sunny1043/offgrid-pv-course-design/差异化城市设计/README.md

# 差异化城市设计（拉萨 / 兰州 / 哈尔滨）

> 本文件夹为户用离网光伏发电系统课程设计**新增的差异化城市方案**，与仓库 docs/ 下已有的深圳（基线）方案对应。
> 全部数据同一口径：NASA POWER 2019-2023 五年平均 + Liu-Jordan 倾角模型 + 指导书/任务书公式。
> 负荷设计点：冬季采暖 E_AC = 7.82 kWh/d（对应任务书区间 7.5~8.0，学号末位 4/5；可按分配区间微调）。

## 四城市关键对比

| 环节 | 深圳（基线） | 拉萨 | 兰州 | 哈尔滨 |
|---|---|---|---|---|
| 纬度 / 最不利月 | 22.54° / 10月 | 29.66° / 12月 | 36.05° / 12月 | 45.80° / 12月 |
| 最不利月水平辐照 | 4.29 | 4.23 | 2.82 | 1.68 |
| 年水平面 kWh/m2 | 约1585 | 约1988 | 约1659 | 约1400 |
| 极端最低温 ℃ | 0.2 | -16.5 | -23.1 | -38.1 |
| 倾角 / 排距(倍L) | 20° / 1.62 | 30° / 2.13 | 30° / 2.51 | 40° / 4.57 |
| 蓄电池 | 19.34kWh/4台 | 21.64kWh/5台 | 21.64kWh/5台 | 21.64kWh/5台 |
| 阵列 | 2.40 kWp | 3.00 kWp | 3.60 kWp | 6.00 kWp（双机并联） |
| 逆变器 | SPF 5000 ES | SPF 5000 ES | SPF 5000 ES | 2x SPF 5000 ES |
| 差异化主线 | 夏季空调 | 高海拔/资源顶级 | 8 度抗震 | 严寒/冬季辐照塌陷 |

## 文件清单

- 负荷调查 / 太阳能资源 / 倾角核算 / 系统组成与能量损失 / 蓄电池设计 / 光伏阵列设计 / 控制器逆变器设计
- 计算-蓄电池-{城市}.xlsx、计算-光伏阵列-{城市}.xlsx（公式可检查，用 Excel/LibreOffice 打开自动重算）
- 拉萨设计总览.md、多城市对比总览.md

### D1–D5 阶段成果（检查点①–④交付）

- 拉萨：`拉萨-D1至D5成果汇总.md`
- 兰州：`兰州-D1-D5-阶段成果-源稿.md`（可编辑源稿）+ `兰州-D1-D5-阶段成果.docx` + `.pdf`（正式报告版式）；配套数据表 Excel：`兰州-负荷表.xlsx`、`兰州-24h运行表.xlsx`、`兰州-资源数据.xlsx`

## 说明

- 各城市文档均标注数据来源与查询日期（2026-09-01），口径与仓库 docs/ 深圳方案一致。
- 本文件夹原为独立新增内容；2026-09-04 起兰州/拉萨 D1–D5 成果与 Excel 已纳入 docs/PROJECT_LOG.md 与 docs/PROGRESS.md 协作管理。
