sunny1043/offgrid-pv-course-design/docs/drawings/README.md

# 工程图纸（W9）

> 依据：设计指导书 §10、课程设计任务书 §五；参数来源 W4–W8（蓄电池/光伏阵列/控制器逆变器/线缆保护/支架布置）。
> 说明：本目录为 **A3 图幅（420×297，横向）** 三张图 × 4 城市（深圳 + 差异化 拉萨/兰州/哈尔滨），源文件为 **SVG（可编辑矢量，可用 Inkscape/浏览器打开编辑）**，同时提供 **PDF（A3，可直接打印/提交）** 与 PNG 预览。
> 日期 2026-09-03。**姓名/学号栏留空，提交前请补填。**

## 一、深圳（模板，完整版）

| 图号 | 图名 | 内容要点 | 源文件 | PDF | PNG |
|---|---|---|---|-----|-----|
| **T1-01** | 系统电气主接线图 | 光伏组件 4 串×1 并（隆基 LR7-72HGD-600M）、组串熔断器 F1 25A gPV、直流隔离 QS1、直流 SPD、**Growatt SPF 5000 ES** 一体机、蓄电池 4×BNP-5120BM（B1-B4+BMS+支路熔断器 F2-F5 100A）、总保护 QF1 160A DC MCB、交流 QF2 32A C 型 + RCD 30mA + SPD2、交流配电箱 DB 与 4 个负荷回路（照明 10A/厨房 20A/空调 20A/插座 16A）；各回路标注电压、电流、线缆型号截面；PE 接地/等电位；图例 | [T1-01 SVG](T1-01-系统电气主接线图.svg) | [PDF](T1-01-系统电气主接线图.pdf) | [PNG](T1-01-系统电气主接线图.png) |
| **T1-02** | 光伏阵列及支架布置图 | 屋面平面（12×5m 南向区）：单排 4 块横排（东西 9.53m、南北投影 1.07m）、指北针、边缘距离（檐口≥1.0/侧边≥0.5/北侧≥0.6m）、南侧维护通道≥1.0m、直流线缆路径（穿屋面→设备间）；剖面 A-A：倾角 20°、前沿 0.5m/后沿 0.89m、立柱锚固；排间节距 D=1.84m（扩排）；支架校核结论（σ=24.3MPa、f=0.88mm） | [T1-02 SVG](T1-02-光伏阵列及支架布置图.svg) | [PDF](T1-02-光伏阵列及支架布置图.pdf) | [PNG](T1-02-光伏阵列及支架布置图.png) |
| **T1-03** | 设备间平面及安装接线图 | 房间 3.0×2.5m：蓄电池柜（B1-B4）、逆变器 INV1（壁挂 1.4-1.6m）、配电箱 DB、直流/交流桥架分区、电池→逆变器 ≤2m 短回路、检修通道≥0.8m、接地干线、灭火器与警示；安装接线说明（设备编号与 T1-01 一致） | [T1-03 SVG](T1-03-设备间平面及安装接线图.svg) | [PDF](T1-03-设备间平面及安装接线图.pdf) | [PNG](T1-03-设备间平面及安装接线图.png) |

## 二、差异化城市（拉萨 / 兰州 / 哈尔滨）

三城均按深圳模板同构：T1-01 主接线（差异化：组件串并联、Voc 低温校核、直流保护回路成对、采暖负荷回路）、T1-02 阵列布置（差异化：倾角/排距/东西向单排布置）、T1-03 设备间（差异化：房间尺寸/单双逆变器/保温-抗震-防冻措施）。每城三张图均已生成 **SVG + PDF + PNG**。

| 城市 | T1-01 主接线 | T1-02 阵列布置 | T1-03 设备间 |
|---|---|---|---|
| **拉萨**（30°，5 串×1 并） | [SVG](T1-01-系统电气主接线图-拉萨.svg) / [PDF](T1-01-系统电气主接线图-拉萨.pdf) / [PNG](T1-01-系统电气主接线图-拉萨.png) | [SVG](T1-02-光伏阵列及支架布置图-拉萨.svg) / [PDF](T1-02-光伏阵列及支架布置图-拉萨.pdf) / [PNG](T1-02-光伏阵列及支架布置图-拉萨.png) | [SVG](T1-03-设备间平面及安装接线图-拉萨.svg) / [PDF](T1-03-设备间平面及安装接线图-拉萨.pdf) / [PNG](T1-03-设备间平面及安装接线图-拉萨.png) |
| **兰州**（30°，6 串×1 并，8 度抗震） | [SVG](T1-01-系统电气主接线图-兰州.svg) / [PDF](T1-01-系统电气主接线图-兰州.pdf) / [PNG](T1-01-系统电气主接线图-兰州.png) | [SVG](T1-02-光伏阵列及支架布置图-兰州.svg) / [PDF](T1-02-光伏阵列及支架布置图-兰州.pdf) / [PNG](T1-02-光伏阵列及支架布置图-兰州.png) | [SVG](T1-03-设备间平面及安装接线图-兰州.svg) / [PDF](T1-03-设备间平面及安装接线图-兰州.pdf) / [PNG](T1-03-设备间平面及安装接线图-兰州.png) |
| **哈尔滨**（40°，5 串×2 并/双机，防冻） | [SVG](T1-01-系统电气主接线图-哈尔滨.svg) / [PDF](T1-01-系统电气主接线图-哈尔滨.pdf) / [PNG](T1-01-系统电气主接线图-哈尔滨.png) | [SVG](T1-02-光伏阵列及支架布置图-哈尔滨.svg) / [PDF](T1-02-光伏阵列及支架布置图-哈尔滨.pdf) / [PNG](T1-02-光伏阵列及支架布置图-哈尔滨.png) | [SVG](T1-03-设备间平面及安装接线图-哈尔滨.svg) / [PDF](T1-03-设备间平面及安装接线图-哈尔滨.pdf) / [PNG](T1-03-设备间平面及安装接线图-哈尔滨.png) |

### 三城关键差异参数（与深圳对照）

| 参数 | 深圳 | 拉萨 | 兰州 | 哈尔滨 |
|---|---|---|---|---|
| 倾角 | 20° | 30° | 30° | 40° |
| 组件布置 | 4 块横排 | 5 块竖排（5 串×1 并） | 6 块竖排（6 串×1 并） | 10 块竖排（5 串×2 并，拆两组） |
| Voc,cold | — | 286.1V | 348.0V | 299.0V（每路） |
| 逆变器 | SPF 5000 ES ×1 | SPF 5000 ES ×1 | SPF 5000 ES ×1 | SPF 5000 ES ×2 并联 |
| 蓄电池 | 4×BNP-5120BM | 5×BNP-5120BM | 5×BNP-5120BM | 5×BNP-5120BM |
| 电池→逆变器 | 70mm² / QF1 160A | 70mm² / QF1 160A | 70mm² / QF1 160A | 70mm² / QF1a、QF1b 2×160A |
| 直流保护 | F2-F5 4×100A | F2-F6 5×100A | F2-F6 5×100A | F2-F6 5×100A + 成对回路 |
| 采暖/空调回路 | 空调 20A BV4mm² | 采暖插座 10A BV2.5mm² | 采暖插座 10A BV2.5mm² | 采暖插座 10A BV2.5mm² |
| 设备间 | 3.0×2.5m | 3.0×2.5m（保温≥10℃） | 3.0×2.5m（8 度抗震） | 3.5×2.5m（保温+加热） |
| 排距 D | 1.84m | 5.09m | 5.98m | 10.88m（东西向单排规避） |
| 支架 σ / f | 24.3MPa / 0.88mm | 5.6MPa / 0.21mm | 9.9MPa / 0.36mm | 19.2MPa / 0.61mm |

## 三、图纸与 W4–W8 数据一致性（任务书红线：报告/图纸/设备清单一致）

**深圳：**
- 光伏组件：隆基 LR7-72HGD-600M ×4（4 串×1 并，2.40 kWp）——W5；
- 蓄电池：Benhoo BNP-5120BM ×4（51.2V/100Ah/5.12kWh）——W4；
- 控制器/逆变器：Growatt SPF 5000 ES（5kW/10kVA/η93%，MPPT 120~430V）——W6；
- 线缆/保护：PV1-F 4mm²（光伏）、RV 10/70mm²（电池侧）、RVV 3×6mm²（交流）、F1 25A gPV、F2-F5 100A、QF1 160A DC MCB、QF2 32A、RCD 30mA、SPD 两级——W7；
- 支架/布置：倾角 20°、单排 4 块、排距 1.84m、设备间 3.0×2.5m——W8。

**拉萨（W7/W8 参数）**：PV1-F 4mm²、组串 F1 25A gPV、电池→逆变器 RV 70mm² + QF1 160A DC MCB、支路熔断器 F2-F6 5×100A gPV、直流 SPD U_cpv≥345V；交流 6mm²+32A、采暖插座 10A/2.5mm²；倾角 30°、竖排 5 块、排距 D=5.09m、设备间 3.0×2.5m（保温≥10℃）。

**兰州（W7/W8 参数）**：PV1-F 4mm²、组串 F1 25A gPV、电池→逆变器 RV 70mm² + QF1 160A DC MCB、支路熔断器 F2-F6 5×100A gPV、直流 SPD U_cpv≥420V；交流 6mm²+32A、采暖插座 10A/2.5mm²；倾角 30°、竖排 6 块、排距 D=5.98m、设备间 3.0×2.5m（8 度抗震锚固）。

**哈尔滨（W7/W8 参数）**：PV1-F 4mm²、组串 F1a/F1b 25A gPV ×2、电池→逆变器 RV 70mm² + QF1a/QF1b 2×160A、支路熔断器 F2-F6 5×100A gPV、直流 SPD U_cpv≥360V ×2；交流 6mm²+32A ×2、采暖插座 10A/2.5mm²；倾角 40°、竖排 5 串×2 并（东西向单排两段）、排距 D=10.88m、设备间 3.5×2.5m（保温+加热≥10℃、双逆变器）。

## 修订说明

| 版本 | 日期 | 内容 |
|---|---|---|
| A | 2026-09-03 | 深圳初版（含修复：标题栏图名/图号/比例、交流线缆标注位置） |
| B | 2026-09-03 | 新增拉萨/兰州/哈尔滨三城图纸（SVG+PDF+PNG）；参数按 W7/W8 差异化（倾角/串并联/直流保护/采暖回路/设备间/排距/支架校核）；修复拉萨-兰州 PV 线缆与保护标签重叠 |
| C | 2026-09-03 | 三城图纸按 IEC 60617/GB 规范重画（符号造型/交直流-地线线型/竖向尺寸标注/图框标题栏），修复渲染管线：PDF 改为 A3 横版（1191×842）、PNG 全幅无空白（3176×2246）、页眉城市差异化与支架说明按城市修正；9 张经 pymupdf 检测 0 文字重叠/0 越界 |
