sunny1043/offgrid-pv-course-design/差异化城市设计/完整设计案例-拉萨.md

# 户用离网光伏发电系统设计 — 拉萨完整设计案例

**哈尔滨工业大学（深圳）· 本科课程设计参考案例**
**任务 1：户用离网光伏发电系统设计（拉萨版）**
**拉萨地区 · 3.00 kWp 光伏 · 25.60 kWh 储能 · 冬季电采暖差异化**
含设计选择、失败初选、回算、实验及独立完成要求

2026 年 9 月课程设计版｜数据与参数来源见第 12 章后参考文献

---

## 第 1 章 设计任务与使用方法

本案例示范如何从拉萨家庭用电需求形成一套参数一致、能够说明选型理由的离网光伏供电方案。阅读时应首先看清设计条件，再跟随计算，最后对照三张图纸。

**参考对象**：拉萨市一户家庭的关键负荷供电系统。地点坐标 29.66°N、91.14°E，海拔约 3650 m；光伏板朝正南，倾角 30°。采用 MPPT+离网逆变一体机（Growatt SPF 5000 ES）、48 V 级磷酸铁锂蓄电池母线，不接公共电网。本案例的家庭、屋顶和使用时间是明确给定的教学场景；气象数据（NASA POWER 2019–2023 五年平均）与核心设备型号来自可追溯资料。

**拉萨差异化主线**：深圳/参考案例为"夏季空调驱动"，拉萨为**冬季电采暖驱动**——负荷季节性完全相反；并新增**高海拔（3650 m）功率降额**与**低温（-16.5 ℃）充电策略**两项深圳没有的校核。

**边界先于计算**：日常保障对象包括冰箱、通信、照明、冬季电采暖（电热毯+电暖器）、炊事和必要插座负荷。电热水器以外的集中热水、汽车充电和大功率烘干不在服务范围。厨房炊事与采暖高峰通过操作管理错峰。设置**两天无有效光伏发电的自治工况**（约定供电能力，非气象保证）。屋顶给定南向安装区 6 m×5 m，设备间给定 3.0 m×2.5 m（须保温 ≥10 ℃）。电池设计温度区间为设备间保温后的 10 ℃ 以上；低温容量系数敏感性（K_T=0.70）与保温方案一并论证。以上条件均写入报告，不藏在公式系数里。

## 第 2 章 负荷确定与功率边界

**从用电行为计算日耗电量**：本例以冬季采暖季代表日为基准。电器输入功率、占空比和使用时间为教学给定值，不伪称现场测量；学生应通过铭牌、能效标签或有出处的产品资料替换依据。连续运行设备按功率×时间；周期运行设备还需给出运行比例。

**表 2-1 冬季代表日交流负荷（拉萨）**

| 负荷 | 输入功率/W | 时间/h | 运行系数 | 能量/kWh | 使用说明 |
|---|---|---|---|---|---|
| 冰箱 | 120 | 24 | 0.25(平均占空) | 0.54 | 海尔 BCD-235WFCI 能效标识 0.54 kWh/24h，直接计入 |
| 路由器 | 6 | 24 | 1.0 | 0.14 | 全天 |
| 照明 | 96 | 4 | 1.0 | 0.38 | 飞利浦 LED 12 W×8 |
| 笔记本 | 65 | 5 | 1.0 | 0.33 | 19—24 时 |
| 手机充电 | 20 | 3 | 1.0 | 0.06 | 2 台合计 20 W |
| **电热毯（采暖新增）** | **150** | **8** | **1.0** | **1.20** | 22 时—次日 6 时 |
| **电暖器（采暖新增）** | **1200** | **5** | **0.5** | **3.00** | 18—23 时，间歇运行 |
| 电饭煲 | 860 | 0.6 | 1.0 | 0.52 | 7 时/18 时 |
| 电热水壶 | 1800 | 0.15 | 1.0 | 0.27 | 19:00—19:15 |
| 油烟机 | 258 | 0.5 | 1.0 | 0.13 | 12—13 时 |
| 微波炉 | 1150 | 0.1 | 1.0 | 0.12 | 12 时短时 |
| 电磁炉 | 2100 | 0.06 | 1.0 | 0.12 | 周末午餐（日均） |
| 洗衣机 | 500 | 0.75 | 1.0 | 0.38 | 15 时 |
| 电视机 | 110 | 4 | 1.0 | 0.44 | 19—23 时 |
| 待机负荷 | 8 | 24 | 1.0 | 0.19 | 电视/微波炉/电磁炉/洗衣机/电暖器待机 |
| **合计（冬季）** | | | | **7.82** | 基础 3.62 + 采暖 4.20 |

E_AC = Σ nᵢ·Pᵢ·tᵢ·fᵢ/1000 = **7.82 kWh/d**（冬季采暖设计点，任务书区间 7.5~8.0 ✅）。非采暖月：过渡月（4、10 月）4.82；夏季（6–8 月，轻空调 845 W×4 h×0.4=1.35）4.97；温和月（5、9 月）3.62 kWh/d。

**用分时表检查能量，不用平均功率选逆变器**：24 h 小时平均功率表（冬季工作日）中，深夜电热毯+基础 0.32 kW、清晨早餐 1.16 kW、白天基础 0.15 kW、18 时起电采暖段 2.81 kW、19:00–19:15 峰值 4.61 kW、晚高峰 2.02 kW、22:30 后回落 0.38 kW。各小时乘以 1 h 累加 = 7.82 kWh，与表 2-1 一致（24 h 表见《负荷调查-拉萨》§3）。

**最大同时功率与启动冲击分开计算**：功率校核采用"允许使用范围内的保守同时开启组合"。冬季 19:00–19:15 组合（电暖器 1200 + 电热毯 150 + 水壶 1800 + 电饭煲 860 + 油烟机 258 + 照明 100 + 电视 110 + 冰箱 120 + 路由 10）≈ **P_max = 4.6 kW**。冰箱启动输入暂按 600 W、持续 2 s 教学条件校核，冲击组合用启动值替换运行值（不重复叠加）：

P_short = P_max − 120 + 600 ≈ **5.2 kW**

**视在功率检查**：冬季组合功率因数取：阻性（电暖器/电热毯/水壶/电饭煲）1.0，油烟机 0.8，LED 照明 0.9，电视/路由 0.95，冰箱 0.9。逐项 S=P/PF 保守相加 ≈ **4.7 kVA**，低于所选 SPF 5000 ES 的 5 kVA 连续/10 kVA 浪涌等级 ✅。

**结论**：平均每天用电 7.82 kWh/d 不能直接说明要多大逆变器；4.6 kW 决定持续输出需求、5.2 kW 及其持续时间决定启动工况；三者不能相互替代。

## 第 3 章 太阳能资源与设计工况

**数据来源**：逐月水平面辐照量与月均温取自 NASA POWER（MERRA2/SYN1DEG）2019–2023 五年平均（29.66°N、91.14°E）；极端温度取拉萨市气象台公开资料（历史极端最高约 29.4 ℃、最低约 -16.5 ℃）。倾斜面辐照采用 Liu-Jordan 各向同性模型换算（直射+散射+地面反射，rho=0.2），与深圳示例同一实现、已校验。数据是再分析网格资源，不是屋顶实测。

**表 3-1 月度资源与供电需求（拉萨，未舍入计算）**

| 月份 | 水平面 kWh/m²·d | 倾斜面30° H_T/h/d | 交流需求 kWh/d | 最低光伏/kWp |
|---|---|---|---|---|
| 1 | 4.42 | 4.90 | 7.82 | 2.24 |
| 2 | 4.87 | 5.31 | 7.82 | 2.07 |
| 3 | 5.74 | 6.20 | 7.82 | 1.77 |
| 4 | 6.04 | 6.39 | 4.82 | 1.06 |
| 5 | 6.44 | 6.84 | 3.62 | 0.74 |
| 6 | 6.74 | 7.21 | 4.97 | 0.97 |
| 7 | 5.64 | 5.93 | 4.97 | 1.18 |
| 8 | 5.64 | 5.92 | 4.97 | 1.18 |
| 9 | 5.50 | 5.81 | 3.62 | 0.88 |
| 10 | 5.31 | 5.80 | 4.82 | 1.17 |
| 11 | 4.78 | 5.34 | 7.82 | 2.06 |
| 12 | 4.23 | 4.74 | 7.82 | **2.32** |

（最低光伏 = E_AC×K_PV/(H_T×η_path)，K_PV=1.10、η_path≈0.782；12 月 7.82×1.10/(4.74×0.782)=**2.32 kWp** 为全年最大，控制月与第 6 章 P_PV,min 一致。）

**最不利设计月判定**：12 月采暖负荷最高（7.82）且辐照全年最低（4.23），需求辐照比 R=7.82/4.23=**1.85**（水平面口径，全年最大）；倾斜面口径 R=7.82/4.74=1.65 复核稳健。**最不利设计月 = 12 月**——是"负荷驱动的冬季最不利"，不是辐照塌陷；若忽略采暖只看辐照会误选 5–6 月（与参考案例的误区正好相反）。拉萨年水平面总辐射约 **1988 kWh/m²·yr**（全国顶级）。

**温度条件**：光伏低温开路电压按组件温度 -16.5 ℃（极端最低）计算，炎热工况按组件温度 60.7 ℃（NOCT 估算，G=1000 W/m²、NOCT=45 ℃）计算。蓄电池置于保温设备间（≥10 ℃），低温容量敏感性 K_T=0.70（不保温约 0 ℃）作对照论证；控制器及逆变器需按高海拔（3650 m）降额校核。

## 第 4 章 系统结构与能量计算口径

**系统组成**：光伏方阵 → 直流保护 → MPPT 控制器（逆变一体机内置）→ 蓄电池及 BMS → 离网逆变器 → 交流配电 → 负荷，蓄电池与控制器之间双向充放电。三个电气位置必须分清：光伏输入侧（组串电压、A 级电流）、48 V 级电池侧（45~58 V、数百 A）、220 V 交流侧；**同一功率在不同电压下电流不同，不能用一侧电流直接选型另一侧设备**。

**损失逐项说明，不重复扣除**（拉萨 W3 效率表，W6 回填）：

| 环节 | 符号 | 取值 | 依据 |
|---|---|---|---|
| 光伏直流线缆 | η_cable_dc | 0.98 | 短距铜缆（W7 校核） |
| MPPT 控制器 | η_ctrl | 0.96 | 典型值 0.95~0.97 |
| 蓄电池充/放电 | η_batt_ch/dis | 0.95 | 磷酸铁锂典型（GB/T 36276） |
| 离网逆变器 | η_inv | **0.93** | Growatt SPF 5000 ES 官方峰值效率 |
| 交流线缆 | η_cable_ac | 0.99 | 短距铜缆 |
| **综合路径效率** | **η_path** | **≈0.782** | 0.98×0.96×0.95×0.95×0.93×0.99 |

**口径声明**：E_AC=7.82 kWh/d 为交流侧日用电量，蓄电池公式内部已含 η_inv、**不重复除以**；光伏容量公式使用 η_path；各环节损失只计一次。本设计按指导书 §2.2 口径直接使用 E_AC（辅助自耗已体现在负荷表"待机负荷"项），全文统一。

## 第 5 章 蓄电池设计与经济取舍

**为什么采用 48 V 级、为什么不随意串联**：户用离网连续功率达数千瓦（拉萨冬季 P_max=4.6 kW），48 V 级把 I_dis 控制在约 119.5 A，降低线缆与保护成本，并匹配主流离网逆变器与机架式磷酸铁锂模块。Benhoo BNP-5120BM 为 51.2 V/100 Ah/5.12 kWh 成品模块（内部 16 个 3.2 V 单体串联并配 BMS）；**系统层面 N_S=1**——完整模块未经厂家明确允许不得继续串联（任务书红线），只能并联。

**从保障要求求最少模块数**（指导书 §5.2）：

E_bat,min = E_AC·N_A·K_R/(DOD·η_dis·η_inv·K_T) = 7.82×2×1.10/(0.90×0.95×0.93×1.00) = **21.64 kWh**（≈422.6 Ah @51.2 V）

取值：N_A=2 d、K_R=1.10（需求裕量，含容量衰减余量）、DOD=0.90（智能 BMS 允许深度循环，模块放电下限 44.8 V）、η_dis=0.95、η_inv=0.93、K_T=1.00（保温设备间 ≥10 ℃，低温容量损失可忽略）。

N_P,E = ceil(21.64/5.12) = **5 台**，实际 5×5.12=**25.60 kWh**（下限的 1.18 倍，≤1.25 上限 ✅）。

**表 5-1 同一保障条件下的模块数量比较（拉萨）**

| 台数 | 额定能量/kWh | 与下限 21.64 之比 | 电池预算/元 | 结论 |
|---|---|---|---|---|
| 4 | 20.48 | 0.95 | 16,000 | **不满足**（<21.64） |
| **5** | **25.60** | **1.18** | **20,000** | **选用** |
| 6 | 30.72 | 1.42 | 24,000 | 可行，成本更高 |

**失败初选记录（方案 B，200 Ah）**：曾考虑 51.2 V/200 Ah/10.24 kWh 模块方案：2 台并联 20.48 kWh < 21.64 不足；3 台并联 30.72 kWh = 1.42×21.64 **超 1.25 倍上限**——出现"2 台不够、3 台超上限"的夹逼困境，**方案 B 在拉萨失效**（深圳下限 19.34 kWh 时方案 B 可行，城市负荷差异直接改变组合选择）。故最终仅方案 A（100 Ah×5）可行。

**连续、推荐与峰值电流**：厂家 BNP-5120BM 标准/最大充电 20/50 A、标准/最大放电 50/100 A。项目内保守校核上限取每台 100 A（放电）/50 A（充电）。

**设备连续满载校核**（逆变器 5000 W 基准、最低母线电压 45 V、η_inv=0.93）：

I_DC,cont = 5000/(45×0.93) = **119.5 A**；短时（P_short=5.2 kW）I_DC,start = 5200/(45×0.93) = **124.3 A**。5 台合计放电能力 500 A，裕量 4.2×；支路等长、等截面、星形接母排。

**充电校核必须回到电池侧**：I_chg = min(P_PV·η_MPPT/V_bat, I_ctrl,out,max) = min(3000×0.96/54.4, 100) = **52.9 A** ≤ 5×50 A=250 A ✅。光伏串电流 13.6 A ≠ 电池充电电流（MPPT 改变电压电流，不凭空增加功率；红线）。控制器输出限流 100 A 且须服从 BMS 允许充电电流（CCL）。

**温度与保温敏感性**：若设备间不保温（约 0 ℃，LFP 可用容量约 70%，K_T=0.70）：E_bat,min=30.91 kWh（+43%），需 7 台——**设备间保温（≥10 ℃）是拉萨方案经济性关键**；保守口径 DOD=0.80 → 24.34 kWh，仍 5 台。

## 第 6 章 光伏阵列、MPPT 与逆变器选型

**先求每日能量**（最不利月 12 月，K_PV=1.10、H_T=4.74 h/d、η_path≈0.782）：

P_PV,min = E_AC·K_PV/(H_T·η_path) = 7.82×1.10/(4.74×0.782) = **2.32 kWp**

**组件参数（同一版本）**：隆基 Hi-MO 7 LR7-72HGD-600M（N 型 TOPCon，600 W）：Voc=52.22 V、Vmp=44.12 V、Isc=14.49 A、Impp=13.60 A、开路电压温度系数 -0.23 %/℃、最大功率点电压温度系数 -0.28 %/℃。

**串并联为什么选 5 串 1 并**：
- 低温开路电压（-16.5 ℃）：单块 Voc,cold = 52.22×[1+(-0.0023)(-16.5-25)] = **57.21 V**；6 串为 343.3 V **超过控制器 450 V 绝对上限**——这是一项明确不通过的初选（N_S,max=⌊450/57.21⌋=**7**）；
- 高温工作电压（60.7 ℃）：Vmp,hot = 44.12×[1+(-0.0028)(60.7-25)] = **39.71 V**；N_S,min=⌈120/39.71⌉=**4**；
- **失败初选记录**：4 串（2.40 kWp）低温 Voc=228.8 V 满足电压，但 12 月供能比仅 1.14，低于基准 1.20，且拉萨高原粉尘、偶发积雪/结霜与 BMS 低温充电损耗需要额外余量——故最终选 **5 串×1 并 = 3.00 kWp**（12 月供能比 1.42）。

**校核**：组串低温 Voc=5×57.21=**286.1 V** ≤ 450 V（裕量 164 V）✅；组串高温 Vmp=5×39.71=**198.5 V** ≥ 120 V ✅；组串低温 Vmp=246.2 V ≤ 430 V ✅；Isc=14.49 A、Imp=13.6 A ≤ 22 A ✅；3.00 kW ≤ 6 kW ✅。

**MPPT 与逆变器（一体机，不是按同一个功率选型）**：选用 Growatt SPF 5000 ES（离网一体机，含 MPPT 充电控制器+逆变器）。逆变器侧：连续 5 kW ≥ P_max=4.6 kW（利用率 92%）、浪涌 10 kVA ≥ P_short=5.2 kW、交流单相 220 V/50 Hz；MPPT 侧：输入 120~430 V（≤450 V）、≤22 A/路、≤6 kW。**I_ac=5000/220≈22.7 A**（P_max=4.6 kW 时约 20.9 A）。

**拉萨特有校核（深圳没有）**：
- **高海拔（3650 m）功率降额**：电子设备额定通常按海拔 ≤2000 m 标定，按每 1000 m 降额 8~10% 初估，5 kW 降额后约 4.1~4.4 kW，**接近 P_max=4.6 kW**——需向厂家确认高原额定，若不足则上调 SPF 6000 ES（答辩重点，报告如实标注"待确认"，不伪称通过）；
- **低温充电**：磷酸铁锂 0 ℃ 以下充电受 BMS 低温保护限制，设备间保温 ≥10 ℃ 保证冬季"白天充电—夜间放电"循环（设计决策）；
- **夏季弃光**：5–9 月供能比 2.8~4.4，电池充满后由控制器限流/限功率弃光（运行说明写入）。

**BMS 通信与基本设置**：BNP-5120BM 内置 BMS（RS485/CAN），与逆变器锂电通信协议匹配待厂家确认；低压切断设置 ≥44.8 V；严禁铅酸均衡/57.6 V 默认吸收电压（锂电按 52~55 V 充电区间）。

## 第 7 章 电缆、保护与接地

**先明确回路，再算电流与长度**（拉萨 W7，C1~C6）：

| 回路 | 设计电压/电流 | 长度 | 线缆截面 | 保护 | ΔU/δU |
|---|---|---|---|---|---|
| C1 组件串线 | ≤286.1 V DC / 14.49 A | 1 m | PV1-F 4 mm² | F1 25 A gPV | 0.13 V / 0.07% |
| C2 组串→MPPT | ≤286.1 V DC / 13.6 A | 15 m | PV1-F 4 mm² | 25 A + 隔离 + SPD | 1.79 V / 0.90% |
| C3 MPPT→电池 | 48 V 级 / **52.9 A** | 3 m | **RV 16 mm²** | 63 A MCB | 0.35 V / 0.72% |
| C4 电池→逆变器 | **45 V 级 / 119.5 A** | 2 m | **RV 70 mm²** | QF1 160 A DC MCB | 0.12 V / **0.27%@45 V** |
| C5 逆变器→配电箱 | 220 V / 20.9 A | 5 m | RVV 6 mm² | QF2 32 A C 型 | 0.61 V / 0.28% |
| C6a 照明 | 220 V / 1.7 A | 20 m | BV 2.5 mm² | 10 A MCB | 0.48 V / 0.22% |
| C6b 厨房 | 220 V / 13.6 A | 15 m | BV 4 mm² | 20 A MCB | 1.79 V / 0.81% |
| **C6c 采暖（拉萨新增）** | 220 V / **6.1 A** | 20 m | BV 2.5 mm² | 10 A MCB | 1.71 V / 0.78% |
| C6d 其他插座 | 220 V / 3.8 A | 20 m | BV 2.5 mm² | 16 A MCB | 1.07 V / 0.48% |

ΔU=2ρLI/S，ρ=0.0175 Ω·mm²/m（20 ℃），L 为单程长度；全部回路满足 I_b≤I_n≤I_z（载流量按 GB 50217 附录、40 ℃ 修正 0.87）且压降 ≤2%（直流主回路）/≤3%（交流末端）。**C4 相对压降以最低电池电压 45 V 计算（红线），不得除以 220 V**（若误除得 0.06% 会掩盖真实压降）。C3 因 I_chg=52.9 A 高于深圳（42.4 A）升为 16 mm²/63 A；C6c 采暖插座为拉萨新增回路（电暖器+电热毯 6.1 A），与厨房分开错峰。

**保护器件要保护哪一段线**：光伏每串 25 A gPV 直流熔断器（≥1.4×Isc=20.3 A、<组件最大串联熔断器 30 A）；直流隔离 2P 600 Vdc；直流 SPD Type II 1000 Vdc（U_cpv≥345 V，GB/T 32512）；每台电池正极端附近 100 A gPV 支路熔断器 + 总保护 160 A DC MCB（2P，≥125 Vdc，含检修隔离）；控制器输出回路 63 A；交流 32 A C 型 + 30 mA RCD（插座回路）+ 交流 SPD Type II；末端 10/20/10/16 A。直流电池回路保护额定电压不低于实际最高电压，分断能力按厂商样本核对。

**防雷与接地**：拉萨为**少雷区**（年雷暴日约 10 余天），仍按规范配置直流/交流两级 SPD 与等电位联结。组件边框、支架、设备外壳接保护接地（PE）；设备间内等电位联结端子连通电池柜、逆变器、配电箱、SPD 接地端与 PE 干线（≥6 mm²）；系统接地电阻 ≤4 Ω（高原冻土浅、土壤电阻率高，实际需人工接地极并复核）。接地电阻数值是初选指标，不替代现场检测（合格人员测试故障回路阻抗、RCD 动作时间等）。

## 第 8 章 方阵、支架与室内布置

**组件数量必须在屋顶上放得下**（拉萨 W8）：屋面南向安装区 6 m（东西）×5 m（南北），采用**单排 5 块竖排**（5 串×1 并）。组件 1134×2382 mm，东西 5×1.134=**5.67 m**、南北投影 2.382cos30°=**2.06 m**，总占地约 6.7×3.2 m（含通道）落在安装区内 ✅。前沿高 0.5 m、后沿高 1.69 m；距南檐口 ≥1.0 m、东西侧边 ≥0.5 m、北侧 ≥0.6 m。图纸给出方向、尺寸和组串编号。

**排间节距**（扩排依据，单排本方案无前后遮挡）：D = Lcosβ + Lsinβ/tanα_s = 2.382×cos30°+2.382×sin30°/tan21.5° = **5.09 m（≈2.13×L）**，冬至 9:00 太阳高度角 α_s=21.5° 校核；大于深圳（1.62×L）因倾角更大、纬度更高。

**支架简化校核**（GB 50009，拉萨基本风压 w0=0.15 kN/m² 为四城最低）：风压标准值 w_k=1.6×1.3×1.0×0.15=**0.31 kN/m²**；组件自重 32 kg/块、5 块共 1.57 kN。铝导轨 6063-T5（W=10.4 cm³、I=44.9 cm⁴、E=70 GPa）简支跨度 L_b=1.2 m：组合线荷载 q=1.2g+1.4q_w=0.33 kN/m，M_max=qL²/8=0.059 kN·m，**σ=5.6 MPa ≤ 85 MPa**、**f=0.21 mm ≤ L/200=6 mm** ✅（拉萨风压小，应力远小于深圳 24.3 MPa）。简化简支梁为初核，实际工程需复核屋面承载、锚固、防水与抗倾覆。

**设备布局决定散热、维护和线长**（拉萨差异化：保温）：设备间 3.0×2.5 m，**墙体/门加保温层维持 ≥10 ℃**（低温充电与经济性关键，W4 §8）。电池柜（19" 机柜 600×600×1200，装 5 台 BNP-5120BM 机架式模块）靠北墙，柜后/侧 ≥0.6 m 检修；逆变器 INV1 壁挂于西墙 1.4~1.6 m；配电箱 DB 东墙；电池柜→逆变器 **≤2 m 短回路**（C4：RV 70 mm²、160 A）。交/直流桥架分区（直流居左、交流居右）；检修通道 ≥0.8 m；机械排风扇（≥2 次/h）+ 保温风阀；接地干线（-40×4 扁钢/≥25 mm² 铜）沿墙敷设；4 kg ABC 灭火器、"高压/锂电"警示；电池柜垫高 ≥100 mm、设备间地漏防水。

## 第 9 章 系统验证与条件变化

**验证层次**：第一层代数检查（单位、能量合计、串并联数量、端口电压电流相容）全部完成；第二层工况检查（高低温、自治、敏感性）完成；第三层设备/实验检查（BMS 联调、保护动作）如实标注"待 W10 实验/厂家确认"，不伪称通过。

**逐月供能复核（能量平衡）**：按 P_PV·H_T·η_path/E_AC 逐月计算供能比，12 个月全部 ≥1，最不利月 12 月供能比 = 3.00×4.74×0.782/7.82 = **1.42**；夏季 5–9 月 2.8~4.4（大富余、弃光）。月平均能量满足只说明平均供需，不虚构"全年供电可靠率 100%"。

**条件变化回算（答辩重点）**：
1. **3 d 自治**：E_bat,min=32.45 kWh → 需 7 台（+2 台、约 +30% 电池成本），且方案 B 依旧不可行——只改一个容量数不行，还需重画柜体/母排/保护/成本；
2. **保守 DOD=0.80**：24.34 kWh，仍 5 台（25.60，1.05 倍）——边界内；
3. **低温敏感性 K_T=0.70（设备间不保温）**：30.91 kWh（+43%），需 7 台、多约 0.7~1.0 万元——**设备间保温是经济性关键**；
4. **高海拔降额**：若 SPF 5000 ES 高原额定不足 4.6 kW，上调 SPF 6000 ES，需同步更新逆变器校核、图纸与清单；
5. **夏季资源提升 20%**：供能比进一步上升，弃光增加，不影响电池容量下限（由冬季控制）。

**至少解释一次条件改变后的设计**：上述 3 d/K_T/高海拔三类变化均给出受影响结果与设备是否需改的判断；结论有数值支持，不写"加强储能、提高可靠性"空话。

## 第 10 章 物料清单与成本说明

**先保证数量闭合**：组件 5 块、电池 5 台、逆变器 1 台（含 MPPT）；图上（T1-01/02/03）与计算、清单一致（W12 数据一致性复核 15 项全过）。

**表 10-1 设备清单（拉萨，市场参考价 2026-09-03）**

| 类别 | 设备/材料 | 规格 | 数量 | 单价/元 | 金额/元 |
|---|---|---|---|---|---|
| 光伏阵列 | 光伏组件 | 隆基 LR7-72HGD-600M 600 W | 5 | 650 | 3,250 |
| 光伏阵列 | MC4 连接器 | 光伏专用 | 10 | 16 | 160 |
| 支架 | 铝合金支架系统 | APAS P8-2080 6063-T5（5 块竖排 30°） | 1 套 | 1,500 | 1,500 |
| 控制和变换 | 离网逆变器（含 MPPT） | Growatt SPF 5000 ES | 1 | 2,200 | 2,200 |
| 蓄电池 | 磷酸铁锂模块 | Benhoo BNP-5120BM 5.12 kWh | 5 | 4,000 | 20,000 |
| 蓄电池 | 电池柜/母排 | 19" 机柜 + 铜排 | 1+1 | 1,000+350 | 1,350 |
| 直流保护 | F1/QS1/SPD1/支路/总保护/63A | 25A gPV、2P 600Vdc、TypeII、5×100A、160A、63A | — | — | 1,225 |
| 交流配电 | DB/QF2/RCD/SPD2/末端 | 32A、30mA、TypeII、10/20/10/16A | — | — | 800 |
| 线缆和接地 | PV1-F/RV16/RV70/RVV6/BV/接地/桥架 | 按回路长度 | — | — | 1,055 |
| 设备间保温 | 保温层+电伴热 | ≥10 ℃（拉萨新增） | 1 套 | 800 | 800 |
| 安装辅材 | 端子/标识/防水防火 | 汇总 | 1 套 | 400 | 400 |
| **合计** | | | | | **32,740** |

材料预算合计约 **¥32,740**（市场参考价、单一时间基准 2026-09-03；未含屋面加固、建筑防雷改造与不可预见费，实际以采购价为准并注明渠道与日期）。电池模块约 **61%**（20,000/32,740；连同柜体/母排/保温约 68%），是优先审查的成本项——先检查负荷、自治天数、损失口径，再比较电池方案；**不得通过取消保护、扩大 DOD、超电流限值降本**。方案 B（200 Ah）失效故无 B 备选，降本顺序：组件低价期采购 → 保温自装 → 支架自装。

## 第 11 章 实验与设计能力验证

课程实验使用教师确认的低压光伏教学台，不建设 3.00 kWp 屋顶系统，也不让学生组装 25.6 kWh 电池组。实验记录包含日期、人员、设备型号、仪表量程与精度、接线图、测量位置和原始读数；小组可共享原始数据，但每人独立完成数据处理与设计解释。以下算例为教学演算数据，不是本课程已经测到的结果。

**实验一：辨认功率在什么位置测量**：分别记录组件端电压与组件端电流；P_PV=V_PV×I_PV，η_ctrl=P_out/P_PV。**不得用组件电流乘电池电压冒充组件功率**（拉萨 MPPT 侧 198.5~246.2 V/13.6 A vs 电池侧 45~58 V/52.9 A，两侧电流不同正是本实验要验证的）。每个稳定工况至少记录三次，给出平均值、波动及主要误差来源。

**实验二：倾角、朝向和辐照的影响**：选至少三个倾角（如 20°/30°/40°），相近时段测量组件平面辐照、温度、端电压和电流；提交功率—倾角关系并解释辐照几何与温度混杂因素。结论应联系拉萨方案：为什么 30° 是本方案倾角，改变倾角会同时改变辐照、投影尺寸、高差与排间距。**某时刻最优 ≠ 全年最优安装倾角**。

**实验三：温度与开路电压**：在实验台允许范围内观察不同组件温度下的开路电压，同时记录辐照；从至少三个有效温度点估计 β_oc,est，解释为何低温使开路电压升高、为何要在确定串数时检查低温 Voc（拉萨 -16.5 ℃ 是硬约束）。小功率实验台组件的实测温度系数不能直接替换 600 W 型号数据；其作用是验证理解和方法。

**实验通过判据**：同一端口的电压电流配对正确；原始读数不被处理值覆盖；异常数据有解释；结论明确联系一次设计选择。若实验台具备可编程电源或电池模拟器，可加做充电限流与 BMS 通信失效观察；否则明确注明"未实施"。

## 第 12 章 学生完成路径与报告自查

**三周推进**：第一周完成需求、资源、初选（负荷/资源/系统结构/电池初选，第 5 天接受第一关检查）；第二周完成设备匹配（电池充放电、光伏/控制器/逆变器、电压电流通信恢复、电缆保护支架、三张 CAD 初图与 BOM，第 10 天第二关检查）；第三周验证与交付（实验数据分析、条件变化、图文一致性、初稿原始计算文件、修改答辩归档）。

**报告组织**：正文沿用第 1~10 章技术顺序，实验按本人真实记录单列；公式采用 Word 公式对象，变量首次出现解释符号单位，中间计算保留足够精度（报告三位有效数字）；图表编号、标题及正文引用；说明先于结果表。

**提交前逐项回答（自查）**：
- 能否从原始负荷表复算每日能量 7.82 kWh/d，并说明同时功率 4.6 kW 和启动功率 5.2 kW 不是同一张平均能量表算出来的？
- 能否指出电池额定能量 25.60、可用能量、温度系数 K_T 与保温方案各自作用？为什么 N_S=1、N_P=5，厂家是否允许？
- 能否指明 MPPT 的 PV 侧（286.1 V、13.6 A）与电池侧（52.9 A）限值，区分工作电流、短路电流和充电电流？
- 能否证明逆变器持续（4.6 kW≤5 kW）与启动（5.2 kW≤10 kVA）工况满足？高海拔降额是否已说明待确认？
- 能否沿 T1-01 找到每条计算过的回路、沿 T1-02 数出组件（5 块）、沿 T1-03 数出电池（5 台）并量到实际空间？BOM 与三张图纸型号数量线长是否一致（W12 复核 15 项）？
- 是否记录了被否决的初选（方案 B 失效、4 串供能比不足）及修改原因？

**独立设计与答辩要求**：每人至少保留一个与参考案例不同的实际约束（本案例为拉萨冬季电采暖+高海拔+低温保温）、同等服务条件下的可行方案比较、一次条件变化回算与本人实验分析；保留从初选到最终版本的修改记录。答辩可抽问：少一台电池会失去哪项保障（4 台 20.48<21.64 不足）？增加光伏板是否要增加逆变器（否，MPPT 功率与电池充电约束先查）？电池最低电压为什么影响电流（I_dis=P/(V·η)）？高海拔为什么需要降额校核？

## 结论

在已声明的拉萨负荷、资源、温度、保温与恢复条件下，本设计完成 **3.00 kWp 光伏、25.60 kWh 电池（5×BNP-5120BM）、SPF 5000 ES（含 MPPT）** 的离网系统。冬季采暖季交流负荷 **7.82 kWh/d**，最不利设计月 12 月控制平均发电需求（供能比 1.42）；五台电池满足两天自治（1.18×下限），五串一并满足所选控制器的低温电压（286.1 V≤450 V）与设计电流限制；高海拔降额与低温充电为拉萨独有校核，保温设备间（≥10 ℃）是经济性关键。设计价值在于每一步可追溯复算：负荷决定需求、资源决定供给、设备接口限制串并联、电池影响自治与成本、图纸落实连接与空间、实验检验理解。未完成的现场联调、保护动作与建筑结构事项如实保留，不称"系统全部安全可靠"。

## 参考文献与参数来源

[1] 课程设计任务书：户用离网光伏发电系统（任务1）[Z]. 2026.
[2] 设计指导书：户用离网光伏发电系统（§1–§13）[Z]. 2026.
[3] NASA POWER（MERRA2/SYN1DEG）逐月辐照与气象数据[DB/OL]. https://power.larc.nasa.gov（29.66°N、91.14°E，2019–2023，查询日期 2026-09-01）.
[4] 拉萨市气象台. 拉萨市气候概况（极端最高 29.4 ℃、极端最低 -16.5 ℃）[EB/OL]. 查询日期 2026-09-01.
[5] 隆基. Hi-MO 7 LR7-72HGD-600M 产品参数页[EB/OL]. 查询日期 2026-09-01.
[6] Growatt. SPF 5000 ES 离网逆变器官方 Datasheet（2024-09）[EB/OL]. 查询日期 2026-09-01.
[7] 本宁 Benhoo. BNP-5120BM 磷酸铁锂储能模块产品页[EB/OL]. 查询日期 2026-09-01.
[8] GB 50797-2012 光伏发电站设计规范；GB 50217-2018 电力工程电缆设计标准；GB 50009-2012 建筑结构荷载规范；GB 50057-2010 建筑物防雷设计规范；GB/T 32512-2016 光伏发电站防雷技术要求；GB/T 16895.32-2021 低压电气装置；GB/T 36276-2023 电力储能用锂离子电池[S]. 2026.
[9] LIU B Y H, JORDAN R C. The long-term average performance of flat-plate solar-energy collectors[J]. Solar Energy, 1963, 7(2): 53-74.

## 附录 A 主要符号与检查口径

E_AC：交流端日能量（7.82 kWh/d，冬季采暖设计点）；P_max：最大同时持续有功功率（4.6 kW）；P_short：短时有功功率（5.2 kW）；H_T：指定倾斜面峰值日照小时数（4.74 h/d，12 月，30°）；P_PV：组件 STC 额定功率之和（3.00 kWp）；K_PV：组件侧综合能量折减系数（1.10）；η：对应环节效率（η_path≈0.782）；N_A：约定无光伏自治天数（2 d）；DOD：允许放电深度（0.90）；K_T：温度容量系数（1.00/0.70 敏感性）；K_R：需求裕量（1.10）；N_S、N_P：串联/并联数量（光伏 5/1；电池 1/5，模块级）；V_oc、V_mp：开路/最大功率点电压（52.22/44.12 V STC，组串低温 286.1 V）；I_sc、I_mp：短路/最大功率点电流（14.49/13.60 A）；CCL、DCL：BMS 允许充、放电电流；SOC：剩余荷电状态。

## 附录 B 独立完成的最低提交内容

提交个人设计说明书（本案例拉萨版）、三张原生 CAD 图（T1-01/02/03）及对应 PDF、可复算计算文件（计算-蓄电池/光伏阵列/线缆保护/支架/设备清单-拉萨.xlsx）、气象原始数据（NASA POWER）、所选设备参数页、实验原始记录和一页设计修改说明。设计修改说明应写清：最初为什么选这个方案；哪项校核或约束使你修改；修改后哪些数值、图纸和费用发生变化（本案例：方案 B 200 Ah 失效→方案 A 5 台；4 串供能比不足→5 串 3.00 kWp）。课程成果应区分"计算完成""资料匹配""实测验证"与"施工前需专业复核"，不一律写成通过。
