sunny1043/offgrid-pv-course-design/差异化城市设计/太阳能资源-哈尔滨.md

# 太阳能资源与环境参数 — 哈尔滨（W2）

> 依据：设计指导书 §3（太阳能资源和环境参数）、§3.1（单一数据源原则）。
> 状态：已完成（2026-09-03 完善至与深圳/拉萨同级详细度，覆盖 D3 检查点②交付要求）。
> 数据源：NASA POWER（MERRA2/SYN1DEG，API v2.9.8，LST），坐标 45.80°N、126.53°E（哈尔滨市区），2019–2023 共 5 年平均——与深圳/拉萨示例同一数据源、同一口径。查询日期 2026-09-01。

## 1. 数据来源声明（单一数据源原则，指导书 §3.1）

| 数据项 | 来源 | 说明 |
|---|---|---|
| 逐月水平面辐照量、月均温 | NASA POWER（5 年平均） | 45.80°N、126.53°E，2019–2023 |
| 极端气温 | 哈尔滨市气象台公开资料 | 历史极端最高约 39.2 ℃、极端最低约 -38.1 ℃ |
| 年水平面总辐射 | NASA POWER 5 年平均 | 本方案约 1400 kWh/m2·yr（全国中等偏低，见 §6） |

> 哈尔滨特点：纬度 45.8°N，冬季昼短、太阳高度角低，年水平面辐照约 1400 kWh/m2·yr（四城最低）；**冬夏辐照落差极大**——12 月（最差月）1.68 kWh/m2·d 对 5 月 5.63（约 3.4 倍），是深圳（1.7 倍）/拉萨（1.6 倍）没有的「冬季辐照塌陷」现象，直接决定阵列规模（W5：6.00 kWp，其他城市 2 倍以上）。

## 2. 逐月水平面辐照量与月均温（NASA POWER，5 年平均）

| 月份 | 1 | 2 | 3 | 4 | 5 | 6 | 7 | 8 | 9 | 10 | 11 | 12 |
|---|---|---|---|---|---|---|---|---|---|----|----|----|
| H（kWh/m2·d） | 2.05 | 3.15 | 4.10 | 5.16 | 5.63 | 5.49 | 5.29 | 4.41 | 4.10 | 3.11 | 1.86 | **1.68** |
| T（℃） | -18.4 | -13.4 | -1.3 | 6.7 | 14.6 | 20.1 | 24.0 | 21.0 | 15.7 | 5.8 | -6.5 | -17.9 |

- 水平面辐照最低月：12 月（1.68）；辐照最高的 5 月（5.63）为 12 月的约 3.4 倍——冬夏落差为四城最大；
- 月均温最低 1 月（-18.4 ℃）、最高 7 月（24.0 ℃）——严寒大陆性气候，年较差约 42 ℃；
- 年水平面总辐射约 1400 kWh/m2·yr（均值约 3.84 kWh/m2·d）。

## 3. 最不利设计月（负荷随季节变化，指导书 §3.2 按月比较法）

哈尔滨最不利月由**冬季采暖负荷（7.82 kWh/d）与冬季辐照塌陷（12 月 1.68）叠加**驱动，是全团队 R 值最大的城市——这是哈尔滨设计的最大差异化：冬季资源塌陷直接决定阵列规模。

逐月负荷口径：采暖月（11–3 月）E_AC=7.82；过渡月（4、10 月）4.82；夏季月（6–8 月，含空调）5.31；温和月（5、9 月）3.62。

| 月份 | 1 | 2 | 3 | 4 | 5 | 6 | 7 | 8 | 9 | 10 | 11 | 12 |
|---|---|---|---|---|---|---|---|---|---|---|----|----|
| E_AC | 7.82 | 7.82 | 7.82 | 4.82 | 3.62 | 5.31 | 5.31 | 5.31 | 3.62 | 4.82 | 7.82 | 7.82 |
| H | 2.05 | 3.15 | 4.10 | 5.16 | 5.63 | 5.49 | 5.29 | 4.41 | 4.10 | 3.11 | 1.86 | 1.68 |
| R | 3.81 | 2.48 | 1.91 | 0.93 | 0.64 | 0.97 | 1.00 | 1.20 | 0.88 | 1.55 | 4.20 | **4.65** |

> 结论：最不利设计月 = 12 月（水平面 R = 4.65 最大，全团队最高）——采暖负荷最高（7.82 kWh/d）叠加辐照全年最低（1.68）。若忽略采暖季节变化只看辐照，会误选 5~6 月（辐照最高但负荷最低）——正是指导书 §3.2 强调的「按月比较」的价值。
> 夏季（6–8 月）R 约 0.97~1.20：供能略富余但幅度小（哈尔滨冬季辐照低、夏季负荷含空调 5.31，与拉萨夏季 0.56~0.88 的极端富余完全不同）。
> 四城最不利月 R 对比：深圳 1.63 < 拉萨 1.85 < 兰州 2.77 < **哈尔滨 4.65**——哈尔滨冬季供能压力最大。

## 4. 峰值日照时数（指导书 §3.1）

- 水平面：数值上 H（kWh/m2·d）= 峰值日照时数（h/d）→ 12 月 = 1.68 h/d；
- 倾斜面（倾角 40°、正南，Liu-Jordan 换算，详见 倾角核算-哈尔滨.md）：12 月 = **2.05 h/d**（较水平面 +22%——倾角对冬季改善幅度为四城最大，但因冬季辐照本身太低，即使最优倾角也远低于低纬城市）。

## 5. 温度参数（用于校核）

| 参数 | 取值 | 用途 | 来源 |
|---|---|---|---|
| 最低环境温度 | -38.1 ℃（历史极端最低） | 光伏组串低温开路电压校核（W5） | 哈尔滨市气象台公开资料 |
| 最高环境温度 | 39.2 ℃（历史极端最高） | 组件最高温度估算 | 哈尔滨市气象台公开资料 |
| 组件估算最高温度 | NOCT 公式：T_cell = T_amb + (NOCT−20)/800 × G | 高温 MPPT 电压校核（W5） | 指导书 §3.3 |

- NOCT 取 45 ℃（典型单晶组件），G = 1000 W/m2：
  - 按极端高温 39.2 ℃ → T_cell ≈ 39.2 + 31.3 = **70.5 ℃**（极端工况，与深圳/兰州相当）；
  - 按最热月 7 月月均温 24.0 ℃ → T_cell ≈ 24.0 + 31.3 = **55.3 ℃**（常态最热月）；
  - **严寒侧特别校核（差异化）**：哈尔滨极端最低 -38.1 ℃ 使低温开路电压显著升高（W5：组串 Voc,cold 单块 59.80 V、组串 299.0 V），同时**蓄电池低温禁充/容量损失**要求设备间保温 ≥10 ℃ + 低温加热（W4 详述）——温度对系统设计的影响是四城中最全面（光伏电压 + 蓄电池热管理 + 线缆/设备防冻）。

## 6. 数据一致性说明

- NASA POWER 5 年平均水平面总辐射约 3.84 kWh/m2·d → 年约 1400 kWh/m2·yr，全国中等偏低（纬度高的必然结果），为四城最低；
- 处理：逐月相对变化以 NASA POWER 为准（单一来源、口径一致）；气象局年总量作参考，报告中如实说明即可，不需要混用；
- 备选复核：PVGIS（https://re.jrc.ec.europa.eu/pvg_tools/en/）可选 40° 倾角直接给出倾斜面逐月数据，W5 前可用其复核最不利月与倾斜面辐照。

## 7. 输出汇总（供 W4/W5 使用）

| 结果 | 数值 | 用途 |
|---|---|---|
| 最不利设计月 | 12 月（采暖负荷 + 辐照塌陷叠加） | 光伏阵列容量计算基准（W5） |
| 设计面峰值日照时数 | 水平 1.68 h/d；倾斜 40° = **2.05 h/d**（倾角核算已确认） | 阵列容量（W5） |
| 最低环境温度 | -38.1 ℃ | 低温开路电压校核（W5）、设备间热管理（W4） |
| 最高环境温度 | 39.2 ℃（组件最高约 70.5 ℃） | 组件温度估算（W5） |
| 设计倾角 | 40°、朝向正南（核算确认，见 倾角核算-哈尔滨.md） | 阵列布置（W5/W8） |
| 年水平面总辐射 | 约 1400 kWh/m2·yr | 资源报告（四城最低） |

## 8. 参考资料

1. NASA POWER 月度 API（45.80°N, 126.53°E, 2019–2023）：https://power.larc.nasa.gov/api/temporal/monthly/point?parameters=ALLSKY_SFC_SW_DWN,T2M&community=RE&longitude=126.53&latitude=45.80&start=2019&end=2023&format=JSON
2. 哈尔滨市气象台气候资料（极端温度）。
3. PVGIS 复核工具：https://re.jrc.ec.europa.eu/pvg_tools/en/
