sunny1043/offgrid-pv-course-design/差异化城市设计/设计指导书表格式填写-拉萨.md

# 设计指导书表格式填写 — 拉萨（任务1·户用离网光伏发电系统）

> 本文件把《任务1-设计指导书-户用离网光伏发电系统》中的**表格模板（表1–表11）逐张用拉萨方案结果填写**，并补充必要的计算内容（公式代入）。数据与《设计报告-拉萨》《计算文件-拉萨》一致；图纸与实验见对应章节（图纸已提交，实验待 W10）。
> 设计城市：**拉萨**（29.66°N、91.14°E，海拔约 3650 m）；日期 2026-09-04；产品/数据查询日期 2026-09-01/03。

---

## 表 1 关键负荷类别与建议范围对照（指导书 §2.1）

| 负荷类别 | 必须考虑的设备 | 建议日用电量(kWh/d) | 本方案(拉萨,冬季) | 说明 |
|---|---|---|---|---|
| 制冷和空调 | 冰箱、1 台高效空调 | 3.3~5.0 | 0.54（冬季仅冰箱） | 拉萨最热月均温约 12.9 ℃，冬季无空调；该位置由采暖承接（夏季 6–8 月轻空调 1.35） |
| **采暖（拉萨冬季新增）** | 电热毯、电暖器 | —（替代空调位置） | **4.20** | 电热毯 150 W×8 h=1.20 + 电暖器 1.2 kW×5 h×0.5=3.00 |
| 照明 | LED 照明 | 0.3~0.6 | 0.38 | 飞利浦 LED 12 W×8×4 h |
| 通信和信息设备 | 路由器、电视、计算机、手机 | 0.8~1.4 | 0.97 | 路由 24 h、电视 4 h、笔记本 5 h、手机×2 |
| 基本炊事 | 电饭煲、电热水壶、油烟机 | 0.7~1.2 | 1.15 | 含微波炉、电磁炉（周末午餐） |
| 生活辅助 | 洗衣机、小型水泵、待机负荷 | 0.5~1.0 | 0.57 | 洗衣机 0.38 + 待机 0.19 |
| **合计（冬季设计点）** | | 6.5~8.5 | **7.82** | 区间 7.5~8.0 ✅ |

**计算内容**（指导书 §2.2 E=P·t·k）：E_AC = ΣP·t·k = 3.62（基础）+ 4.20（采暖）= **7.82 kWh/d**；最大同时功率 P_max（冬季 19:00–19:15 烧水时段）≈ **4.6 kW**；短时冲击功率 P_short ≈ **5.2 kW**（指导书 §2.3/§2.4）。

## 表 2 太阳能资源和环境参数（指导书 §3，表2 模板）

| 数据项目 | 采用值 | 单位 | 来源和说明 |
|---|---|---|---|
| 设计城市及坐标 | 拉萨，29.66°N、91.14°E，海拔约 3650 m | — | NASA POWER 2019–2023 五年平均（查询 2026-09-01） |
| 最不利设计月 | **12 月** | 月 | 按月比较 R=E_AC/H：12 月 R=1.85 最大（水平面）/1.65（倾斜面） |
| 设计面峰值日照时数 | **4.74** | h/d | 倾斜 30°、正南（水平 4.23；+12%） |
| 最低环境温度 | **-16.5** | ℃ | 拉萨市气象台公开资料（低温 Voc 校核） |
| 最高环境温度 | **29.4** | ℃ | 拉萨市气象台公开资料（高温 MPPT 校核） |
| 组件估算最高温度 | **60.7**（极端）/ **44.2**（常态） | ℃ | NOCT 公式：T_c=T_a+(NOCT-20)/800×G，NOCT=45 ℃、G=1000 W/m² |
| 安装朝向和倾角 | **正南，30°** | ° | Liu-Jordan 核算：最不利月供能最大、全年总量几乎不损 |

## 表 3 蓄电池设计结果（指导书 §5，表3 模板）

| 项目 | 计算或选定结果 | 产品允许值 | 结论 |
|---|---|---|---|
| 最低标称能量 | **21.64 kWh** | — | E_bat,min=7.82×2×1.10/(0.90×0.95×0.93×1.00) |
| 模块型号及单模块能量 | Benhoo BNP-5120BM，5.12 kWh | — | 51.2 V×100 Ah/1000 |
| 串联数量和并联数量 | N_S=1；N_P=**5** | 1；并联远低于厂家上限 | 完整模块不串联（红线） |
| 实际标称能量 | **25.60 kWh** | ≤1.25×21.64=27.05 kWh | ✅（1.18 倍） |
| 连续放电电流 | **119.5 A** | 5×100=500 A | ✅（裕量 4.2×） |
| 短时放电电流 | **124.3 A**（P_short=5.2 kW） | 峰值 500 A | ✅ |
| 最大充电电流 | **52.9 A** | 5×50=250 A；控制器 100 A | ✅（4.7×） |
| BMS 和并联限制 | 智能 BMS（RS485/CAN）并联 5 台 | 远低于上限 | ✅；保温设备间≥10 ℃（低温充电） |

**计算内容**（指导书 §5.2~5.4）：
- E_bat,min = 7.82×2×1.10 / (0.90×0.95×0.93×1.00) = **21.64 kWh**；C_bat,min = 1000×21.64/51.2 ≈ **422.6 Ah**
- I_dis = 5000/(45×0.93) = **119.5 A**；I_dis,sur = 5200/(45×0.93) = **124.3 A**
- I_chg = min(3000×0.96/54.4, 100) = **52.9 A**（P_PV=3.00 kWp、η_MPPT=0.96、V_chg=54.4 V）
- N_P = max(N_P,E=5, N_P,dis=2, N_P,chg=1) = **5**（能量控制）
- 3 d 敏感性：21.64×1.5=32.45 kWh → 7 台；保守 DOD=0.80 → 24.34 kWh；低温 K_T=0.70 → 30.91 kWh（+43%，保温关键）

## 表 4 光伏阵列设计结果（指导书 §6，表4 模板）

| 项目 | 计算结果 | 设备允许值 | 结论 |
|---|---|---|---|
| 最不利月所需容量 | **2.32 kWp** | — | P_PV,min=7.82×1.10/(4.74×0.782) |
| 组件型号和额定功率 | 隆基 LR7-72HGD-600M，600 W | — | N 型 TOPCon |
| 低温开路电压 | 组串 5×57.21=**286.1 V** | ≤450 V（最大输入）≤430 V（MPPT 上限） | ✅ |
| 高温最大功率点电压 | 组串 5×39.71=**198.5 V**（60.7 ℃） | ≥120 V（MPPT 下限） | ✅ |
| 每串组件数量 | **5** | 可行域 [4,7] | ✅ |
| 并联组串数量 | **1** | — | ✅ |
| 阵列实际装机容量 | **5×600 W=3.00 kWp** | ≤6 kW | ✅ |
| 每路输入电流和功率 | Imp 13.6 A / Isc 14.49 A；3.00 kW | ≤22 A；≤6 kW | ✅ |

**计算内容**（指导书 §6.2~6.4）：V_oc,cold=52.22×[1+(-0.0023)(-16.5-25)]=**57.21 V**；V_mp,hot=44.12×[1+(-0.0028)(60.7-25)]=**39.71 V**；N_S,min=⌈120/39.71⌉=4、N_S,max=⌊450/57.21⌋=7；逐月供能复核 12 个月全满足（最不利月 12 月供能比 1.42，夏季 2.8~4.4 弃光）。

## 表 5 MPPT 控制器和离网逆变器（指导书 §7，表5 模板）

| 设备 | 主要计算需求 | 选定产品参数 | 复核结论 |
|---|---|---|---|
| MPPT 控制器 | 输入电压 ≤450 V、MPPT 120~430 V、每路 ≤22 A、每路功率 ≤6 kW | Growatt SPF 5000 ES（一体机内置） | ✅ 全部通过 |
| MPPT 控制器（电池侧） | 最大充电电流 ≤100 A、锂电充电 | 最大太阳能充电电流 100 A；I_chg=52.9 A | ✅ |
| 离网逆变器 | 输入 48 V、连续 ≥4.6 kW、短时 ≥5.2 kW、220 V 单相 | 5 kW / 10 kVA / 230 V±5 % 纯正弦波 | ✅（利用率 92%） |
| 蓄电池通信 | BMS 协议与充放电控制 | BNP-5120BM RS485/CAN ↔ SPF 锂电通信 | ⏳ 待厂家确认 |
| 交流输出 | 单相 220 V、50 Hz、纯正弦波 | 230 V±5 % @50/60 Hz | ✅ |

**计算内容**（指导书 §7）：I_ac=5000/220≈22.7 A（P_max=4.6 kW 时 20.9 A）；**高海拔（3650 m）功率降额校核**（每 1000 m 降额 8~10% 初估 4.1~4.4 kW，接近 P_max=4.6 kW，需厂家高原额定确认，不足则上调 SPF 6000 ES）；**低温充电策略**（设备间保温≥10 ℃）。

## 表 6 线缆回路计算（指导书 §8，表6 模板）

| 回路 | 设计电压和电流 | 长度 | 线缆型号与截面 | 电压降 | 保护器件 |
|---|---|---|---|---|---|
| 光伏组串 | ≤286.1 V DC；14.49 A | ≈1 m | PV1-F 4 mm² | 0.13 V（0.07%） | F1 25 A gPV |
| 阵列至 MPPT | ≤286.1 V DC；13.6 A | 15 m | PV1-F 4 mm² | 1.79 V（0.90%） | 25 A + 隔离 + SPD |
| MPPT 至电池 | 48 V 级；**52.9 A** | 3 m | **RV 16 mm²** | 0.35 V（0.72%） | 63 A MCB |
| 电池至逆变器 | **45 V 级；119.5 A** | 2 m | **RV 70 mm²** | 0.12 V（**0.27%@45 V**） | QF1 160 A DC MCB |
| 逆变器至交流配电箱 | 220 V；20.9 A | 5 m | RVV 6 mm² | 0.61 V（0.28%） | 32 A C 型 |
| 交流末端回路 | 220 V；1.7~13.6 A | 15~20 m | BV 2.5/4 mm² | ≤1.79 V（≤0.81%） | 10/20/10/16 A MCB |

**计算内容**（指导书 §8.2）：ΔU=2ρLI/S，ρ=0.0175 Ω·mm²/m；载流量按 GB 50217 附录（PVC 空气中 30 ℃ 基准 ×40 ℃ 修正 0.87），全部满足 I_b≤I_n≤I_z；**电池→逆变器相对压降以最低电池电压 45 V 计算（红线），不得除以 220 V**；拉萨 C3 因 I_chg=52.9 A 升为 16 mm²（63 A）。

## 表 7 实验原始记录（指导书 §11.6，表7 模板）— 待 W10 实测

| 时间 | 接法或倾角 | 辐照度/W·m⁻² | 组件温度/℃ | 光伏侧电压/V | 光伏侧电流/A |
|---|---|---|---|---|---|
|  |  |  |  |  |  |
|  |  |  |  |  |  |
|  |  |  |  |  |  |
|  |  |  |  |  |  |

## 表 8 实验结果汇总（指导书 §11.6，表8 模板）— 待 W10

| 实验 | 主要比较量 | 观察结果 | 误差或限制 |
|---|---|---|---|
| 输出功率和效率 | P_PV、η_PV |  |  |
| 串联和并联 | 电压、电流、功率 |  |  |
| 倾角影响 | P_PV 或 P/G |  |  |
| 温度影响（拓展） | V_oc 与 T_c |  |  |

## 表 9 设备清单（指导书 §12.1，表9 模板）

| 类别 | 主要内容 | 数量 | 小计(¥)和价格来源 |
|---|---|---|---|
| 光伏阵列 | 隆基 LR7-72HGD-600M ×5、MC4 ×10 | 5 | 3,250+160（低价期零售，2026-09-03） |
| 支架 | APAS P8-2080 6063-T5 一套（5 块竖排 30°） | 1 套 | 1,500（铝价估算） |
| 控制和变换 | Growatt SPF 5000 ES | 1 | 2,200（淘宝实价锚点） |
| 蓄电池 | BNP-5120BM ×5 + 电池柜 + 母排 | 5+1+1 | 20,000+1,000+350（B2B/电商） |
| 直流保护 | F1 25A、隔离、SPD、支路 5×100A、总保护 160A、63A | — | 40+180+220+175+450+160 |
| 交流配电 | DB、32A、RCD、SPD、末端 10/20/10/16A | — | 320+60+120+200+100 |
| 线缆和接地 | PV1-F/RV16/RV70/RVV6/BV2.5/BV4/接地/桥架 | — | 100+60+130+50+140+165+60+350 |
| 安装辅材 | 端子/标识/防水防火；**设备间保温** | — | 400+800 |
| **合计** | | | **¥32,740** |

**计算内容**（指导书 §12.1）：C_sys=Σn_i·c_i=**¥32,740**；单位装机 ¥10.9/Wp、单位储能 ¥781/kWh；**方案 B（200 Ah）在拉萨失效**（2 台 20.48<21.64 不足、3 台 30.72 超 1.25 倍），故无 B 备选（已在报告中说明，满足"两种配置比较"要求）。

## 表 10 数据一致性检查（指导书 §13.2，表10 模板）

| 检查对象 | 报告 | 图纸 | 设备清单 | 应一致的内容 | 结论 |
|---|:---:|:---:|:---:|---|:---:|
| 光伏组件 | ✅ | ✅ | ✅ | 隆基 LR7-72HGD-600M ×5、5 串×1 并、3.00 kWp | ✅ |
| MPPT 控制器 | ✅ | ✅ | ✅ | SPF 5000 ES（450 V/120~430 V/22 A） | ✅ |
| 蓄电池 | ✅ | ✅ | ✅ | BNP-5120BM ×5、25.60 kWh | ✅ |
| 离网逆变器 | ✅ | ✅ | ✅ | SPF 5000 ES、5 kW/10 kVA | ✅ |
| 线缆 | ✅ | ✅ | ✅ | PV1-F 4、RV 16/70、RVV 6、BV 2.5/4 mm² | ✅ |
| 保护器件 | ✅ | ✅ | ✅ | F1 25A、支路 5×100A、QF1 160A、63A、32A、RCD、SPD | ✅ |

（详见《数据一致性复核-拉萨》：15 项全过，2 处表述粒度可推导。）

## 表 11 主要符号和单位（指导书 附录A，表11 模板）

| 符号 | 含义 | 推荐单位 | 本方案取值 |
|---|---|---|---|
| E_AC | 交流负荷日用电量 | kWh/d | 7.82（冬季采暖设计点） |
| E_bat,min | 蓄电池最低标称能量 | kWh | 21.64 |
| P_PV | 光伏阵列额定功率 | kW | 3.00 |
| P_max | 最大同时功率 | kW | 4.6 |
| P_sur | 短时冲击功率 | kW | 5.2 |
| H_T | 峰值日照时数 | h/d | 4.74（12 月，倾斜 30°） |
| N_A | 自主供电天数 | d | 2（3 d 敏感性） |
| DOD | 允许放电深度 | 1 或 % | 0.90 |
| N_S | 串联数量 | 个 | 5（光伏）；1（电池，系统层） |
| N_P | 并联数量 | 个 | 1（光伏）；5（电池） |
| V_oc | 光伏组件开路电压 | V | 52.22（STC）；低温组串 286.1 |
| V_mp | 最大功率点电压 | V | 44.12（STC）；组串 198.5~246.2 |
| I_sc | 光伏组件短路电流 | A | 14.49 |
| I_mp | 最大功率点电流 | A | 13.60 |
| ΔU | 回路电压降 | V | 电池→逆变 0.12（0.27%@45 V） |
| S | 导体截面积 | mm² | PV1-F 4、RV 16/70、RVV 6、BV 2.5/4 |
| G | 辐照度 | W/m² | 实验测量 |
| T_c | 光伏组件温度 | ℃ | 极端 60.7 / 常态 44.2 |

---

## 附：本文件与提交包其他文件的对应

| 本文件章节 | 对应文件 |
|---|---|
| 表1–表4 | 设计报告-拉萨.md；计算-负荷/蓄电池/光伏阵列-拉萨 |
| 表5 | 控制器逆变器设计-拉萨.md |
| 表6 | 计算-线缆保护-拉萨.xlsx |
| 表7–表8 | 04-实验资料/实验数据处理模板（W10 待补） |
| 表9 | 设备清单与成本分析-拉萨.md + 计算-设备清单-拉萨.xlsx |
| 表10 | 数据一致性复核-拉萨.md |
