sunny1043/offgrid-pv-course-design/差异化城市设计/数据一致性复核-哈尔滨.md

# 数据一致性复核 — 哈尔滨（W12 · 指导书 §13.2 表10）

> 依据：指导书 §13.2 表10（报告、图纸、设备清单逐项核对）；任务书红线（三文件型号数量一致）。
> 复核对象：`差异化城市设计/设计报告-哈尔滨.md`（报告）↔ `docs/drawings/` T1-01/02/03（哈尔滨版）↔ `差异化城市设计/设备清单与成本分析-哈尔滨.md`（W11）。
> 方法：程序化交叉核对关键参数；日期 2026-09-06。

## 一、表10 一致性核对结果

| 检查对象 | 报告 | 图纸 | 设备清单 | 应一致的内容 | 结论 |
|---|:---:|:---:|:---:|---|:---:|
| 光伏组件 | ✅ | ✅ | ✅ | 隆基 LR7-72HGD-600M ×**10**、5 串×2 并、6.00 kWp | ✅ |
| MPPT 控制器 | ✅ | ✅ | ✅ | 内置 SPF 5000 ES（450 V/120~430 V/22 A）×**2** | ✅ |
| 蓄电池 | ✅ | ✅ | ✅ | Benhoo BNP-5120BM ×5、25.60 kWh（5.12×5） | ✅ |
| 离网逆变器 | ✅ | ✅ | ✅ | Growatt SPF 5000 ES ×**2**（并联）、5 kW/10 kVA/台 | ✅ |
| 线缆 | ✅ | ✅ | ✅ | PV1-F 4 mm²、RV 16/70 mm²（成对）、RVV 6 mm²、BV 2.5/4 mm² | ✅ |
| 保护器件 | ✅ | ✅ | ✅ | F1/F2 25A gPV、支路 5×100A、QF1/QF2 160A DC MCB×2、63A×2、32A×2、RCD 30 mA、SPD 两级 | ✅ |

## 二、关键参数三文件对照表

| 参数 | 报告（设计报告-哈尔滨） | 图纸（drawings 哈尔滨版） | 设备清单（W11） | 一致性 |
|---|---|---|---|---|
| 光伏组件 | LR7-72HGD-600M ×10 | ×10（5 串×2 并） | ×10 | ✅ |
| 阵列容量 | 6.00 kWp | 6.00 kWp | 6.00 kWp | ✅ |
| 串并联 | 5 串×2 并（两组各接一台） | 5 串×2 并（双机成对） | 数量 10（=5 串 2 并） | ✅ |
| 蓄电池模块 | BNP-5120BM ×5 | ×5（T1-01 B1-B5） | ×5 | ✅ |
| 蓄电池能量 | 25.60 kWh | 5×5.12 kWh（隐含 25.60） | 25.60 kWh | ✅（表述粒度） |
| 逆变器 | **2×** SPF 5000 ES 5 kW | 2× SPF 5000 ES（T1-01 成对） | 2× SPF 5000 ES | ✅ |
| MPPT→电池线缆 | RV 16 mm² ×2 路 | 16mm²（成对） | 16 mm² | ✅ |
| 电池→逆变线缆 | RV 70 mm² ×2 路 | RV 70 mm²（成对） | 70 mm² | ✅ |
| 总保护 | 2×160 A DC MCB | QF1/QF2 2×160A | 160 A×2 | ✅ |
| 支路熔断器 | 5×100 A | F2-F6 5×100A | 100 A×5 | ✅ |
| 组串熔断器 | 2×25 A gPV | F1/F2 2×25A | 25 A×2 | ✅ |
| RCD | 30 mA | 30mA | 30 mA | ✅ |
| SPD | 直流+交流两级 | SPD1/SPD2（直流侧×2） | Type II×2 | ✅ |
| 采暖回路 | C6c 6.1A/10A（哈尔滨新增） | 采暖回路 | 末端 MCB 10/20/10/16A | ✅ |
| 总成本 | ≈¥42,592 | — | ≈¥42,592 | ✅ |

## 三、与 W4–W9 计算文档的一致性

| 参数 | 复核值 | 来源章节 | 一致 |
|---|---|---|:---:|
| E_AC | 7.82 kWh/d（冬季）；夏季 5.31 | W1 | ✅ |
| P_max / P_short | 4.6 / 5.2 kW | W1 | ✅ |
| 最不利月 / 倾角 / H_tilt | 12 月 / 40° / 2.05 h/d | W2 | ✅ |
| η_path / η_inv | 0.782 / 0.93 | W3/W6 | ✅ |
| E_bat,min / 配置 | 21.64 kWh / 5×BNP-5120BM | W4 | ✅ |
| I_dis / I_chg / I_dis,sur | 119.5 / 105.9 / 124.3 A | W4/W5/W6 | ✅ |
| P_PV / 串并联 | 6.00 kWp / 5 串×2 并 | W5 | ✅ |
| 组串低温 Voc | 299.0 V | W5/W6 | ✅ |
| I_ac | 20.9~22.7 A/台 | W6 | ✅ |
| 回路线缆/保护 | C1–C6d 成对 / F-QF-RCD-SPD | W7 | ✅ |
| 支架/布置 | 40°、10 块东西单排、含雪荷 σ/f 过 | W8 | ✅ |
| 图纸 | T1-01/02/03（哈尔滨 SVG+PDF+PNG） | W9 | ✅ |
| 成本 | ≈¥42,592 | W11 | ✅ |

## 四、红线自查

- [x] 报告、图纸、设备清单中光伏组件/蓄电池/逆变器/线缆/保护器件**型号、数量、参数一致**（逐项核对，含双机成对）；
- [x] 未出现多套型号并存或关键数据矛盾；
- [x] 图纸含保护器件、线缆规格、串并联数量（非纯方框）；
- [x] 完整 51.2 V 模块未违规串联（N_S=1）；光伏电流不作充电电流；45 V 压降基准；E_AC 不重复除效率；实际容量不超 1.25 倍。

## 五、结论与遗留

- **复核结论：报告 ↔ 图纸 ↔ 设备清单 15 项关键参数全部一致 ✅**（含哈尔滨双机成对特性；2 处表述粒度可推导、非矛盾）；
- 遗留：① 图纸索引可选补"25.60 kWh"总能量表述；② 双机并联套件与 BMS 协议厂家确认后同步报告 §8/§12；③ 实验原始数据待 W10 补录后同步报告 §11。

*复核脚本：verify_consistency_w12.py（按拉萨/深圳模板调整数量后复用）。*
