sunny1043/offgrid-pv-course-design/差异化城市设计/答辩准备与最终自查-拉萨.md

# 答辩准备与最终提交自查 — 拉萨（W13 收尾）

> 依据：考核标准 §七（答辩 12 问）、§八（9 项最终自查表）、任务书 §七（提交成果）。
> 说明：WBS 官方 W1–W12（指导书 §13=W12），本文件为收尾阶段（W13）。答辩答案均基于**拉萨个人数据**；实验原始数据待 W10 补录。
> 状态：完成（SPF 5000 ES 高原额定确认后回填 §一 第 8 问相关表述）。

## 一、答辩 12 问（考核标准 §七）——拉萨个人数据版

**1. 为什么日用电量不能直接确定逆变器功率？**
日用电量是能量（kWh/d）、逆变器功率是功率（kW）。本设计 E_AC=7.82 kWh/d，但 P_max=4.6 kW——电暖器 1.2 kW 每天约 5 h（日耗电 3.00 kWh）与电热水壶 1.8 kW（日耗电 0.27 kWh）都对能量贡献不同，却共同抬升瞬时功率；二者由 24 h 运行表分别确定，不能互换。

**2. 你的最大同时功率出现在什么时段？**
冬季 **19:00–19:15 烧水时段**：电暖器 1.2 + 电热毯 0.15 + 水壶 1.8 + 电饭煲 0.86 + 油烟机 0.26 + 照明 0.10 + 电视 0.11 + 冰箱 0.12 + 路由 0.01 ≈ **4.6 kW**；周末校核（电磁炉周末午餐、电暖器未开）≈3.6 kW。

**3. 为什么本系统采用 48 V 级蓄电池？**
户用离网连续功率达数千瓦（拉萨冬季 P_max=4.6 kW 更高），48 V 级（磷酸铁锂 16 串，标称 51.2 V）把 I_dis 控制在约 119.5 A，降低线缆截面、压降与保护成本，并匹配主流离网逆变器与机架式电池模块。

**4. 你的电池模块内部和系统层面分别如何串并联？**
模块内部 16 个 3.2 V 单体串联并配 BMS（16S）；**系统层面 N_S=1**（完整 51.2 V 模块不得继续串联，红线）、**N_P=5 台并联**。

**5. 蓄电池并联数量由能量还是电流决定？**
由**能量**决定：N_P,E=⌈21.64/5.12⌉=5 > 放电电流所需 2、充电电流所需 1，故 N_P=5。

**6. 为什么 3 d 方案没有直接作为最终配置？**
3 d 能量为 2 d 基准的 1.5 倍（32.45 kWh），需 7 台（多 2 台、约 +30% 成本），仅作可靠性敏感性；2 d 基准已满足连续阴雨 2 天电池独立支撑。

**7. 最低温度如何影响光伏组串开路电压？**
Voc 温度系数 -0.23 %/℃，低温使 Voc 升高。拉萨极端最低 **-16.5 ℃** → 单块 Voc,cold=57.21 V、组串 5×57.21=**286.1 V**，须 ≤ 控制器最大输入 450 V（裕量 164 V，比深圳 229 V 收紧）与 MPPT 上限 430 V。

**8. 光伏侧电流和蓄电池充电电流为什么不同？**
MPPT 两侧功率守恒：光伏侧高压小电流（Vmp 198.5~246.2 V、13.6 A），降压到 48 V 侧后电流增大（I_chg=52.9 A）。不能把 13.6 A 当充电电流（红线）。

**9. 电池至逆变器线缆为什么不能按 220 V 计算电压降？**
该回路是 48 V 直流回路，相对压降应除以**最低电池电压 45 V**：ΔU=0.12 V → δU=**0.27%**；误除以 220 V 得 0.06% 会掩盖真实压降（指导书 §8.2 红线）。

**10. 三张图纸中的哪一项参数最容易出现不一致？**
线缆型号/截面与保护器件额定值（T1-01 每回路、T1-03 桥架、BOM 三处易漂移）；已用表10 复核锁定（含拉萨特有 16 mm² 充电回路与采暖回路）。

**11. 实验中为什么不能用蓄电池电压乘光伏侧电流？**
两个电气位置电压不同（光伏侧 198.5~246.2 V vs 电池 45~58 V），混乘无物理意义；光伏功率必须用同一工作点 V_PV×I_PV（实验红线）。

**12. 如果总成本过高，你会按什么顺序调整方案？**
按 W11 §4：① 组件在低价期采购（N 型 0.5~1.0 元/W）；② 设备间保温自装/简化电伴热（但**不能取消保温**——不保温 K_T=0.70 需多 2 台电池，约 +¥8,000，得不偿失）；③ 支架自装。**不得**以取消保护、扩大 DOD、超电流限值降本；方案 B（200 Ah）在拉萨失效，无此降本空间。

## 二、9 项最终自查（考核标准 §八 表6）

| # | 检查内容 | 自查 | 佐证 |
|---|---|:---:|---|
| 1 | 负荷在分配范围 + 24 h 运行表 | ✅ | E_AC=7.82∈[7.5,8.0]，W1 §3 24h 表 |
| 2 | 资源/温度/产品/价格有来源 | ✅ | NASA POWER、气象台、产品页、电商价（2026-09-01/03） |
| 3 | 蓄电池能量/电流/BMS/组合已复核 | ✅ | W4 §9 表3 + W12 复核表 |
| 4 | 光伏组串高低温电压/输入电流校核 | ✅ | W5/W6（286.1 V、198.5 V、14.49 A） |
| 5 | MPPT 输入/输出侧参数未混淆 | ✅ | W6 §3 两侧分列（13.6 A vs 52.9 A） |
| 6 | 逆变器/线缆/保护参数完整 | ✅ | W6/W7（119.5/52.9/20.9 A；含高原降额待确认项） |
| 7 | 三张 A3 图纸及源文件齐全 | ✅ | docs/drawings/ 拉萨版（SVG+PDF+PNG） |
| 8 | 报告/图纸/BOM 型号数量一致，命名合规 | ✅ | W12 数据一致性复核（15 项全过） |
| 9 | 实验数据齐全、公式可编辑、能独立说明 | ⏳ | 报告 §11 已给方法公式；**原始数据待 W10 补录** |

## 三、最终提交文件夹（任务书 §七 6 项成果）

```
提交-XXXXXXX-姓名-任务1-拉萨/
├── 01-设计报告/ 设计报告-拉萨.docx + .pdf
├── 02-工程图纸/  T1-01/02/03（拉萨） .svg + .pdf
├── 03-计算文件/  计算-蓄电池/光伏阵列/线缆保护/支架/设备清单-拉萨.xlsx
├── 04-实验资料/  原始记录/照片/数据文件（W10 补录）
├── 05-产品与价格资料/ 各章来源与查询日期汇总
└── 06-说明/      本自查表 + 各章设计文档（差异化城市设计/拉萨）
```

## 四、提交前红线复查（任务书 §九）

- [x] 报告与三张图纸齐全；负荷在区间内；蓄电池/光伏/控制器/逆变器均有计算校核过程；
- [x] 图纸型号数量与计算一致（W12 复核）；未用蓄电池电压×光伏电流算功率；
- [x] 完整 51.2 V 模块未违规串联（N_S=1）；
- [x] 产品参数、资源、价格均有来源与查询日期；
- [x] 实验数据来源可说明（W10 补录后核对）；能解释个人设计参数与取舍（本文件 §一）。

## 五、遗留

1. **SPF 5000 ES 高原额定（3650 m）确认**：若连续能力不足 4.6 kW，上调 SPF 6000 ES 并同步报告 §8/§12、图纸与清单（W12 前完成）；
2. **W10 实验原始数据**补录后回填报告 §11 与本自查第 9 项；
3. 学号/姓名填入提交文件夹命名与图纸标题栏。
