sunny1043/offgrid-pv-course-design/docs/答辩准备与最终自查-深圳.md

# 答辩准备与最终提交自查 — 深圳（W13 收尾）

> 依据：考核标准 §七（答辩 12 问）、§八（9 项最终自查表）、任务书 §七（提交成果 6 项）。
> 说明：WBS 官方为 W1–W12（指导书 §13=W12），本文件为**收尾阶段（W13）**：用个人数据备好答辩、按表6自查、并整理最终提交文件夹。
> 状态：完成（答辩答案均基于深圳方案个人数据；实验原始数据待 W10 补录后回填）。

## 一、答辩 12 问（考核标准 §七）——深圳个人数据版

**1. 为什么日用电量不能直接确定逆变器功率？**
日用电量是"能量"（kWh/d），逆变器功率是"功率"（kW）。本设计 E_AC=6.99 kWh/d，但最大同时功率 P_max=3.0 kW——电热水壶 1.8 kW 每天只运行约 9 分钟（日耗电 0.27 kWh），对日用电量几乎无影响，却显著抬升瞬时功率；反之 6.99 kWh/d 也不能当逆变器功率。二者由 24 h 运行表分别确定。

**2. 你的最大同时功率出现在什么时段？**
空调期（5–10 月）**19:00–19:15 烧水时段**：基础+空调+照明+电饭煲+油烟机+电视+水壶 ≈ **2.5 kW**；周末校核（电磁炉+空调+照明+电视）≈ **3.0 kW**，故 P_max≈3.0 kW。

**3. 为什么本系统采用 48 V 级蓄电池？**
户用离网连续功率达数千瓦，若用 12/24 V，同一功率下直流电流大，线缆截面、压降、端子与保护成本随之提高。48 V 级（磷酸铁锂 16 串，标称 51.2 V）把 I_dis 压到约 119.5 A，并匹配主流户用离网逆变器与机架式电池模块。

**4. 你的电池模块内部和系统层面分别如何串并联？**
模块内部为 16 个 3.2 V 单体串联并配 BMS（16S）；**系统层面 N_S=1**（完整 51.2 V 模块未经厂家允许不得继续串联，红线），**N_P=4 台并联**。

**5. 蓄电池并联数量由能量还是电流决定？**
本设计由**能量**决定：N_P,E=⌈19.34/5.12⌉=4 > 放电电流所需 2、充电电流所需 1，故 N_P=max(4,2,1)=4。

**6. 为什么 3 d 方案没有直接作为最终配置？**
3 d 自主供电能量为 2 d 基准的 1.5 倍（29.01 kWh），需 6 台模块、多约 1/3 成本，仅用于观察可靠性提升的成本敏感性；2 d 基准已满足连续阴雨 2 天由电池独立支撑。

**7. 最低温度如何影响光伏组串开路电压？**
组件 Voc 温度系数 -0.23 %/℃，低温使 Voc 升高。深圳极端最低 0.2 ℃ → 单块 Voc,cold=55.20 V、组串 4×55.20=**220.8 V**，必须 ≤ 控制器最大输入电压 450 V 与 MPPT 上限 430 V。

**8. 光伏侧电流和蓄电池充电电流为什么不同？**
MPPT 两侧功率守恒（V_PV·I_PV·η≈V_bat·I_chg），光伏侧高压小电流（组串约 154~189 V、13.6 A），降压到 48 V 侧后电流增大（I_chg=42.4 A）。不能把光伏侧 13.6 A 当充电电流（红线）。

**9. 电池至逆变器线缆为什么不能按 220 V 计算电压降？**
该回路是 48 V 直流回路，相对压降应除以**最低电池电压 45 V**：ΔU=0.12 V → δU=**0.27%**；若误除以 220 V 得 0.06%，会掩盖真实压降、低估线缆需求（指导书 §8.2 红线）。

**10. 三张图纸中的哪一项参数最容易出现不一致？**
**线缆型号/截面与保护器件额定值**最易不一致（T1-01 每回路标注、T1-03 桥架、设备清单 BOM 三处都可能漂移）；已用数据一致性复核表（表10）逐项锁定组件/蓄电池/逆变器/线缆/保护参数。

**11. 实验中为什么不能用蓄电池电压乘光伏侧电流？**
光伏侧与蓄电池侧是两个电气位置，电压不同（约 154~189 V vs 45~58 V），混乘得到的是无物理意义的功率。光伏功率必须用同一工作点的 V_PV×I_PV（实验红线）。

**12. 如果总成本过高，你会按什么顺序调整方案？**
按 W11 §4 顺序：① 蓄电池改方案 B（2×200 Ah，约省 ¥3,000~4,000，需同步复核电流与图纸）；② 组件在低价期采购（N 型 0.5~1.0 元/W）；③ 支架自装/辅材比价。**不得**以取消保护、扩大 DOD、超电流限值降本。

## 二、9 项最终自查（考核标准 §八 表6）

| # | 检查内容 | 自查 | 佐证 |
|---|---|:---:|---|
| 1 | 负荷在分配范围 + 24 h 运行表 | ✅ | E_AC=6.99∈[6.5,8.5]，W1 §3 24h 表 |
| 2 | 资源/温度/产品/价格有来源 | ✅ | 各章"来源/查询日期"；NASA POWER、产品页、电商价 2026-09-01/03 |
| 3 | 蓄电池能量/电流/BMS/组合已复核 | ✅ | W4 §9 表3 + W12 复核表 |
| 4 | 光伏组串高低温电压/输入电流校核 | ✅ | W5 §7（220.8 V、154.2 V、14.49 A） |
| 5 | MPPT 输入/输出侧参数未混淆 | ✅ | W6 §3 两侧分列（13.6 A vs 42.4 A） |
| 6 | 逆变器/线缆/保护参数完整 | ✅ | W6/W7（I_dis=119.5、I_ac=22.7、6 类回路） |
| 7 | 三张 A3 图纸及源文件齐全 | ✅ | docs/drawings/ T1-01/02/03（SVG+PDF+PNG） |
| 8 | 报告/图纸/BOM 型号数量一致，命名合规 | ✅ | W12 数据一致性复核（14 项全过） |
| 9 | 实验数据齐全、公式可编辑、能独立说明 | ⏳ | 报告 §11 已给方法与公式；**原始数据待 W10 补录** |

## 三、最终提交文件夹（任务书 §七 6 项成果）

建议结构（按"学号-姓名-任务-城市"命名，此处以示例占位）：
```
提交-XXXXXXX-姓名-任务1-深圳/
├── 01-设计报告/ 设计报告-深圳.docx + .pdf
├── 02-工程图纸/  T1-01/02/03 .svg(源) + .pdf
├── 03-计算文件/  计算-蓄电池/光伏阵列/线缆保护/支架/设备清单-深圳.xlsx
├── 04-实验资料/  原始记录/照片/数据文件（W10 补录）
├── 05-产品与价格资料/ 各章产品来源与查询日期汇总
└── 06-说明/      本自查表 + 各章设计文档（docs/ 深圳 W1–W12）
```

## 四、提交前红线复查（任务书 §九）

- [x] 报告与三张图纸齐全；负荷在区间内；蓄电池/光伏/控制器/逆变器均有计算校核过程；
- [x] 图纸型号数量与计算一致（W12 复核）；未用蓄电池电压×光伏电流算功率；
- [x] 完整 51.2 V 模块未违规串联（N_S=1）；
- [x] 产品参数、资源、价格均有来源与查询日期；
- [x] 实验数据来源可说明（W10 补录后再次核对）；能解释个人设计主要参数与取舍（本文件 §一 12 问）。

## 五、遗留

1. **W10 实验原始数据**补录后回填报告 §11 与本自查表第 9 项；
2. 学号/姓名填入提交文件夹命名与图纸标题栏；
3. 答辩前按 §一 逐问演练（可用个人数据快速复述）。
