sunny1043/offgrid-pv-course-design/差异化城市设计/控制器逆变器设计-哈尔滨.md

# 控制器与逆变器设计 — 哈尔滨（W6）

> 依据：指导书 §7、任务书 §4.5。状态：本地草稿。
> 哈尔滨差异化：**6.0 kWp 阵列两串并联电流超过单台 MPPT 限值，采用 2× SPF 5000 ES 并联、每台各带一串**；另有严寒低温充电策略（比拉萨更刚性）。

## 1. 选型：2× Growatt SPF 5000 ES（并联）

| 参数 | 数值 | 来源 |
|---|---|---|
| 额定交流功率 | 5000 W × 2（并联） | 官方 Datasheet 2024-09 |
| 短时浪涌 | 10000 VA × 2 | 同上 |
| 峰值效率 | 93% | 同上 |
| MPPT 电压范围 | 120~430 V | 同上 |
| 最大 PV 输入电压 | 450 V | 同上 |
| 每 MPPT 最大输入电流 | 22 A | 同上 |
| 最大 PV 输入功率 | 6000 W/台 | 同上 |
| 最大太阳能充电电流 | 100 A/台 | 同上 |

## 2. 为什么需要两台（差异化核心，答辩重点）

- 阵列 6.0 kWp、两串并联时 MPPT 输入电流 Isc = 2×14.49 = 28.98 A > 22 A（单台每 MPPT 限值）；
- 方案：拆分为 2 组各 3.0 kWp（一串），分别接入两台 SPF 5000 ES 的 MPPT（单台 Isc 14.49 ≤ 22 ✅）；
- 两台在交流侧并联（Growatt 并联套件），共用 48 V 电池母线；总交流能力 10 kW ≫ 负荷 4.6 kW（富余大，运行说明注明负荷分配）。

## 3. 逆变器侧校核

| 校核项 | 需求 | 能力（2 台） | 结论 |
|---|---|---|---|
| 连续功率 | P_max = 4.6 kW | 2×5.0 kW = 10 kW | ✅ |
| 短时功率 | P_short = 5.2 kW | 2×10 kVA = 20 kVA | ✅ |
| 交流输出电流 | 约 20.9 A（4.6 kW/220V） | 足够 | ✅ |
| 电池侧连续放电 | 119.5 A（系统负荷 4.6 kW≈110 A，保守按单台满载；双机理论极限 238.9 A 需 10 kW 负荷、不作为选型依据） | 5×100=500 A（电池侧） | ✅ |

## 4. MPPT 控制器侧校核（每台一串）

| 校核项 | 计算 | 允许值 | 结论 |
|---|---|---|---|
| 组串低温 Voc | 299.0 V | ≤450 V；≤430 V（MPPT 上限） | ✅ |
| 组串高温 Vmp | 192.5 V | ≥120 V | ✅ |
| 组串低温 Vmp | 259.6 V | ≤430 V | ✅ |
| 输入电流 | 14.49 / 13.6 A | ≤22 A | ✅ |
| 输入功率 | 3.0 kW | ≤6.0 kW | ✅ |
| 充电电流 | min(3000×0.96/54.4,100)=52.9 A/台；合计 105.9 A | 2×100 A | ✅ |

## 5. 哈尔滨特有校核（深圳/兰州没有或更严）

1. **严寒低温充电**：-38.1 ℃ 下 LFP 禁止低温充电，设备间保温不低于 10 ℃ 是必须（W4 §5）；BMS 低温保护与逆变器充电策略匹配；
2. **冬季组件结霜/积雪**：倾角 40° 利于自滑，但仍需在运行说明中加入冬季清雪维护（W8 支架设计考虑积雪）；
3. **冬季高负荷 + 低辐照**：双机并联保证冗余，任意一台故障时另一台可承载 P_max 4.6 kW（裕量设计）。

## 6. 回填闭环

| 参数 | 取值 | 回填 |
|---|---|---|
| eta_inv / eta_ctrl | 0.93 / 0.96 | W3/W4/W5 |
| I_ctrl,out,max | 100 A/台 | W4/W5 I_chg |
| 双机并联 | 2× SPF 5000 ES | W4 放电电流 239 A、W11 成本 |

## 7. 待确认/下一步

1. 双机并联套件与 BMS（RS485/CAN）协议匹配厂家确认；
2. 组件冬季积雪对发电的影响量化（W10 实验可测）；
3. W7 线缆/保护：直流侧按 239 A/105.9 A、交流侧按 20.9 A 选截面；
4. W8 支架：40° 倾角 + 雪荷载（哈尔滨基本雪压约 0.45 kN/m2）。
