sunny1043/offgrid-pv-course-design/差异化城市设计/蓄电池设计-哈尔滨.md

# 蓄电池设计 — 哈尔滨（W4）

> 依据：设计指导书 §5（蓄电池容量和组合方式）、课程设计任务书 §4.3；输入来自 W1 负荷调查、W2 太阳能资源、W3 系统组成与能量损失口径。
> 状态：已完成（2026-09-03 完善至与深圳/拉萨同级详细度，覆盖 D5 检查点③交付要求；配套 Excel 计算文件 docs/计算-蓄电池-哈尔滨.xlsx）。
> 哈尔滨差异化：容量由「冬季电采暖负荷」驱动（E_AC=7.82 kWh/d，与拉萨/兰州同设计点，高于深圳 6.99）；极端最低 **-38.1 ℃**（全团队最严酷）——**设备间保温（不低于 10 ℃）+ 低温加热为硬性前提**，否则 LFP 无法正常充放电，低温敏感性最突出；光伏 6.00 kWp（冬季辐照塌陷导致）需 **2× Growatt SPF 5000 ES 并联**（仅因光伏输入侧 MPPT 电流限值所需，非负荷所需）；电池侧连续放电电流按系统负荷上限校核（保守口径单台满载 119.5 A，双机理论极限 238.9 A 不作为设计依据）；方案 B（200 Ah）**失效**（同拉萨/兰州）。

## 1. 设计输入（均来自已完成工作包，来源见各文档）

| 输入 | 取值 | 来源 |
|---|---|---|
| 交流侧日用电量 E_AC | **7.82 kWh/d**（冬季采暖季设计点） | W1 负荷调查-哈尔滨.md |
| 逆变器效率 η_inv | 0.93 | W3（Growatt SPF 5000 ES 官方峰值效率，W6 确认） |
| 蓄电池放电效率 η_dis | 0.95 | W3 效率表 |
| 最大同时功率 P_max | 4.6 kW | W1（逆变器选型输入） |
| 短时冲击功率 P_short | 5.2 kW | W1（短时电流校核输入） |
| 设计城市 | 哈尔滨 | 极端最低 -38.1 ℃；蓄电池置于**保温设备间（不低于 10 ℃）+ 低温加热**，低温修正 K_T=1.00（见 §3/§8 敏感性） |

## 2. 为什么采用 48 V 级系统（指导书 §5.1）

同深圳/拉萨/兰州：户用离网连续功率达数千瓦，48 V 级（磷酸铁锂 16 串，标称 51.2 V）可降低直流电流，与常见户用离网逆变器和磷酸铁锂模块匹配。哈尔滨冬季 P_max=4.6 kW，电池母线最大持续电流约 110 A（冗余口径 119.5 A）；若改用 24 V 级系统同功率电流将翻倍（约 220 A 级），48 V 级对控制线缆截面与保护器件规模仍尤为关键。

## 3. 最低标称能量（指导书 §5.2）

    E_bat,min = E_AC * N_A * K_R / (DOD * η_dis * η_inv * K_T)

| 系数 | 取值 | 取值依据 |
|---|---|---|
| N_A 自主供电天数 | **2 d** | 任务书基准设计；3 d 敏感性见 §7 |
| K_R 容量储备系数 | **1.10** | 指导书 §5.2 建议 1.05~1.10，取上限（含容量衰减余量） |
| DOD 允许放电深度 | **0.90** | 磷酸铁锂 + 智能 BMS，厂家允许深度循环（模块放电下限 44.8 V）；保守口径 0.80 见 §8 |
| η_dis 放电效率 | 0.95 | W3 效率表 |
| η_inv 逆变器效率 | 0.93 | W3（SPF 5000 ES 官方峰值效率） |
| K_T 低温修正 | **1.00** | 蓄电池置于保温设备间（不低于 10 ℃），**哈尔滨为必须 + 低温加热**；**无保温敏感性 K_T=0.70 见 §8** |

    E_bat,min = 7.82 * 2 * 1.10 / (0.90 * 0.95 * 0.93 * 1.00) = 21.64 kWh

按安时表示（51.2 V 标称）：

    C_bat,min = 1000 * E_bat,min / V_nom = 1000 * 21.64 / 51.2 = 422.6 Ah

> 口径说明（W3 §7）：E_AC 为交流侧日用电量，公式内部已含 η_inv，不再重复除以逆变器效率；各损失只计一次。
> 与深圳对比：E_bat,min 由 19.34 升至 **21.64 kWh**（+12%），源于冬季电采暖把 E_AC 从 6.99 提到 7.82——拉萨/兰州/哈尔滨三城同值。

## 4. 模块选型与串并联（指导书 §5.3）

完整 51.2 V 磷酸铁锂模块内部为 16 个 3.2 V 单体串联并配置 BMS。系统层面 N_S = 1（完整模块未经厂家明确允许不得继续串联——任务书红线）。

### 方案 A（推荐）— 本宁 Benhoo BNP-5120BM × 5

| 参数 | 数值 | 来源 |
|---|---|---|
| 型号 | BNP-5120BM（51.2 V 100 Ah 机架式磷酸铁锂） | [Benhoo 官网产品页](https://www.benhoobattery.com/cn/products/energy-storage-batteries/residential-solar-storage-batteries/battery-module-zh-cn-1)（查询日期 2026-09-01） |
| 标称电压 / 容量 / 能量 | 51.2 V / 100 Ah / **5.12 kWh** | 同上 |
| 充放电电压范围 | 44.8 ~ 57.6 V | 同上 |
| 标准 / 最大充电电流 | 20 A / **50 A** | 同上 |
| 标准 / 最大放电电流 | 50 A / **100 A** | 同上 |
| 通信 / BMS | RS485、CAN；智能 BMS | 同上 |
| 允许并联 | 厂家标注可大量并联（本设计仅 5 台，远低于上限） | 同上 |
| 参考价 | 约 ¥3,500–5,000/台（同类 51.2 V 100 Ah 机架式 B2B 区间） | [Alibaba 同类产品页](https://www.alibaba.com/product-detail/KUVO-High-Quality-Rack-Mounted-LiFePO4_1601623844855.html) |

- E_mod = 51.2 × 100 / 1000 = **5.12 kWh**；N_P,E = ceil(21.64 / 5.12) = **5**
- 实际配置：**5 台并联（N_S=1），总标称能量 25.60 kWh**，为下限计算值的 **1.18 倍**（≤1.25 倍上限 ✅）

### 方案 B（200 Ah，本方案不成立）— 51.2 V 200 Ah 机架式模块

| 项目 | 数值 | 结论 |
|---|---|---|
| 单模块能量 | 10.24 kWh（51.2 V × 200 Ah） | — |
| 2 台并联 | 20.48 kWh | 低于下限 21.64 kWh，**容量不足** ✗ |
| 3 台并联 | 30.72 kWh | 为下限的 1.42 倍，**超过 1.25 倍上限** ✗ |

> **差异化结论（答辩点）**：在深圳（下限 19.34 kWh），方案 B 用 2 台 10.24 kWh = 20.48 kWh 恰好满足（1.06 倍）；在哈尔滨（同拉萨/兰州），冬季电采暖把容量下限抬到 21.64 kWh，200 Ah 方案出现「2 台不够、3 台超上限」的夹逼困境，因此**本方案仅方案 A（100 Ah × 5）可行**。城市负荷差异直接影响蓄电池组合。

## 5. 放电与充电电流校核（指导书 §5.4）

逆变器：哈尔滨采用 **2× Growatt SPF 5000 ES 并联**（原因见 W6：单台 MPPT 电流限值 22 A 容不下 6.0 kWp 两串并联），共用 48 V 电池母线。V_bat,min = 45 V（与模块放电下限 44.8 V 一致；逆变器低压切断须设置 ≥44.8 V）。

**放电电流口径说明（按系统负荷、而非按设备并联能力之和）**：母线连续放电设计电流由系统最大持续负荷决定——P_max=4.6 kW 对应 I_load = 4600/(45×0.93) ≈ **110 A**；考虑单台逆变器可全带负荷（任一台故障时冗余运行），保守设计口径取单台逆变器满载 I_dis = 5000/(45×0.93) = **119.5 A**（与深圳/兰州单机口径一致）。两台逆变器同时各带 5 kW（即 10 kW 负荷）的理论极限 238.9 A 在负荷清单中不存在，仅作设备能力说明、不作为母排/保护选型依据——电池母线按 ≤160 A 级设计即可，避免母线/母排/端子按 240 A 级配置带来的成本上升。

连续放电电流（保守设计口径，单台满载可全带）：I_dis = 5000 / (45 × 0.93) = **119.5 A**（负荷需求约 110 A）

短时放电电流（P_short = 5.2 kW，通常由单台承担）：I_dis,sur = 5200 / (45 × 0.93) = **124.3 A**

最大充电电流（光伏容量 P_PV=6.00 kWp，W5 定案；η_MPPT=0.96；充电电压 54.4 V；第二项为两台控制器输出限流合计 2×100 A）：

    I_chg = min( P_PV × η_MPPT / V_bat,chg , 2 × I_ctrl,out,max )
          = min( 6000 × 0.96 / 54.4 , 200 ) = 105.9 A

| 校核项 | 需求值 | 方案 A 能力（5×BNP-5120BM） | 结论 |
|---|---|---|---|
| 连续放电 | 119.5 A（负荷约 110 A；保守按单台满载） | 5 × 100 A = 500 A | ✅ 裕量 4.2× |
| 短时放电 | 124.3 A | 峰值 5 × 100 A = 500 A | ✅ |
| 最大充电 | 105.9 A | 5 × 50 A = 250 A | ✅ 裕量 2.4× |

并联数量：N_P = max(N_P,E, N_P,dis, N_P,chg) = max(5, 2, 3) = **5**——本设计由能量需求控制。

> 注意：不能把光伏侧短路电流当作蓄电池充电电流（MPPT 输入侧高压小电流、输出侧低压大电流，指导书 §7.1 警告；任务书红线）。
> 与深圳对比：I_dis 保持 **119.5 A**（同口径：按负荷上限约 110 A、保守按单台满载；哈尔滨未因双机并联抬高母线设计电流——双机极限 238.9 A 需 10 kW 负荷、本系统负荷清单不存在）；I_chg 由 42.4 A 升至 **105.9 A**（阵列 6.00 kWp）。

## 6. BMS 与并联限制（指导书 §5.4 末）

- 每台 BNP-5120BM 内置智能 BMS（16S 采集、均衡、过充/过放/过流/短路保护），通信 RS485/CAN；
- 并联数量 5 台远低于厂家标注上限，支路采用等长、等截面线缆或对称母排连接；双逆变器并联时电池母线为共用点，需保证各电池支路与两台逆变器直流输入的距离/阻抗对称；
- **哈尔滨严寒注意事项（差异化，最严酷）**：极端最低 -38.1 ℃，磷酸铁锂在 0 ℃ 以下禁止充电（BMS 低温保护）且低温放电容量显著下降——**设备间保温（不低于 10 ℃）+ 低温加热是硬性前提**（非可选），保证冬季夜间放电后次日白天能正常充电；若设备间温度跌至 -20 ℃ 量级，LFP 容量损失过半且低温禁充，系统需根本调整（见 §8 备注）；
- BMS 与逆变器协议匹配（CAN/RS485）：双机并联时两台 SPF 5000 ES 与电池 BMS 的通信协调需厂家确认（并联套件与协议，W6 遗留，W11 前落实）。

## 7. 2 d 基准与 3 d 敏感性对比（指导书 §5.5）

| 项目 | 2 d（基准） | 3 d（敏感性） | 说明 |
|---|---|---|---|
| 最低标称能量 | 21.64 kWh | **32.45 kWh** | 能量比值 = 1.50（理论 3/2） |
| 方案 A（100 Ah） | 5 台 / 25.60 kWh | 7 台 / 35.84 kWh | 32.45/5.12=6.34 取整 7 台 |
| 方案 B（200 Ah） | 不可行（见 §4） | 不可行（3 台 30.72<32.45；4 台超上限） | 夹逼困境更明显 |

> 3 d 方案用于观察自主供电时间提高 50% 带来的成本变化（方案 A 多买 2 台），不采用 3 d 作为最终配置（答辩常问点）。

## 8. 保守口径与低温敏感性复核（差异化重点）

**保守口径（DOD = 0.80）**：

    E_bat,min = 7.82 * 2 * 1.10 / (0.80 * 0.95 * 0.93 * 1.00) = 24.34 kWh  ->  方案 A 需 5 台（25.60 kWh）

本设计采用 DOD = 0.90（智能 BMS 管理下厂家允许值，模块放电下限 44.8 V 提供安全边界）。

**低温敏感性（设备间不保温，最低约 0 ℃，LFP 可用容量约 70%）**：

    K_T = 0.70  ->  E_bat,min = 17.204 / (0.90 × 0.95 × 0.93 × 0.70) = 30.91 kWh  ->  方案 A 需 7 台（35.84 kWh）

**备注（哈尔滨极端工况）**：若设备间降到 -20 ℃ 量级，磷酸铁锂容量损失过半且低温禁充，K_T 将远低于 0.70，蓄电池方案需根本调整（如加大加热功率/提升保温等级/改用低温型电池）——哈尔滨对设备间热管理的要求是全团队最刚性的，也是本设计最重要的可靠性决策。

> **结论**：若不设保温设备间，哈尔滨冬季极端低温（-38.1 ℃）会使蓄电池需求从 21.64 增至 30.91 kWh（+43%，按 0 ℃ 口径），多买 2 台（多约 0.7~1.0 万元）；且 -38.1 ℃ 下保温必须升级为**保温 + 低温加热**，否则系统冬季无法运行。设备间热管理是哈尔滨方案区别于其他三城的关键设计决策。

## 9. 输出汇总（指导书 表3 样式）

| 项目 | 计算或选定结果 | 产品允许值 | 结论 |
|---|---|---|---|
| 最低标称能量 | 21.64 kWh | — | — |
| 模块型号及单模块能量 | Benhoo BNP-5120BM，5.12 kWh | — | — |
| 串联数量 / 并联数量 | N_S = 1（完整模块不串联）；N_P = 5 | 1；并联远低于厂家上限 | ✅ |
| 实际标称能量 | 25.60 kWh | ≤ 1.25 × 21.64 = 27.05 kWh | ✅（1.18×） |
| 连续放电电流 | 119.5 A（负荷约 110 A；保守按单台满载；母线按 ≤160 A 级） | 5 × 100 A = 500 A | ✅ |
| 短时放电电流 | 124.3 A | 峰值 500 A | ✅ |
| 最大充电电流 | 105.9 A（W5 定案 P_PV=6.00 kWp） | 5 × 50 A = 250 A | ✅ |
| BMS 和并联限制 | 智能 BMS（RS485/CAN），并联 5 台 | 远低于上限 | ✅ |
| 设备间热管理 | 保温 ≥10 ℃ + **低温加热（必须）** | — | 设计决策（§6/§8） |

## 10. 成本对比（模块级；W11 详算含 BMS/柜体/母排/安装/双机并联套件）

| 方案 | 配置 | 模块单价参考 | 模块小计 | 特点 |
|---|---|---|---|---|
| A（推荐） | 51.2 V 100 Ah × 5 | 约 ¥3,500–5,000 | 约 ¥17,500–25,000 | 电流裕量大（500 A）、粒度细、参数全可查 |
| B | 51.2 V 200 Ah | — | 不成立 | 2 台不足、3 台超 1.25 倍上限（§4） |

> 结论：选用方案 A（5 台）。深圳方案（4 台）在哈尔滨因冬季负荷升高需**多 1 台电池**，且 200 Ah 方案失效；哈尔滨还需计入**双逆变器并联套件**与**设备间保温/加热**成本（W11 全 BOM）。

## 11. 红线自查（任务书 §九 / 考核标准 §五）

- [x] 未将完整 51.2 V 模块违规串联（N_S = 1）；
- [x] 未把光伏侧电流当充电电流（I_chg 按 MPPT 输出侧功率/电压计算）；
- [x] 蓄电池电流按 48 V 侧电压（V_bat,min=45 V）计算，未误用 220 V；
- [x] E_AC 不重复除以 η_inv（口径与 W3 一致）；
- [x] 效率只计一次（η_dis、η_inv 各用一次）；
- [x] 实际能量 25.60 kWh 未超下限 1.25 倍（1.18×）。

## 12. 待回填/下一步

1. ~~W5 光伏阵列设计回填 P_PV~~（已定案 6.00 kWp，I_chg=105.9 A）；
2. ~~W6 逆变器/MPPT 选型回填~~（2× SPF 5000 ES 并联：单台 P_inv,r=5 kW、η_inv=0.93、I_ctrl,out,max=100 A，均已确认；**双机并联套件与 BMS 协议匹配待厂家确认**）；
3. 设备间保温 + 低温加热方案与成本计入 W11；
4. 三张图纸（T1-01/02/03）与设备清单须与此处型号、数量一致（指导书 §13.2 表10）；电池母线按 ≤160 A 级（119.5 A 设计电流）的母排/总保护/线缆规格在 W7 落实。
