sunny1043/offgrid-pv-course-design/差异化城市设计/支架设备间布置-兰州.md

# 光伏支架、屋面与设备间布置 — 兰州（W8）

> 依据：设计指导书 §9（光伏支架和设备布置）、课程设计任务书 §4.7；输入来自 W2 倾角核算（倾角 30°、排间节距 2.51×L）、W5 光伏阵列设计（隆基 LR7-72HGD-600M ×6、3.60 kWp、6 串×1 并）、W4 蓄电池设计（5×BNP-5120BM 机架式）、W6 逆变器选型（Growatt SPF 5000 ES，330×135×485 mm）、W7 线缆回路。
> 状态：完成（屋面/设备间尺寸为课程设计假设，W9 图纸落实后回填修正）。
> 荷载依据：GB 50009-2012《建筑结构荷载规范》（兰州基本风压 w0=0.30 kN/m²）、GB 50011-2010《建筑抗震设计规范》（兰州 8 度抗震设防）。
> **兰州差异化：三城中唯一 8 度抗震设防区——支架节点/锚固、设备固定均须抗震校核与构造加强；冬季辐照中等（12 月倾斜 3.24），阵列 3.60 kWp、6 串单并，单台 SPF 5000 ES。**

## 1. 设计输入

| 输入 | 取值 | 来源 |
|---|---|---|
| 组件 | 隆基 LR7-72HGD-600M（1134×2382 mm，约 32 kg/块） | W5 |
| 串并联 | 6 串×1 并 = 3.60 kWp（6 块组件） | W5 |
| 设计倾角 / 朝向 | **30° / 正南** | W2 倾角核算 |
| 排间节距系数 | **2.51 × L**（冬至 9:00 校核，h=16.9°） | W2 |
| 逆变器 | Growatt SPF 5000 ES（330×135×485 mm / 12 kg） | W6 |
| 蓄电池 | 5×Benhoo BNP-5120BM（19" 机架式，约 442×420×161 mm/台，电池柜装） | W4 |
| 屋面假设 | 兰州普通住宅混凝土平屋面，南向可用安装区约 7 m（东西）× 6 m（南北） | 课程设计假设 |
| 设备间假设 | 3.0 m × 2.5 m（约 7.5 m²），靠外墙、干燥、**保温（≥10 ℃）** | 课程设计假设 |
| 基本风压 w0 | 0.30 kN/m²（兰州，50 年一遇） | GB 50009-2012 |
| 抗震设防 | **8 度（0.20g），多遇地震 αmax=0.16** | GB 50011-2010 |
| 极端最低温 | -23.1 ℃ | W2 |

## 2. 光伏阵列布置（指导书 §9.1）

**布局选定：单排 6 块竖排（1 行 × 6 列），正南 30° 固定支架。**

| 项目 | 数值 | 说明 |
|---|---|---|
| 阵列东西向长度 | 6 × 1.134 = **6.80 m** | 单排竖排 |
| 阵列南北向（斜面长 / 水平投影） | 2.382 m / **2.06 m** | 30° 倾角投影（2.382×cos30°） |
| 前沿安装高度 | 0.50 m | 利于通风散热与排水 |
| 后沿高度 | 0.50 + 1.19 = **1.69 m** | 高差 2.382×sin30°=1.19 m |
| 距南檐口 | ≥ 1.0 m | 维护通道 + 檐口安全 |
| 距东西侧边 | ≥ 0.5 m | 施工与检修 |
| 距北侧 | ≥ 0.6 m | 排水与通道 |
| 阵列总占地（含通道） | 约 7.8 m × 3.2 m | 南向安装区内（7×6 m）✅ |

**排间节距校核**（本方案单排无前后排遮挡；若日后扩建第二排，按 W2 倾角核算结果）：
$$D = L\cos\beta + \frac{L\sin\beta}{\tan\alpha_s} = 2.382\times\cos30°+\frac{2.382\times\sin30°}{\tan16.9°}=\mathbf{5.98\ m}\ (≈2.51\times L，W2 取 2.51\times L)$$

> 校核时刻：冬至日 9:00（太阳时）h=16.9°（W2 已算）。兰州 D≈5.98 m，大于拉萨（5.07 m）、远大于深圳（1.84 m）——纬度更高、冬季太阳更低。本方案单排布置无需排距，但保留该值为扩排依据。

**屋面其他要求**：阵列不遮挡屋面排水天沟与检修口；阵列下方留 30 mm 通风间隙；组件边框与支架可靠接地（W7 §5）。直流线缆沿支架/桥架引至南侧女儿墙穿屋面入设备间（W7 C2 回路 15 m 假设与此一致）。**兰州干燥少雨、冬春多浮尘：组件倾角 30° 利于自清洁，运行说明中缩短清扫周期（W6 §4）。**

## 3. 支架初步校核（指导书 §9.2，含 8 度抗震）

**支架形式**：铝合金固定支架（立柱式），立柱 + 主横担 + 压块 + 锚固（化学锚栓/膨胀螺栓入屋面结构层）。组件 6 块竖排，每块由 2 根沿坡向导轨支撑。**8 度抗震区：锚固螺栓加密（每立柱 ≥2 颗 M10 化学锚栓）、立柱与导轨连接件加强、支架节点采用抗震构造（GB 50011）。**

**荷载**（GB 50009-2012）：
- 风压标准值：$w_k=\beta_{gz}\cdot\mu_s\cdot\mu_z\cdot w_0=1.6\times1.3\times1.0\times0.30=\mathbf{0.62\ kN/m^2}$
- 自重：组件约 32 kg/块（0.314 kN），6 块共 1.88 kN；支架自重约 0.4 kN
- 兰州无雪荷载（w0s≈0），不组合雪载
- **水平地震作用（8 度多遇，αmax=0.16）**：单块组件地震力 F_EK=αmax×G=0.16×0.314≈**0.05 kN**，远小于风载（0.31 kN/半块宽度）——强度不控制，但**构造要求（锚固、节点、防倾倒）必须满足**，作为兰州差异化答辩点

**简支梁校核**（取 1 根沿坡向导轨，跨度 Lb=1.2 m，两端简支于立柱；竖排组件坡长 2.382 m，每块 2 根导轨）：
- 自重线荷载 g = 0.314/2/2.382 ≈ **0.066 kN/m**（竖排坡长 2.382 m）
- 风载线荷载（标准值）q_w = 0.62×0.567 ≈ **0.35 kN/m**（每根导轨受风宽度半块 0.567 m）
- 承载能力组合 q = 1.2g + 1.4q_w = **0.57 kN/m**
- $$M_{max}=\frac{w L_b^2}{8}=\frac{0.57\times1.2^2}{8}=\mathbf{0.103\ kN\cdot m}$$
- 截面（铝导轨 6063-T5，典型截面 W=10.4 cm³、I=44.9 cm⁴、E=70 GPa）：
$$\sigma_{max}=\frac{M_{max}}{W}=\frac{103}{10.4\times10^{-6}}=\mathbf{9.9\ MPa}\le 85\ MPa\ ✅$$
- 挠度（标准值 q=0.42 kN/m）：$$f_{max}=\frac{5wL_b^4}{384EI}=\mathbf{0.36\ mm}\le \frac{L_b}{200}=6\ mm\ ✅$$

> 说明：兰州风压/自重组合应力 9.9 MPa，远小于深圳（24.3 MPa），强度裕量充足；**8 度抗震由构造控制而非强度控制**（锚固加密、节点加强、防倾倒），与深圳/拉萨/哈尔滨形成差异化。课程设计为简化简支梁初核；实际工程需按现行规范由专业人员复核屋面承载、锚固、防水与极端气象荷载（指导书 §9.2 原文）。立柱/压块/锚固按厂家配套选型，W11 落实。

## 4. 设备间布置（指导书 §9.3）

**房间**：3.0 m × 2.5 m × 高 2.6 m，靠外墙、干燥、通风、非人员停留（物业用房/储物间改造，假设）。**兰州设备间保温（≥10 ℃）为必须（极端 -23.1 ℃），且 8 度抗震区设备固定须加强。**

| 设备 | 尺寸 | 布置 |
|---|---|---|
| 蓄电池电池柜 | 600×600×1200 mm（19" 机柜装 5 台 BNP-5120BM） | 靠北墙，柜后/侧留 ≥0.6 m 检修 |
| 离网逆变器（含 MPPT） | 330×135×485 mm | 壁挂于电池柜旁西墙，高 1.4~1.6 m |
| 交流配电箱 | 400×300×160 mm | 壁挂于东墙，与逆变器相邻 |
| 汇流/直流隔离箱 | 250×200×120 mm | 逆变器上方 |

**布置原则与尺寸**（对应 T1-03 图纸）：
- **大电流直流回路尽量短**：电池柜 → 逆变器距离 ≤2 m（W7 C4 回路 70 mm²、160 A）；
- **交/直流分区**：直流设备居左，交流配电居右，线缆桥架分上下两层/左右分隔敷设；
- **检修通道**：柜前/逆变器前方通道 ≥0.8 m，门宽 ≥0.8 m，门开启不碰设备；
- **抗震固定（8 度）**：电池柜、逆变器、配电箱、母排支架全部用锚栓固定于结构墙体/地面，柜体顶部加防倾倒连接，母排采用软连接吸收震动——GB 50011 构造要求（兰州差异化重点）；
- **保温**：墙体/吊顶/门保温（≥10 ℃），进风百叶冬季可关闭，必要时加低温加热器；
- **通风**：机械排风扇（≥2 次/h）+ 低位进风百叶（与保温平衡）；
- **接地**：沿墙敷设接地干线（-40×4 镀锌扁钢或 ≥25 mm² 铜），电池柜/逆变器/配电箱/SPD 接地端全部接入，等电位联结（W7 §5）；
- **消防与警示**：门侧配 4 kg ABC 干粉灭火器，逆变器/电池柜贴"高压危险/锂电设备"警示标识与紧急断电说明；
- **排水**：设备间内设地漏/防水，避免积水；电池柜垫高 ≥100 mm。

> 本方案设备间布置已满足指导书 §9.3「干燥、通风、便于检修、不妨碍疏散」及「蓄电池与逆变器大电流回路尽量短」要求；具体尺寸标注在 W9 T1-03 图中落实。

## 5. 红线自查

- [x] 支架校核给出构件材料、截面、荷载来源及强度/挠度判断（指导书 §9.2）；
- [x] 排间节距按冬至 9:00 校核（D=5.98 m，2.51×L），单排无遮挡（扩排保留）；
- [x] **8 度抗震**：支架锚固加密、设备固定构造加强、母排软连接，已纳入设计（兰州差异化）；
- [x] 设备间满足检修距离、通风、排水、交直流分区、接地、消防、警示、保温；
- [x] 组件数量/串并联与 W5 计算一致（6 块、6 串×1 并），未"先排布再改计算"（指导书 §9.1/任务书红线）；
- [x] 课程设计初核范围已声明（实际工程需专业复核）。

## 6. 回填状态与下一步

1. [x] 屋面/设备间尺寸与布置已由 **W9 T1-02（阵列及支架布置图）/ T1-03（设备间平面图）**落实，本文件为图纸布置依据；
2. 支架铝导轨截面（W=10.4 cm³、I=44.9 cm⁴）为典型规格，**W11 落实具体品牌/型号/价格**；
3. [x] 阵列到设备间线缆路径已在 T1-02 图中标注，W7 C2=15 m 长度假设回填定案；
4. 8 度抗震固定件与保温材料成本在 W11 落实。

## 7. 参考资料

1. GB 50009-2012《建筑结构荷载规范》（基本风压、风荷载组合）；
2. GB 50011-2010《建筑抗震设计规范》（8 度抗震构造）；
3. GB 50057-2010《建筑物防雷设计规范》、GB/T 32512-2016（接地/防雷，配合 W7）；
4. 设计指导书 §9.1/§9.2/§9.3（排距公式、简支梁初核公式、设备间要求）；
5. W2 倾角核算-兰州.md（排间节距 2.51×L、冬至 9:00 h=16.9°）；
6. W5 光伏阵列设计-兰州.md（组件尺寸 1134×2382 mm、串并联）。
