sunny1043/offgrid-pv-course-design/差异化城市设计/蓄电池设计-兰州.md

# 蓄电池设计 — 兰州（W4）

> 依据：设计指导书 §5（蓄电池容量和组合方式）、课程设计任务书 §4.3；输入来自 W1 负荷调查、W2 太阳能资源、W3 系统组成与能量损失口径。
> 状态：已完成（2026-09-03 完善至与深圳/拉萨同级详细度，覆盖 D5 检查点③交付要求；配套 Excel 计算文件 docs/计算-蓄电池-兰州.xlsx）。
> 兰州差异化：容量由「冬季电采暖负荷」驱动（E_AC=7.82 kWh/d，与拉萨/哈尔滨同设计点，高于深圳 6.99）；极端低温 -23.1 ℃（介于拉萨 -16.5 ℃ 与哈尔滨 -38.1 ℃ 之间）——**蓄电池设备间保温（不低于 10 ℃）为必须**，低温敏感性 K_T=0.70（不保温）介于拉萨与哈尔滨之间；**8 度抗震设防**影响电池柜/母排固定（W8）；方案 B（200 Ah）在本方案中因容量需求升高而**失效**（同拉萨/哈尔滨，与深圳相反）。

## 1. 设计输入（均来自已完成工作包，来源见各文档）

| 输入 | 取值 | 来源 |
|---|---|---|
| 交流侧日用电量 E_AC | **7.82 kWh/d**（冬季采暖季设计点） | W1 负荷调查-兰州.md |
| 逆变器效率 η_inv | 0.93 | W3（Growatt SPF 5000 ES 官方峰值效率，W6 确认） |
| 蓄电池放电效率 η_dis | 0.95 | W3 效率表 |
| 最大同时功率 P_max | 4.6 kW | W1（逆变器选型输入） |
| 短时冲击功率 P_short | 5.2 kW | W1（短时电流校核输入） |
| 设计城市 | 兰州 | 极端最低 -23.1 ℃；蓄电池置于保温设备间（不低于 10 ℃），低温修正 K_T=1.00（见 §3/§8 敏感性） |

## 2. 为什么采用 48 V 级系统（指导书 §5.1）

同深圳/拉萨：户用离网连续功率达数千瓦，48 V 级（磷酸铁锂 16 串，标称 51.2 V）可降低直流电流，与常见户用离网逆变器和磷酸铁锂模块匹配。兰州冬季 P_max=4.6 kW，直流电流需求较高，48 V 级更必要。

## 3. 最低标称能量（指导书 §5.2）

    E_bat,min = E_AC * N_A * K_R / (DOD * η_dis * η_inv * K_T)

| 系数 | 取值 | 取值依据 |
|---|---|---|
| N_A 自主供电天数 | **2 d** | 任务书基准设计；3 d 敏感性见 §7 |
| K_R 容量储备系数 | **1.10** | 指导书 §5.2 建议 1.05~1.10，取上限（含容量衰减余量） |
| DOD 允许放电深度 | **0.90** | 磷酸铁锂 + 智能 BMS，厂家允许深度循环（模块放电下限 44.8 V）；保守口径 0.80 见 §8 |
| η_dis 放电效率 | 0.95 | W3 效率表 |
| η_inv 逆变器效率 | 0.93 | W3（SPF 5000 ES 官方峰值效率） |
| K_T 低温修正 | **1.00** | 蓄电池置于保温设备间（不低于 10 ℃），磷酸铁锂低温容量损失可忽略；**无保温敏感性 K_T=0.70 见 §8** |

    E_bat,min = 7.82 * 2 * 1.10 / (0.90 * 0.95 * 0.93 * 1.00) = 21.64 kWh

按安时表示（51.2 V 标称）：

    C_bat,min = 1000 * E_bat,min / V_nom = 1000 * 21.64 / 51.2 = 422.6 Ah

> 口径说明（W3 §7）：E_AC 为交流侧日用电量，公式内部已含 η_inv，不再重复除以逆变器效率；各损失只计一次。
> 与深圳对比：E_bat,min 由 19.34 升至 **21.64 kWh**（+12%），源于冬季电采暖把 E_AC 从 6.99 提到 7.82——拉萨/兰州/哈尔滨三城同值。

## 4. 模块选型与串并联（指导书 §5.3）

完整 51.2 V 磷酸铁锂模块内部为 16 个 3.2 V 单体串联并配置 BMS。系统层面 N_S = 1（完整模块未经厂家明确允许不得继续串联——任务书红线）。

### 方案 A（推荐）— 本宁 Benhoo BNP-5120BM × 5

| 参数 | 数值 | 来源 |
|---|---|---|
| 型号 | BNP-5120BM（51.2 V 100 Ah 机架式磷酸铁锂） | [Benhoo 官网产品页](https://www.benhoobattery.com/cn/products/energy-storage-batteries/residential-solar-storage-batteries/battery-module-zh-cn-1)（查询日期 2026-09-01） |
| 标称电压 / 容量 / 能量 | 51.2 V / 100 Ah / **5.12 kWh** | 同上 |
| 充放电电压范围 | 44.8 ~ 57.6 V | 同上 |
| 标准 / 最大充电电流 | 20 A / **50 A** | 同上 |
| 标准 / 最大放电电流 | 50 A / **100 A** | 同上 |
| 通信 / BMS | RS485、CAN；智能 BMS | 同上 |
| 允许并联 | 厂家标注可大量并联（本设计仅 5 台，远低于上限） | 同上 |
| 参考价 | 约 ¥3,500–5,000/台（同类 51.2 V 100 Ah 机架式 B2B 区间） | [Alibaba 同类产品页](https://www.alibaba.com/product-detail/KUVO-High-Quality-Rack-Mounted-LiFePO4_1601623844855.html) |

- E_mod = 51.2 × 100 / 1000 = **5.12 kWh**；N_P,E = ceil(21.64 / 5.12) = **5**
- 实际配置：**5 台并联（N_S=1），总标称能量 25.60 kWh**，为下限计算值的 **1.18 倍**（≤1.25 倍上限 ✅）

### 方案 B（200 Ah，本方案不成立）— 51.2 V 200 Ah 机架式模块

| 项目 | 数值 | 结论 |
|---|---|---|
| 单模块能量 | 10.24 kWh（51.2 V × 200 Ah） | — |
| 2 台并联 | 20.48 kWh | 低于下限 21.64 kWh，**容量不足** ✗ |
| 3 台并联 | 30.72 kWh | 为下限的 1.42 倍，**超过 1.25 倍上限** ✗ |

> **差异化结论（答辩点）**：在深圳（下限 19.34 kWh），方案 B 用 2 台 10.24 kWh = 20.48 kWh 恰好满足（1.06 倍）；在兰州（同拉萨/哈尔滨），冬季电采暖把容量下限抬到 21.64 kWh，200 Ah 方案出现「2 台不够、3 台超上限」的夹逼困境，因此**本方案仅方案 A（100 Ah × 5）可行**。城市负荷差异直接影响蓄电池组合。

## 5. 放电与充电电流校核（指导书 §5.4）

逆变器沿用 **Growatt SPF 5000 ES**（额定 5 kW、η_inv=0.93，W6 确认），V_bat,min = 45 V（与模块放电下限 44.8 V 一致；逆变器低压切断须设置 ≥44.8 V）：

连续放电电流：I_dis = P_inv,r / (V_bat,min × η_inv) = 5000 / (45 × 0.93) = **119.5 A**

短时放电电流（P_short = 5.2 kW）：I_dis,sur = 5200 / (45 × 0.93) = **124.3 A**

最大充电电流（光伏容量 P_PV=3.60 kWp，W5 定案；η_MPPT=0.96；充电电压 54.4 V；第二项为 MPPT 控制器输出限流 100 A）：

    I_chg = min( P_PV × η_MPPT / V_bat,chg , I_ctrl,out,max )
          = min( 3600 × 0.96 / 54.4 , 100 ) = 63.5 A

| 校核项 | 需求值 | 方案 A 能力（5×BNP-5120BM） | 结论 |
|---|---|---|---|
| 连续放电 | 119.5 A | 5 × 100 A = 500 A | ✅ 裕量 4.2× |
| 短时放电 | 124.3 A | 峰值 5 × 100 A = 500 A | ✅ |
| 最大充电 | 63.5 A | 5 × 50 A = 250 A | ✅ 裕量 3.9× |

并联数量：N_P = max(N_P,E, N_P,dis, N_P,chg) = max(5, 2, 1) = **5**——本设计由能量需求控制。

> 注意：不能把光伏侧短路电流当作蓄电池充电电流（MPPT 输入侧高压小电流、输出侧低压大电流，指导书 §7.1 警告；任务书红线）。
> 与深圳对比：I_chg 由 42.4 A 升至 **63.5 A**（兰州阵列 3.60 kWp 大于深圳 2.40 kWp）；I_dis,sur 由 86.0 A 升至 **124.3 A**（冬季 P_short=5.2 kW 高于深圳 3.6 kW）。

## 6. BMS 与并联限制（指导书 §5.4 末）

- 每台 BNP-5120BM 内置智能 BMS（16S 采集、均衡、过充/过放/过流/短路保护），通信 RS485/CAN；
- 并联数量 5 台远低于厂家标注上限，支路采用等长、等截面线缆或对称母排连接；
- **兰州低温注意事项（差异化）**：极端最低 -23.1 ℃，磷酸铁锂在 0 ℃ 以下充电受 BMS 低温保护限制——设备间须保温（不低于 10 ℃）或配低温加热，保证冬季夜间电采暖负荷放电后次日白天能正常充电（必要性介于拉萨与哈尔滨之间）；
- **兰州抗震注意事项（差异化）**：兰州为 **8 度抗震设防区**，电池柜/母排/设备须按抗震要求固定（W8 落实），防止地震时电池倾倒与连接松动；
- BMS 与逆变器协议匹配（CAN/RS485）在 W6 选型后回填确认。

## 7. 2 d 基准与 3 d 敏感性对比（指导书 §5.5）

| 项目 | 2 d（基准） | 3 d（敏感性） | 说明 |
|---|---|---|---|
| 最低标称能量 | 21.64 kWh | **32.45 kWh** | 能量比值 = 1.50（理论 3/2） |
| 方案 A（100 Ah） | 5 台 / 25.60 kWh | 7 台 / 35.84 kWh | 32.45/5.12=6.34 取整 7 台 |
| 方案 B（200 Ah） | 不可行（见 §4） | 不可行（3 台 30.72<32.45；4 台超上限） | 夹逼困境更明显 |

> 3 d 方案用于观察自主供电时间提高 50% 带来的成本变化（方案 A 多买 2 台），不采用 3 d 作为最终配置（答辩常问点）。

## 8. 保守口径与低温敏感性复核（差异化重点）

**保守口径（DOD = 0.80）**：

    E_bat,min = 7.82 * 2 * 1.10 / (0.80 * 0.95 * 0.93 * 1.00) = 24.34 kWh  ->  方案 A 需 5 台（25.60 kWh）

本设计采用 DOD = 0.90（智能 BMS 管理下厂家允许值，模块放电下限 44.8 V 提供安全边界）。

**低温敏感性（设备间不保温，最低约 0 ℃，LFP 可用容量约 70%）**：

    K_T = 0.70  ->  E_bat,min = 17.204 / (0.90 × 0.95 × 0.93 × 0.70) = 30.91 kWh  ->  方案 A 需 7 台（35.84 kWh）

> **结论**：若不设保温设备间，兰州冬季低温（-23.1 ℃）会使蓄电池需求从 21.64 增至 30.91 kWh（+43%），多买 2 台（多约 0.7~1.0 万元）。因此**设备间保温（不低于 10 ℃）是兰州方案的经济性关键**——与拉萨同理，但兰州极端低温更低，保温要求更刚性（仅次于哈尔滨的保温+加热）。

## 9. 输出汇总（指导书 表3 样式）

| 项目 | 计算或选定结果 | 产品允许值 | 结论 |
|---|---|---|---|
| 最低标称能量 | 21.64 kWh | — | — |
| 模块型号及单模块能量 | Benhoo BNP-5120BM，5.12 kWh | — | — |
| 串联数量 / 并联数量 | N_S = 1（完整模块不串联）；N_P = 5 | 1；并联远低于厂家上限 | ✅ |
| 实际标称能量 | 25.60 kWh | ≤ 1.25 × 21.64 = 27.05 kWh | ✅（1.18×） |
| 连续放电电流 | 119.5 A | 5 × 100 A = 500 A | ✅ |
| 短时放电电流 | 124.3 A | 峰值 500 A | ✅ |
| 最大充电电流 | 63.5 A（W5 定案 P_PV=3.60 kWp） | 5 × 50 A = 250 A | ✅ |
| BMS 和并联限制 | 智能 BMS（RS485/CAN），并联 5 台 | 远低于上限 | ✅ |
| 设备间保温 | 不低于 10 ℃（低温充电/容量，必须） | — | 设计决策（§6/§8） |

## 10. 成本对比（模块级；W11 详算含 BMS/柜体/母排/安装）

| 方案 | 配置 | 模块单价参考 | 模块小计 | 特点 |
|---|---|---|---|---|
| A（推荐） | 51.2 V 100 Ah × 5 | 约 ¥3,500–5,000 | 约 ¥17,500–25,000 | 电流裕量大（500 A）、粒度细、参数全可查 |
| B | 51.2 V 200 Ah | — | 不成立 | 2 台不足、3 台超 1.25 倍上限（§4） |

> 结论：选用方案 A（5 台）。深圳方案（4 台）在兰州因冬季负荷升高需**多 1 台电池**，且 200 Ah 方案失效——城市差异直接体现在 BOM 与成本上（同拉萨）。

## 11. 红线自查（任务书 §九 / 考核标准 §五）

- [x] 未将完整 51.2 V 模块违规串联（N_S = 1）；
- [x] 未把光伏侧电流当充电电流（I_chg 按 MPPT 输出侧功率/电压计算）；
- [x] 蓄电池电流按 48 V 侧电压（V_bat,min=45 V）计算，未误用 220 V；
- [x] E_AC 不重复除以 η_inv（口径与 W3 一致）；
- [x] 效率只计一次（η_dis、η_inv 各用一次）；
- [x] 实际能量 25.60 kWh 未超下限 1.25 倍（1.18×）。

## 12. 回填状态与下一步

1. [x] ~~W5 光伏阵列设计回填 P_PV~~（已定案 3.60 kWp，I_chg=63.5 A）；
2. [x] ~~W6 逆变器/MPPT 选型回填~~（SPF 5000 ES：P_inv,r=5 kW、η_inv=0.93、I_ctrl,out,max=100 A，均已确认）；
3. [x] **8 度抗震**对电池柜/母排/设备固定的要求（W8 已落实，T1-03 图纸已表达）；
4. 设备间保温（≥10 ℃）已作为设计前提写入 W8；保温材料/电伴热成本待 W11 落实；
5. 三张图纸（T1-01/02/03）型号、串并联与 W4/W5 已核对一致；与兰州设备清单的一致性留待 W11 BOM + W12 表10 复核。
