sunny1043/offgrid-pv-course-design/差异化城市设计/拉萨-D1至D5成果汇总.md

# 拉萨课程设计 D1–D5 成果汇总

> 设计城市：**拉萨**（29.66°N、91.14°E，海拔约 3650 m）｜户用离网光伏发电系统（48 V 级磷酸铁锂、220 V/50 Hz 单相、2 d 自主供电）。
> 本文件按课程设计时间线 **D1–D5**（任务书 §八）汇总拉萨差异化设计成果，作为各日检查点（①–④）的集中交付说明；详细计算与产品参数见对应原始文档与 Excel 计算文件。
> 汇总日期：2026-09-03。

---

## D1（周一）— 任务理解、确定城市与负荷区间（检查点①）

| 项目 | 拉萨取值 |
|---|---|
| 设计城市 | **拉萨**——与仓库基线（深圳·夏季空调型）完全相反：**高原温带半干旱季风气候，冬季寒冷（-16.5~0.9 ℃）、夏季凉爽（最热月均温仅约 13 ℃）**，高负荷由**冬季电采暖**承担 |
| 负荷区间 | **E_AC = 7.82 kWh/d（冬季采暖季设计点）**，对应任务书区间 **7.5~8.0 kWh/d（学号末位 4/5）**；如分配区间不同可按电暖器运行时间微调 |
| 差异化主线 | 季节负荷逻辑反转：深圳「夏季空调驱动」→ 拉萨「**冬季电采暖驱动**」；数据源与计算口径与深圳完全一致（NASA POWER 2019–2023 五年平均 + Liu-Jordan + 指导书/任务书公式），仅城市输入不同 |
| 资料计划 | 负荷→资源→系统组成→蓄电池→光伏→控制器→线缆/支架→图纸→实验→成本→报告（W1–W12）；产品资料查询日期 2026-09-01 |

## D2（周二）— 负荷调查与 24 h 运行表（检查点②，W1）

- **负荷结构（冬季口径）**：基础负荷 3.62 kWh/d + **冬季采暖 4.20 kWh/d**（双人电热毯 150 W×8 h=1.20 + 对流式电暖器 1.2 kW×5 h×0.5=3.00）；夏季仅午后轻空调（6–8 月 E_AC=4.97 kWh/d）。
- **交流侧日用电量 E_AC = 7.82 kWh/d**（冬季设计点，区间内 ✅）；过渡月 4.82、温和月 3.62、夏季 4.97 kWh/d（供逐月复核用）。
- **最大同时功率 P_max ≈ 4.6 kW**：冬季 19:00–19:15 烧水时段（电暖器+电热毯+水壶+电饭煲+油烟机+照明+电视+冰箱+路由）；明显高于深圳的 3.0 kW。
- **短时冲击功率 P_short ≈ 5.2 kW**：冬季峰值 + 冰箱压缩机启动（4.6+0.6）；电暖/电热毯/水壶为阻性负载无冲击。
- **24 h 运行表**（冬季工作日）已建立：深夜电热毯 0.32 kW → 18:00–23:00 电暖器+电热毯高负荷段 → 19:00–19:15 峰值 4.61 kW；电磁炉安排在周末午餐错峰。
- **分类对照**：照明 0.38 / 通信 0.97 / 炊事 1.15 / 生活辅助 0.57 全在建议范围；「制冷空调」类别仅 0.54（拉萨最热月均温 13 ℃ 无需空调，其位置由冬季采暖 4.20 承接——答辩重点，指导书 §2.1 不机械取中值）。

## D3（周三）— 太阳能资源与温度数据（检查点②，W2）

- **逐月水平面辐照（NASA POWER 5 年平均，kWh/m²·d）**：12 月最低 4.23，6 月最高 6.74，年约 **1988 kWh/m²·yr（全国顶级「日光城」）**——逐月非常平坦，冬季辐照仍高于深圳年均。
- **月均温**：1 月最低 -5.2 ℃、6 月最高 12.9 ℃；年较差小（约 18 ℃）、日较差大（12~15 ℃，高原气候）。
- **最不利设计月 = 12 月**（R=E_AC/H=1.85 最大）：采暖负荷最高（7.82）+ 冬季辐照全年最低（4.23）——**负荷驱动**而非辐照塌陷；忽略采暖只看辐照会误选 5–6 月（与深圳示例误区相反）。
- **倾角核算（Liu-Jordan）**：候选倾角 15°~45° 逐月对比，**设计倾角 30°、正南**（最不利月 12 月供能最大 4.74，较水平面 +12.1%；全年总量 2141 kWh/m²·yr 几乎不损）。**排间节距 D=2.13×L**（冬至 9:00 αs=21.5°；比深圳 1.62×L 大 31%）。
- **温度参数**：极端最低 **-16.5 ℃**（低温 Voc 校核）、极端最高 29.4 ℃（组件最高约 60.7 ℃，远低于深圳 70 ℃——高原夏季凉爽是优势）；峰值日照时数：水平 4.23、倾斜 30° = **4.74 h/d**。

## D4（周四）— 系统组成与主要设计参数（W3）

- **系统组成**：光伏方阵→直流保护→MPPT 控制器→蓄电池及 BMS→离网逆变器→交流配电→负荷（三个电气位置分清：光伏输入侧 / 48 V 电池侧 / 220 V 交流侧，同一功率不同电压电流不同）。
- **能量与功率口径**：E_AC=7.82 kWh/d（容量设计输入）；P_max=4.6 kW（逆变器额定）；P_short=5.2 kW（短时校核）——三者不能互相代替。
- **效率表（W6 已回填）**：η_cable_dc=0.98、η_ctrl=0.96、η_batt_ch/dis=0.95、**η_inv=0.93**（Growatt SPF 5000 ES 官方峰值）、η_cable_ac=0.99 → **综合路径效率 η_path ≈ 0.782**。
- **24 h 能量平衡（冬季）**：白天光伏经 MPPT 供负荷+充电（拉萨晴空辐照强，冬季充电充分）；傍晚/夜间电采暖高峰由光伏+电池共同供电；深夜电热毯由电池支撑。夏季 5–9 月供能比 2.8~4.4，电池充满后弃光（冬紧夏松，与深圳相反）。
- **口径声明**：E_AC 为交流侧、蓄电池公式已含 η_inv 不重复除；阵列容量用 η_path；全文统一参数。

## D5（周五）— 蓄电池容量初算与模块候选（检查点③，W4）

- **最低标称能量**：E_bat,min = 7.82×2×1.10/(0.90×0.95×0.93×1.00) = **21.64 kWh**（≈422.6 Ah @51.2 V）——较深圳 19.34 高 12%（冬季负荷更高）。
- **方案 A（推荐）— Benhoo BNP-5120BM（51.2 V/100 Ah/5.12 kWh）×5 并联（N_S=1）** = 25.60 kWh（下限 1.18 倍 ≤1.25 ✅）。
- **方案 B（200 Ah）失效**：2 台 20.48 kWh 不足、3 台 30.72 kWh 超 1.25 倍上限——深圳可行、拉萨不可行（城市负荷差异直接影响组合）。
- **电流初校**（拟沿用 Growatt SPF 5000 ES，P_inv,r=5 kW、η_inv=0.93、V_bat,min=45 V）：连续放电 119.5 A ≤ 5×100 A；短时（P_short=5.2 kW）124.3 A ≤ 峰值 500 A；最大充电 ≈52.9 A（P_PV=3.00 kWp 预填，≤5×50 A）。N_P = max(5,2,1) = **5**（能量控制）。
- **低温敏感性（差异化重点）**：蓄电池置于保温设备间（≥10 ℃）K_T=1.00；若不保温（约 0 ℃，LFP 可用容量 70%）K_T=0.70 → E_bat,min=30.91 kWh（+43%），需 7 台——**设备间保温是拉萨经济性关键**（深圳无需论证）。
- **红线自查**：N_S=1 不串联完整模块；未把光伏侧电流当充电电流；电流按 45 V 计算；E_AC 不重复除 η_inv；实际能量未超 1.25 倍 ✅。

---

## 成果对照（D1–D5 → 检查点与原始文件）

| 日 | 成果 | 检查点 | 原始文档/文件 |
|----|---|---|---|
| D1 | 任务理解、城市、负荷区间、资料计划 | ① | 本汇总 §D1、`拉萨设计总览.md` |
| D2 | 负荷清单、E_AC、24 h 表、P_max/P_short | ② | `负荷调查-拉萨.md` |
| D3 | 逐月辐照/温度、最不利月 12 月、倾角 30°、排距 2.13×L | ② | `太阳能资源-拉萨.md`、`倾角核算-拉萨.md` |
| D4 | 系统组成、能量/效率口径、24 h 能量平衡 | — | `系统组成与能量损失-拉萨.md` |
| D5 | 蓄电池 E_bat,min=21.64 kWh、方案 A ×5、方案 B 失效、K_T 敏感性 | ③④ | `蓄电池设计-拉萨.md`、`计算-蓄电池-拉萨.xlsx` |

## 数据一致性声明

- 全部数据单一来源（NASA POWER 2019–2023 五年平均 + Liu-Jordan + 指导书/任务书公式），口径与深圳基线一致；产品资料查询日期 2026-09-01。
- 拉萨为高寒高海拔城市，**低温（-16.5 ℃）**与**高海拔（3650 m）**引入深圳没有的校核（低温 Voc、电池低温充电、逆变器高原降额），在 D5 及后续 W5/W6 中落实。
- 下一步：D6–D8（W5 光伏阵列 / W6 控制器逆变器，拉萨 3.00 kWp / SPF 5000 ES 高原校核）；D9–D15（实验、图纸、成本、报告）。

*本汇总为拉萨差异化设计的集中说明，详细推导见各原始文档。*
