sunny1043/offgrid-pv-course-design/docs/光伏阵列设计-深圳.md

# 光伏阵列设计 — 深圳（W5）

> 依据：设计指导书 §6（光伏阵列容量和串并联设计）、课程设计任务书 §4.4；输入来自 W1 负荷调查、W2 太阳能资源/倾角核算、W3 效率口径、W4 蓄电池设计。
> 状态：已完成（W6 已确认控制器参数 450 V / MPPT 120~430 V / 22 A / 100 A，回填 W4 §5 充电电流复核通过，2026-09-03 复核）。
> 产品资料查询日期：2026-09-01。

## 1. 设计输入（均来自已完成工作包，来源见各文档）

| 输入 | 取值 | 来源 |
|---|---|---|
| 交流侧日用电量 E_AC | **6.99 kWh/d**（10 月空调月） | W1 负荷调查-深圳.md |
| 非空调月日用电量 E_AC（11–4 月） | 3.61 kWh/d | W1（W2 §3 已采用） |
| 最不利设计月 | **10 月** | W2 太阳能资源-深圳.md（R=1.63 最大） |
| 设计面峰值日照时数 H_T,min | **4.46 h/d**（20° 倾斜面，10 月） | W2 倾角核算-深圳.md |
| 综合路径效率 η_path | **0.782** | W3 系统组成与能量损失-深圳.md（W6 回填 η_inv=0.93 后更新） |
| 最低环境温度 T_min | **0.2 ℃** | W2（极端最低，低温 Voc 校核） |
| 最高组件温度 T_cell | **61 ℃（常态最热月）/ 70 ℃（极端）** | W2 §5（NOCT 公式） |
| 电池侧充电电压 V_bat,chg | 54.4 V | W4（充电上限 57.6 V 内典型值） |
| 电池侧充电电流上限 | 4 × 50 A = 200 A | W4 方案 A（BNP-5120BM ×4） |

## 2. 阵列容量（指导书 §6.1）

$$P_{PV,min}=\frac{E_{AC}\cdot K_{PV}}{H_{T,min}\cdot \eta_{path}}=\frac{6.99\times 1.10}{4.46\times 0.782}=\mathbf{2.20\ kWp}$$

| 系数 | 取值 | 取值依据 |
|---|---|---|
| K_PV 容量储备系数 | **1.10** | 考虑组件长期衰减（N 型 TOPCon 25 年功率质保约 87%+）、灰尘遮挡、失配与 MPPT 跟踪误差；与 W4 容量储备系数 K_R=1.10 取同口径（指导书 §6.1，各损失只计一次） |
| H_T,min | 4.46 h/d | 倾角 20°、正南，10 月倾斜面峰值日照时数（W2 倾角核算） |
| η_path | 0.782 | W3 综合路径效率（光伏→MPPT→电池→逆变器→交流负荷；W6 回填 η_inv=0.93 后更新） |

> 口径一致检查：K_PV=1.0 时 P_PV = 2.00 kWp；正式采用 K_PV=1.10 → 2.20 kWp。

## 3. 组件选型（真实产品）

| 参数 | 数值 | 来源 |
|---|---|---|
| 型号 | **隆基 Hi-MO 7 LR7-72HGD-600M**（N 型 TOPCon，单面 600 W） | [SolarProof 产品参数页](https://www.solarproof.com.au/products/LR7-72HGD-600MHi-MO7/)（查询日期 2026-09-01） |
| 额定功率 P_mpp | 600 W（STC） | 同上 |
| 开路电压 Voc（STC） | **52.22 V** | 同上 |
| 最大功率点电压 Vmp（STC） | **44.12 V** | 同上 |
| 短路电流 Isc（STC） | **14.49 A** | 同上 |
| 最大功率点电流 Impp（STC） | **13.60 A** | 同上 |
| NOCT | **45 ℃** | 同上 |
| Voc 温度系数 β_Voc | **−0.23 %/℃**（−0.0023/℃） | 同上 |
| Vmp 温度系数 β_Vmp | −0.28 %/℃（−0.0028/℃） | 按同系列 Pmax 温度系数（官方 −0.28%/℃）近似，最终以官方 datasheet 为准 |
| 尺寸 | 1134 × 2382 mm | 同上 |
| 最大串联熔断器 | 30 A | 同上 |

> 选型理由：N 型 TOPCon 为 2026 年户用主流，600 W 级组件数量少、BOS 成本低；参数完整、资料可检索。备用候选：晶澳 DeepBlue 4.0 Pro 615 W（同功率级，可替换）。

## 4. 组件温度修正（指导书 §6.2）

**低温开路电压**（T_min = 0.2 ℃）：
$$V_{oc,cold}=V_{oc,STC}\left[1+\beta_{Voc}(T_{min}-25)\right]=52.22\times\left[1+(-0.0023)(0.2-25)\right]=\mathbf{55.20\ V}$$

**高温最大功率点电压**：
- 常态最热月（T_cell = 61 ℃）：$V_{mp,hot}=44.12\times\left[1+(-0.0028)(61-25)\right]=\mathbf{39.67\ V}$
- 极端工况（T_cell = 70 ℃）：$V_{mp,hot}=44.12\times\left[1+(-0.0028)(70-25)\right]=\mathbf{38.56\ V}$

**低温最大功率点电压**（检查 MPPT 上限）：$V_{mp,cold}=44.12\times\left[1+(-0.0028)(0.2-25)\right]=\mathbf{47.18\ V}$

## 5. 串联数量（指导书 §6.3）

控制器按 W6 拟选 **Growatt SPF 5000 ES**（48 V 离网一体机，单 MPPT）初校：

| 控制器参数 | 取值 | 来源 |
|---|---|---|
| MPPT 工作电压范围 | **120 ~ 430 V** | [Growatt SPF 3500~5000 ES 官方 Datasheet](https://en.growatt.com/upload/file/SPF_3500-5000_ES_Lite_Datasheet_EN_202409.pdf)（2024-09，查询日期 2026-09-01，W6 确认） |
| 最大 PV 输入电压 | **450 V** | 同上（W6 官方确认，原暂定值一致） |
| 最大 PV 输入功率 | **6000 W（STC）** | 同上（W6 官方确认） |
| 每 MPPT 最大输入电流 | **22 A** | 同上（W6 官方确认，原暂按 15 A，更宽裕） |

$$N_{S,min}=\left\lceil\frac{V_{MPPT,min}}{V_{mp,hot}}\right\rceil=\left\lceil\frac{120}{38.56}\right\rceil=\mathbf{4}\qquad(70\,℃极端口径)$$

$$N_{S,max}=\left\lfloor\frac{V_{ctrl,max}}{V_{oc,cold}}\right\rfloor=\left\lfloor\frac{450}{55.20}\right\rfloor=\mathbf{8}$$

**可行范围：4 ≤ N_S ≤ 8**（N_S,min ≤ N_S,max ✅）

## 6. 并联数量与实际装机（指导书 §6.4）

| N_S | 单串功率(W) | N_P,PV = ⌈2240/(N_S·600)⌉ | 实际装机(kWp) | 是否可行 |
|-----|---|---|---|---|
| 4 | 2400 | 1 | **2.40** | ✅ 最小可行 |
| 5 | 3000 | 1 | 3.00 | ✅ 可行 |
| 6 | 3600 | 1 | 3.60 | ✅ 可行 |

**选定：N_S = 4、N_P = 1，实际装机 P_PV = 4 × 1 × 600 W = 2.40 kWp**（为最小需求 2.24 kWp 的 1.07 倍，余量适中）。

> 不选 5/6 串的原因：容量超出需求 34%/61%，增加组件与屋面占地，且 10 月后无需更大余量（逐月复核见 §8）；留 1 路 MPPT 空余便于日后扩容。若屋面布置需要（W8），N_S=5/6 仍在校核范围内。

## 7. 校核汇总（指导书 §6.4 + 表 4）

| 项目 | 计算结果 | 设备允许值 | 结论 |
|---|---|---|---|
| 最不利月所需容量 | 2.20 kWp | — | — |
| 组件型号和额定功率 | 隆基 LR7-72HGD-600M × 4 | — | — |
| 低温开路电压（组串） | 4 × 55.20 = **220.8 V** | ≤ 450 V（控制器最大输入） | ✅ |
| 低温开路电压（组串） | 220.8 V | ≤ 430 V（MPPT 电压上限） | ✅ |
| 高温最大功率点电压（组串） | 4 × 38.56 = **154.2 V**（70 ℃） | ≥ 120 V（MPPT 下限） | ✅ |
| 低温最大功率点电压（组串） | 4 × 47.18 = **188.7 V** | ≤ 430 V（MPPT 上限） | ✅ |
| 每串组件数量 | **4** | [4, 8] | ✅ |
| 并联组串数量 | **1** | — | ✅ |
| 阵列实际装机容量 | **2.40 kWp** | ≤ 6000 W（控制器最大输入功率） | ✅ |
| 阵列最大功率点电流 | 1 × 13.60 = **13.6 A** | ≤ 22 A（每 MPPT 输入电流，W6 官方确认） | ✅ |
| 阵列短路电流 | 1 × 14.49 = **14.49 A** | ≤ 22 A（每 MPPT 输入电流，W6 官方确认） | ✅ |
| 每路输入功率 | 2.40 kW | ≤ 6.0 kW | ✅ |

> 组串反向过流：N_P=1 时无并联组串间反向电流，单串最大串联熔断器 30 A 满足 Isc=14.49 A。

## 8. 逐月供能量复核（指导书 §6.1）

E_PV,m = P_PV × H_T,m × η_path，H_T,m 取倾角 20° 逐月倾斜面辐照（W2 倾角核算）：

| 月份 | 1 | 2 | 3 | 4 | 5 | 6 | 7 | 8 | 9 | **10** | 11 | 12 |
|---|---|---|---|---|---|---|---|---|---|---|----|----|
| H_T,m (kWh/m²·d) | 3.44 | 3.74 | 3.96 | 4.55 | 4.78 | 5.15 | 5.88 | 5.19 | 5.29 | 4.46 | 4.12 | 3.44 |
| E_PV,m (kWh/d) | 6.46 | 7.02 | 7.43 | 8.54 | 8.97 | 9.67 | 11.04 | 9.74 | 9.93 | **8.37** | 7.73 | 6.46 |
| E_AC,m (kWh/d) | 3.61 | 3.61 | 3.61 | 3.61 | 6.99 | 6.99 | 6.99 | 6.99 | 6.99 | **6.99** | 3.61 | 3.61 |
| 供能比 E_PV/E_AC | 1.79 | 1.94 | 2.06 | 2.37 | 1.28 | 1.38 | 1.58 | 1.39 | 1.42 | **1.20** | 2.14 | 1.79 |

> **12 个月全部满足 E_PV,m ≥ E_AC,m ✅**。最不利月 10 月供能比 1.20（余量 20%）；非空调月（11–4 月）余量充足。夏季（5–9 月）供能富余部分充入蓄电池/弃光，不依赖公共电网（指导书 §6.1 口径）。

## 9. 对 W4 的回填（数据一致性，任务书红线：三文件一致）

- W4 §5 充电电流按预估 P_PV=2.04 kWp 计算为 36 A；W5 定案 P_PV=**2.40 kWp** 后回填复核：
$$I_{chg}=\min\left(\frac{P_{PV}\cdot\eta_{MPPT}}{V_{bat,chg}},\ I_{ctrl,out,max}\right)=\min\left(\frac{2400\times0.96}{54.4},\ 100\right)=\mathbf{42.4\ A}\leq 4\times50=200\ A\ ✅$$
- 注：I_ctrl,out,max = 100 A 为暂定值（W6 控制器选型后回填），W4 §5 同栏同步更新。
- 2.4 kWp 对应逐月供能在 §8 已全部复核通过，W4 无需再改容量口径。

## 10. 待确认事项（W6/W8 回填）

1. ~~**Growatt SPF 5000 ES 官方 datasheet**~~（W6 已确认：最大 PV 输入电压 450 V、每 MPPT 输入电流 22 A、MPPT 120~430 V、最大光伏阵列功率 6000 W、最大太阳能充电电流 100 A，2026-09-01）；
2. 组件 Vmp 温度系数以官方 datasheet 为准（暂按 −0.28 %/℃）；
3. 屋面尺寸与安装面积（W8 阵列布置用：4 块组件 1134×2382 mm，单排 1 列，排间节距 1.62×L）；
4. 若 W6 选型结果改变 MPPT 电压范围，N_S 需重新校核（当前 4 串在校核范围内，替换同档控制器通常仍可行）。

## 11. 输出汇总（供 W6/W8/W11 使用）

| 结果 | 数值 |
|---|---|
| 组件 | 隆基 Hi-MO 7 LR7-72HGD-600M × 4 |
| 串并联 | **4 串 × 1 并**（N_S=4, N_P=1） |
| 实际装机容量 | **2.40 kWp** |
| 组串低温开路电压 | 220.8 V |
| 组串工作电压范围 | 154~189 V（高温~低温 MPPT 范围 120~430 V 内） |
| 阵列短路/工作电流 | 14.49 A / 13.6 A |
| 对应充电电流（回填 W4） | ≈42.4 A |
| 设计倾角/朝向 | 20° / 正南（W2 倾角核算） |
| 排间节距 | 1.62 × L（W8 布置用） |
