sunny1043/offgrid-pv-course-design/docs/控制器逆变器设计-深圳.md

# MPPT 控制器与离网逆变器设计 — 深圳（W6）

> 依据：设计指导书 §7（MPPT 控制器和离网逆变器）、课程设计任务书 §4.5；输入来自 W1 负荷调查（P_max=3.0 kW、P_short=3.6 kW）、W2 温度参数（T_min=0.2 ℃）、W4 蓄电池设计（48 V 级、4×BNP-5120BM、充电上限 57.6 V、V_bat,min=45 V）、W5 光伏阵列设计（4 串×1 并、2.40 kWp、组串 Voc,cold=220.8 V、Vmp 154~189 V）。
> 状态：已完成（W3/W4/W5 已同步回填；BMS 通信协议匹配等遗留项见 §6）。
> 产品资料：Growatt SPF 3500~5000 ES 官方 Datasheet（EN，2024-09），查询日期 2026-09-01。

## 0. 方案选择：Growatt SPF 5000 ES（离网一体机）

SPF 5000 ES 为 **MPPT 充电控制器 + 离网逆变器一体机**（Integrated MPPT charge controller），一台设备覆盖本工作包的两部分。选型理由：

- 额定功率 5000 VA/W ≥ 最大同时功率 P_max=3.0 kW（裕量 1.67，W4 §5 按 5 kW 级预校核一致）；
- 浪涌 10000 VA ≥ 短时冲击功率 P_short=3.6 kW（裕量 2.78）；
- 单相 230 V±5%、纯正弦波、50/60 Hz，满足任务书 220 V/50 Hz 要求；
- 48 VDC 电池、锂/铅酸双适配，磷酸铁锂充电模式可用；
- 参数完整、官方 Datasheet 可溯源；W4/W5 已按该机型参数预校核（见 §5 回填对照）。

## 1. 产品主要参数（官方 Datasheet 2024-09）

| 项目 | 参数 | 来源 |
|---|---|---|
| 型号 | Growatt SPF 5000 ES（离网一体机） | [Growatt 官方 Datasheet](https://en.growatt.com/upload/file/SPF_3500-5000_ES_Lite_Datasheet_EN_202409.pdf) |
| 额定功率 | 5000 VA / 5000 W | 同上 |
| 浪涌功率 | 10000 VA | 同上 |
| 峰值效率 | **93 %** | 同上 |
| 波形 / 转换时间 | 纯正弦波；10 ms 典型、20 ms 最大 | 同上 |
| 交流电压调节（电池模式） | 230 VAC ± 5 % @ 50/60 Hz | 同上 |
| 电池电压 / 类型 | 48 VDC；锂/铅酸 | 同上 |
| 最大光伏阵列功率 | 6000 W | 同上 |
| MPPT 范围 @ 工作电压 | 120 ~ 430 VDC | 同上（W5 预校核同值） |
| 独立 MPPT / 每跟踪器串数 | 1 / 1 | 同上 |
| 每 MPPT 最大输入电流 | **22 A** | 同上 |
| 最大光伏阵列开路电压 | **450 VDC** | 同上（W5 预校核同值） |
| 最大太阳能充电电流 | **100 A** | 同上（W4 预校核同值） |
| 交流充电器充电电流 | 80 A（本设计完全离网，不使用） | 同上 |
| 并联能力 | 最多 6 台（本设计 1 台） | 同上 |
| 防护 / 工作温度 / 海拔 | IP20；0~55 ℃；<2000 m | 同上 |
| 尺寸 / 重量 | 330×135×485 mm / 12 kg | 同上 |

> 说明：W5 中"待确认"的控制器参数（最大 PV 输入电压 450 V、MPPT 120~430 V、最大输入功率 6000 W、每路短路电流 15 A 暂定）已全部由官方 Datasheet 确认；**每 MPPT 输入电流实为 22 A**，较暂定 15 A 更宽裕。

## 2. 逆变器校核（指导书 §7.2）

| 校核项 | 需求值 | SPF 5000 ES | 结论 |
|---|---|---|---|
| 额定连续功率 | ≥ P_max = 3.0 kW（另加裕量） | 5.0 kW | ✅ 裕量 1.67 |
| 短时功率 | ≥ P_short = 3.6 kW | 10 kVA | ✅ 裕量 2.78 |
| 输出 | 单相 220 V / 50 Hz | 230 V±5 %、纯正弦波、50/60 Hz | ✅ |
| 电池输入 | 48 V 级（最低 45 V） | 48 VDC，锂/铅酸 | ✅ |
| 最低输入电压下直流电流 | I_dis = P_inv,r / (V_bat,min·η_inv) = 5000/(45×0.93) = **119.5 A** | 电池侧回路设计输入（W7） | — |
| 低压切断 | 应高于电池/BMS 保护下限 44.8 V | 程序 21 可设约 42~45.9 V（锂电模式），本设计设定 **45 V**（2026-09-03 确认） | ✅ |
| 最高允许输入电压 | 应高于电池充满最高电压 57.6 V | 48 V 系统上限充裕（锂电充满段正常充电） | ✅ |
| 峰值效率 | 回填 W3/W4 | **93 % → η_inv = 0.93** | 回填 |
| 环境降额 | 深圳设备间温度 <55 ℃、海拔 <2000 m | 0~55 ℃、<2000 m | ✅ |

**交流输出设计电流**（W7 输入）：I_ac = 5000/220 ≈ **22.7 A**（按 220 V 保守取，230 V 额定时为 21.7 A）。

> 浪涌说明：规格书给出 10000 VA 浪涌值但未标注持续时间，本系统最不利短时组合（周末炊事高峰 + 冰箱压缩机启动 ≈ 3.6 kW）远低于 10 kVA，水泵/压缩机启动为秒级，余量充分；答辩时按"功率与持续时间同时比较"口径说明（指导书 §7.2）。

## 3. MPPT 控制器校核（指导书 §7.1，光伏侧 ↔ 电池侧分别校核）

**光伏输入侧**（W5 组串参数，T_min=0.2 ℃ / T_cell 61 ℃、70 ℃）：

| 校核项 | 计算值 | 控制器允许值 | 结论 |
|---|---|---|---|
| 低温组串开路电压 | 4×55.20 = **220.8 V** | ≤ 450 V（最大 PV 输入电压） | ✅ |
| 组串工作电压（MPPT 范围） | Vmp 154.2~188.7 V（70 ℃~低温） | 120 ~ 430 V | ✅ |
| 每路最大功率点电流 | Imp = 13.6 A | ≤ 22 A（每 MPPT 输入电流） | ✅ |
| 每路短路电流 | Isc = 14.49 A | ≤ 22 A | ✅ |
| 每路输入功率 | 2.40 kW | ≤ 6.0 kW（最大光伏阵列功率） | ✅ |
| 组串数量可行性 | N_S=4 ∈ [4, 8] | 1 个 MPPT / 1 串 | ✅ |

**电池输出侧**：

| 校核项 | 计算值 | 允许值 | 结论 |
|---|---|---|---|
| 最大充电电流 | I_chg = min(P_PV·η_MPPT/V_bat,chg, I_ctrl,out,max) = min(2400×0.96/54.4, 100) = **42.4 A** | ≤ 100 A（控制器最大太阳能充电电流） | ✅ |
| 充电电流 vs 电池模块 | 42.4 A | ≤ 4×50 A = 200 A（W4 方案 A） | ✅ |
| 充电电压/曲线 | 磷酸铁锂模式，充电上限 57.6 V 设置与模块一致 | 锂电充电模式 | ✅ |
| BMS 通信 | BNP-5120BM：RS485/CAN | SPF 5000 ES：电池类型设 **LI**、程序 36 从协议库选择（RS485 协议 L01–L50 / CAN 协议 L51–L99，RS485 波特率 9600） | ✅ 可配置（§7） |

**红线自查**：光伏侧电流 13.6 A（高压小电流）与电池侧充电电流 42.4 A（低压大电流）为不同电气位置的电流，**未将光伏侧电流当作蓄电池充电电流**（任务书红线 ✅）；MPPT 两侧功率守恒：2.40 kW×0.96 ≈ 2.30 kW 充电功率，折算 54.4 V 下 ≈42.4 A，一致。

## 4. 对 W3/W4/W5 的回填（数据一致性，任务书红线：报告/图纸/BOM 一致）

选定机型后按 W3 §4「回填闭环」更新效率与参数，全部变化为**裕量增大方向**，不改变任何已定配置：

| 项目 | 原值 | 回填后 | 影响 |
|---|---|---|---|
| η_inv（逆变器效率） | 0.92（任务书示例） | **0.93**（规格书峰值） | W4 容量、电流重算 |
| η_ctrl（MPPT 效率） | 0.96（典型值） | 0.96（一体机未单独标注，保守维持） | 不变 |
| η_path（综合路径效率） | 0.77 | **0.782** | W5 容量、逐月复核重算 |
| 控制器参数 | 450 V / 120~430 V / 15 A（暂定） | **450 V / 120~430 V / 22 A**（官方确认） | 校核通过，裕量增大 |
| I_ctrl,out,max | 100 A（暂定） | **100 A**（官方确认） | W4 I_chg 不变 |

**W4 复核**：E_bat,min = 6.99×2×1.10/(0.90×0.95×0.93×1.00) = **19.34 kWh**（原 19.55）；C_bat,min ≈ **378 Ah**（原 382）；实际配置 4×BNP-5120BM = 20.48 kWh = 1.06×下限（≤1.25 ✅）；I_dis = **119.5 A**、I_dis,sur = **86.0 A**（原 120.8/87.0，均 ≤4×100 A ✅）；I_chg = 42.4 A（不变）；3 d 敏感性 29.01 kWh → 方案 A 6 台（不变）。

**W5 复核**：P_PV,min = 6.99×1.10/(4.46×0.782) = **2.20 kWp**（原 2.24）；选定 4 串×1 并 2.40 kWp（1.09×，≥需求 ✅）；逐月供能全部满足，最不利月 10 月供能比 **1.20**（原 1.18）。

## 5. 输出汇总（指导书 表 5 样式）

| 设备 | 主要计算需求 | 选定产品参数 | 复核结论 |
|---|---|---|---|
| MPPT 控制器（内置） | 输入电压 ≤450 V、MPPT 120~430 V、每路电流 ≤22 A、每路功率 ≤6 kW | Growatt SPF 5000 ES：450 V / 120~430 V / 22 A / 6 kW | ✅ 全部通过 |
| MPPT 控制器（电池侧） | 最大充电电流 ≤100 A、锂电充电曲线 | 最大太阳能充电电流 100 A；I_chg=42.4 A | ✅ |
| 离网逆变器 | 输入 48 V、连续 ≥3.0 kW、短时 ≥3.6 kW、220 V 单相 | 5 kW / 10 kVA / 230 V±5 % 纯正弦波 | ✅ |
| 蓄电池通信 | BMS 协议与充放电控制 | BNP-5120BM RS485/CAN ↔ SPF 锂电通信（LI + 程序 36 选协议，RS485 L01–L50 / CAN L51–L99，波特率 9600） | ✅ 可配置 |
| 交流输出 | 单相 220 V、50 Hz、纯正弦波 | 230 V±5 % @50/60 Hz | ✅ |

## 6. 待确认事项（W7/W11 回填）

1. ~~**BMS 通信协议匹配**~~（2026-09-03 已确认机制：SPF 5000 ES 电池类型设 **LI**、程序 36 从协议库选择——RS485 协议 L01–L50 / CAN 协议 L51–L99，RS485 波特率 9600；BNP-5120BM 提供 RS485/CAN 接口，据此选择对应协议即可建立通信。具体协议号按电池厂家 BMS 文档在程序 36 中核对，W11 前落实）；
2. ~~**低压切断设置值**~~（2026-09-03 已确认：程序 21 在锂电/User-Defined 模式可设低压关机点，手册与用户资料显示可设范围约 42~45.9 V；本设计设定 **45 V**——高于模块放电下限 44.8 V、避免 BMS 先触发，且与设计电流基准 V_bat,min=45 V 一致）；
3. **浪涌持续时间**：规格书未标注 10 kVA 持续时长，答辩按秒级启动校核口径说明；
4. **交流充电器**：80 A AC 充电器本设计完全离网不使用，不计入成本（W11 BOM 时注明）；
5. **W7 输入**：电池→逆变器回路按 I_dis=119.5 A、V_bat,min=45 V 计算；交流回路按 I_ac=22.7 A（220 V）计算；
6. **替代候选**：SPF 5000 ES Lite（MPPT 120~450 V、最大 PV 电压 500 V、输入电流 22 A，参数更宽裕）可作为同档备选，校核同样通过，若选用需同步更新 W5 组串校核表。

## 7. 参考资料

1. Growatt SPF 3500~5000 ES Datasheet（EN，2024-09）：https://en.growatt.com/upload/file/SPF_3500-5000_ES_Lite_Datasheet_EN_202409.pdf （查询日期 2026-09-01）
2. 经销商规格页（中文，参数核对）：https://www.sunergyworks.com/zh/sunergy%E4%BE%9B%E5%BA%94%E5%95%86%E7%A6%BB%E7%BD%91%E5%A4%AA%E9%98%B3%E8%83%BD%E9%80%86%E5%8F%98%E5%99%A8growatt-spf3000-5000es/
3. W5 预校核参数参考（solsol.eu，MPPT 120~430 V）：https://solsol.eu/de/growatt-spf5000es （与官方 Datasheet 一致）
