sunny1043/offgrid-pv-course-design/docs/支架设备间布置-深圳.md

# 光伏支架、屋面与设备间布置 — 深圳（W8）

> 依据：设计指导书 §9（光伏支架和设备布置）、课程设计任务书 §4.7；输入来自 W2 倾角核算（倾角 20°、排间节距 1.62×L）、W5 光伏阵列设计（隆基 LR7-72HGD-600M ×4、2.40 kWp、4 串×1 并）、W4 蓄电池设计（4×BNP-5120BM 机架式）、W6 逆变器选型（Growatt SPF 5000 ES，330×135×485 mm）、W7 线缆回路。
> 状态：完成（屋面/设备间尺寸为课程设计假设，W9 图纸落实后回填修正）。
> 荷载依据：GB 50009-2012《建筑结构荷载规范》（深圳基本风压 w0=0.75 kN/m²）。

## 1. 设计输入

| 输入 | 取值 | 来源 |
|---|---|---|
| 组件 | 隆基 LR7-72HGD-600M（1134×2382 mm，约 32 kg/块） | W5 |
| 串并联 | 4 串×1 并 = 2.40 kWp（4 块组件） | W5 |
| 设计倾角 / 朝向 | **20° / 正南** | W2 倾角核算 |
| 排间节距系数 | **1.62 × L**（冬至 9:00 校核，αs=26.5°） | W2 |
| 逆变器 | Growatt SPF 5000 ES（330×135×485 mm / 12 kg） | W6 |
| 蓄电池 | 4×Benhoo BNP-5120BM（19" 机架式，约 442×420×161 mm/台，电池柜装） | W4 |
| 屋面假设 | 深圳普通住宅混凝土平屋面，南向可用安装区约 12 m（东西）× 5 m（南北） | 课程设计假设（W1 §0） |
| 设备间假设 | 3.0 m × 2.5 m（约 7.5 m²），靠外墙、干燥、通风 | 课程设计假设 |
| 基本风压 w0 | 0.75 kN/m²（深圳，50 年一遇） | GB 50009-2012 |

## 2. 光伏阵列布置（指导书 §9.1）

**布局选定：单排 4 块横排（1 行 × 4 列），正南 20° 固定支架。**

| 项目 | 数值 | 说明 |
|---|---|---|
| 阵列东西向长度 | 4 × 2.382 = **9.53 m** | 单排横排 |
| 阵列南北向（斜面长 / 水平投影） | 1.134 m / **1.07 m** | 20° 倾角投影 |
| 前沿安装高度 | 0.50 m | 利于通风散热与排水 |
| 后沿高度 | 0.50 + 0.39 = **0.89 m** | 高差 1.134×sin20°=0.39 m |
| 距南檐口 | ≥ 1.0 m | 维护通道 + 檐口安全 |
| 距东西侧边 | ≥ 0.5 m | 施工与检修 |
| 距北侧 | ≥ 0.6 m | 排水与通道 |
| 阵列总占地（含通道） | 约 11.5 m × 3.5 m | 南向安装区内（12×5 m）✅ |

**排间节距校核**（本方案单排无前后排遮挡；若日后扩建第二排，按 W2 倾角核算结果）：
$$D = L\cos\beta + \frac{L\sin\beta}{\tan\alpha_s} = 1.134\times\cos20°+\frac{1.134\times\sin20°}{\tan26.5°}=\mathbf{1.84\ m}\ (≈1.63\times L，W2 取 1.62\times L)$$

> 校核时刻：冬至日 9:00（太阳时）αs=26.5°（W2 已算），深圳冬至无雪荷载。本方案单排布置无需排距，但保留该值为扩排依据。

**屋面其他要求**：阵列不遮挡屋面排水天沟与检修口；阵列下方留 30 mm 通风间隙；组件边框与支架可靠接地（W7 §5）。线缆路径：直流线缆沿支架/桥架引至南侧女儿墙穿屋面入设备间（W7 C2 回路 15 m 假设与此一致）。

## 3. 支架初步校核（指导书 §9.2）

**支架形式**：铝合金固定支架（立柱式），立柱 + 主横担 + 压块 + 锚固（化学锚栓/膨胀螺栓入屋面结构层）。组件 4 块横排，每块由 2 根沿坡向导轨支撑。

**荷载**（GB 50009-2012）：
- 风压标准值：$w_k=\beta_{gz}\cdot\mu_s\cdot\mu_z\cdot w_0=1.6\times1.3\times1.0\times0.75=\mathbf{1.56\ kN/m^2}$（βgz=1.6 阵风系数、μs=1.3 倾斜平板体型系数、μz=1.0 B 类地面 10 m）
- 自重：组件约 32 kg/块（0.314 kN），4 块共 1.26 kN；支架自重约 0.3 kN
- 深圳无雪荷载（w0s=0），不组合雪载

**简支梁校核**（取 1 根导轨，跨度 Lb=1.2 m，两端简支于立柱）：
- 自重线荷载 g = 0.314/2/1.134 ≈ **0.14 kN/m**（每块 2 根导轨）
- 风载线荷载（标准值）q_w = 1.56×0.567 ≈ **0.89 kN/m**（受风宽度半块 0.567 m）
- 承载能力组合 q = 1.2g + 1.4q_w = **1.40 kN/m**
- $$M_{max}=\frac{w L_b^2}{8}=\frac{1.40\times1.2^2}{8}=\mathbf{0.25\ kN\cdot m}$$
- 截面（**APAS P8-2080 工业铝型材，20×80 mm，6063-T5，1.91 kg/m；强轴 W=10.82 cm³、I=43.28 cm⁴**、E=70 GPa，选型手册：http://www.apastj.com/article/content/view?id=2930）：
$$\sigma_{max}=\frac{M_{max}}{W}=\frac{253}{10.82\times10^{-6}}=\mathbf{23.4\ MPa}\le 85\ MPa\ ✅$$
- 挠度（标准值 q=1.02 kN/m）：$$f_{max}=\frac{5wL_b^4}{384EI}=\frac{5\times1020\times1.2^4}{384\times70\times10^9\times43.28\times10^{-8}}=\mathbf{0.91\ mm}\le \frac{L_b}{200}=6\ mm\ ✅$$

> 说明：课程设计为简化简支梁初核；实际工程需按现行规范由专业人员复核屋面承载、锚固、防水与极端气象荷载（指导书 §9.2 原文）。立柱/压块/锚固按厂家配套选型，W11 落实。

## 4. 设备间布置（指导书 §9.3）

**房间**：3.0 m × 2.5 m × 高 2.6 m，靠外墙、干燥、通风、非人员停留（物业用房/储物间改造，假设）。

| 设备 | 尺寸 | 布置 |
|---|---|---|
| 蓄电池电池柜 | 600×600×1200 mm（19" 机柜装 4 台 BNP-5120BM） | 靠北墙，柜后/侧留 ≥0.6 m 检修 |
| 离网逆变器（含 MPPT） | 330×135×485 mm | 壁挂于电池柜旁西墙，高 1.4~1.6 m |
| 交流配电箱 | 400×300×160 mm | 壁挂于东墙，与逆变器相邻 |
| 汇流/直流隔离箱 | 250×200×120 mm | 逆变器上方 |

**布置原则与尺寸**（对应 T1-03 图纸）：
- **大电流直流回路尽量短**：电池柜 → 逆变器距离 ≤2 m（W7 C4 回路 70 mm²、160 A），避免散热与检修互相妨碍；
- **交/直流分区**：直流设备（电池柜、逆变器直流侧）居左，交流配电居右，线缆桥架分上下两层/左右分隔敷设（W7 交直流分区）；
- **检修通道**：柜前/逆变器前方通道 ≥0.8 m，门宽 ≥0.8 m，门开启不碰设备；
- **通风**：设备间设机械排风扇（≥2 次/h）+ 低位进风百叶，电池/逆变器避开高温热源与阳光直射；
- **接地**：沿墙敷设接地干线（-40×4 镀锌扁钢或 ≥25 mm² 铜），电池柜/逆变器/配电箱/SPD 接地端全部接入，等电位联结（W7 §5）；
- **消防与警示**：门侧配 4 kg ABC 干粉灭火器，逆变器/电池柜贴"高压危险/锂电设备"警示标识与紧急断电说明；
- **排水**：设备间内设地漏/防水，避免积水；电池柜垫高 ≥100 mm。

> 本方案设备间布置已满足指导书 §9.3「干燥、通风、便于检修、不妨碍疏散」及「蓄电池与逆变器大电流回路尽量短」要求；具体尺寸标注在 W9 T1-03 图中落实。

## 5. 红线自查

- [x] 支架校核给出构件材料、截面、荷载来源及强度/挠度判断（指导书 §9.2）；
- [x] 排间节距按冬至 9:00 校核，单排无遮挡（扩排保留 D=1.84 m）；
- [x] 设备间满足检修距离、通风、排水、交直流分区、接地、消防、警示；
- [x] 组件数量/串并联与 W5 计算一致（4 块、4 串×1 并），未"先排布再改计算"（指导书 §9.1/任务书红线）；
- [x] 课程设计初核范围已声明（实际工程需专业复核）。

## 6. 待回填 / 下一步

1. 屋面/设备间尺寸为假设，**W9 三张 A3 图纸**（T1-02 阵列及支架布置图、T1-03 设备间平面图）落实后回填修正；
2. ~~支架铝导轨截面落实品牌/型号~~（2026-09-03 已定：**APAS P8-2080**，20×80 mm、6063-T5、1.91 kg/m，强轴 W=10.82 cm³/I=43.28 cm⁴；价格 W11 落实）；
3. ~~阵列到设备间线缆路径（W7 C2 回路 15 m）~~（2026-09-03 已按本布置回填 W7 C2=15 m，与 T1-02 屋面路径一致）；
4. 设备间平面尺寸与设备间距在 T1-03 图中最终标注。

## 7. 参考资料

1. GB 50009-2012《建筑结构荷载规范》（基本风压、风荷载组合）；
2. GB 50057-2010《建筑物防雷设计规范》、GB/T 32512-2016（接地/防雷，配合 W7）；
3. 设计指导书 §9.1/§9.2/§9.3（排距公式、简支梁初核公式、设备间要求）；
4. W2 倾角核算-深圳.md（排间节距 1.62×L、冬至 9:00 αs=26.5°）；
5. W5 光伏阵列设计-深圳.md（组件尺寸 1134×2382 mm、串并联）。
6. APAS 工业铝型材选型手册（6063-T5 截面惯性矩/抗弯截面模量，P8-2080）：http://www.apastj.com/article/content/view?id=2930
