sunny1043/offgrid-pv-course-design/docs/蓄电池设计-深圳.md

# 蓄电池设计 — 深圳（W4）

> 依据：设计指导书 §5（蓄电池容量和组合方式）、课程设计任务书 §4.3；输入来自 W1 负荷调查、W2 太阳能资源、W3 系统组成与能量损失口径。
> 状态：已完成（模块选型基于真实产品资料，查询日期 2026-09-01；配套 Excel 计算文件 `docs/计算-蓄电池-深圳.xlsx`，公式可检查）。
> 说明：Excel 计算文件由脚本生成、未写入缓存计算值，请用 Excel/LibreOffice 打开以触发自动重算（打开后公式即显示结果，校核表结论列应全部为 OK）。

## 1. 设计输入（均来自已完成工作包，来源见各文档）

| 输入 | 取值 | 来源 |
|---|---|---|
| 交流侧日用电量 E_AC | **6.99 kWh/d** | W1 负荷调查-深圳.md |
| 逆变器效率 η_inv | 0.93 | W3 效率表（W6 已回填：Growatt SPF 5000 ES 官方峰值效率 93%） |
| 蓄电池放电效率 η_dis | 0.95 | W3 效率表（典型值，选型后回填） |
| 最大同时功率 P_max | 3.0 kW | W1（逆变器选型输入） |
| 短时冲击功率 P_sur | 3.6 kW | W1（短时电流校核输入） |
| 设计城市 | 深圳 | 最低温 0.2 ℃（对 LFP 容量无低温修正，K_T=1.0） |

## 2. 为什么采用 48 V 级系统（指导书 §5.1）

户用离网系统连续功率达数千瓦。若用 12 V 或 24 V 系统，同一功率下直流电流大，线缆截面、电压降、端子和保护器件要求随之提高。48 V 级（磷酸铁锂 16 串，标称 51.2 V）可降低直流电流，并与常见户用离网逆变器和磷酸铁锂模块匹配。本任务统一采用 48 V 级。

## 3. 最低标称能量（指导书 §5.2）

$$E_{bat,min}=\frac{E_{AC}\cdot N_A\cdot K_R}{DOD\cdot \eta_{dis}\cdot \eta_{inv}\cdot K_T}$$

| 系数 | 取值 | 取值依据 |
|---|---|---|
| N_A 自主供电天数 | **2 d** | 任务书基准设计；3 d 仅作敏感性分析 |
| K_R 容量储备系数 | **1.10** | 指导书 §5.2 建议 1.05~1.10，取上限（含容量衰减余量） |
| DOD 允许放电深度 | **0.90** | 磷酸铁锂 + 智能 BMS，厂家允许深度循环（模块放电下限 44.8 V，对应 16S 约 2.8 V/单体）；保守口径 0.80 见 §8 |
| η_dis 放电效率 | 0.95 | W3 效率表 |
| η_inv 逆变器效率 | 0.93 | W3 效率表（W6 回填：SPF 5000 ES 官方峰值效率） |
| K_T 低温修正 | **1.00** | 深圳历史极端最低 0.2 ℃，磷酸铁锂低温容量损失可忽略（W2） |

$$E_{bat,min}=\frac{6.99\times 2\times 1.10}{0.90\times 0.95\times 0.93\times 1.00}=\mathbf{19.34\ kWh}$$

按安时表示（51.2 V 标称）：

$$C_{bat,min}=\frac{1000\times E_{bat,min}}{V_{nom}}=\frac{1000\times 19.34}{51.2}=\mathbf{378\ Ah}$$

> 口径说明（W3 §7 声明）：E_AC 为交流侧日用电量，公式内部已含 η_inv，**不再重复除以逆变器效率**；各损失只计一次。

## 4. 模块选型与串并联（指导书 §5.3）

完整 51.2 V 磷酸铁锂模块内部为 16 个 3.2 V 单体串联并配置 BMS。对 48 V 级系统，系统层面 **N_S = 1**——完整模块未经厂家明确允许不得继续串联（任务书红线）。

单模块标称能量：$E_{mod}=V_{mod}C_{mod}/1000$；按能量确定并联数量：$N_{P,E}=\lceil E_{bat,min}/(N_S E_{mod})\rceil$

### 方案 A（推荐）— 本宁 Benhoo BNP-5120BM × 4

| 参数 | 数值 | 来源 |
|---|---|---|
| 型号 | BNP-5120BM（51.2 V 100 Ah 机架式磷酸铁锂） | [Benhoo 官网产品页](https://www.benhoobattery.com/cn/products/energy-storage-batteries/residential-solar-storage-batteries/battery-module-zh-cn-1) |
| 标称电压 / 容量 / 能量 | 51.2 V / 100 Ah / **5.12 kWh** | 同上（查询日期 2026-09-01） |
| 充放电电压范围 | 44.8 ~ 57.6 V（充电上限 57.6 V） | 同上 |
| 标准 / 最大充电电流 | 20 A / **50 A** | 同上 |
| 标准 / 最大放电电流 | 50 A / **100 A** | 同上 |
| 通信 / BMS | RS485、CAN；智能 BMS | 同上 |
| 允许并联 | 厂家标注可大量并联（≥75 台） | 同上（本设计仅并联 4 台，远低于上限） |
| 参考价 | ≈ ¥3,500–5,000/台（同类 51.2 V 100 Ah 机架式电池 B2B 报价区间） | [Alibaba 同类产品页](https://www.alibaba.com/product-detail/KUVO-High-Quality-Rack-Mounted-LiFePO4_1601623844855.html) |

- $E_{mod}=51.2\times100/1000=\mathbf{5.12\ kWh}$；$N_{P,E}=\lceil 19.34/5.12\rceil=\mathbf{4}$
- **实际配置：4 台并联（N_S=1），总标称能量 20.48 kWh**，为下限计算值的 **1.06 倍**（≤1.25 倍上限 ✅）

### 方案 B（成本对比）— 51.2 V 200 Ah 机架式模块 × 2

| 参数 | 数值 | 来源 |
|---|---|---|
| 型号 | 51.2 V 200 Ah 机架式磷酸铁锂（10 kWh 级，如江西绿扬 Rack battery） | [Made-in-China 产品页](https://www.madeinchina.com/mall/show-10kwh-51-2V-200ah-Rack-Mounted-LiFePO4-Battery-Deep-Cycle-Grade-a-Cell-Residential-Energy-Storage-Systems_799083.html) |
| 标称能量 | **10.24 kWh**（51.2 V × 200 Ah） | 同上（查询日期 2026-09-01） |
| 出厂参考价 | **$900（≈¥6,400）** | 同上 |
| 充放电电流 | **最大充/放各 100 A（0.5 C）**，2026-09-03 已按实际产品规格确认（POWMR 51.2 V 200 Ah 10.24 kWh，UL1973：最大连续充/放各 100 A；机架式同规格见 LVFU 51.2 V 200 Ah） | [POWMR 产品页](https://powmr.com/products/200ah-51-2v-wall-mounted-lithium-battery-with-100a-max-charging-discharging-current-ul1973-certified)、[LVFU 机架式 200 Ah](https://www.lvfuenergy.com/product/51-2v-200ah-rack-mounted-lifepo4-battery/)（查询日期 2026-09-03） |

- $N_{P,E}=\lceil 19.34/10.24\rceil=2$，**2 台并联 = 20.48 kWh**（与方案 A 总能量相同）

## 5. 放电与充电电流校核（指导书 §5.4）

逆变器选定 **Growatt SPF 5000 ES**（额定 5 kW、η_inv=0.93，详见 W6 控制器逆变器设计-深圳.md），V_bat,min = 45 V（与模块放电下限 44.8 V 一致；逆变器低压切断须设置 ≥44.8 V）：

**连续放电电流**：$$I_{dis}=\frac{P_{inv,r}}{V_{bat,min}\cdot\eta_{inv}}=\frac{5000}{45\times 0.93}=\mathbf{119.5\ A}$$

**短时放电电流**（P_sur = 3.6 kW）：$I_{dis,sur}=\frac{3600}{45\times0.93}=\mathbf{86.0\ A}$

**最大充电电流**（光伏容量 P_PV=2.40 kWp，W5 定案；η_MPPT=0.96；充电电压 54.4 V；第二项为 MPPT 控制器输出限流，W6 回填）：
$$I_{chg}=\min\left(\frac{P_{PV}\cdot\eta_{MPPT}}{V_{bat,chg}},\ I_{ctrl,out,max}\right)=\min\left(\frac{2400\times0.96}{54.4},\ 100\right)=\mathbf{42.4\ A}$$

| 校核项 | 需求值 | 方案 A 能力（4×BNP-5120BM） | 结论 |
|---|---|---|---|
| 连续放电 | 119.5 A | 4 × 100 A = **400 A** | ✅ 裕量 3.3× |
| 短时放电 | 86.0 A | 峰值 4 × 100 A = 400 A | ✅ |
| 最大充电 | ≈42.4 A | 4 × 50 A = **200 A** | ✅ 裕量 4.7× |

**并联数量**：$N_P=\max(N_{P,E},\ N_{P,dis},\ N_{P,chg})=\max(4,\ 2,\ 1)=\mathbf{4}$——本设计由**能量需求**控制。

> 注意：不能把光伏侧短路电流当作蓄电池充电电流（MPPT 输入侧高压小电流、输出侧低压大电流，指导书 §7.1 警告；任务书红线）。

**方案 B 校核**（2×200 Ah，0.5 C = 100 A/台，**2026-09-03 已按 POWMR/LVFU 规格书确认**）：

| 校核项 | 需求值 | 方案 B 能力（2×200Ah） | 结论 |
|---|---|---|---|
| 连续放电 | 119.5 A | 2 × 100 A = 200 A | ✅（裕量 1.66×） |
| 短时放电 | 86.0 A | 200 A | ✅ |
| 最大充电 | ≈42.4 A | 2 × 100 A = 200 A | ✅ |

## 6. BMS 与并联限制（指导书 §5.4 末）

- 每台 BNP-5120BM 内置智能 BMS（16S 采集、均衡、过充/过放/过流/短路保护），通信 RS485/CAN；
- 并联数量 4 台 ≪ 厂家标注上限，支路采用等长、等截面线缆或对称母排连接；
- BMS 与逆变器协议匹配（CAN/RS485）：2026-09-03 W6 已确认机制——SPF 5000 ES 电池类型设 LI、程序 36 从协议库选择（RS485 L01–L50 / CAN L51–L99，波特率 9600）即可与 BNP-5120BM 建立通信。

## 7. 2 d 基准与 3 d 敏感性对比（指导书 §5.5）

| 项目 | 2 d（基准） | 3 d（敏感性） | 说明 |
|---|---|---|---|
| 最低标称能量 | 19.34 kWh | **29.01 kWh** | 能量比值 = 1.50（理论 3/2） |
| 方案 A（100 Ah） | 4 台 / 20.48 kWh | 6 台 / 30.72 kWh | 29.01/5.12=5.67→取整 6 台；实际比值 1.50 |
| 方案 B（200 Ah） | 2 台 / 20.48 kWh | 3 台 / 30.72 kWh | 29.01/10.24=2.83→取整 3 台；实际比值 1.50 |

> 3 d 方案用于观察**自主供电时间**提高 50%（2 d→3 d）带来的成本变化（方案 A 多买 2 台、方案 B 多买 1 台），**不采用 3 d 作为最终配置**（答辩常问点）。

## 8. 保守口径复核（DOD = 0.80）

$$E_{bat,min}=\frac{6.99\times2\times1.10}{0.80\times0.95\times0.93}=\mathbf{21.76\ kWh}$$

对应方案 A 需 5 台（25.60 kWh）、方案 B 需 3 台（30.72 kWh）。本设计采用 DOD = 0.90（智能 BMS 管理下厂家允许值，且模块放电下限 44.8 V 提供安全边界），实际选定能量 20.48 kWh 为下限计算值 19.34 kWh 的 **1.06 倍**，满足指导书 §5.5"实际选定标称能量原则上不宜超过最低计算值的 1.25 倍"。

## 9. 输出汇总（指导书 表3 样式）

| 项目 | 计算或选定结果 | 产品允许值 | 结论 |
|---|---|---|---|
| 最低标称能量 | 19.34 kWh | — | — |
| 模块型号及单模块能量 | Benhoo BNP-5120BM，5.12 kWh | — | — |
| 串联数量 / 并联数量 | N_S = 1（完整模块不串联）；N_P = 4 | 1；并联 ≤75（厂家） | ✅ |
| 实际标称能量 | 20.48 kWh | ≤ 1.25×19.34 = 24.2 kWh | ✅（1.06×） |
| 连续放电电流 | 119.5 A（Growatt SPF 5000 ES，W6 已确认） | 4 × 100 A = 400 A | ✅ |
| 短时放电电流 | 86.0 A | 峰值 400 A | ✅ |
| 最大充电电流 | ≈42.4 A（W5 定案 P_PV=2.40 kWp） | 4 × 50 A = 200 A | ✅ |
| BMS 和并联限制 | 智能 BMS（RS485/CAN），并联 4 台 | ≤75 台 | ✅ |

## 10. 成本对比（模块级；W11 详算含 BMS/柜体/母排/安装）

| 方案 | 配置 | 模块单价参考 | 模块小计 | 特点 |
|---|---|---|---|---|
| A（推荐） | 51.2 V 100 Ah × 4 | ≈¥3,500–5,000 | ≈¥14,000–20,000 | 电流裕量大（400 A）、粒度细、参数全可查 |
| B | 51.2 V 200 Ah × 2 | ≈¥6,400（$900） | ≈¥12,800 | 模块少、柜体/BMS/安装成本低；电流裕量小（0.5 C=100 A/台，已按规格书确认） |

> **结论：选用方案 A**——电流能力校核裕量最大（3.3×），全部参数有官方来源；方案 B 作为成本备选（按单价区间总价约低 1~7 千元，但 200 Ah 模块充放电电流需厂家规格书确认后才能通过电流校核）。两种方案均满足同一负荷、同一 2 d 自主供电与同一安全条件（指导书 §5.5 比较原则）。

## 11. 红线自查（任务书 §九 / 考核标准 §五）

- [x] 未将完整 51.2 V 模块违规串联（N_S = 1）；
- [x] 未把光伏侧电流当充电电流（I_chg 按 MPPT 输出侧功率/电压计算）；
- [x] 蓄电池电流按 48 V 侧电压（V_bat,min=45 V）计算，未误用 220 V；
- [x] E_AC 不重复除以 η_inv（口径与 W3 一致）；
- [x] 效率只计一次（η_dis、η_inv 各用一次）；
- [x] 实际能量 20.48 kWh 未超下限 1.25 倍。

## 12. 待回填/下一步

1. ~~W5 光伏阵列设计完成后回填 P_PV，复核 I_chg~~（2026-09-01 W5 定案 P_PV=2.40 kWp，I_chg=42.4 A，已完成回填）；
2. ~~W6 逆变器与 MPPT 控制器选型后回填 V_bat,min、P_inv,r、η_inv 及 I_ctrl_out_max~~（2026-09-01 W6 已选定 Growatt SPF 5000 ES：P_inv,r=5 kW、η_inv=0.93、I_ctrl_out_max=100 A 官方确认、V_bat,min=45 V 维持，I_dis=119.5 A / I_chg=42.4 A 复核通过）；
3. ~~方案 B（200 Ah）充放电电流向厂家索取规格书确认（0.5 C 假设）~~（2026-09-03 已按 POWMR/LVFU 产品规格确认 0.5 C=100 A/台）；
4. W11 成本分析按全 BOM（含 BMS、柜体、母排、保护、安装）重算，比较 A/B 总价；
5. 三张图纸（T1-01/02/03）与设备清单须与此处型号、数量一致（指导书 §13.2 表10）。
