sunny1043/offgrid-pv-course-design/差异化城市设计/支架设备间布置-哈尔滨.md

# 光伏支架、屋面与设备间布置 — 哈尔滨（W8）

> 依据：设计指导书 §9（光伏支架和设备布置）、课程设计任务书 §4.7；输入来自 W2 倾角核算（倾角 40°、排间节距 4.57×L）、W5 光伏阵列设计（隆基 LR7-72HGD-600M ×10、6.00 kWp、5 串×2 并拆两组）、W4 蓄电池设计（5×BNP-5120BM 机架式）、W6 逆变器选型（2×Growatt SPF 5000 ES 并联，330×135×485 mm/台）、W7 线缆回路。
> 状态：完成（屋面/设备间尺寸为课程设计假设，W9 图纸落实后回填修正）。
> 荷载依据：GB 50009-2012《建筑结构荷载规范》（哈尔滨基本风压 w0=0.55 kN/m²、基本雪压 s0=0.45 kN/m²）。
> **哈尔滨差异化核心：40° 大倾角 + 排间节距 4.57×L（四城最大，D≈10.9 m，故两组阵列东西向并排单排布置以避开超大排距）；雪荷载 0.45 kN/m² 需组合；双逆变器使设备间加大为 3.5×2.5 m；设备间保温+加热为硬性前提（-38.1 ℃）。**

## 1. 设计输入

| 输入 | 取值 | 来源 |
|---|---|---|
| 组件 | 隆基 LR7-72HGD-600M（1134×2382 mm，约 32 kg/块） | W5 |
| 串并联 | 5 串×2 并 = 6.00 kWp（10 块组件，拆 2 组各 5 块，各接一台逆变器） | W5 |
| 设计倾角 / 朝向 | **40° / 正南** | W2 倾角核算 |
| 排间节距系数 | **4.57 × L**（冬至 9:00 校核，h=9.6°） | W2 |
| 逆变器 | **2×** Growatt SPF 5000 ES（330×135×485 mm / 12 kg/台） | W6 |
| 蓄电池 | 5×Benhoo BNP-5120BM（19" 机架式，约 442×420×161 mm/台，电池柜装） | W4 |
| 屋面假设 | 哈尔滨普通住宅混凝土平屋面，南向可用安装区约 12 m（东西）× 6 m（南北） | 课程设计假设 |
| 设备间假设 | **3.5 m × 2.5 m**（约 8.75 m²），靠外墙、干燥、**保温+加热（≥10 ℃）** | 课程设计假设 |
| 基本风压 w0 | 0.55 kN/m²（哈尔滨，50 年一遇） | GB 50009-2012 |
| 基本雪压 s0 | **0.45 kN/m²**（哈尔滨） | GB 50009-2012 |
| 极端最低温 | -38.1 ℃ | W2 |

## 2. 光伏阵列布置（指导书 §9.1）

**布局选定：两组各 5 块竖排、东西向并排布置（单排 10 块，左 5 右 5 分属两串），正南 40° 固定支架。**

> **为什么东西向并排而不是前后两排**：哈尔滨 40° 时排间节距 D=4.57×2.382≈**10.9 m**（四城最大），若前后两排布置需约 11 m 南北纵深（远超普通屋面）；东西向并排成单排后，南北纵深仅约 2.8 m，两组之间留 0.3 m 分断便于线缆分组，是兼顾辐照与占地的优选（差异化答辩点）。

| 项目 | 数值 | 说明 |
|---|---|---|
| 阵列东西向长度 | 10 × 1.134 + 0.3 分断 ≈ **11.64 m** | 单排两段（左 5 右 5） |
| 阵列南北向（斜面长 / 水平投影） | 2.382 m / **1.82 m** | 40° 倾角投影（2.382×cos40°） |
| 前沿安装高度 | 0.50 m | 利于通风散热与排水 |
| 后沿高度 | 0.50 + 1.53 = **2.03 m** | 高差 2.382×sin40°=1.53 m |
| 距南檐口 | ≥ 1.0 m | 维护通道 + 檐口安全 |
| 距东西侧边 | ≥ 0.5 m | 施工与检修 |
| 距北侧 | ≥ 0.6 m | 排水与通道 |
| 阵列总占地（含通道） | 约 12.6 m × 3.4 m | 南向安装区内（12×6 m）✅ |

**排间节距校核**（本方案单排无前后排遮挡；若日后必须扩建第二排，按 W2 倾角核算结果）：
$$D = L\cos\beta + \frac{L\sin\beta}{\tan\alpha_s} = 2.382\times\cos40°+\frac{2.382\times\sin40°}{\tan9.6°}=\mathbf{10.9\ m}\ (≈4.57\times L，W2 取 4.57\times L)$$

> 校核时刻：冬至日 9:00（太阳时）h=9.6°（W2 已算）。D≈10.9 m 为四城最大，印证"哈尔滨单排东西向布置"的必要性（差异化核心）。

**屋面其他要求**：阵列不遮挡屋面排水天沟与检修口；阵列下方留 30 mm 通风间隙；组件边框与支架可靠接地（W7 §5）。直流线缆（两路）沿支架/桥架引至南侧女儿墙穿屋面入设备间（W7 C2a/b 回路 15 m 假设与此一致）。**哈尔滨冬季积雪：40° 倾角利于自滑，但组件下沿积雪/冻融仍需人工清雪维护（W6 §5），支架下沿预留清雪通道；线缆选用耐低温护套。**

## 3. 支架初步校核（指导书 §9.2，含风+雪组合）

**支架形式**：铝合金固定支架（立柱式），立柱 + 主横担 + 压块 + 锚固（化学锚栓/膨胀螺栓入屋面结构层）。组件 10 块竖排，每块由 2 根沿坡向导轨支撑。

**荷载**（GB 50009-2012）：
- 风压标准值：$w_k=\beta_{gz}\cdot\mu_s\cdot\mu_z\cdot w_0=1.6\times1.3\times1.0\times0.55=\mathbf{1.14\ kN/m^2}$
- **雪压标准值（40° 倾斜面，屋面雪载系数 μr≈0.5）**：$s_k=\mu_r\cdot s_0=0.5\times0.45=\mathbf{0.225\ kN/m^2}$
- 自重：组件约 32 kg/块（0.314 kN），10 块共 3.14 kN；支架自重约 0.7 kN

**简支梁校核**（取 1 根沿坡向导轨，跨度 Lb=1.2 m，两端简支于立柱；竖排组件坡长 2.382 m，每块 2 根导轨）：
- 自重线荷载 g = 0.314/2/2.382 ≈ **0.066 kN/m**（竖排坡长 2.382 m）
- 风载线荷载（标准值）q_w = 1.14×0.567 ≈ **0.65 kN/m**（每根导轨受风宽度半块 0.567 m）
- 雪载线荷载（标准值）q_s = 0.225×0.567 ≈ **0.13 kN/m**
- 承载能力组合（风+雪，GB 50009 分项）q = 1.2g + 1.4q_w + 1.4×0.7×q_s = **1.11 kN/m**
- $$M_{max}=\frac{w L_b^2}{8}=\frac{1.11\times1.2^2}{8}=\mathbf{0.200\ kN\cdot m}$$
- 截面（铝导轨 6063-T5，典型截面 W=10.4 cm³、I=44.9 cm⁴、E=70 GPa）：
$$\sigma_{max}=\frac{M_{max}}{W}=\frac{200}{10.4\times10^{-6}}=\mathbf{19.2\ MPa}\le 85\ MPa\ ✅$$
- 挠度（标准值 g+q_w=0.71 kN/m）：$$f_{max}=\frac{5wL_b^4}{384EI}=\mathbf{0.61\ mm}\le \frac{L_b}{200}=6\ mm\ ✅$$

> 说明：哈尔滨风+雪组合应力 19.2 MPa，接近深圳（24.3 MPa），为四城较高——风压大 + 雪载组合所致，但仍远低于 85 MPa 限值；40° 大倾角使雪载系数 μr 降低（自滑），是兼顾发电与减载的设计点。课程设计为简化简支梁初核；实际工程需按现行规范由专业人员复核屋面承载、锚固、防水与极端气象荷载（指导书 §9.2 原文）。立柱/压块/锚固按厂家配套选型，W11 落实。

## 4. 设备间布置（指导书 §9.3）

**房间**：**3.5 m × 2.5 m** × 高 2.6 m，靠外墙、干燥、通风、非人员停留（物业用房/储物间改造，假设）。**哈尔滨 -38.1 ℃ 极端低温下，设备间保温 + 低温加热是硬性前提（W4/W6）：墙体/吊顶/门保温（≥10 ℃），配低温加热器（防冻），否则 LFP 低温禁充、容量损失。**

| 设备 | 尺寸 | 布置 |
|---|---|---|
| 蓄电池电池柜 | 600×600×1200 mm（19" 机柜装 5 台 BNP-5120BM） | 靠北墙，柜后/侧留 ≥0.6 m 检修 |
| 离网逆变器 2 台（含 MPPT） | 330×135×485 mm ×2 | 西墙并排壁挂，高 1.4~1.6 m（间隔 ≥0.2 m 散热） |
| 交流配电箱 | 400×300×160 mm | 东墙，与逆变器相邻 |
| 汇流/直流隔离箱 ×2 | 250×200×120 mm ×2 | 各逆变器上方 |

**布置原则与尺寸**（对应 T1-03 图纸）：
- **大电流直流回路尽量短**：电池柜 → 各逆变器距离 ≤2 m（W7 C4a/b 回路各 70 mm²、各 160 A），两台逆变器经共用电池母排并联（W7 §2）；
- **交/直流分区**：直流设备（电池柜、逆变器直流侧）居左，交流配电居右，线缆桥架分上下两层/左右分隔敷设（两路直流、两路交流分槽敷设）；
- **检修通道**：柜前/逆变器前方通道 ≥0.8 m，门宽 ≥0.8 m，门开启不碰设备；
- **保温+加热（硬性）**：墙体/吊顶/门保温（≥10 ℃），配低温加热器（设定 ≤5 ℃ 启动），进风百叶冬季可关闭，排风扇加保温风阀；
- **通风**：机械排风扇（≥2 次/h）+ 低位进风百叶（与保温平衡）；
- **接地**：沿墙敷设接地干线（-40×4 镀锌扁钢或 ≥25 mm² 铜），电池柜/两台逆变器/配电箱/SPD 接地端全部接入，等电位联结（W7 §5）；
- **消防与警示**：门侧配 4 kg ABC 干粉灭火器，逆变器/电池柜贴"高压危险/锂电设备"警示标识与紧急断电说明；
- **排水**：设备间内设地漏/防水，避免积水；电池柜垫高 ≥100 mm。

> 本方案设备间布置已满足指导书 §9.3「干燥、通风、便于检修、不妨碍疏散」及「蓄电池与逆变器大电流回路尽量短」要求；双逆变器布局为哈尔滨特有（冗余 + 并联），具体尺寸标注在 W9 T1-03 图中落实。

## 5. 红线自查

- [x] 支架校核给出构件材料、截面、荷载来源及强度/挠度判断（指导书 §9.2），含风+雪组合；
- [x] 排间节距按冬至 9:00 校核（D≈10.9 m，4.57×L），采用东西向单排布置规避超大排距（差异化）；
- [x] 设备间满足检修距离、通风、排水、交直流分区、接地、消防、警示、**保温+加热**；
- [x] 组件数量/串并联与 W5 计算一致（10 块、5 串×2 并拆两组），未"先排布再改计算"（指导书 §9.1/任务书红线）；
- [x] 课程设计初核范围已声明（实际工程需专业复核）。

## 6. 待回填 / 下一步

1. 屋面/设备间尺寸为假设，**W9 三张 A3 图纸**（T1-02 阵列及支架布置图、T1-03 设备间平面图）落实后回填修正；
2. 支架铝导轨截面（W=10.4 cm³、I=44.9 cm⁴）为典型规格，**W11 落实具体品牌/型号/价格**；
3. 阵列到设备间两路线缆路径（W7 C2a/b 回路 15 m）在 T1-02 图中标注后回填 W7 长度假设；
4. 设备间保温/加热器与双机并联套件在 W11 成本中落实。

## 7. 参考资料

1. GB 50009-2012《建筑结构荷载规范》（基本风压、基本雪压、风+雪组合）；
2. GB 50057-2010《建筑物防雷设计规范》、GB/T 32512-2016（接地/防雷，配合 W7）；
3. 设计指导书 §9.1/§9.2/§9.3（排距公式、简支梁初核公式、设备间要求）；
4. W2 倾角核算-哈尔滨.md（排间节距 4.57×L、冬至 9:00 h=9.6°）；
5. W5 光伏阵列设计-哈尔滨.md（组件尺寸 1134×2382 mm、双串布置）；
6. W6 控制器逆变器设计-哈尔滨.md（双机并联、严寒充电策略）。
