sunny1043/offgrid-pv-course-design/差异化城市设计/支架设备间布置-拉萨.md

# 光伏支架、屋面与设备间布置 — 拉萨（W8）

> 依据：设计指导书 §9（光伏支架和设备布置）、课程设计任务书 §4.7；输入来自 W2 倾角核算（倾角 30°、排间节距 2.13×L）、W5 光伏阵列设计（隆基 LR7-72HGD-600M ×5、3.00 kWp、5 串×1 并）、W4 蓄电池设计（5×BNP-5120BM 机架式）、W6 逆变器选型（Growatt SPF 5000 ES，330×135×485 mm）、W7 线缆回路。
> 状态：完成（屋面/设备间尺寸为课程设计假设，W9 图纸落实后回填修正）。
> 荷载依据：GB 50009-2012《建筑结构荷载规范》（拉萨基本风压 w0=0.15 kN/m²，为四城最低）。
> **拉萨差异化：30° 倾角 + 排间节距 2.13×L（>深圳 1.62）；高原平屋顶日照极佳、雷暴/风压小；设备间必须保温（极端 -16.5 ℃）。**

## 1. 设计输入

| 输入 | 取值 | 来源 |
|---|---|---|
| 组件 | 隆基 LR7-72HGD-600M（1134×2382 mm，约 32 kg/块） | W5 |
| 串并联 | 5 串×1 并 = 3.00 kWp（5 块组件） | W5 |
| 设计倾角 / 朝向 | **30° / 正南** | W2 倾角核算 |
| 排间节距系数 | **2.13 × L**（冬至 9:00 校核，h=21.5°） | W2 |
| 逆变器 | Growatt SPF 5000 ES（330×135×485 mm / 12 kg） | W6 |
| 蓄电池 | 5×Benhoo BNP-5120BM（19" 机架式，约 442×420×161 mm/台，电池柜装） | W4 |
| 屋面假设 | 拉萨普通住宅混凝土平屋面，南向可用安装区约 6 m（东西）× 5 m（南北） | 课程设计假设 |
| 设备间假设 | 3.0 m × 2.5 m（约 7.5 m²），靠外墙、干燥、**保温（≥10 ℃）** | 课程设计假设 |
| 基本风压 w0 | 0.15 kN/m²（拉萨，50 年一遇） | GB 50009-2012 |
| 极端最低温 | -16.5 ℃ | W2 |

## 2. 光伏阵列布置（指导书 §9.1）

**布局选定：单排 5 块竖排（1 行 × 5 列），正南 30° 固定支架。**

| 项目 | 数值 | 说明 |
|---|---|---|
| 阵列东西向长度 | 5 × 1.134 = **5.67 m** | 单排竖排 |
| 阵列南北向（斜面长 / 水平投影） | 2.382 m / **2.06 m** | 30° 倾角投影（2.382×cos30°） |
| 前沿安装高度 | 0.50 m | 利于通风散热与排水 |
| 后沿高度 | 0.50 + 1.19 = **1.69 m** | 高差 2.382×sin30°=1.19 m |
| 距南檐口 | ≥ 1.0 m | 维护通道 + 檐口安全 |
| 距东西侧边 | ≥ 0.5 m | 施工与检修 |
| 距北侧 | ≥ 0.6 m | 排水与通道 |
| 阵列总占地（含通道） | 约 6.7 m × 3.2 m | 南向安装区内（6×5 m）✅ |

**排间节距校核**（本方案单排无前后排遮挡；若日后扩建第二排，按 W2 倾角核算结果）：
$$D = L\cos\beta + \frac{L\sin\beta}{\tan\alpha_s} = 2.382\times\cos30°+\frac{2.382\times\sin30°}{\tan21.5°}=\mathbf{5.09\ m}\ (≈2.13\times L，W2 取 2.13\times L)$$

> 校核时刻：冬至日 9:00（太阳时）h=21.5°（W2 已算）。拉萨 30° 时 D≈5.09 m，明显大于深圳（1.84 m）——因倾角更大、纬度更高、冬季太阳高度角更低。本方案单排布置无需排距，但保留该值为扩排依据（屋面南北 5 m 可容纳前排+通道）。

**屋面其他要求**：阵列不遮挡屋面排水天沟与检修口；阵列下方留 30 mm 通风间隙；组件边框与支架可靠接地（W7 §5）。直流线缆沿支架/桥架引至南侧女儿墙穿屋面入设备间（W7 C2 回路 15 m 假设与此一致）。**拉萨高原日照强、紫外线强，线缆桥架选用耐 UV 材质，支架表面耐候涂装。**

## 3. 支架初步校核（指导书 §9.2）

**支架形式**：铝合金固定支架（立柱式），立柱 + 主横担 + 压块 + 锚固（化学锚栓/膨胀螺栓入屋面结构层）。组件 5 块竖排，每块由 2 根沿坡向导轨支撑。

**荷载**（GB 50009-2012）：
- 风压标准值：$w_k=\beta_{gz}\cdot\mu_s\cdot\mu_z\cdot w_0=1.6\times1.3\times1.0\times0.15=\mathbf{0.31\ kN/m^2}$（βgz=1.6 阵风系数、μs=1.3 倾斜平板体型系数、μz=1.0 B 类地面 10 m）——四城最低，拉萨风压小
- 自重：组件约 32 kg/块（0.314 kN），5 块共 1.57 kN；支架自重约 0.35 kN
- 拉萨无雪荷载（w0s≈0），不组合雪载

**简支梁校核**（取 1 根沿坡向导轨，跨度 Lb=1.2 m，两端简支于立柱；竖排组件坡长 2.382 m，每块 2 根导轨）：
- 自重线荷载 g = 0.314/2/2.382 ≈ **0.066 kN/m**（竖排坡长 2.382 m）
- 风载线荷载（标准值）q_w = 0.31×0.567 ≈ **0.18 kN/m**（每根导轨受风宽度半块 0.567 m）
- 承载能力组合 q = 1.2g + 1.4q_w = **0.33 kN/m**
- $$M_{max}=\frac{w L_b^2}{8}=\frac{0.33\times1.2^2}{8}=\mathbf{0.059\ kN\cdot m}$$
- 截面（铝导轨 6063-T5，典型截面 W=10.4 cm³、I=44.9 cm⁴、E=70 GPa）：
$$\sigma_{max}=\frac{M_{max}}{W}=\frac{59}{10.4\times10^{-6}}=\mathbf{5.6\ MPa}\le 85\ MPa\ ✅$$
- 挠度（标准值 q=0.24 kN/m）：$$f_{max}=\frac{5wL_b^4}{384EI}=\mathbf{0.21\ mm}\le \frac{L_b}{200}=6\ mm\ ✅$$

> 说明：拉萨风压/自重组合应力仅 5.6 MPa，远小于深圳（24.3 MPa），支架强度裕量极大——差异化点。课程设计为简化简支梁初核；实际工程需按现行规范由专业人员复核屋面承载、锚固、防水与极端气象荷载（指导书 §9.2 原文）。立柱/压块/锚固按厂家配套选型，W11 落实。

## 4. 设备间布置（指导书 §9.3）

**房间**：3.0 m × 2.5 m × 高 2.6 m，靠外墙、干燥、通风、非人员停留（物业用房/储物间改造，假设）。**拉萨设备间必须保温：墙体/门加保温层，冬季采暖季维持室内 ≥10 ℃（W4 §5），否则蓄电池低温容量损失（K_T=0.70 时需 7 台）并影响充电。**

| 设备 | 尺寸 | 布置 |
|---|---|---|
| 蓄电池电池柜 | 600×600×1200 mm（19" 机柜装 5 台 BNP-5120BM） | 靠北墙，柜后/侧留 ≥0.6 m 检修 |
| 离网逆变器（含 MPPT） | 330×135×485 mm | 壁挂于电池柜旁西墙，高 1.4~1.6 m |
| 交流配电箱 | 400×300×160 mm | 壁挂于东墙，与逆变器相邻 |
| 汇流/直流隔离箱 | 250×200×120 mm | 逆变器上方 |

**布置原则与尺寸**（对应 T1-03 图纸）：
- **大电流直流回路尽量短**：电池柜 → 逆变器距离 ≤2 m（W7 C4 回路 70 mm²、160 A）；
- **交/直流分区**：直流设备（电池柜、逆变器直流侧）居左，交流配电居右，线缆桥架分上下两层/左右分隔敷设；
- **检修通道**：柜前/逆变器前方通道 ≥0.8 m，门宽 ≥0.8 m，门开启不碰设备；
- **通风**：设备间设机械排风扇（≥2 次/h）+ 低位进风百叶（注意保温与通风平衡，排风扇加保温风阀）；
- **保温**：墙体/吊顶/门保温（≥10 ℃），进风百叶冬季可关闭，必要时加低温加热器；
- **接地**：沿墙敷设接地干线（-40×4 镀锌扁钢或 ≥25 mm² 铜），电池柜/逆变器/配电箱/SPD 接地端全部接入，等电位联结（W7 §5）；
- **消防与警示**：门侧配 4 kg ABC 干粉灭火器，逆变器/电池柜贴"高压危险/锂电设备"警示标识与紧急断电说明；
- **排水**：设备间内设地漏/防水，避免积水；电池柜垫高 ≥100 mm。

> 本方案设备间布置已满足指导书 §9.3「干燥、通风、便于检修、不妨碍疏散」及「蓄电池与逆变器大电流回路尽量短」要求；具体尺寸标注在 W9 T1-03 图中落实。

## 5. 红线自查

- [x] 支架校核给出构件材料、截面、荷载来源及强度/挠度判断（指导书 §9.2）；
- [x] 排间节距按冬至 9:00 校核（D=5.09 m，2.13×L），单排无遮挡（扩排保留）；
- [x] 设备间满足检修距离、通风、排水、交直流分区、接地、消防、警示、**保温**；
- [x] 组件数量/串并联与 W5 计算一致（5 块、5 串×1 并），未"先排布再改计算"（指导书 §9.1/任务书红线）；
- [x] 课程设计初核范围已声明（实际工程需专业复核）。

## 6. 待回填 / 下一步

1. 屋面/设备间尺寸为假设，**W9 三张 A3 图纸**（T1-02 阵列及支架布置图、T1-03 设备间平面图）落实后回填修正；
2. 支架铝导轨截面（W=10.4 cm³、I=44.9 cm⁴）为典型规格，**W11 落实具体品牌/型号/价格**；
3. 阵列到设备间线缆路径（W7 C2 回路 15 m）在 T1-02 图中标注后回填 W7 长度假设；
4. 设备间保温材料与低温加热器规格在 W11 成本中落实。

## 7. 参考资料

1. GB 50009-2012《建筑结构荷载规范》（基本风压、风荷载组合）；
2. GB 50057-2010《建筑物防雷设计规范》、GB/T 32512-2016（接地/防雷，配合 W7）；
3. 设计指导书 §9.1/§9.2/§9.3（排距公式、简支梁初核公式、设备间要求）；
4. W2 倾角核算-拉萨.md（排间节距 2.13×L、冬至 9:00 h=21.5°）；
5. W5 光伏阵列设计-拉萨.md（组件尺寸 1134×2382 mm、串并联）。
