sunny1043/offgrid-pv-course-design/docs/线缆保护防雷接地-深圳.md

# 线缆、保护、防雷与接地设计 — 深圳（W7）

> 依据：设计指导书 §8（线缆、保护、防雷和接地）、课程设计任务书 §4.6；输入来自 W4 蓄电池设计（48 V 级、V_bat,min=45 V）、W5 光伏阵列设计（4 串×1 并、2.40 kWp、Isc=14.49 A、组串 Voc,cold=220.8 V）、W6 控制器逆变器选型（Growatt SPF 5000 ES：I_dis=119.5 A、I_chg=42.4 A、I_ac≈22.7 A）。
> 状态：完成（线缆截面与保护器件按标准选择；具体品牌/价格 W11 落实）。
> 计算口径：铜电阻率 ρ=0.0175 Ω·mm²/m（20 ℃）；载流量按 GB 50217-2018 附录（PVC 绝缘、空气中、30 ℃ 基准），40 ℃ 环境温度修正系数 0.87；电压降 ΔU=2ρLI/S（两线直流 / 单相交流），相对压降 δU=ΔU/U_n×100%。
> **红线提示：蓄电池→逆变器回路相对压降按最低电池电压 45 V 计算，不得除以 220 V（指导书 §8.2 原文警告）。**

## 1. 设计输入（W1–W6 输出）

| 输入 | 取值 | 来源 |
|---|---|---|
| 光伏组串短路电流 Isc / 工作电流 Imp | **14.49 A / 13.60 A** | W5（隆基 LR7-72HGD-600M ×4 串×1 并） |
| 组串低温开路电压 Voc,cold | **220.8 V**；工作电压 Vmp 154~189 V | W5 |
| 最大充电电流 I_chg | **42.4 A** | W4 §5 / W5 §9 / W6（MPPT 输出侧，54.4 V） |
| 连续放电电流 I_dis | **119.5 A**（V_bat,min=45 V、η_inv=0.93） | W4 §5 / W6 |
| 短时放电电流 I_dis,sur | 86.0 A（P_sur=3.6 kW） | W4 §5 |
| 交流输出电流 I_ac | **22.7 A**（5000 W/220 V，浪涌 10 kVA 为设备能力） | W6 §2 |
| 交流负荷电压 | 220 V / 50 Hz 单相 | 任务书 |
| 最大同时功率 P_max / 短时 P_sur | 3.0 kW / 3.6 kW | W1 |

## 2. 回路划分（指导书 §8.1，至少 6 回路）

| 回路 | 电气位置 | 设计电压 | 设计电流 | 长度假设 |
|---|---|---|---|---|
| C1 | 光伏组件串线（组件间互联） | ≤220.8 V DC | 14.49 A（Isc 最不利） | ≈1 m |
| C2 | 组串 → MPPT 控制器 | ≤220.8 V DC | 13.6 A（Imp 运行） | 15 m（屋面→设备间，假设） |
| C3 | MPPT → 蓄电池母排（充电） | 48 V 级（45~57.6 V） | 42.4 A | 3 m |
| C4 | 蓄电池 → 逆变器（放电） | 48 V 级（**45 V 基准**） | **119.5 A** | 2 m（尽量短，指导书 §9.3） |
| C5 | 逆变器 → 交流配电箱 | 220 V / 50 Hz | 22.7 A | 5 m |
| C6 | 交流末端负荷回路（4 个代表回路） | 220 V / 50 Hz | 见 §3 | 15~20 m |

> 长度按普通住宅设备间/屋面布置假定（W8 图纸确定后回填修正）；不同回路电压电流不同，不能用一种线缆代替全部（指导书 §8.1 原文警告）。

## 3. 载流量与电压降计算（指导书 §8.2）

**原则**：$I_b \le I_n \le I_z$（设计电流 ≤ 保护器件额定电流 ≤ 修正后导体允许载流量）；电压降 $\Delta U=2\rho L I/S$，选标准截面后**重新核算**电压降与载流量。

| 回路 | 线缆 | 截面 S | L | I_b | I_n | I_z(40℃) | ΔU | δU 基准 | δU | 结论 |
|---|---|---|---|---|-----|---|-----|---|-----|---|
| C1 组件串线 | PV1-F | 4 mm² | 1 m | 14.49 A | 25 A | 47.85 A | 0.13 V | 154 V | 0.08 % | ✅ |
| C2 组串→MPPT | PV1-F | 4 mm² | 15 m | 13.6 A | 25 A | 47.85 A | 1.79 V | 154 V | 1.16 % | ✅ |
| C3 MPPT→电池 | RV | 10 mm² | 3 m | 42.4 A | 50 A | 60.9 A | 0.45 V | 48 V | 0.93 % | ✅ |
| C4 电池→逆变器 | RV | **70 mm²** | 2 m | **119.5 A** | 160 A | 191.4 A | 0.12 V | **45 V** | 0.27 % | ✅ |
| C5 逆变器→配电箱 | RVV | 6 mm² | 5 m | 22.7 A | 32 A | 44.4 A | 0.66 V | 220 V | 0.30 % | ✅ |
| C6a 照明 | BV | 2.5 mm² | 20 m | 0.5 A | 10 A | 26.1 A | 0.14 V | 220 V | 0.06 % | ✅ |
| C6b 厨房插座 | BV | 4 mm² | 15 m | 13.6 A | 20 A | 34.8 A | 1.79 V | 220 V | 0.81 % | ✅ |
| C6c 空调 | BV | 4 mm² | 15 m | 8.6 A | 20 A | 34.8 A | 1.13 V | 220 V | 0.51 % | ✅ |
| C6d 其他插座 | BV | 2.5 mm² | 20 m | 3.4 A | 16 A | 26.1 A | 0.95 V | 220 V | 0.43 % | ✅ |

> **全部回路满足 I_b ≤ I_n ≤ I_z 且电压降 ≤2%（直流主回路）/≤3%（交流末端）**。载流量基准：PV1-F（C1/C2）按 90 ℃ 绝缘自由空气 55 A（4 mm²），其余按 PVC 绝缘空气中 30 ℃ 基准（C3 70 A、C4 220 A、C5 51 A、C6 30/40 A），均乘 40 ℃ 修正 0.87。关键回路的取舍说明：
> - **C4（电池→逆变器）选 70 mm²**：119.5 A 连续电流，50 mm² 在 40 ℃ 修正后 I_z≈144 A 仅够配 125 A 断路器（浪涌余量小），70 mm²（I_z≈191 A）配 160 A 总保护更稳妥；ΔU=0.27%（**以 45 V 为基准**，若误除以 220 V 会得 0.06% 而掩盖真实压降——红线）。
> - **C2（组串→MPPT）15 m、4 mm²**：δU=1.16% < 2%，若屋面距离增大（W8 定案）可升 6 mm²；
> - **交流末端按 W1 24 h 负荷表分回路**：厨房插座按周末炊事高峰 3.0 kW（13.6 A）设计，空调回路含启动裕量取 20 A，照明/其他插座 10/16 A。

## 4. 保护配置（指导书 §8.3）

### 4.1 光伏输入侧
| 保护 | 选型 | 依据 |
|---|---|---|
| 组串熔断器 | **25 A gPV 直流熔断器** | ≥1.4×Isc=20.3 A，且 < 组件最大串联熔断器 30 A（GB 50797-2012）；单串无并联反向电流，主要为线路保护 |
| 直流隔离 | **2P 隔离开关（≥600 Vdc）** | ≥ 组串 Voc,cold=220.8 V，检修安全隔离 |
| 直流 SPD | **Type II，1000 Vdc，U_cpv ≥ 265 V**（1.2×Voc,cold） | GB/T 32512-2016，装于 MPPT 输入侧 |

### 4.2 蓄电池侧（48 V 级，大短路电流，支路+总保护）
| 保护 | 选型 | 依据 |
|---|---|---|
| 支路熔断器 | **4 × 100 A gPV 直流**（每个并联支路） | 每支路最大放电电流 100 A（模块限值），隔离单支路故障（指导书 §8.3：蓄电池能提供很大短路电流，保护须按直流短路校核） |
| 总保护 | **160 A DC MCB（2P，≥125 Vdc）** | 119.5 A ≤ 160 A ≤ I_z；含检修隔离功能 |
| 支路线缆 | 等长、等截面（对称母排/等长线缆） | 指导书 §5.4 并联要求 |
| 选择性 | 总保护 160 A > 支路 100 A，支路故障先跳支路 | 指导书 §8.3 选择性要求 |

> 短路校核说明：磷酸铁锂模块短路电流显著高于额定，但每模块内置 BMS（过流/短路保护）且支路熔断器 100 A gPV 具备直流分断能力；总保护 MCB 开断能力 ≥ 系统预期短路电流（选型时按厂商样本核对，W11 落实具体型号）。

### 4.3 交流侧
| 保护 | 选型 | 依据 |
|---|---|---|
| 逆变器输出 | **32 A C 曲线 MCB** | 22.7 A ≤ 32 A ≤ 44.4 A |
| 剩余电流保护 | **30 mA RCD**（插座回路） | 人身触电保护 |
| 交流 SPD | **Type II，220 V（U_c=275 V，Imax 40 kA）** | 配电箱进线处，GB 50057-2010 / GB/T 32512 |
| 末端回路 | C6a 10 A / C6b、C6c 20 A / C6d 16 A MCB | 见 §3 表 |

## 5. 防雷与接地（GB 50057-2010、GB/T 32512-2016、GB/T 16895.32-2021）

**雷区**：深圳为多雷区（年雷暴日约 70+ 天），户用光伏系统需按Ⅲ类防雷建筑物辅助设施考虑。

| 项目 | 设计 |
|---|---|
| 直击雷 | 屋面已有建筑防雷系统（接闪器/避雷带）；光伏组件处于其保护范围内，组件金属边框与支架可靠接入建筑防雷接地 |
| 感应雷（浪涌） | 直流侧 SPD（MPPT 输入，Type II 1000 Vdc）+ 交流侧 SPD（配电箱，Type II 220 V），两级防护 |
| 保护接地（PE） | 组件边框、支架、设备金属外壳（电池柜/逆变器/配电箱）全部接入保护接地 |
| 等电位联结 | 设备间内设等电位联结端子，电池柜、逆变器、配电箱、SPD 接地端、PE 干线连通（等电位联结导体 ≥6 mm² 铜） |
| 接地电阻 | 系统接地电阻 ≤4 Ω（利用建筑基础接地/人工接地极，实际按土壤条件由专业复核） |
| 说明 | 课程设计为初步设计口径；实际工程须按 GB 50057-2010、GB/T 32512-2016 及建筑物防雷分类专项复核（指导书 §8.3 末） |

## 6. 红线自查（任务书 §九 / 考核标准 §五）

- [x] 电池→逆变器电压降按 **45 V** 计算，未误用 220 V（指导书 §8.2 红线）；
- [x] 未把光伏侧电流（13.6 A）当充电电流（42.4 A）——两侧保护分别按各自位置电流选择；
- [x] 线缆同时校核载流量与电压降（选截面后重新核算，非只看其一）；
- [x] 保护器件按直流/交流属性、额定电压、极数、开断能力选择，未用交流器件替直流（直流熔断器/MCB 标注 DC）；
- [x] 蓄电池支路+总保护齐全，含检修隔离；
- [x] 防雷接地、等电位联结完整，直流/交流 SPD 两级配置。

## 7. 待回填 / 下一步

1. 回路长度假设（C2=15 m、C4=2 m 等）待 **W8 屋面/设备间布置**定案后回填修正；
2. 保护器件具体品牌/型号/价格（熔断器、MCB、SPD、RCD）W11 成本分析落实（当前为典型规格）；
3. **W9 图纸**：T1-01 主接线图须标注各回路线缆型号/截面、保护器件额定值；T1-03 设备间图标注线缆桥架、交直流分区、接地干线——本文件是图纸参数依据；
4. 逆变器低压切断设置值（≥44.8 V，W6 §6 待确认）与总保护 160 A 开断能力选择联动核对。

## 8. 参考资料

1. GB 50217-2018《电力工程电缆设计标准》（载流量、电压降）；
2. GB 50797-2012《光伏发电站设计规范》（组串熔断器选择：≥1.4×Isc、≤组件最大串联熔断器）；
3. GB 50057-2010《建筑物防雷设计规范》、GB/T 32512-2016《光伏发电站防雷技术要求》（SPD、接地）；
4. GB/T 16895.32-2021《低压电气装置 第7-712部分 太阳能光伏电源系统》（直流侧保护/接地）；
5. 导线电阻率 ρ=0.0175 Ω·mm²/m（铜，20 ℃），载流量按 PVC 绝缘空气中 30 ℃ 基准 + 40 ℃ 修正 0.87。
