sunny1043/offgrid-pv-course-design/差异化城市设计/光伏阵列设计-兰州.md

# 光伏阵列设计 — 兰州（W5）

> 依据：指导书 §6、任务书 §4.4。状态：本地草稿（配套 Excel docs/计算-光伏阵列-兰州.xlsx）。
> 兰州差异化：冬季辐照中等（12 月倾斜 3.24），阵列 3.60 kWp（6 串单并，单台 SPF 5000 ES 即可）；低温 -23.1 ℃ 使 N_S,max=7，选 6 串留电压裕量。

## 1. 设计输入

| 输入 | 取值 | 来源 |
|---|---|---|
| E_AC | 7.82 kWh/d（冬季） | W1 |
| 最不利设计月 | 12 月 | W2（R=2.77） |
| H_T,min（倾斜 30°） | 3.24 h/d | W2 倾角核算 |
| eta_path | 0.782 | W3 |
| T_min / T_cell,max | -23.1 / 70.4 ℃ | W2 |

## 2. 阵列容量

    P_PV,min = 7.82 * 1.10 / (3.24 * 0.782) = 3.40 kWp

## 3. 组件温度修正（隆基 LR7-72HGD-600M）

- Voc,cold = 52.22×[1+(-0.0023)(-23.1-25)] = **58.00 V**；
- Vmp,hot = 44.12×[1+(-0.0028)(70.4-25)] = **38.51 V**；
- Vmp,cold = 44.12×[1+(-0.0028)(-48.1)] = **50.06 V**。

## 4. 串联数量与可行域

    N_S,min = ceil(120/38.51) = 4
    N_S,max = floor(450/58.00) = 7   可行域 [4, 7]

## 5. 串并联与装机

| N_S | N_P | 实际装机(kWp) | 12 月供能比 | 说明 |
|-----|-----|---|---|---|
| 5 | 1 | 3.00 | 0.97 | 不足 ✗ |
| **6** | **1** | **3.60** | **1.17** | ✅ 选定 |
| 7 | 1 | 4.20 | 1.36 | 可行但组串低温 Voc 406 V 距 450 V 裕量仅 44 V |

> **选定 N_S=6、N_P=1 → 3.60 kWp**（6 块组件单串）。不选 7 串：其组串低温 Voc = 7×58.0 = 406 V，接近控制器最大输入 450 V（裕量小），且 4.2 kWp 超出需求 24%；6 串电压 348 V、裕量充足，12 月供能比 1.17（与深圳示例最不利月 1.20 相当）。

## 6. 校核汇总

| 项目 | 计算结果 | 允许值 | 结论 |
|---|---|---|---|
| 组串低温 Voc（6 串） | 6×58.00 = 348.0 V | ≤450 V；≤430 V | ✅ |
| 组串高温 Vmp（6 串） | 6×38.51 = 231.1 V | ≥120 V | ✅ |
| 组串低温 Vmp（6 串） | 6×50.06 = 300.4 V | ≤430 V | ✅ |
| 阵列电流 | 14.49 A / 13.6 A | ≤22 A（单 MPPT） | ✅ |
| 阵列输入功率 | 3.60 kW | ≤6.0 kW | ✅ |
| 充电电流 | 63.5 A | ≤100 A | ✅ |

## 7. 逐月供能量复核（P_PV=3.60 kWp，倾角 30°）

| 月份 | 1 | 2 | 3 | 4 | 5 | 6 | 7 | 8 | 9 | 10 | 11 | 12 |
|---|---|---|---|---|---|---|---|---|---|---|----|----|
| H_tilt(30°) | 3.39 | 4.22 | 5.37 | 6.13 | 6.74 | 6.67 | 7.10 | 5.81 | 5.15 | 3.92 | 3.68 | 3.24 |
| E_PV (kWh/d) | 9.54 | 11.88 | 15.12 | 17.26 | 18.97 | 18.78 | 19.99 | 16.36 | 14.50 | 11.04 | 10.36 | 9.12 |
| E_AC (kWh/d) | 7.82 | 7.82 | 7.82 | 4.82 | 3.62 | 4.97 | 4.97 | 4.97 | 3.62 | 4.82 | 7.82 | 7.82 |
| 供能比 | 1.22 | 1.52 | 1.93 | 3.58 | 5.24 | 3.78 | 4.02 | 3.29 | 4.01 | 2.29 | 1.32 | **1.17** |

> 12 个月全部满足 ✅。最不利月 12 月供能比 1.17；夏季（5–8 月）供能比 3.3~5.2，富余明显但低于拉萨（2.8~4.4 的极端值）。

## 8. 输出汇总

| 结果 | 数值 |
|---|---|
| 组件 | 隆基 LR7-72HGD-600M × 6 |
| 串并联 | 6 串 × 1 并 |
| 装机容量 | 3.60 kWp |
| 组串低温 Voc | 348.0 V |
| 组串工作电压范围 | 231.1~300.4 V |
| 对应充电电流 | 63.5 A（回填 W4） |
| 倾角/排距 | 30° / 2.51×L |
