sunny1043/offgrid-pv-course-design/差异化城市设计/光伏阵列设计-哈尔滨.md

# 光伏阵列设计 — 哈尔滨（W5）

> 依据：指导书 §6、任务书 §4.4。状态：本地草稿（配套 Excel docs/计算-光伏阵列-哈尔滨.xlsx）。
> 哈尔滨差异化核心：**冬季辐照塌陷**使阵列容量高达 6.0 kWp（深圳/拉萨 2.4~3.0 的 2 倍以上），两串并联超过单台一体机 MPPT 电流限值，需 2 台 SPF 5000 ES 各带一串。

## 1. 设计输入

| 输入 | 取值 | 来源 |
|---|---|---|
| E_AC | 7.82 kWh/d（冬季） | W1 |
| 最不利设计月 | 12 月 | W2（R=4.65 最大） |
| H_T,min（倾斜 40°） | 2.05 h/d | W2 倾角核算 |
| eta_path | 0.782 | W3 |
| T_min / T_cell,max | -38.1 / 70.5 ℃ | W2 |

## 2. 阵列容量

    P_PV,min = 7.82 * 1.10 / (2.05 * 0.782) = 5.37 kWp

> 需要约 5.4 kWp——冬季辐照太低所致，是其他城市的 2 倍以上。

## 3. 组件温度修正（隆基 LR7-72HGD-600M）

- Voc,cold = 52.22×[1+(-0.0023)(-38.1-25)] = **59.80 V**（对比拉萨 57.2、兰州 58.0——哈尔滨最紧）；
- Vmp,hot = 44.12×[1+(-0.0028)(70.5-25)] = **38.50 V**；
- Vmp,cold = 44.12×[1+(-0.0028)(-63.1)] = **51.92 V**。

## 4. 串联数量与可行域

    N_S,min = ceil(120/38.50) = 4
    N_S,max = floor(450/59.80) = 7   可行域 [4, 7]

## 5. 串并联与装机（差异化：双串 + 双机）

| N_S | N_P | 实际装机(kWp) | 12 月供能比 | 单串 Isc/Imp(A) | 说明 |
|-----|-----|---|---|---|---|
| 4 | 2 | 4.80 | 0.98 | 28.98 / 27.2 | 容量不足 ✗ |
| **5** | **2** | **6.00** | **1.23** | 14.49/13.6（每台一串） | ✅ 选定 |
| 6 | 2 | 7.20 | 1.48 | 同上 | 偏大 |
| 7 | 1 | 4.20 | 0.86 | 14.49/13.6 | 容量不足 ✗ |

> **选定 N_S=5、N_P=2 → 6.00 kWp**（5 串 × 2 并 = 10 块组件）。
> **关键问题**：两串并联时总电流 Isc=28.98 A、Imp=27.2 A，超过单台 SPF 5000 ES 的每 MPPT 电流限值（22 A）——因此 **6.0 kWp 阵列拆分为两组，各接一台 SPF 5000 ES 的 MPPT**（每台一串 3.0 kWp，单串 Isc 14.49 A ≤ 22 A ✅）。这是哈尔滨特有的选型（其他城市单台即可）。

## 6. 校核汇总

| 项目 | 计算结果 | 允许值 | 结论 |
|---|---|---|---|
| 组串低温 Voc（5 串） | 5×59.80 = 299.0 V | ≤450 V（单台输入） | ✅ |
| 组串高温 Vmp（5 串） | 5×38.50 = 192.5 V | ≥120 V（MPPT 下限） | ✅ |
| 组串低温 Vmp（5 串） | 5×51.92 = 259.6 V | ≤430 V（MPPT 上限） | ✅ |
| 每台输入功率 | 3.0 kW | ≤6.0 kW | ✅ |
| 每台输入电流 | 14.49 A / 13.6 A | ≤22 A | ✅ |
| 总装机 | 6.00 kWp | 2 台合计 | ✅ |

## 7. 逐月供能量复核（P_PV=6.00 kWp，倾角 40°）

| 月份 | 1 | 2 | 3 | 4 | 5 | 6 | 7 | 8 | 9 | 10 | 11 | 12 |
|---|---|---|---|---|---|---|---|---|---|---|----|----|
| H_tilt(40°) | 2.49 | 3.85 | 4.95 | 6.36 | 7.07 | 6.82 | 6.51 | 5.26 | 5.05 | 3.92 | 2.25 | 2.05 |
| E_PV (kWh/d) | 11.68 | 18.06 | 23.23 | 29.84 | 33.17 | 32.00 | 30.54 | 24.68 | 23.69 | 18.39 | 10.56 | 9.62 |
| E_AC (kWh/d) | 7.82 | 7.82 | 7.82 | 4.82 | 3.62 | 5.31 | 5.31 | 5.31 | 3.62 | 4.82 | 7.82 | 7.82 |
| 供能比 | 1.49 | 2.31 | 2.97 | 6.19 | 9.16 | 6.03 | 5.75 | 4.65 | 6.55 | 3.82 | 1.35 | **1.23** |

> 12 个月全部满足 ✅。最不利月 12 月供能比 1.23（余量 23%）；夏季（5–8 月）供能比 4.7~9.2——冬季「紧」、夏季「大富余」对比极强。逐月复核能清楚看到哈尔滨「冬季阵列超配、夏季大幅弃光」的能量逻辑。

## 8. 输出汇总

| 结果 | 数值 |
|---|---|
| 组件 | 隆基 LR7-72HGD-600M × 10 |
| 串并联 | 5 串 × 2 并（拆分 2×3.0 kWp，各接一台 SPF 5000 ES） |
| 装机容量 | 6.00 kWp |
| 组串低温 Voc | 299.0 V |
| 组串工作电压范围 | 192.5~259.6 V |
| 对应充电电流 | 105.9 A（两机合计，回填 W4） |
| 倾角/排距 | 40° / 4.57×L |
