sunny1043/offgrid-pv-course-design/差异化城市设计/光伏阵列设计-拉萨.md

# 光伏阵列设计 — 拉萨（W5）

> 依据：设计指导书 §6（光伏阵列容量和串并联设计）、课程设计任务书 §4.4；输入来自 W1 负荷调查、W2 太阳能资源/倾角核算、W3 效率口径、W4 蓄电池设计。
> 状态：本地草稿（拉萨差异化新建；配套 Excel 计算文件 docs/计算-光伏阵列-拉萨.xlsx）。
> 产品资料查询日期：2026-09-01。
> 拉萨差异化：容量由「冬季采暖负荷 × 冬季（相对）低辐照」驱动（最不利月 12 月）；因极端最低 -16.5 ℃，低温 Voc 校核比深圳更紧（串联可行域 [4,7] vs [4,8]）；夏季供能比高达 2.8~4.4（大富余），与深圳（1.2~2.4）形成鲜明对比。

## 1. 设计输入（均来自已完成工作包，来源见各文档）

| 输入 | 取值 | 来源 |
|---|---|---|
| 交流侧日用电量 E_AC | **7.82 kWh/d**（冬季采暖季设计点） | W1 负荷调查-拉萨.md |
| 最不利设计月 | **12 月** | W2 太阳能资源-拉萨.md（R=1.85 最大） |
| 设计面峰值日照时数 H_T,min | **4.74 h/d**（30° 倾斜面，12 月） | W2 倾角核算-拉萨.md |
| 综合路径效率 eta_path | **0.782** | W3 系统组成与能量损失-拉萨.md |
| 最低环境温度 T_min | **-16.5 ℃** | W2（极端最低，低温 Voc 校核） |
| 最高组件温度 T_cell | **60.7 ℃（极端）/ 44.2 ℃（常态 6 月）** | W2 §5（NOCT 公式） |
| 电池侧充电电压 V_bat,chg | 54.4 V | W4 |
| 电池侧充电电流上限 | 5 × 50 A = 250 A | W4 方案 A（BNP-5120BM ×5） |

## 2. 阵列容量（指导书 §6.1）

    P_PV,min = E_AC * K_PV / (H_T,min * eta_path) = 7.82 * 1.10 / (4.74 * 0.782) = 2.32 kWp

| 系数 | 取值 | 取值依据 |
|---|---|---|
| K_PV 容量储备系数 | **1.10** | 组件长期衰减（N 型 TOPCon 25 年约 87%+）、灰尘遮挡、失配与 MPPT 跟踪误差；与 W4 K_R=1.10 同口径（指导书 §6.1，各损失只计一次） |
| H_T,min | 4.74 h/d | 倾角 30°、正南，12 月倾斜面峰值日照时数（W2 倾角核算） |
| eta_path | 0.782 | W3 综合路径效率 |

> 口径一致检查：K_PV=1.0 时 P_PV = 2.11 kWp；正式采用 K_PV=1.10 -> 2.32 kWp。

## 3. 组件选型（真实产品）

| 参数 | 数值 | 来源 |
|---|---|---|
| 型号 | 隆基 Hi-MO 7 LR7-72HGD-600M（N 型 TOPCon，单面 600 W） | SolarProof 产品参数页（查询日期 2026-09-01） |
| 额定功率 P_mpp | 600 W（STC） | 同上 |
| 开路电压 Voc（STC） | 52.22 V | 同上 |
| 最大功率点电压 Vmp（STC） | 44.12 V | 同上 |
| 短路电流 Isc（STC） | 14.49 A | 同上 |
| 最大功率点电流 Impp（STC） | 13.60 A | 同上 |
| NOCT | 45 ℃ | 同上 |
| Voc 温度系数 beta_Voc | -0.23 %/℃（-0.0023/℃） | 同上 |
| Vmp 温度系数 beta_Vmp | -0.28 %/℃（-0.0028/℃） | 按同系列 Pmax 温度系数，最终以官方 datasheet 为准 |
| 尺寸 | 1134 × 2382 mm | 同上 |
| 最大串联熔断器 | 30 A | 同上 |

> 选型理由：N 型 TOPCon 为 2026 年户用主流，600 W 级组件数量少、BOS 成本低；与深圳示例同款组件，便于对比两城市设计差异（同组件、不同城市校核结果不同）。

## 4. 组件温度修正（指导书 §6.2）

低温开路电压（T_min = -16.5 ℃）：

    Voc,cold = Voc,STC * [1 + beta_Voc*(T_min - 25)] = 52.22 * [1 + (-0.0023)*(-16.5 - 25)] = 57.21 V

高温最大功率点电压：
- 常态最热月（T_cell = 44.2 ℃）：Vmp,hot = 44.12 * [1 + (-0.0028)*(44.2 - 25)] = 41.75 V
- 极端工况（T_cell = 60.7 ℃）：Vmp,hot = 44.12 * [1 + (-0.0028)*(60.7 - 25)] = 39.71 V

低温最大功率点电压（检查 MPPT 上限）：Vmp,cold = 44.12 * [1 + (-0.0028)*(-16.5 - 25)] = 49.25 V

> 与深圳对比：T_min 由 0.2 ℃ 降至 -16.5 ℃，Voc,cold 由 55.20 V 升至 **57.21 V**；T_cell,max 由 70 ℃ 降至 **60.7 ℃**（拉萨夏季凉爽），Vmp,hot 由 38.56 V 升至 39.71 V——低温侧更紧、高温侧更宽裕。

## 5. 串联数量（指导书 §6.3）

控制器沿用 **Growatt SPF 5000 ES**（48 V 离网一体机，单 MPPT；MPPT 120~430 V、最大 PV 输入 450 V、每 MPPT 输入电流 22 A、最大 PV 输入功率 6000 W，W6 确认）：

    N_S,min = ceil( V_MPPT,min / Vmp,hot ) = ceil( 120 / 39.71 ) = 4   （极端高温口径）
    N_S,max = floor( V_ctrl,max / Voc,cold ) = floor( 450 / 57.21 ) = 7

可行范围：4 小于等于 N_S 小于等于 7（N_S,min 小于等于 N_S,max ✅）

> 与深圳对比：N_S,max 由 8 收窄至 **7**（拉萨低温 Voc 更高所致）；N_S,min 同为 4。

## 6. 并联数量与实际装机（指导书 §6.4）

| N_S | 单串功率(W) | N_P,PV = ceil(2320/(N_S*600)) | 实际装机(kWp) | 12 月供能比 | 是否可行 |
|-----|---|---|---|---|---|
| 4 | 2400 | 1 | 2.40 | 1.14 | 可行但余量偏紧 |
| **5** | **3000** | **1** | **3.00** | **1.42** | ✅ 选定 |
| 6 | 3600 | 1 | 3.60 | 1.71 | 可行（偏大） |
| 7 | 4200 | 1 | 4.20 | 2.00 | 可行（过大） |

**选定：N_S = 5、N_P = 1，实际装机 P_PV = 5 × 1 × 600 W = 3.00 kWp**（为最小需求 2.32 kWp 的 1.29 倍）。

> 不选 4 串（2.40 kWp）的原因：其 12 月供能比仅 1.14，低于深圳示例的参照基准（最不利月 1.20）；拉萨冬季有高原粉尘、偶发积雪/结霜与 BMS 低温充电损耗，K_PV=1.10 外宜再留供能余量，故取 5 串使 12 月供能比达 1.42。
> 不选 6/7 串的原因：容量超出需求 55%/81%，增加组件与屋面占地；留 1 路 MPPT 空余便于日后扩容。

## 7. 校核汇总（指导书 §6.4 + 表 4）

| 项目 | 计算结果 | 设备允许值 | 结论 |
|---|---|---|---|
| 最不利月所需容量 | 2.32 kWp | — | — |
| 组件型号和额定功率 | 隆基 LR7-72HGD-600M × 5 | — | — |
| 低温开路电压（组串） | 5 × 57.21 = 286.1 V | 不大于 450 V（控制器最大输入） | ✅ |
| 低温开路电压（组串） | 286.1 V | 不大于 430 V（MPPT 电压上限） | ✅ |
| 高温最大功率点电压（组串） | 5 × 39.71 = 198.5 V（60.7 ℃） | 不低于 120 V（MPPT 下限） | ✅ |
| 低温最大功率点电压（组串） | 5 × 49.25 = 246.2 V | 不大于 430 V（MPPT 上限） | ✅ |
| 每串组件数量 | **5** | [4, 7] | ✅ |
| 并联组串数量 | **1** | — | ✅ |
| 阵列实际装机容量 | **3.00 kWp** | 不大于 6000 W（控制器最大输入功率） | ✅ |
| 阵列最大功率点电流 | 1 × 13.60 = 13.6 A | 不大于 22 A（每 MPPT 输入电流） | ✅ |
| 阵列短路电流 | 1 × 14.49 = 14.49 A | 不大于 22 A（每 MPPT 输入电流） | ✅ |
| 每路输入功率 | 3.00 kW | 不大于 6.0 kW | ✅ |

> 组串反向过流：N_P=1 时无并联组串间反向电流，单串最大串联熔断器 30 A 满足 Isc=14.49 A。

## 8. 逐月供能量复核（指导书 §6.1）

E_PV,m = P_PV × H_T,m × eta_path，H_T,m 取倾角 30° 逐月倾斜面辐照（W2 倾角核算）：

| 月份 | 1 | 2 | 3 | 4 | 5 | 6 | 7 | 8 | 9 | 10 | 11 | 12 |
|---|---|---|---|---|---|---|---|---|---|---|----|----|
| H_T,m (kWh/m2·d) | 4.90 | 5.31 | 6.20 | 6.39 | 6.84 | 7.21 | 5.93 | 5.92 | 5.81 | 5.80 | 5.34 | 4.74 |
| E_PV,m (kWh/d) | 11.51 | 12.46 | 14.55 | 14.98 | 16.05 | 16.92 | 13.92 | 13.88 | 13.62 | 13.62 | 12.53 | 11.11 |
| E_AC,m (kWh/d) | 7.82 | 7.82 | 7.82 | 4.82 | 3.62 | 4.97 | 4.97 | 4.97 | 3.62 | 4.82 | 7.82 | 7.82 |
| 供能比 E_PV/E_AC | 1.47 | 1.59 | 1.86 | 3.11 | 4.43 | 3.40 | 2.80 | 2.79 | 3.76 | 2.82 | 1.60 | **1.42** |

> 12 个月全部满足 E_PV,m 大于等于 E_AC,m ✅。最不利月 12 月供能比 1.42（余量 42%）；过渡月（4、10 月）供能比 2.8~3.1；夏季（5–9 月）供能比高达 2.8~4.4——全年大富余，夏季富余部分充入蓄电池（充满后弃光），不依赖公共电网（指导书 §6.1 口径）。
> 与深圳对比：深圳最不利月（10 月）供能比 1.20、夏季 1.28~1.58；拉萨 12 月 1.42、夏季 2.8~4.4——**城市差异在逐月复核中一目了然**。

## 9. 对 W4 的回填（数据一致性，任务书红线：三文件一致）

- W4 §5 充电电流按 P_PV=3.00 kWp 计算：

    I_chg = min( P_PV * eta_MPPT / V_bat,chg , I_ctrl,out,max ) = min( 3000*0.96/54.4 , 100 ) = 52.9 A

- 3.00 kWp 对应逐月供能在 §8 已全部复核通过，W4 无需再改容量口径（W4 已按 3.00 kWp 预填 I_chg=52.9 A）。

## 10. 待确认事项（W6/W8 回填）

1. Growatt SPF 5000 ES 官方 datasheet（W6 按拉萨重新校核：低温 Voc 286.1 V、MPPT 两侧、3.00 kW 输入功率）；
2. 组件 Vmp 温度系数以官方 datasheet 为准（暂按 -0.28 %/℃）；
3. 屋面尺寸与安装面积（W8 阵列布置用：5 块组件 1134×2382 mm，单排 1 列，排间节距 2.13 × L，约需 5.7 m × 5.1 m 屋面）；
4. 高海拔（3650 m）对组件选型无影响（光伏组件无海拔降额），但控制器/逆变器需按海拔降额校核（W6）。

## 11. 输出汇总（供 W6/W8/W11 使用）

| 结果 | 数值 |
|---|---|
| 组件 | 隆基 Hi-MO 7 LR7-72HGD-600M × 5 |
| 串并联 | **5 串 × 1 并**（N_S=5, N_P=1） |
| 实际装机容量 | **3.00 kWp** |
| 组串低温开路电压 | 286.1 V |
| 组串工作电压范围 | 198.5~246.2 V（高温~低温，MPPT 120~430 V 内） |
| 阵列短路/工作电流 | 14.49 A / 13.6 A |
| 对应充电电流（回填 W4） | 52.9 A |
| 设计倾角/朝向 | 30° / 正南（W2 倾角核算） |
| 排间节距 | 2.13 × L（W8 布置用） |
