sunny1043/offgrid-pv-course-design/差异化城市设计/控制器逆变器设计-兰州.md

# 控制器与逆变器设计 — 兰州（W6）

> 依据：指导书 §7、任务书 §4.5。状态：本地草稿。
> 兰州差异化：单台 SPF 5000 ES 即可（阵列 3.60 kWp 单串）；新增 **8 度抗震设防对设备固定**与低温充电策略的校核。

## 1. 选型：Growatt SPF 5000 ES（单台）

| 参数 | 数值 | 来源 |
|---|---|---|
| 额定交流功率 | 5000 W | 官方 Datasheet 2024-09 |
| 短时浪涌 | 10000 VA | 同上 |
| 峰值效率 | 93% | 同上 |
| MPPT 电压范围 | 120~430 V | 同上 |
| 最大 PV 输入电压 | 450 V | 同上 |
| 每 MPPT 最大输入电流 | 22 A | 同上 |
| 最大 PV 输入功率 | 6000 W | 同上 |
| 最大太阳能充电电流 | 100 A | 同上 |

## 2. 逆变器侧校核

| 校核项 | 需求 | 能力 | 结论 |
|---|---|---|---|
| 连续功率 | P_max = 4.6 kW | 5.0 kW | ✅（利用率 92%） |
| 短时功率 | P_short = 5.2 kW | 10 kVA 浪涌 | ✅ |
| 交流输出电流 | 约 20.9 A | 额定 | ✅ |
| 电池侧放电 | 119.5 A | 5×100=500 A | ✅ |

## 3. MPPT 控制器侧校核

| 校核项 | 计算 | 允许值 | 结论 |
|---|---|---|---|
| 组串低温 Voc | 348.0 V | ≤450 V；≤430 V | ✅ |
| 组串高温 Vmp | 231.1 V | ≥120 V | ✅ |
| 组串低温 Vmp | 300.4 V | ≤430 V | ✅ |
| 输入电流 | 14.49 / 13.6 A | ≤22 A | ✅ |
| 输入功率 | 3.60 kW | ≤6.0 kW | ✅ |
| 充电电流 | min(3600×0.96/54.4,100) = 63.5 A | ≤100 A | ✅ |

## 4. 兰州特有校核（差异化重点）

1. **8 度抗震设防**：兰州位于 8 度抗震设防区，逆变器/电池柜/母排固定须按抗震要求（GB 50011）设计；支架（W8）须做抗震校核——这是深圳/哈尔滨/拉萨方案都没有的明确约束（哈尔滨约 6~7 度、兰州 8 度最严）；
2. **低温充电策略**：-23.1 ℃ 极端低温，设备间保温不低于 10 ℃（W4 §5），BMS 低温保护与逆变器充电策略匹配；
3. **干燥少雨、冬季偶有浮尘**：组件清扫周期建议缩短（运行说明），支架按当地风压校核。

## 5. 回填闭环

| 参数 | 取值 | 回填 |
|---|---|---|
| eta_inv / eta_ctrl | 0.93 / 0.96 | W3/W4/W5 |
| I_ctrl,out,max | 100 A | W4/W5 I_chg |
| V_bat,min | 45 V | W4 放电电流 |

## 6. 待确认/下一步

1. 8 度抗震的设备固定与支架校核（W8，需当地抗震设防参数）；
2. W7 线缆/保护：直流侧按 119.5 A/63.5 A、交流侧按 20.9 A；
3. W9 图纸与设备清单一致（T1-01/02/03）。
