sunny1043/offgrid-pv-course-design/差异化城市设计/控制器逆变器设计-拉萨.md

# 控制器与逆变器设计 — 拉萨（W6）

> 依据：设计指导书 §7（MPPT 控制器与离网逆变器选型）、课程设计任务书 §4.5；输入来自 W1（P_max/P_short）、W4（蓄电池）、W5（光伏阵列）。
> 状态：本地草稿（拉萨差异化新建）。
> 拉萨差异化：连续/短时功率校核比深圳更紧（P_max 4.6 kW vs 3.0 kW）；新增**高海拔（3650 m）功率降额校核**与**低温充电策略**——这两项是深圳方案没有的检查点（答辩重点）。

## 1. 选型：Growatt SPF 5000 ES（离网一体机，含 MPPT 控制器 + 逆变器）

| 参数 | 数值 | 来源 |
|---|---|---|
| 型号 | Growatt SPF 5000 ES（离网一体机） | 官方 Datasheet 2024-09，查询日期 2026-09-01 |
| 额定交流功率 | 5000 W（连续） | 同上 |
| 短时浪涌 | 10000 VA | 同上 |
| 峰值效率 eta_inv | 93% | 同上 |
| MPPT 电压范围 | 120~430 V | 同上 |
| 最大 PV 输入电压 | 450 V | 同上 |
| 每 MPPT 最大输入电流 | 22 A | 同上 |
| 最大 PV 输入功率 | 6000 W（STC） | 同上 |
| 最大太阳能充电电流 | 100 A | 同上 |
| 电池电压 | 48 V 级（V_bat,min = 45 V） | 同上 |

> 与深圳一致选用该机型，但**按拉萨的负荷与温度条件重新校核**，且新增海拔降额与低温充电两项深圳未要求的检查。

## 2. 逆变器侧校核（指导书 §7.2）

| 校核项 | 拉萨需求 | 设备能力 | 结论 |
|---|---|---|---|
| 连续功率 | P_max = 4.6 kW（冬季） | 5.0 kW | ✅（利用率 92%，明显高于深圳的 60%） |
| 短时功率 | P_short = 5.2 kW | 10 kVA 浪涌 | ✅ |
| 交流输出电流 | I_ac = 5000 / 220 = 22.7 A（额定） | 交流额定 | ✅（P_max=4.6 kW 时约 20.9 A） |
| 直流最低电压电流 | I_dis = 5000/(45×0.93) = 119.5 A | 蓄电池侧 5×100=500 A | ✅ |
| 低压切断 | 须设置不低于 44.8 V | 可设置 | ✅ |

> 拉萨冬季 P_max=4.6 kW 使逆变器连续利用率升至 92%（深圳仅 60%）——设备处于更接近额定的工作点，这是电采暖负荷的直接体现；短期烧水高峰（4.6 kW、15 min）仍在 5 kW 额定内。

## 3. MPPT 控制器侧校核（指导书 §7.1，两侧都要）

**光伏输入侧（高压小电流）**：

| 校核项 | 拉萨计算结果 | 设备允许值 | 结论 |
|---|---|---|---|
| 组串低温开路电压 | 5 × 57.21 = 286.1 V（T_min=-16.5 ℃） | 不大于 450 V（最大输入）；不大于 430 V（MPPT 上限） | ✅ |
| 组串高温工作电压 | 5 × 39.71 = 198.5 V（60.7 ℃） | 不低于 120 V（MPPT 下限） | ✅ |
| 组串低温工作电压 | 5 × 49.25 = 246.2 V | 不大于 430 V（MPPT 上限） | ✅ |
| 阵列短路/工作电流 | 14.49 A / 13.6 A | 不大于 22 A（每 MPPT） | ✅ |
| 阵列输入功率 | 3.00 kW | 不大于 6.0 kW | ✅ |

**蓄电池侧（低压大电流）**：

| 校核项 | 拉萨计算结果 | 设备允许值 | 结论 |
|---|---|---|---|
| 最大充电电流 | min(3000×0.96/54.4, 100) = 52.9 A | 100 A（控制器输出限流） | ✅ |
| 充电电流与电池匹配 | 52.9 A | 5 × 50 A = 250 A | ✅ |

> 与深圳对比：组串低温 Voc 由 220.8 V 升至 286.1 V（仍在 450 V 内，但裕量从 229 V 收窄到 164 V）；充电电流由 42.4 A 升至 52.9 A。

## 4. 拉萨特有校核（差异化重点，深圳方案无此检查）

### 4.1 高海拔功率降额（3650 m）

- 电子设备（逆变器/控制器）额定功率通常按海拔不高于 2000 m 标定；海拔升高空气密度下降，散热变差、绝缘裕度降低，需按厂家降额系数复核；
- **初估敏感性**：若按常规每 1000 m 降额约 8~10% 计，3650 m（高出 2000 m 基准约 1650 m）降额约 13~17%，5 kW 降额后约 **4.1~4.4 kW**，接近甚至低于 P_max=4.6 kW；
- **处理**：① 优先向厂家确认 SPF 5000 ES 在 3000 m+ 的额定值（部分品牌给出高原额定或 3000 m 以上全额）；② 若确认后连续能力不足 4.6 kW，则上调一档（如 SPF 6000 ES）或选厂家高原型号；
- **本方案基准取值**：按「厂家高原额定 5 kW 可维持」暂计，但 W11 前必须补充厂家海拔额定资料并在报告中说明（答辩重点）。

### 4.2 蓄电池低温充电策略

- 磷酸铁锂在 0 ℃ 以下充电受 BMS 低温保护限制；拉萨冬季夜间设备间可能低于 0 ℃；
- 处理：设备间保温（不低于 10 ℃）+ 必要时配低温加热（W4 §6/§8 已论证其经济性）；BMS 与逆变器充电策略匹配（低温降流/延时充电）；
- 此策略决定冬季「白天充电—夜间放电」能否正常循环，是拉萨冬季运行的硬约束。

### 4.3 冬季大富余与弃光

- 拉萨夏季（5–9 月）光伏日发电量为负荷的 2.8~4.4 倍，电池充满后需弃光；SPF 5000 ES 支持充电限流/限功率设置，可在 BMS 满电时自动降载（无需额外硬件，但要在运行说明中写明）。

## 5. 回填闭环（W3/W4/W5 一致性）

| 参数 | 取值 | 回填去向 |
|---|---|---|
| eta_inv | 0.93 | W3 效率表、W4 容量公式 |
| eta_ctrl | 0.96 | W3 效率表、W5 充电电流 |
| I_ctrl,out,max | 100 A | W4/W5 I_chg 第二项 |
| V_bat,min | 45 V | W4 放电电流校核 |
| MPPT 电压/电流限值 | 120~430 V、22 A、450 V | W5 串并联校核 |

## 6. 输出汇总（供 W7 线缆保护 / W9 图纸 / W11 成本）

| 项目 | 结果 |
|---|---|
| 机型 | Growatt SPF 5000 ES（离网一体机） |
| 连续/短时功率 | 4.6 kW / 5.2 kW（需求） | 5.0 kW / 10 kVA（能力） |
| MPPT 两侧校核 | 全通过（§3） |
| 高海拔降额 | 待厂家高原额定确认（§4.1） |
| 低温充电 | 设备间保温不低于 10 ℃（§4.2） |
| 交流输出额定电流 | 约 22.7 A（W7 交流线缆输入） |
| 蓄电池侧最大电流 | 放电 119.5 A / 充电 52.9 A（W7 直流线缆输入） |

## 7. 待确认/下一步

1. SPF 5000 ES 在 3000 m+ 海拔的额定功率（厂家资料，W11 前补齐）；
2. BMS 低温充电策略与逆变器充电设置匹配（厂家确认）；
3. W7 线缆/保护：直流侧按 I_dis=119.5 A、I_chg=52.9 A 选截面；交流侧按 I_ac 约 22.7 A；
4. 三张图纸与设备清单须与此处型号、参数一致。
