sunny1043/offgrid-pv-course-design/差异化城市设计/系统组成与能量损失-哈尔滨.md

# 系统组成与能量损失口径 — 哈尔滨（W3）

> 依据：指导书 §1/§4、任务书 §4.2。状态：本地草稿。系统框图沿用 diagram/ 通用图。

## 1. 系统组成与三个电气位置

同深圳/拉萨：光伏方阵 -> 直流保护 -> MPPT 控制器 -> 蓄电池及 BMS -> 离网逆变器 -> 交流配电 -> 负荷。三个电气位置（光伏输入侧 / 48 V 级蓄电池侧 / 220 V 交流负荷侧）必须分清，不能跨侧使用电流。

## 2. 能量与功率的口径区分

| 量 | 本方案取值 | 决定的设计环节 |
|----|---|---|
| 日用电量 E_AC | 7.82 kWh/d（冬季采暖季） | 蓄电池（W4）、光伏（W5） |
| 最大同时功率 P_max | 4.6 kW（冬季） | 逆变器额定（W6） |
| 短时冲击功率 P_short | 5.2 kW | 逆变器短时校核（W6） |

## 3. 能量流向与各环节效率（指导书 §4.2）

| 环节 | 符号 | 取值 |
|---|---|---|
| 光伏直流线缆 | eta_cable_dc | 0.98 |
| MPPT 控制器 | eta_ctrl | 0.96 |
| 蓄电池充电 | eta_batt_ch | 0.95 |
| 蓄电池放电 | eta_batt_dis | 0.95 |
| 离网逆变器 | eta_inv | 0.93（SPF 5000 ES 官方峰值） |
| 交流线缆 | eta_cable_ac | 0.99 |
| 综合路径效率 | eta_path | 约 0.782 |

## 4. 24 h 能量平衡（冬季）

- 白天：光伏发电（但哈尔滨冬季白天短、辐照低）供负荷 + 充电池；
- 傍晚/夜间：电暖器 + 电热毯 + 炊事高峰，光伏 + 电池共同放电；
- 深夜：电池放电供负荷（电热毯持续）。

> 哈尔滨独有：冬季「光伏低产 + 采暖高负荷」同现，阵列容量由 12 月决定（W5 算得 6.0 kWp，是深圳/拉萨的 2 倍以上）；夏季辐照好但负荷含空调，供能比仍较高。

## 5. 计算口径声明（与 W4/W5 一致）

1. E_AC = 7.82 为交流侧日用电量，蓄电池公式直接使用，不重复除以 eta_inv；
2. 蓄电池容量公式内部已含 eta_inv；
3. 光伏阵列容量公式使用 eta_path；
4. 全文统一本节参数，换数据须注明来源日期。

## 6. 待确认

1. 高寒地区组件冬季结霜/积雪影响（W8 倾角 40° 利于自滑）；
2. 设备间保温（蓄电池低温，W4 §6/§8）。
