sunny1043/offgrid-pv-course-design/差异化城市设计/系统组成与能量损失-拉萨.md

# 系统组成与能量损失口径 — 拉萨（W3）

> 依据：设计指导书 §1（系统组成）、§4（能量损失和计算口径）、课程设计任务书 §4.2（运行关系说明）。
> 状态：本地草稿（拉萨差异化新建；系统框图沿用 diagram/ 通用图，无需按城市重绘）。
> 拉萨差异化：负荷季节性由「夏季空调」翻转为「冬季电采暖」；能量平衡由「冬夏辐照落差」变为「全年辐照极强、冬季采暖负荷最高、夏季大富余」。

## 1. 系统组成（指导书 §1.2）

   光伏方阵 -> 直流保护 -> MPPT控制器 -> 蓄电池及BMS -> 离网逆变器 -> 交流配电 -> 负荷
                                                | 充放电双向 |

（通用图见 diagram/系统组成图.png 与 diagram/能量流向图.png，SVG 源文件可编辑）

三个电气位置必须分清（指导书 §1.2 强调）：

| 电气位置 | 电压特征 | 电流特征 | 保护范围 |
|---|---|---|---|
| 光伏输入侧 | 组串电压（MPPT 范围） | 光伏电流（A 级） | 组串过流、直流隔离、直流 SPD |
| 48 V 级蓄电池侧 | 45~58 V | 大电流（数百 A 级） | 支路/总保护、BMS |
| 220 V 交流负荷侧 | 220 V / 50 Hz 单相 | 交流电流 | 交流断路器、RCD、SPD |

> 同一功率在不同电压下电流不同，不能用一侧电流直接用于另一侧设备选型（指导书 §1.2 原文警告）。

## 2. 能量与功率的口径区分（指导书 §4.1）

| 量 | 本方案取值 | 决定的设计环节 |
|----|---|---|
| 日用电量 E_AC | 7.82 kWh/d（冬季采暖季） | 蓄电池容量（W4）、光伏阵列容量（W5） |
| 最大同时功率 P_max | 4.6 kW（冬季，电采暖+炊事） | 逆变器额定功率（W6） |
| 短时冲击功率 P_short | 5.2 kW | 逆变器短时功率校核（W6） |

> 二者不能互相代替：电热水壶 1.8 kW 每天只运行约 9 分钟（日耗电 0.27 kWh），却显著抬升最大同时功率；冬季电暖器 1.2 kW 持续运行是拉萨 P_max 的主要来源（深圳则是空调）。报告全文须按此口径分开表述。

## 3. 能量流向与各环节效率（指导书 §4.2）

| 环节 | 符号 | 取值 | 覆盖能量路径 |
|---|---|---|---|
| 光伏直流线缆 | eta_cable_dc | 0.98 | 光伏到MPPT |
| MPPT 控制器 | eta_ctrl | 0.96 | 光伏到电池充电端 |
| 蓄电池充电 | eta_batt_ch | 0.95 | 控制器到电池 |
| 蓄电池放电 | eta_batt_dis | 0.95 | 电池到逆变器 |
| 离网逆变器 | eta_inv | 0.93 | 电池到交流负荷 |
| 交流线缆 | eta_cable_ac | 0.99 | 逆变器到配电到负荷 |
| 综合路径效率 | eta_path | 约 0.782 | 光伏到交流负荷（经电池） |

> 各损失只应计算一次（指导书 §4.2）；组件温度、失配损失不在此重复计入（W5 用含温度修正的月辐照数据）。

## 4. 效率取值来源与回填闭环

| 效率 | 取值 | 来源/依据 | 回填时机 |
|---|---|---|---|
| eta_inv | 0.93 | Growatt SPF 5000 ES 官方 Datasheet 峰值效率 93%（W6 选型） | W6 回填 |
| eta_ctrl | 0.96 | MPPT 控制器效率典型 0.95~0.97 | W6 回填 |
| eta_batt_ch / eta_batt_dis | 0.95 | 磷酸铁锂充放电效率典型值（GB/T 36276） | W4 选定模块后回填 |
| eta_cable | 0.98 / 0.99 | 铜缆短距离、按电压降核算取（W7 校核） | W7 回填 |

> 闭环：本表为课程设计典型值；设备选型完成后（W4/W6/W7）统一以实际产品规格书效率替换，口径不变。

## 5. 24 h 能量平衡与负荷管理（任务书 §4.2 要求，拉萨冬季口径）

运行关系：光伏发电到 MPPT 充电并直供负载；蓄电池承担昼夜能量平衡（2 d 自主供电）；逆变器把 48 V 直流转换为 220 V 交流供给负荷。

| 时段 | 能量平衡（冬季） |
|---|---|
| 白天（光伏出力 > 负荷） | 光伏经 MPPT 供负荷 + 富余充入电池；冬季日短但拉萨晴空辐照强，白天充电充分 |
| 傍晚/夜间（出力 < 负荷） | 电热毯 + 电暖器 + 炊事高峰：光伏 + 电池共同放电供负荷 |
| 深夜 | 电池放电到逆变器再到负荷（电热毯持续） |

负荷管理措施（W1 已落实）：电热水壶（19:00–19:15）与电饭煲、电暖器高峰错开（19:00 前电饭煲已结束）；电暖器集中在傍晚/夜间；电磁炉安排在周末午餐（电暖器未开时段）；洗衣安排在午后低谷。连续阴雨 2 d 内由电池独立支撑（E_AC = 7.82 kWh/d 口径，W4 核算）。

拉萨独有说明（答辩点）：夏季（5–9 月）负荷仅 3.62~4.97 kWh/d、辐照高达 5.6~7.2 kWh/m2·d，光伏日发电量约为负荷的 3.8~4.7 倍，夏季富余能量主要充入蓄电池（充满后弃光）；冬季采暖负荷最高但辐照仍强，供能比约 1.4~1.7。整年能量总体「冬紧夏松」，与深圳「夏紧冬松」相反。

## 6. 组成元素、保护配置与图纸对照（为 W9 铺垫）

| 系统元素 | 保护/配套 | 电压位置 | 对应图纸 |
|---|---|---|---|
| 光伏组件串 | 组串熔断器/断路器、直流隔离、直流 SPD | 光伏输入侧 | T1-01、T1-02 |
| 组串到MPPT 线缆 | 过流保护、极性防护 | 光伏输入侧 | T1-01 |
| MPPT 控制器 | 输入/输出端保护 | 48 V 侧 | T1-01 |
| 蓄电池模块（BMS） | 支路熔断器、总保护、检修隔离 | 48 V 侧 | T1-01、T1-03 |
| 离网逆变器 | 直流侧隔离、交流输出断路器 | 48 V 与 220 V 之间 | T1-01 |
| 交流配电 | MCB、RCD、交流 SPD | 220 V 侧 | T1-01 |
| 接地/等电位 | 保护接地、等电位连接 | 全系统 | T1-01、T1-03 |

## 7. 计算口径声明（关键，W4/W5 一致性前提）

1. E_AC = 7.82 kWh/d 为交流侧日用电量（冬季设计点），蓄电池公式直接使用 E_AC；
2. 蓄电池容量公式内部已含逆变器效率 eta_inv（电池到逆变器到交流负荷路径，见 W4），因此 E_AC 不得再重复除以 eta_inv（指导书 §2.2 原文警告）；
3. 光伏阵列容量公式使用综合路径效率 eta_path（阵列到交流负荷、含充放电路径），见 W5；
4. 报告全文统一使用本节参数，换用其他来源数据时在正文说明来源与日期。

## 8. 为 W4/W5 准备的效率参数表

| 用途 | 公式环节 | 参数 | 取值 |
|---|---|---|---|
| W4 蓄电池容量 | E_B = E_AC·N / (k·DOD·eta_dis·eta_inv·K_T) | 放电效率 eta_dis | 0.95 |
| | | 逆变器效率 eta_inv | 0.93 |
| | | 放电深度 DOD | 0.90（厂商）/ 0.80（保守） |
| | | 容量储备系数 k | 1.05~1.10 |
| | | 低温修正 K_T | 1.00（设备间保温不低于 10 ℃）；无保温敏感性 0.70 见 W4 §8 |
| W5 光伏容量 | P_PV = E_AC / (H_tilt·eta_path) | 综合路径效率 eta_path | 0.782 |
| | | 设计面峰值日照时数 H_tilt | 4.74 h/d（12 月，倾角 30°） |

## 9. 待确认

1. 逆变器、MPPT、电池具体型号选定后，按 §4 以厂商效率值回填（W6 拟沿用 Growatt SPF 5000 ES，与深圳一致，需按拉萨校核）；
2. 蓄电池 DOD 与储备系数的最终取值在 W4 结合产品说明确定；
3. 高海拔（3650 m）对逆变器/控制器额定功率的降额影响，W6 校核时说明（厂家额定一般按海拔不高于 2000 m 给出，拉萨需按降额系数或厂家高原型号校核）。
