sunny1043/offgrid-pv-course-design/docs/系统组成与能量损失-深圳.md

# 系统组成与能量损失口径 — 深圳（W3）

> 依据：设计指导书 §1（系统组成）、§4（能量损失和计算口径）、课程设计任务书 §4.2（运行关系说明）。
> 状态：全队共享示例；本地草稿（含 `diagram/` 下 SVG 源文件与 PNG 图，上传时需一并提交）。

## 1. 系统组成（指导书 §1.2）

```
光伏方阵 → 直流保护 → MPPT控制器 → 蓄电池及BMS → 离网逆变器 → 交流配电 → 负荷
                                   ↕ 充放电双向
```

图1 户用离网光伏发电系统组成

（SVG 源文件：`diagram/系统组成图.svg`，可编辑修改）

**三个电气位置必须分清**（指导书 §1.2 强调）：

| 电气位置 | 电压特征 | 电流特征 | 保护范围 |
|---|---|---|---|
| 光伏输入侧 | 组串电压（MPPT 范围） | 光伏电流（A 级） | 组串过流、直流隔离、直流 SPD |
| 48 V 级蓄电池侧 | 45~58 V | 大电流（数百 A 级） | 支路/总保护、BMS |
| 220 V 交流负荷侧 | 220 V / 50 Hz 单相 | 交流电流 | 交流断路器、RCD、SPD |

> 同一功率在不同电压下电流不同，**不能用一侧电流直接用于另一侧设备选型**（指导书 §1.2 原文警告）。

## 2. 能量与功率的口径区分（指导书 §4.1）

| 量 | 本方案取值 | 决定的设计环节 |
|----|---|---|
| 日用电量 E_AC | 6.99 kWh/d | 蓄电池容量（W4）、光伏阵列容量（W5） |
| 最大同时功率 P_max | 3.0 kW | 逆变器额定功率（W6） |
| 短时冲击功率 P_short | 3.6 kW | 逆变器短时功率校核（W6） |

> **二者不能互相代替**：电热水壶 1.8 kW 每天只运行约 9 分钟（日耗电 0.27 kWh），对日用电量影响很小，却显著抬升最大同时功率；反之日用电量 6.99 kWh/d 也不能直接当作逆变器功率。报告全文须按此口径分开表述。

## 3. 能量流向与各环节效率（指导书 §4.2）

图2 能量流向与各环节效率

（SVG 源文件：`diagram/能量流向图.svg`）

| 环节 | 符号 | 取值 | 覆盖能量路径 |
|---|---|---|---|
| 光伏直流线缆 | η_cable_dc | 0.98 | 光伏→MPPT |
| MPPT 控制器 | η_ctrl | 0.96 | 光伏→电池充电端 |
| 蓄电池充电 | η_batt_ch | 0.95 | 控制器→电池 |
| 蓄电池放电 | η_batt_dis | 0.95 | 电池→逆变器 |
| 离网逆变器 | η_inv | 0.93 | 电池→交流负荷 |
| 交流线缆 | η_cable_ac | 0.99 | 逆变器→配电→负荷 |
| **综合路径效率** | **η_path** | **≈ 0.782** | 光伏→交流负荷（经电池） |

> 各损失只应计算一次（指导书 §4.2）；组件温度、失配损失不在此重复计入（W5 用含温度修正的月辐照数据）。

## 4. 效率取值来源与回填闭环

| 效率 | 取值 | 来源/依据 | 回填时机 |
|---|---|---|---|
| η_inv | 0.93 | **Growatt SPF 5000 ES 官方 Datasheet 峰值效率 93%（W6 已选定机型）**；原任务书示例 0.92 为保守口径 | W6 已回填 |
| η_ctrl | 0.96 | MPPT 控制器效率典型 0.95~0.97（一体机未单独标注，保守取 0.96） | W6 已回填 |
| η_batt_ch / η_batt_dis | 0.95 | 磷酸铁锂充放电效率典型值（GB/T 36276 及厂商数据） | W4 选定模块后回填 |
| η_cable | 0.98 / 0.99 | 铜缆短距离、按电压降核算取（W7 校核） | W7 回填 |

> **闭环**：本表为课程设计典型值；设备选型完成后（W4/W6/W7）统一以实际产品规格书效率替换，口径不变。任何替换须在报告中注明来源与查询日期。

## 5. 24 h 能量平衡与负荷管理（任务书 §4.2 要求）

**运行关系**：光伏发电 → MPPT 充电并直供负载；蓄电池承担昼夜能量平衡（2 d 自主供电）；逆变器把 48 V 直流转换为 220 V 交流供给负荷。

| 时段 | 能量平衡 |
|---|---|
| 白天（光伏出力 > 负荷） | 光伏经 MPPT 供负荷 + 富余充入电池 |
| 傍晚/阴雨（出力 < 负荷） | 光伏 + 电池共同放电供负荷 |
| 夜间 | 电池放电 → 逆变器 → 负荷 |

**负荷管理措施**（W1 已落实）：电热水壶（19:00–19:15）与电磁炉（周末 19:15 起）错峰；空调运行时段固定（12:00–14:00 + 18:00–24:00）；洗衣安排在午后低谷。连续阴雨 2 d 内由电池独立支撑（E_AC = 6.99 kWh/d 口径，W4 核算）。

## 6. 组成元素 ↔ 保护配置 ↔ 图纸对照（为 W9 铺垫）

| 系统元素 | 保护/配套 | 电压位置 | 对应图纸 |
|---|---|---|---|
| 光伏组件串 | 组串熔断器/断路器、直流隔离、直流 SPD | 光伏输入侧 | T1-01、T1-02 |
| 组串→MPPT 线缆 | 过流保护、极性防护 | 光伏输入侧 | T1-01 |
| MPPT 控制器 | 输入/输出端保护 | 48 V 侧 | T1-01 |
| 蓄电池模块（BMS） | 支路熔断器、总保护、检修隔离 | 48 V 侧 | T1-01、T1-03 |
| 离网逆变器 | 直流侧隔离、交流输出断路器 | 48 V ↔ 220 V | T1-01 |
| 交流配电 | MCB、RCD、交流 SPD | 220 V 侧 | T1-01 |
| 接地/等电位 | 保护接地、等电位连接 | 全系统 | T1-01、T1-03 |

## 7. 计算口径声明（关键，W4/W5 一致性前提）

1. **E_AC = 6.99 kWh/d 为交流侧日用电量**（负荷调查结果），蓄电池公式直接使用 E_AC；
2. **蓄电池容量公式内部已含逆变器效率 η_inv**（电池→逆变器→交流负荷路径，见 W4），因此 E_AC **不得再重复除以 η_inv**（指导书 §2.2 原文警告）；
3. **光伏阵列容量公式使用综合路径效率 η_path**（阵列→交流负荷、含充放电路径），见 W5；
4. 报告全文统一使用本节参数，换用其他来源数据时在正文说明来源与日期。

## 8. 为 W4/W5 准备的效率参数表

| 用途 | 公式环节 | 参数 | 取值 |
|---|---|---|---|
| W4 蓄电池容量 | E_B = E_AC·N / (k·DOD·η_dis·η_inv·η_t) | 放电效率 η_dis | 0.95 |
| | | 逆变器效率 η_inv | 0.93 |
| | | 放电深度 DOD | 0.80（保守）/ 0.90（厂商） |
| | | 容量储备系数 k | 1.05~1.10 |
| | | 低温修正 η_t | 1.0（深圳低温影响小，说明后可不计） |
| W5 光伏容量 | P_PV = E_AC / (H_tilt·η_path) | 综合路径效率 η_path | 0.782 |
| | | 设计面峰值日照时数 H_tilt | 4.46 h/d（10 月，倾角 20°） |

## 9. 待确认

1. ~~逆变器、MPPT、电池具体型号选定后，按 §4 以厂商效率值回填~~（W6 已选定 Growatt SPF 5000 ES 并回填 η_inv=0.93、η_ctrl=0.96，2026-09-01）；
2. 蓄电池 DOD 与储备系数的最终取值在 W4 结合产品说明确定；
3. `diagram/` 目录（2 个 SVG + 2 个 PNG）随本文件一并上传仓库。
