sunny1043/offgrid-pv-course-design/docs/updates/2026-09-10/三城光伏图纸-DXF-R1/协作进度与图纸使用说明.md

# 深圳、拉萨、哈尔滨：DXF 图纸 R1

## 交付范围

2026-09-10 制图。每城三张，共九张可编辑 DXF：T1-01 系统电气主接线图、T1-02 光伏阵列及支架布置图、T1-03 设备间平面及安装接线图。另附九页 A3 PDF 预览及 DXF 文件检查记录。

用户所写“xdf”按工程制图常用 DXF 处理，本包不是 XDF，也不是 DWG。图纸是课程评审用待审方案，不是施工接线指令。

## 已核对的协作进度

读取仓库：https://github.com/sunny1043/offgrid-pv-course-design

锁定主分支快照：`35341ff4b786271a80270c279b37c3d78d3b4cc2`，提交时间 2026-09-08 11:43:17 UTC（北京时间19:43）。读取了 AGENTS.md、PROJECT_LOG.md、PROGRESS.md 和各城设计、线缆、布置与复核材料。Git 克隆遇到 TLS 失败，改经 GitHub API 下载同一提交的 ZIP 快照成功；没有使用桌面旧副本替代最新版。

| 城市/协作者线索 | 主分支实际材料进度 | 尚未闭合 |
|---|---|---|
| 深圳：Eh00712 主线，W6 有 D-coccus 贡献 | 已有 W1-W9 文档与三张图、成本分析、W12 报告与一致性复核、W13 答辩自查 | W10 实验原始数据、设备通信与工程终审 |
| 拉萨：日志标 Eh00712 主线/本机 DSH；最新提交作者 265522ghgv6hi | 9月7日修复提交包，9月8日重绘三张图，新增12章完整案例；已有成本、报告、自查 | SPF 5000 ES 在3650m的适用性/降额、实验数据、屋面尺寸矛盾 |
| 哈尔滨：有 D-coccus 复核修正提交 | 已有设计报告、成本、数据一致性复核和答辩自查；已有三张SVG/PDF图，9月7日有数据复核相关日志提交 | 双机套件/BMS匹配、实验数据、屋面尺寸及低温热工闭合 |

进度表并未完整列出哈尔滨等后续成果，部分行仍写“待本机提交”，不能据此认定主分支没有成果。上表以实际文件与提交记录共同判断，不将文件中的“全部通过”照搬成独立工程审查结论。

**查询边界**：未合并 PR 的查询返回 GitHub API 限流，未能核实 PR/其他分支/合作者本地未推送工作。本报告仅确认上述主分支快照。未修改、覆盖或推送远端仓库；本包为独立交付，供审阅后按仓库协作规范提交。

## 图纸采用的各城配置

| 城市 | 光伏（隆基 LR7-72HGD-600M） | 电池（Benhoo BNP-5120BM） | 逆变器 | 倾角 |
|---|---|---|---|---|
| 深圳 | 4块，4串1路，2.40kWp | 4并，20.48kWh | SPF 5000 ES ×1 | 20° |
| 拉萨 | 5块，5串1路，3.00kWp | 5并，25.60kWh | SPF 5000 ES ×1 | 30° |
| 哈尔滨 | 10块，两路独立5串，各接一台，6.00kWp | 5并，25.60kWh | SPF 5000 ES ×2，交流同步并机 | 40° |

电池模块均为51.2V/100Ah，完整模块并联，不串联。哈尔滨原文“5串×2并”在本图明确为两路独立光伏输入，避免误接成单台MPPT并联输入。以上设备数据沿用仓库，不是新完成的全套产品真实性认证。

主要文件来源：`docs/设计报告-深圳.md`、`docs/线缆保护防雷接地-深圳.md`、`docs/支架设备间布置-深圳.md`；`差异化城市设计/完整设计案例-拉萨.md`、`设计报告-哈尔滨.md` 以及相应城市的 `线缆保护防雷接地`、`支架设备间布置`、`控制器逆变器设计` 文件。

## 本次制图发现及处理

1. **拉萨屋面不够宽**。原稿5×1134=5670mm，原6m屋面即使不留安装缝也只剩两侧各165mm，不能同时满足各500mm。新增组件间缝20mm后阵列5750mm，至少需6750mm。本图画7000×5000mm备选屋面，两侧各625mm，明确待确认；不是声称现场屋面已扩大。
2. **哈尔滨同类矛盾**。两组各五块，组间300mm、组内八条20mm安装缝，总宽11800mm；两侧各500mm要求总宽至少12800mm，原12000mm不满足。本图画13000×6000mm备选方案，两侧各600mm。实际屋面若仍为12m，需要重新布置及遮挡核算，不能直接使用此方案。
3. **深圳补安装缝**。4×2382+3×20=9588mm，在12m屋面两侧各1206mm；组件保持原稿横向安装。新增20mm安装缝是制图假设，最终按压块/厂家安装要求。
4. **一体机电池端口纠正**。内置MPPT充电与逆变放电共用外部电池连接。本图保留每机70mm²/160A的原稿电池回路作待审物理路径，不虚构另一个10/16mm²充电端口。原C3及50/63A回路应回填报告和BOM，不可继续当作已选外接回路采购。
5. **电流口径**。5kW/220V约22.7A，不是20.9A；20.9A对应4.6kW负荷。保留原稿每台32A交流支路为待审值。哈尔滨两机具备10kW能力，不能仅用当前4.6kW负荷假设代替共用母排、导体、保护的最大电流校核；母排额定值仍待定。
6. **不伪装保护审核通过**。电池100A保护标为电池适用熔断器待核，不照抄“gPV即可保证电池保护”；100A与160A大小关系不能证明选择性。分断能力、故障电流、末端漏保类型、N-PE参考点、SPD的Ucpv/Up及后备保护均须专项复核。PV冷态Voc沿用原稿，仅作可追溯输入。
7. **布置适配**。设备间净尺寸沿用深圳/拉萨3000×2500、哈尔滨3500×2500，改北墙安装逆变器以缩短电池路线；厂家散热净距、端子容纳70mm²能力与实际展开线长仍须核实。柜后600、柜前800；门900外开。图中桥架/电缆为路径示意，不能直接用平面折线长度充当展开线长。
8. **热工与结构仍待核**。拉萨、哈尔滨保温/加热负荷未形成完整能量闭环，不能据此保证连续阴雨天数。图内保留原稿扩排节距作追溯，未将原太阳高度、雪荷载、简支梁计算声明为本次验证通过；本次实际只布置一排。锚固、防水节点与屋面承载未定。

一体机物理端口、BMS连接及双机通信的参考为 [Growatt 官方用户手册](https://fr.growatt.com/upload/file/20220811/da820612adc14a51f5de19b61f7a70b1.pdf)，章节 Battery Connection、Lithium Battery Connection、Parallel Installation Guide。手册说明电池与逆变器需正确极性连接和保护，BMS协议需匹配；并机BMS优先接主机。本包并未以此证明 Benhoo 已获厂家兼容认证。

## DXF 打开和编辑

- 格式：AutoCAD DXF R2013（AC1027），Unicode中文文字；长度单位毫米。
- 图层：FRAME图框、PV组件、POS直流单线、AC交流单线、PE接地、COMM通信、STRUCT支架、CLEAR检修区、DIM尺寸、HOLD待审事项等，可分别选择/隐藏/修改。
- T1-01 为单线示意图，不用于量取工程长度；单线代表DC正负两根或AC的L/N，并非把正负/N与PE短接。
- T1-02 模型按真实毫米绘制，A3打印比例1:75；T1-03模型按毫米绘制，A3打印比例1:25。图框也同比放大放入模型空间。打印可选模型范围、A3横向，核实比例。
- 尺寸标注为可编辑 TEXT 和 LINE，不是关联式DIMENSION；移动组件后必须人工重标，不会自动跟随。设备/保护采用简化单线符号，不宣称已通过完整制图标准审查。
- 中文文字样式CN引用 Arial Unicode.ttf。若另一台电脑无此字体，可将CN样式替换为支持中文的字体（不要将文字改为乱码编码）；字体并未打包分发。
- 未在实体CAD应用做兼容性验收；已使用ezdxf重新读取全部9文件，audit错误及自动修复均为0，核对文字数量，并检查A3预览。文件结构通过不等于电气/结构设计通过。

## 建议的协作回填顺序

先确认两城屋面尺寸及设备适用条件，再更新W7/W8/BOM/一致性复核，最后依据认可版本补保护与安装详图、答辩讲解。远端原图保留；本包应作为R1候选版评审，不应无说明覆盖合作者版本。
