sunny1043/offgrid-pv-course-design/docs/兰州-D1-D5-按指导书执行版.docx

设计城市：兰州（36.05°N，103.83°E，市区海拔约 1520 m）。

# 1 设计条件和系统组成

## 1.2 系统组成（指导书 §1.2）

系统能量流：光伏方阵 → 直流保护 → MPPT 控制器 → 蓄电池及 BMS → 离网逆变器 → 交流配电 → 负荷，蓄电池与控制器之间双向充放电。

指导书强调分清三个电气位置，同一功率在不同电压下电流不同，不能把一侧电流直接用于另一侧设备选型：①光伏输入侧（组串电压、A 级光伏电流，配组串过流/直流隔离/直流 SPD）；②48 V 级蓄电池侧（45~58 V、数百安培，配支路/总保护与 BMS）；③220 V 交流负荷侧（配交流断路器/RCD/SPD）。

# 2 家庭关键负荷计算（指导书 §2）

## 2.1 为什么采用负荷范围（指导书 §2.1）

指导书要求：负荷调查优先采用设备铭牌、能效标识或厂家公开资料；表 1 给出各分类建议范围用于检查总量是否合理，不要求机械取中值。下表为本方案16 台/组设备清单，功率与来源链接内联。

类别 | 设备（型号） | 额定功率（来源链接） | 时间×系数 | 日耗电(kWh/d) | 计算式
制冷 | 海尔 BCD-235WFCI 冰箱 | 0.54 kWh/24h（海尔官网）https://www.haier.com/cooling/20201112_150262.shtml | — | 0.54 | 能效标识日耗电
空调 | 美的 KFR-35GW/N8KS1-1P（仅夏季） | 额定制冷 845 W（美的商城）https://www.midea.cn/detail/index?itemid=1000000000400731698266 | 4h×0.3 | 1.01 | 0.845×4×0.3（夏季月）
采暖 | 双人电热毯 150 W | 150 W（典型） | 8h | 1.20 | 0.15×8
采暖 | 对流式电暖器 1200 W | 1200 W（典型） | 5h×0.5 | 3.00 | 1.2×5×0.5
照明 | 飞利浦 LED 9 W×8 | 9 W（标准） | 4.5h | 0.32 | 0.009×8×4.5
通信 | 小米路由器 AX3000 | 约 6 W（典型） | 24h | 0.14 | 0.006×24
通信 | Redmi 智能电视 A55 | 120 W（小米官网）https://www.mi.com/redmitv/a55/specs | 3.5h | 0.42 | 0.12×3.5
通信 | 笔记本 联想小新 Pro14 | 65 W 适配器/典型 40 W | 5h | 0.20 | 0.04×5
通信 | 手机快充 ×2 | 平均 10 W（假定） | 3h | 0.06 | 0.01×2×3
炊事 | 美的 FB40Simple111 电饭煲 | 860 W（美的商城）https://m.midea.cn/detail/index?itemid=1000000000400702348703 | 0.6h | 0.52 | 0.86×0.6
炊事 | 美的 WHJ1705b 电热水壶 | 1500 W（苏宁，修正原 1800）https://www.suning.com/item/0070154004/191593092.html | 0.15h | 0.23 | 1.5×0.15
炊事 | 方太 CXW-200-JQ03TS 油烟机 | 200 W（太平洋/官方）https://product.pconline.com.cn/hood/pk/param/619620_1331550.html | 0.5h | 0.10 | 0.2×0.5
炊事 | 格兰仕 P70D20TL-D4 微波炉 | 输出 700 W/输入约 1150 W（中关村）https://detail.zol.com.cn/ProductComp_param_244107-404197.html | 0.12h | 0.14 | 1.15×0.12
炊事 | 美的 C21-RT2170 电磁炉 | 2100 W（苏宁，C21 机型）https://m.suning.com/product/0000000000/12286980674.html | 0.5h/周 | 0.15 | 2.1×0.5/7
生活辅助 | 海尔 EG100MATE2S 洗衣机 | 洗涤 200 W/脱水 500 W（苏宁/海尔）https://product.suning.com/0070165541/12308658700.html | 0.5h+0.2h | 0.30 | 0.2×0.5+0.5×0.2+0.1
生活辅助 | 待机负荷 | 约 12 W（假定） | 24h | 0.29 | 0.012×24

## 2.2 日用电量（指导书 §2.2）

指导书要求：按 E=P×t×k 计算日用电量（单位 kWh/d，P 用 kW、t 用 h），取交流侧日用电量 E_AC=ΣE_i；蓄电池公式若已含逆变器效率，此处不得重复除以 η_inv；负荷合计应满足任务书分配区间。

公式（指导书 §2.2）：E_i = P_i × t_i × k_i；E_AC = Σ E_i

计算：基础负荷（不含空调与采暖）= 0.54+0.32+0.82+1.14+0.59 = 3.41 kWh/d；采暖 = 1.20+3.00 = 4.20 kWh/d。

运行口径 | 组成 | E_AC(kWh/d)
采暖月（11-3 月）设计点 | 基础 3.41 + 采暖 4.20 | 7.61
过渡月（4、10 月） | 基础 3.41 + 电热毯 1.20 | 4.61
夏季（6-8 月） | 基础 3.41 + 空调 1.01 | 4.42
温和月（5、9 月） | 基础 3.41 | 3.41

## 2.3 最大同时功率（指导书 §2.3）

指导书要求：建立 24 h 负荷运行表（30 min 或 1 h 时段），各时段同时功率 P_j=Σ(同时运行 P_i)，取 P_max=max P_j；错峰安排必须在运行表中体现，不能只在文字中说明。下表为兰州冬季工作日 24 h 运行表（同时功率，kW）。

时段 | 运行设备 | 同时功率(kW) | 叠加明细(kW)
00:00-06:00 | 电热毯+冰箱+路由+待机+手机充电 | 0.31 | 0.15+0.12+0.006+0.012+0.02
06:00-07:00 | +电饭煲（早餐） | 1.15 | 0.15+0.12+0.006+0.012+0.86
07:00-12:00 | 冰箱+路由+待机（电热毯关） | 0.14 | 0.12+0.006+0.012
12:00-13:00 | 基础+微波炉（短时） | 1.29 | 0.14+1.15
13:00-15:00 | 基础 | 0.14 | —
15:00-16:00 | 基础+洗衣机（洗涤/甩干） | 0.64 | 0.14+0.50
16:00-18:00 | 基础 | 0.14 | —
18:00-19:00 | 电暖器+电热毯+电饭煲+油烟机+照明+电视+冰箱+路由 | 2.73 | 1.2+0.15+0.86+0.20+0.072+0.12+0.12+0.006
19:00-19:15 | 上时段+电热水壶（烧水） | 4.23 | 2.73+1.5（冬季峰值）
19:15-20:00 | 电暖器+电热毯+照明+电视+冰箱+路由 | 1.67 | 1.2+0.15+0.072+0.12+0.12+0.006
20:00-22:30 | +笔记本 | 1.71 | 1.67+0.04
22:30-24:00 | 电热毯+照明+路由+冰箱 | 0.35 | 0.15+0.072+0.006+0.12

P_max：19:00-19:15 烧水时段叠加 = 1.2+0.15+1.5+0.86+0.20+0.072+0.12+0.12+0.006 = 4.23 ≈ 4.2 kW。

周末校核（电磁炉午餐、电暖器未开）≈ 3.5 kW < 4.2 kW → P_max = 4.2 kW；逆变器额定 5 kW 裕量系数 5/4.2 ≈ 1.19。

## 2.4 短时冲击功率（指导书 §2.4）

指导书要求：短时功率≈启动倍数×额定功率；系统短时功率=启动设备短时功率+同时运行其他负荷；启动倍数用厂家资料，变频/软启动设备不套固定倍数。

启动设备 | 启动倍数/依据 | 短时功率(kW)
冰箱压缩机 | 约 5 倍（运行期约 0.12 kW） | 0.60
洗衣机甩干 | 短时峰值 | 1.00
空调（变频，仅夏季） | 软启动，不套定频倍数 | 不计入冬季
电暖器/电热毯/水壶/电磁炉 | 阻性负载无冲击 | —

P_short = 4.23 + 0.60 ≈ 4.8 kW（最不利组合：烧水高峰 + 冰箱压缩机启动），用于逆变器短时校核（指导书 §7.2）。

# 3 太阳能资源和环境参数（指导书 §3）

## 3.1 数据来源（指导书 §3.1）

指导书要求：记录设计城市、经纬度、数据来源、统计时间范围、水平面或倾斜面辐照量、环境温度与查询日期；若只有水平面数据须说明倾斜面换算方法与安装倾角；并给出峰值日照时数。

数据项 | 采用值 | 来源链接
城市/坐标 | 兰州 36.05°N、103.83°E | NASA POWER 查询坐标
逐月辐照/散射/气温 | 2019-2023 五年平均 | NASA POWER（实测抓取，2026-09-06）https://power.larc.nasa.gov/api/temporal/monthly/point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
交叉验证 | PVGIS（ERA5）逐月对照 | 欧盟 PVGIShttps://re.jrc.ec.europa.eu/pvg_tools/en/
市区气候 | 海拔约 1520 m、年均约 10 ℃、年日照约 2446 h | 中国天气网·兰州城市介绍http://www.weather.com.cn/cityintro/101160101.shtml

倾斜面换算方法（指导书 §3.1 要求说明）：

采用 Liu-Jordan 各向同性模型，G_tilt(β)=B×R_b + D×(1+cosβ)/2 + G×ρ×(1−cosβ)/2，散射 D 用 NASA 实测；

对 β=0°~45° 逐月计算后，按“最不利月供能 + 全年总量”选倾角。结论：设计倾角 35°、正南。

峰值日照时数（指导书 §3.1）：H = 安装平面日平均辐照量/1 kW/m²，数值上与 kWh/m²·d 相同。水平面 12 月 = 2.82 h/d；倾斜 35° 面 12 月 = 4.81 h/d（供 §6 光伏容量；本册到 §5，先记录备查）。

## 3.2 最不利设计月（指导书 §3.2）

指导书要求：按月比较 R_m=E_AC,m/H_m，R 最大月为设计重点月份；避免只看年平均辐照量。

月份 | 1 | 2 | 3 | 4 | 5 | 6 | 7 | 8 | 9 | 10 | 11 | 12
E_AC | 7.61 | 7.61 | 7.61 | 4.61 | 3.41 | 4.42 | 4.42 | 4.42 | 3.41 | 4.61 | 7.61 | 7.61
G | 3.00 | 3.74 | 4.83 | 5.51 | 6.00 | 5.90 | 6.20 | 5.19 | 4.62 | 3.51 | 3.22 | 2.82
R | 2.54 | 2.03 | 1.58 | 0.84 | 0.57 | 0.75 | 0.71 | 0.85 | 0.74 | 1.31 | 2.36 | 2.70

结论：12 月 R = 7.61/2.82 = 2.70 为全年最大 → 最不利设计月 = 12 月（采暖负荷最高 + 水平辐照最低叠加）。

## 3.3 温度参数（指导书 §3.3）

指导书要求：最低环境温度用于控制器耐压与组串低温电压校核，最高环境温度用于组件高温校核；组件温度用 NOCT 式估算。

兰州极端最高 39.8 ℃（2010-07-28，追平 2000-07-24）：https://weather.news.sina.com.cn/news/2010/0729/57728.html

兰州极端最低 -21.7 ℃（1964-01-27，兰州市区）：https://m.thepaper.cn/newsDetail_forward_10881660

NOCT 公式（指导书 §3.3）：

T_cell = T_amb + (NOCT−20)/800×G，NOCT=45 ℃、G=1000 W/m²。

极端高温工况：T_cell = 39.8+31.25 ≈ 71.1 ℃；最热月常态（7 月 20.7 ℃）：T_cell ≈ 51.9 ℃。

表2（指导书 §3 表2 最终数据）：

数据项目 | 采用值 | 来源和说明
设计城市及坐标 | 兰州 36.05°N、103.83°E | NASA POWER 查询坐标
最不利设计月 | 12 月 | 水平面 R=2.70 全年最大（§3.2）
设计面峰值日照时数 | 水平 2.82；倾斜 35° 4.81 h/d | NASA + Liu-Jordan（§3.1）
最低环境温度 | -21.7 ℃ | 兰州市气象记录
最高环境温度 | 39.8 ℃ | 兰州市气象记录
组件估算最高温度 | 约 71.1 ℃（7 月常态约 51.9 ℃） | NOCT 公式（§3.3）
安装朝向和倾角 | 正南、35° | 最不利月供能+全年总量

# 4 能量损失和计算口径（指导书 §4）

## 4.1 能量与功率的区别（指导书 §4.1）

指导书要求：日用电量决定蓄电池与光伏容量，最大同时功率与短时功率决定逆变器及部分线缆等级，二者不能互相代替。

量 | 取值（兰州专属） | 决定环节
E_AC 日用电量 | 7.61 kWh/d（冬季） | 蓄电池、光伏容量
P_max 最大同时功率 | 4.2 kW（冬季） | 逆变器额定
P_short 短时冲击功率 | 4.8 kW | 逆变器短时校核

# 5 蓄电池容量和组合方式（指导书 §5）

## 5.1 采用 48 V 级系统的原因（指导书 §5.1）

户用离网连续功率达数千瓦，48 V 级可降低直流电流，降低线缆截面、压降、端子与保护要求，并与常见户用离网逆变器与磷酸铁锂模块匹配；

兰州冬季 P_max=4.2 kW，直流电流需求较高，采用 48 V 级更有必要。

## 5.2 标称能量（指导书 §5.2）

公式（指导书 §5.2）：

E_bat,min = E_AC×N_A×K_R / (DOD×η_dis×η_inv×K_T)；

安时：C_bat,min = 1000×E_bat,min/V_nom。

系数 | 取值 | 取值依据/来源
N_A 自主供电天数 | 2 d | 任务书统一基准（指导书 §5.2）
K_R 容量储备系数 | 1.10 | 指导书建议 1.05~1.10，取上限
DOD 放电深度 | 0.80 | 按 EG4 规格：BMS 建议 SOC 截止 20%（DOD 80%）、充电 0~50 ℃
η_dis 放电效率 | 0.95 | §4.2
η_inv 逆变器效率 | 0.976 | Deye SUN-5K 官方最大效率 97.6%（§5.3）
K_T 低温修正 | 1.00 | 保温设备间（≥10 ℃），低温容量损失可忽略

计算：

E_bat,min = 7.605×2×1.10/(0.80×0.95×0.976×1.00) = 16.731/0.74176 ≈ 22.56 kWh；

C_bat,min = 1000×22.56/51.2 ≈ 441 Ah。

## 5.3 串联和并联（指导书 §5.3）

公式：E_mod = V_nom×Ah/1000；N_P,E = ceil(E_bat,min/E_mod)。完整 51.2 V 模块内部 16 串，系统层面 N_S=1

模块：EG4 LL-S（51.2 V/100 Ah/5.12 kWh 服务器机架式磷酸铁锂（EG4 官方规格书））：https://eg4electronics.com/wp-content/uploads/2024/04/EG4-LL-48V-100A-Spec-Sheet.pdf (https://www.benhoobattery.com/cn/products/energy-storage-batteries/residential-solar-storage-batteries/battery-module-zh-cn-1)

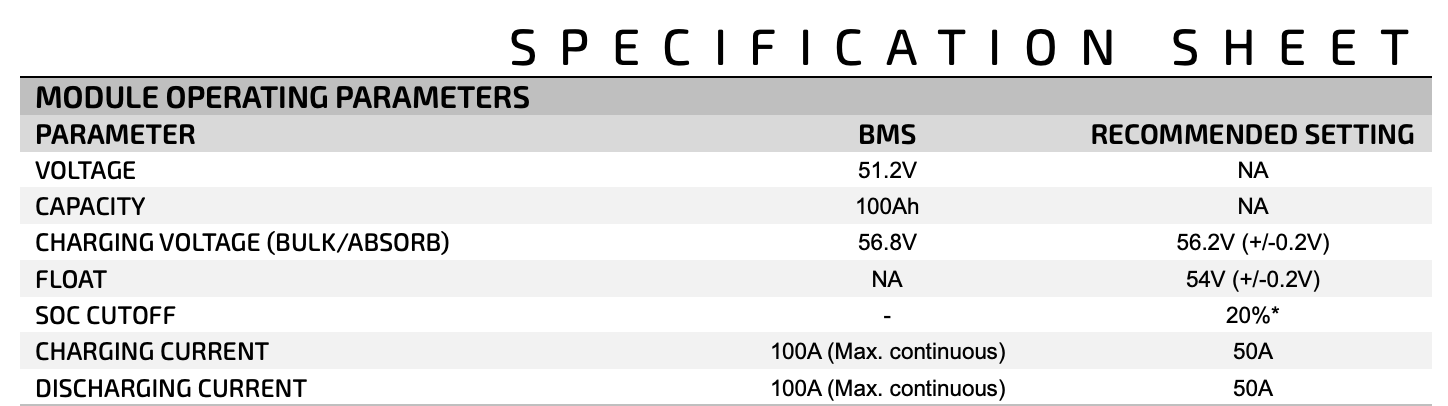
[picture p1: figure]

逆变器：德业 Deye SUN-5K-SG01LP1-EU（5 kW/48 V/单相 230 V，官方最大效率 97.6%，最大充放电流 120 A）：https://www.communica.co.za/products/deye-5k-sg01lp1-eu (https://en.growatt.com/upload/file/SPF_3500-5000_ES_Datasheet.pdf)

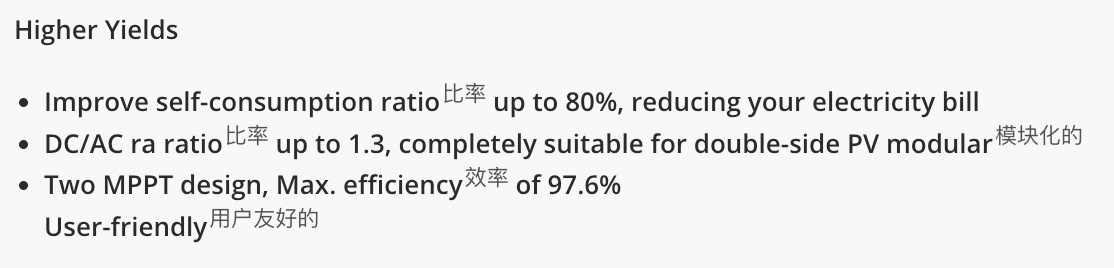
[picture p2: figure]

计算：

E_mod = 51.2×100/1000 = 5.12 kWh；

N_P,E = ceil(22.56/5.12) = 5 台；

实际 5×5.12 = 25.60 kWh，25.60/22.56 ≈ 1.13 倍（≤1.25，指导书 §5.5）。

方案 | 配置 | 能量 | 结论
A（推荐） | 51.2 V/100 Ah × 5 | 25.60 kWh | 1.13 倍下限，符合
B（200 Ah） | 2 台 / 3 台 | 20.48 / 30.72 kWh | 2 台不足（<22.56）；3 台 1.36 倍（>1.25）→ 不成立

## 5.4 放电和充电电流（指导书 §5.4）

公式（指导书 §5.4）：

I_dis=P_inv,r/(V_bat,min×η_inv)；

短时用 P_short；I_chg=min(P_PV×η_MPPT/V_bat,chg, 控制器限流)；N_P=max(N_P,E,N_P,dis,N_P,chg)。

V_bat,min=44.8 V（模块电压保护44.8v）、V_bat,chg=56.2 V、P_PV=2.40 kWp

计算：

I_dis = 5000/(44.8×0.976) ≈ 113.8 A；

I_dis,sur = 4800/(45×0.976) ≈ 109.3 A；

I_chg = min(2400×0.96/56.2, 120) = 41.0 A。

校核项 | 需求值 | 方案 A 能力（5 台） | 结论
连续放电 | 113.8 A | 5×100 A = 500 A | OK（4.4×）
短时放电 | 109.3 A | 峰值 500 A | OK
最大充电 | 41.0 A | 5×50 A = 250 A | OK（6.1×）

N_P,dis = ceil(119.5/100) = 2；（放电电流）

N_P,chg = ceil(41.0/50) = 1；（充电电流）

N_P = max(5,2,1) = 5（由能量需求控制）。

指导书 §5.4 要求核查：BMS 通信（RS485/CAN，智能 BMS 16S）；单模块充放电截止电压（44.8~57.6 V）；厂家允许并联数量（5 台远低于上限64）.兰州差异化：极端最低 -21.7 ℃，LFP 0 ℃ 以下充电受 BMS 低温保护限制，设备间保温（≥0 ℃）；8 度抗震设防区设备固定按抗震要求。

## 5.5 选型和成本判断（指导书 §5.5）

指导书要求：实际选定标称能量原则上不超过最低计算值 1.25 倍；3 d 敏感性容量≈2 d 基准的 1.5 倍，仅用于观察成本变化；按表 3 汇总。

敏感性 | E_bat,min | 方案 A 台数/能量 | 说明
3 d（N_A=3） | 33.83 kWh | 7 台 / 35.84 kWh | 多买 2 台
DOD=0.90（厂家深循环可选） | 20.05 kWh | 4 台 / 20.48 kWh | 余量 1.02×（设计基准 DOD=0.80）
低温（K_T=0.70） | 32.22 kWh | 7 台 / 35.84 kWh | 较基准 +43%

表3（指导书 §5.5 表3 最终蓄电池设计结果）：

项目 | 计算或选定结果 | 产品允许值 | 结论
最低标称能量 | 22.56 kWh | — | —
模块型号/单模块能量 | EG4 LL-S / 5.12 kWh | — | —
串联/并联数量 | N_S=1；N_P=5 | 1；并联远低于上限64 | OK
实际标称能量 | 25.60 kWh | ≤1.25×22.56=28.20 | OK（1.13×）
连续/短时/充电电流 | 113.8 / 109.3 / 41.0 A | 500 / 500 / 250 A | OK
BMS/并联限制 | 智能 BMS（RS485/CAN），并联 5 台 | 远低于上限 | OK
设备间保温 | 不低于 0摄氏度，不高于50度 | — | 设计决策
