sunny1043/offgrid-pv-course-design/docs/drawings/T1-03-设备间平面及安装接线图-拉萨.pdf

图名 | 设备间平面及安装接线图（拉萨） | 姓名 ____ | 日期
图号 | T1-03 | 学号 ____ | 2026-09-07
比例 | 1:25 | 版本 A | 单位 哈工大（深圳）

### 设备间平面（3.0m×2.5m，高2.6m，保温≥10℃）

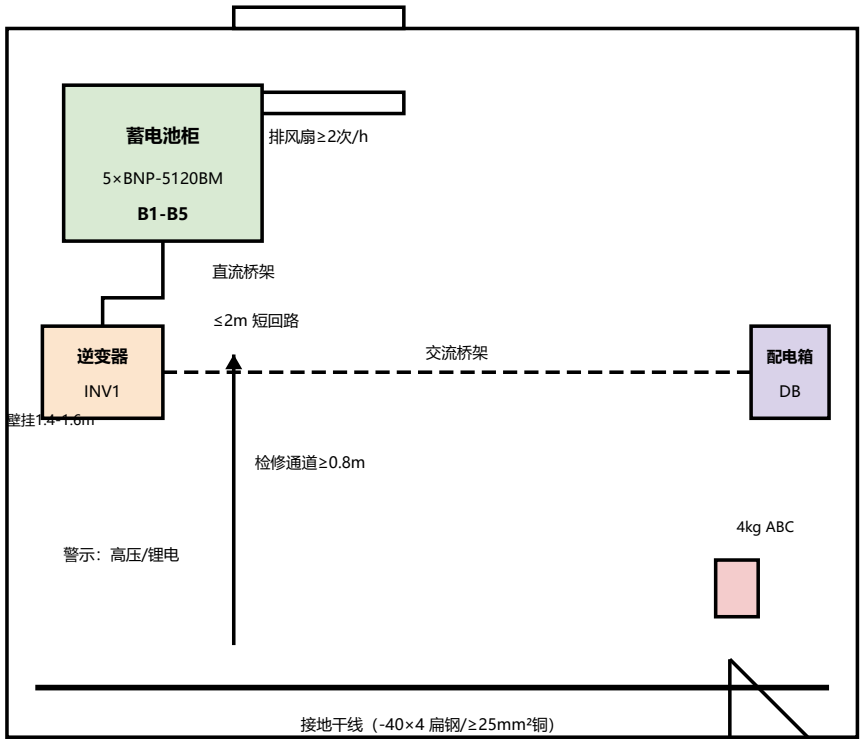
[picture p3: figure]
蓄电池柜; 排风扇≥2次/h; 5×BNP-5120BM B1-B5; 逆变器; INV1; 配电箱; 直流桥架; 交流桥架; ≤2m 短回路; 接地干线（-40×4 扁钢/≥25mm²铜）; 检修通道≥0.8m; 4kg ABC

门 0.8m

进风百叶(冬季可关)

### 安装接线说明：

1) 设备编号与 T1-01 一致（B1-B5/INV1/DB/F1-F6/QF1/QF2）；
2) 直流(电池柜-逆变器) RV70mm² ≤2m；交流(逆变-配电) RVV6mm²；充电 RV16mm²；
3) 交/直流分桥架；等电位联结+PE 接地（≥6mm²）；接地电阻≤4Ω；
4) 电池柜垫高≥100mm；保温≥10℃（墙体/门+电伴热，低温充电必需）；
5) 通风与保温平衡（排风扇加保温风阀）；消防/警示齐全。
