sunny1043/offgrid-pv-course-design/docs/drawings/T1-03-设备间平面及安装接线图-哈尔滨.pdf

# 户用离网光伏发电系统——设备间平面及安装接线图

## 拉萨/兰州/哈尔滨差异化设计（哈尔滨） · A3

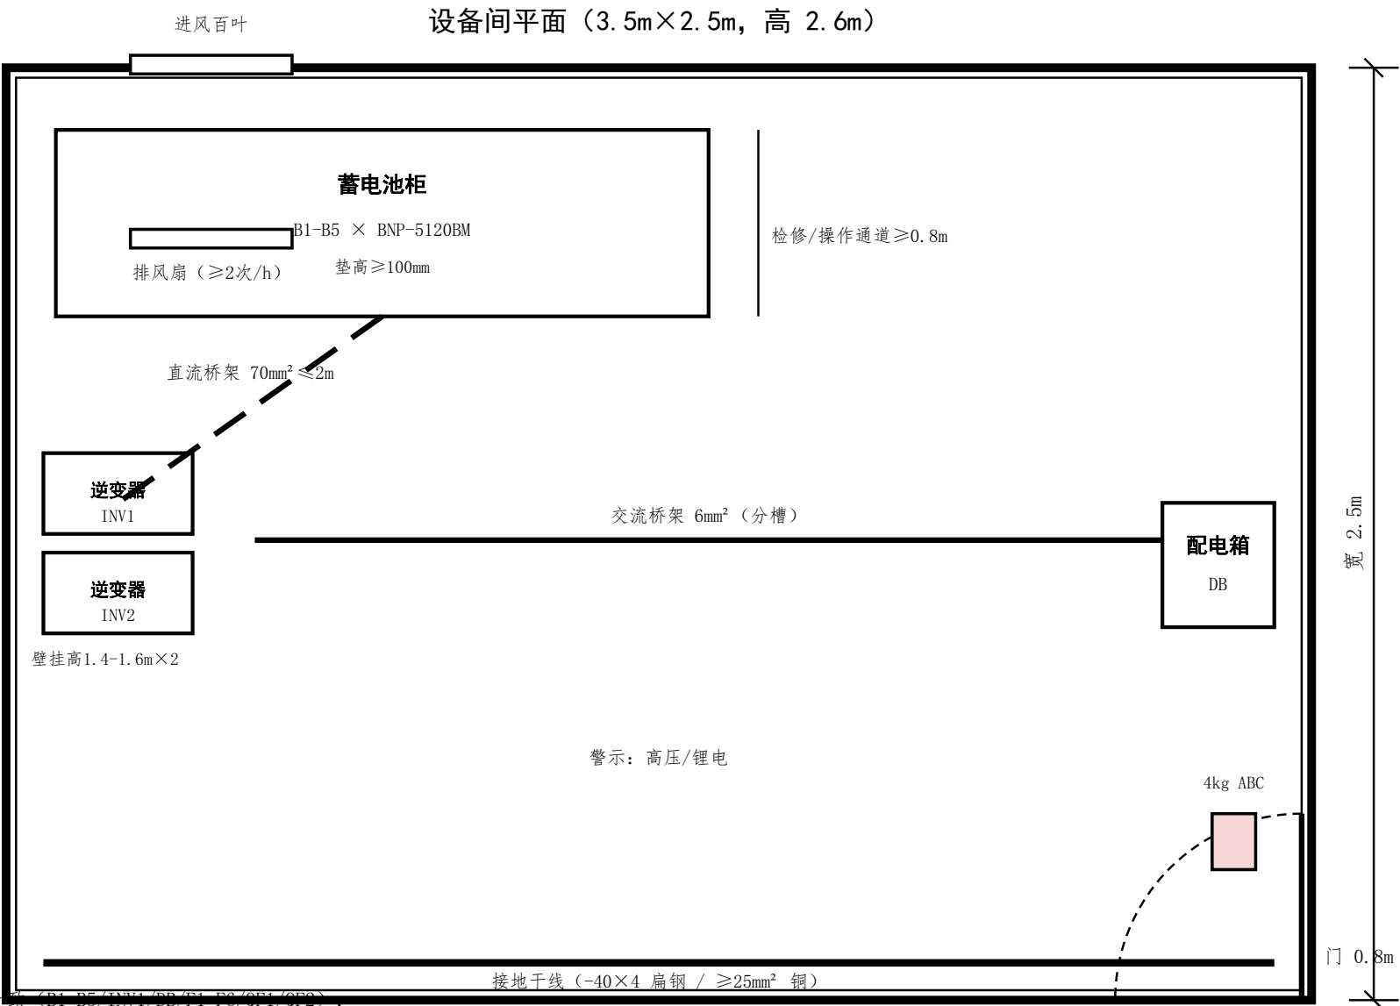
[picture p5: figure]
设备间平面（3.5m×2.5m，高 2.6m）; 进风百叶; 排风扇（≥2次/h）; 蓄电池柜; B1-B5 × BNP-5120BM; 逆变器 INV1; 逆变器 INV2; 壁挂高1.4-1.6m×2; 配电箱; 直流桥架 70mm²≤2m; 交流桥架 6mm²（分槽）; 接地干线（-40×4 扁钢 / ≥25mm² 铜）; 检修/操作通道≥0.8m; 4kg ABC

哈尔滨工业大学 | 设备间平面及安装接线图 | 图号 | T1-03
设计：＿＿ | 制图：＿＿ | 审核：＿＿ | 日期 2026-09-03
学号：＿＿ | 班级：＿＿ | 版本 A | 页次 1/1
比例 | 1:25 | 单位：mm

长 3.5m

### 安装接线说明：

### 1. 设备编号与 T1-01 一致（B1-B5/INV1/DB/F1-F6/QF1/QF2）； 2. 直流（电池柜-逆变器）RV 70mm² ≤2m；交流（逆变器-配电箱）RVV 6mm²； 3. 交/直流线缆分桥架敷设；等电位联结 + PE 接地（≤4Ω）； 4. 电池柜垫高≥100mm；机械通风、干燥、防积水； 5. 保温+加热（≥10℃）为硬性前提：极端 -38.1℃，防冻禁充；

双逆变器并排壁挂（间隔≥0.2m 散热），两路交直流分槽
