sunny1043/offgrid-pv-course-design/docs/drawings/T1-03-设备间平面及安装接线图.pdf

图名 | 设备间平面及安装接线图 | 姓名 ____ | 日期
图号 | T1-03 | 学号 ____ | 2026-09-03 哈工大（深圳）
比例 | 1:25 | 版本 A | 单位

### 设备间平面（3.0m×2.5m，高 2.6m）

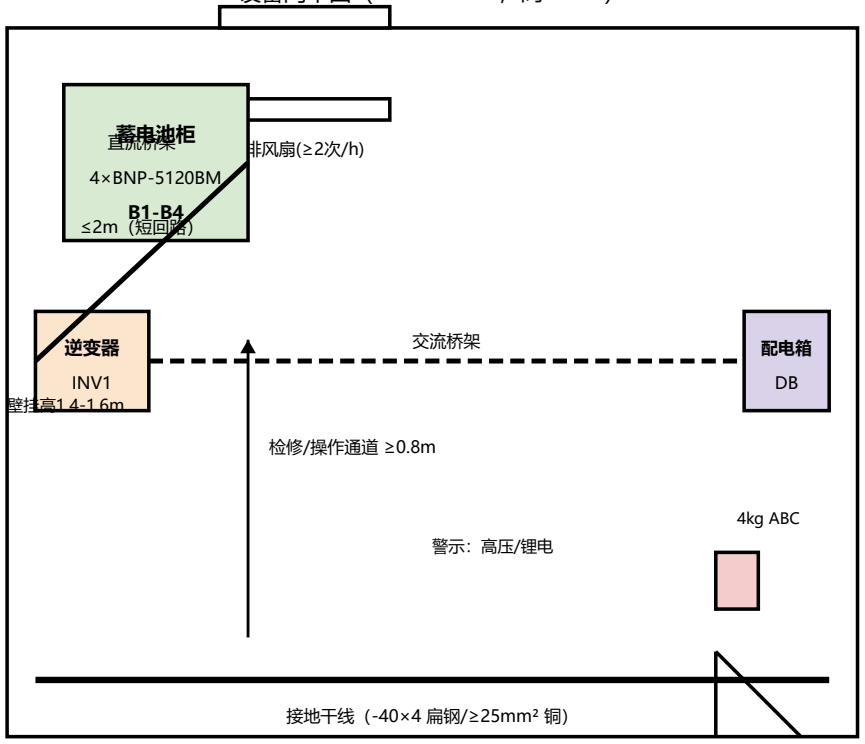
[picture p6: figure]
排风扇(≥2次/h); 蓄电池柜; 4×BNP-5120BM B1-B4; 逆变器; INV1 壁挂高1.4-1.6m; 配电箱; 直流桥架; 交流桥架; ≤2m（短回路）; 接地干线（-40×4 扁钢/≥25mm² 铜）; 检修/操作通道 ≥0.8m; 4kg ABC

门 0.8m

进风百叶

### 安装接线说明：

1) 设备编号与 T1-01 一致（B1-B4/INV1/DB/F1-F5/QF1/QF2）；
2) 直流(电池柜-逆变器) 70mm² ≤2m；交流(逆变器-配电箱) 6mm²；
3) 交/直流线缆分桥架敷设；等电位联结 + PE 接地；
4) 电池柜垫高 ≥100mm；设备间机械通风、干燥、防积水；
5) 尺寸与检修距离按 W8 布置定案，消防/警示齐全。
