sunny1043/offgrid-pv-course-design/docs/updates/2026-09-10/README.md

# 2026-09-10：四城设计与图纸进度

项目管理员 sunny1043 授权上传。此次采用成果索引与问题清单形式记录进度，保留仓库原报告及图纸，不覆盖合作者版本。

## 今日交付

| 内容 | 成果 | 状态 |
|---|---|---|
| 兰州画图前设计 | 第1至8章 Word、阅读版 PDF、答辩讲解版 PDF、资源与计算结果 JSON | 初稿完成，须结合下方复核问题阅读 |
| 兰州图纸 | R0 电气、屋面支架、设备间三张 DXF/PDF | 课程评审初稿，非施工定稿 |
| 深圳、拉萨、哈尔滨图纸 | 每城三张，共9张R1 DXF及9页A3预览 | 文件检查完成，工程条件待审 |
| 协作交接 | 进度核对、尺寸矛盾及回填建议、Agent 修改提示词 | 已整理 |

## 直接查看

- [三城9页图纸预览](三城光伏图纸-DXF-R1/三城光伏-九张图纸预览-R1.pdf)
- [三城完整下载包](深圳-拉萨-哈尔滨-九张DXF图纸-R1.zip)
- [三城可编辑DXF目录](三城光伏图纸-DXF-R1/)
- [协作进度、数据来源及修改说明](三城光伏图纸-DXF-R1/协作进度与图纸使用说明.md)
- [兰州三张图纸预览](兰州光伏图纸-R0/兰州光伏-三张图纸-R0.pdf)
- [兰州图纸目录及使用说明](兰州光伏图纸-R0/)
- [兰州第1至8章Word](兰州/兰州-户用离网光伏设计-第1至8章.docx)
- [兰州阅读版](兰州/兰州-户用离网光伏设计-第1至8章-阅读版.pdf)
- [兰州答辩讲解版](兰州/兰州-户用离网光伏设计-第1至8章-答辩讲解版.pdf)
- [给其他Agent的修改提示词](画图修改提示词.md)

## 必须一起交接的未决问题

1. **兰州文稿先于下午复核及R0图纸产生**。文稿不可当作所有参数已最终确认：5串标准工作电压约210V，所选德业手册的满载MPPT区间为300–425V，功率能力与恢复天数需要再核；普通MPPT工作范围合适不能直接证明满载能力。原4串电压推导中的保守下界也不足以独立证明4串必然失败。图纸说明中的限制应优先与文稿对照，后续统一回填。
2. **拉萨原6m屋面与哈尔滨原12m屋面不满足原定两侧边距**。加入20mm安装缝后，至少分别需要6750mm、12800mm宽；R1所画7000mm、13000mm为待确认备选，不是现场测量值。现场不能加宽则须重新布局与遮挡核算。
3. **充放电端口**：SPF一体机共用物理电池端口，不另设原C3功能计算所对应的外部充电端口。相关W7、清单与成本需要同步修订，不能照旧采购重复回路。
4. **保护与适用性**：电池短路分断/选择性、母排额定电流、SPD配合、RCD类型、N-PE与故障切断、BMS协议、双机同步，以及拉萨高原额定能力均未完成厂家及工程复核。
5. **结构及热工**：屋面承载、风雪、锚固、防水以及保温/加热/通风耗电需继续闭合。不能据初稿宣称满足施工或自治天数。
6. **实验**：本次没有新增实测原始数据，不将W10实验标记完成。

## 核查范围

制图依据主分支 `35341ff4b786271a80270c279b37c3d78d3b4cc2`。拉萨9月8日已有完整案例及重绘图；深圳与哈尔滨已有报告、成本/复核和答辩材料，进度表不完全同步。未合并PR查询曾遇到API限流，未宣称已检查其他分支或成员本地工作。

三城9份DXF均以R2013/mm格式重新读取，结构审计错误和自动修复为0，文字数量检查通过，A3预览已逐页目视检查。尺寸是可编辑线条与文字，非关联式尺寸；未在实体CAD应用完成兼容性验收。文件可读不代表工程审查通过。

本目录中的三城使用说明记录的是“制图交付时未推送”的历史状态；本次管理员授权将该原始交付上传归档，实际上传状态以Git提交记录为准。

## 下一步

先由各城市负责人确认屋面与设备条件，完成保护/结构/热工复核，再把图纸修改回填报告、计算书和BOM；最后更新答辩材料及实验记录。不要仅替换图纸而保留矛盾的正文和清单。
