sunny1043/offgrid-pv-course-design/docs/PROGRESS.md

# 任务进度 PROGRESS

## 2026-09-10 管理员进度补充

- 已完成：兰州1至8章初稿及讲解材料；兰州3张R0、另外三城9张R1可编辑DXF及预览；交接问题说明。
- 待审：屋面尺寸、设备适配、保护/结构/热工及报告—图纸—BOM回填；不将工程校核或W10实验标记完成。
- [查看成果、下载图纸与修改清单](updates/2026-09-10/README.md)。原有各成员任务状态保留。

> 全队（含各 agent）统一进度表。状态只允许：`🔲 未开始` / `🟡 进行中` / `✅ 已完成`。
> 规则见 [AGENTS.md](../AGENTS.md) §4。开始任务前先标 🟡 并填开始日期，完成后标 ✅。

## 任务清单

| 任务 | 负责人 | 状态 | 开始日期 | 完成日期 | 相关提交 |
|---|---|---|---|---|---|
| 仓库初始化与资料上传 | agent-01 | ✅ 已完成 | 2026-08-31 | 2026-08-31 | fda84fe |
| 日志与进度标准建立 | agent-01 | ✅ 已完成 | 2026-08-31 | 2026-08-31 | 3102698 |
| 任务1 课程设计任务书（户用离网光伏发电系统） | 待认领 | 🔲 未开始 | - | - | - |
| 任务1 设计说明书 | 待认领 | 🔲 未开始 | - | - | - |
| 任务1 进度检查与考核标准 | 待认领 | 🔲 未开始 | - | - | - |
| 实验测试方案 | 待认领 | 🔲 未开始 | - | - | - |
| 负荷调查（W1，深圳） | Eh00712 | ✅ 已完成 | 2026-09-01 | 2026-09-01 | PR 待合并 |
| 太阳能资源与倾角核算（W2） | Eh00712 | ✅ 已完成 | 2026-09-01 | 2026-09-01 | PR 待合并 |
| 系统组成与能量损失（W3） | Eh00712 | ✅ 已完成 | 2026-09-01 | 2026-09-01 | PR#1 |
| 蓄电池设计（W4） | Eh00712 | ✅ 已完成 | 2026-09-01 | 2026-09-01 | 待本机提交 |
| 光伏阵列设计（W5） | sunny1043 | ✅ 已完成 | 2026-09-01 | 2026-09-01 | 6471be5 |
| W5 计算文件 XML 修复（转义+乱码标签） | D-coccus | ✅ 已完成 | 2026-09-01 | 2026-09-01 | 93b207f |
| 控制器与逆变器选型（W6） | D-coccus | ✅ 已完成 | 2026-09-01 | 2026-09-01 | 4f1919e |
| 蓄电池计算文件公式引用修复（W4 回填发现） | D-coccus | ✅ 已完成 | 2026-09-01 | 2026-09-01 | 4f1919e |
| 差异化城市设计-拉萨（W1–W6，7 文档+2 Excel） | sunny1043 | ✅ 已完成 | 2026-09-01 | 2026-09-01 | 3e002c4 |
| 差异化城市设计-兰州（W1–W6，7 文档+2 Excel） | sunny1043 | ✅ 已完成 | 2026-09-01 | 2026-09-01 | 3e002c4 |
| 差异化城市设计-哈尔滨（W1–W6，7 文档+2 Excel） | sunny1043 | ✅ 已完成 | 2026-09-01 | 2026-09-01 | 3e002c4 |
| 新增城市设计质量校验与遗留问题确认 | D-coccus | 🟡 进行中 | 2026-09-02 | - | - |
| 线缆、保护、防雷与接地（W7，深圳） | Eh00712 | ✅ 已完成 | 2026-09-03 | 2026-09-03 | 待本机提交 |
| 支架、屋面与设备间布置（W8，深圳） | Eh00712 | ✅ 已完成 | 2026-09-03 | 2026-09-03 | 待本机提交 |
| 三张 A3 图纸（W9，深圳：T1-01/02/03） | Eh00712 | ✅ 已完成 | 2026-09-03 | 2026-09-03 | 待本机提交 |
| 拉萨 D1–D5 成果汇总文档 | Eh00712 | ✅ 已完成 | 2026-09-03 | 2026-09-03 | 待本机提交 |
| 设计报告与数据一致性复核（W12，深圳） | Eh00712 | ✅ 已完成 | 2026-09-04 | 2026-09-04 | 待本机提交 |
| 答辩准备与最终提交自查（W13 收尾，深圳） | Eh00712 | ✅ 已完成 | 2026-09-04 | 2026-09-04 | 待本机提交 |
| 设备清单与成本分析（W11，拉萨） | Eh00712 | ✅ 已完成 | 2026-09-04 | 2026-09-04 | 待本机提交 |
| 设计报告与数据一致性复核（W12，拉萨） | Eh00712 | ✅ 已完成 | 2026-09-04 | 2026-09-04 | 待本机提交 |
| 答辩准备与最终提交自查（W13，拉萨） | Eh00712 | ✅ 已完成 | 2026-09-04 | 2026-09-04 | 待本机提交 |
| 拉萨提交包修复（xlsx #NAME?、报告支架σ/f）与指导书表格式填写 | Eh00712 | ✅ 已完成 | 2026-09-07 | 2026-09-07 | 待本机提交 |
| 拉萨三张 A3 图纸重绘（接线/压线修复，几何 0 压线） | Eh00712 | ✅ 已完成 | 2026-09-08 | 2026-09-08 | 待本机提交 |
| 拉萨完整设计案例（参考案例结构+拉萨数据） | Eh00712 | ✅ 已完成 | 2026-09-08 | 2026-09-08 | 待本机提交 |
| （按实际需要增补任务行） | - | - | - | - | - |

## 认领规则

- 在「负责人」列填上你的名字/agent 名即视为认领；同一任务只能有一个负责人。
- 完成一个阶段后，把状态改为 🟡/✅ 并填写日期，然后用 `log:` 类型提交。
