sunny1043/offgrid-pv-course-design/差异化城市设计/倾角核算-哈尔滨.md

# 倾角核算 — 哈尔滨（W2/W5 共用）

> 依据：指导书 §3.1/§3.2/§9.1。方法：Liu-Jordan 各向同性模型（与深圳/拉萨同一实现，已用深圳数据校验一致）。数据：NASA POWER 2019–2023 五年平均。

## 1. 候选倾角逐月核算结果（kWh/m2·d，摘要）

| 倾角 | 1月 | 2月 | 11月 | **12月** | 全年(kWh/m2) |
|---|-----|-----|---|---|---|
| 0°（水平） | 2.05 | 3.15 | 1.86 | 1.68 | 1400 |
| 20° | 2.38 | 3.66 | 2.15 | 1.95 | 1639 |
| 30° | 2.46 | 3.80 | 2.23 | 2.03 | 1700 |
| **40°** | **2.49** | **3.85** | **2.25** | **2.05** | **1722** |
| 45° | 2.49 | 3.85 | 2.25 | 2.05 | 1717 |
| 50° | 2.47 | 3.82 | 2.23 | 2.03 | 1703 |

## 2. 最优倾角判定

| 判据 | 最优倾角 | 取值 |
|---|---|---|
| 最不利月（12 月）供能最大 | 40°（与 45° 并列） | 2.05 kWh/m2·d（较水平面 +22%） |
| 全年总量最大 | 40° | 1722 kWh/m2·yr |

> **结论：设计倾角 = 40°、正南**。哈尔滨纬度 45.8°N，40° 接近「纬度+冬季优先」的推荐值；倾角对冬季辐照改善有限（水平 1.68 → 40° 2.05，+22%），但因冬季辐照本身太低，即使最优倾角也远低于低纬城市。
> 说明：更陡（50°+）会进一步恶化排间节距且 12 月辐照不再增加，故取 40°。

## 3. 最不利月复核（倾斜面口径）

| 月份 | 11 | 12 | 1 | 2 |
|---|----|----|----|----|
| H_tilt(40°) | 2.25 | 2.05 | 2.49 | 3.85 |
| R = E_AC/H_tilt | 3.48 | **3.81** | 3.14 | 2.03 |

> 12 月仍为最不利月（R=3.81），结论稳健。

## 4. 排间节距校核（指导书 §9.1）

冬至 9:00 太阳高度角（哈尔滨）：sin h = 0.167 -> h ≈ **9.6°**

| 倾角 | 30° | 40° | 45° |
|---|-----|-----|-----|
| D（×斜面长 L） | 3.84 | **4.57** | 4.89 |

- 倾角 40° 时 D ≈ **4.57 × L**（深圳 1.62、拉萨 2.13、兰州 2.51 的 2~3 倍）——高纬度严寒城市冬季太阳高度角极低，排间节距巨大，屋面/地面布置空间需求大（W8 重点）。

## 5. 输出汇总

| 结果 | 数值 |
|---|---|
| 设计倾角 | 40°（正南） |
| 最不利月（12 月）倾斜面日辐照 | 2.05 kWh/m2·d |
| 全年倾斜面总量 | 1722 kWh/m2·yr |
| 排间节距 | 4.57 × L |

## 6. 数据来源

1. NASA POWER（总辐射+散射）：https://power.larc.nasa.gov/api/temporal/monthly/point?parameters=ALLSKY_SFC_SW_DWN,ALLSKY_SFC_SW_DIFF&community=RE&longitude=126.53&latitude=45.80&start=2019&end=2023&format=JSON
2. 换算模型：Liu-Jordan 各向同性（正南，rho=0.2）。
3. PVGIS 复核：https://re.jrc.ec.europa.eu/pvg_tools/en/
