sunny1043/offgrid-pv-course-design/docs/数据一致性复核-深圳.md

# 数据一致性复核 — 深圳（W12 · 指导书 §13.2 表10）

> 依据：设计指导书 §13.2 表10（提交前按报告、图纸、设备清单逐项核对型号/数量/参数）、课程设计任务书红线（报告/图纸/设备清单型号数量一致）。
> 复核对象：`docs/设计报告-深圳.md`（报告）↔ `docs/drawings/` T1-01/02/03（图纸）↔ `docs/设备清单与成本分析-深圳.md`（设备清单，W11）。
> 方法：程序化交叉核对 14 项关键参数 + 人工确认表述口径；日期 2026-09-04。

## 一、表10 一致性核对结果

| 检查对象 | 报告 | 图纸 | 设备清单 | 应一致的内容 | 结论 |
|---|:---:|:---:|:---:|---|:---:|
| 光伏组件 | ✅ | ✅ | ✅ | 型号 隆基 LR7-72HGD-600M、数量 4、4 串×1 并、容量 2.40 kWp | ✅ |
| MPPT 控制器 | ✅ | ✅ | ✅ | 内置 SPF 5000 ES（450 V/120~430 V/22 A） | ✅ |
| 蓄电池 | ✅ | ✅ | ✅ | 型号 Benhoo BNP-5120BM、4 台、20.48 kWh（5.12×4） | ✅ |
| 离网逆变器 | ✅ | ✅ | ✅ | Growatt SPF 5000 ES、5 kW/10 kVA | ✅ |
| 线缆 | ✅ | ✅ | ✅ | PV1-F 4 mm²、RV 10/70 mm²、RVV 6 mm²、BV 2.5/4 mm² | ✅ |
| 保护器件 | ✅ | ✅ | ✅ | F1 25A gPV、支路 4×100A、QF1 160A DC MCB、50A、32A、RCD 30 mA、SPD 两级 | ✅ |

## 二、关键参数三文件对照表

| 参数 | 报告（设计报告-深圳.md） | 图纸（drawings/README + T1-01/02/03） | 设备清单（W11） | 一致性 |
|---|---|---|---|---|
| 光伏组件 | 隆基 LR7-72HGD-600M ×4 | ×4（4 串×1 并，T1-01/02） | ×4（数量 4） | ✅ |
| 阵列容量 | 2.40 kWp | 2.40 kWp | 2.40 kWp | ✅ |
| 串并联 | 4 串×1 并 | 4 串×1 并 | 数量 4（=4 串 1 并口径） | ✅（表述粒度） |
| 蓄电池模块 | BNP-5120BM ×4 | ×4（T1-01 B1-B4） | ×4 | ✅ |
| 蓄电池能量 | 20.48 kWh | 4×5.12 kWh（隐含 20.48） | 20.48 kWh | ✅（表述粒度） |
| 逆变器 | SPF 5000 ES 5 kW | SPF 5000 ES | SPF 5000 ES | ✅ |
| 电池→逆变器线缆 | RV 70 mm² | RV 70 mm² | 70 mm² | ✅ |
| 组串线缆 | PV1-F 4 mm² | PV1-F 4 mm² | 4 mm² | ✅ |
| 总保护 | 160 A DC MCB | QF1 160A | 160 A | ✅ |
| 组串熔断器 | 25 A gPV | F1 25A | 25 A | ✅ |
| RCD | 30 mA | 30mA | 30 mA | ✅ |
| SPD | 直流+交流两级 | SPD1/SPD2 | Type II×2 | ✅ |
| 总成本 | ≈¥26,945 | — | ¥26,945 | ✅ |

> 两处"表述粒度"说明（非数据矛盾）：
> 1. 设备清单按"数量 4"列组件，与"4 串×1 并"同义（4 块组件即 1 串 4 块），口径一致；
> 2. 图纸索引给出"4×BNP-5120BM（5.12 kWh/台）"，总能量 4×5.12=20.48 kWh 可由数量与单台能量推导，与报告/清单一致。
> 建议（可选）：图纸索引可补写总能量"20.48 kWh"，使三文件字面完全一致。

## 三、与 W4–W9 计算文档的一致性

| 参数 | 复核值 | 来源章节 | 一致 |
|---|---|---|:---:|
| E_AC | 6.99 kWh/d | W1 负荷调查 | ✅ |
| P_max / P_short | 3.0 / 3.6 kW | W1 | ✅ |
| 最不利月 / 倾角 / H_tilt | 10 月 / 20° / 4.46 h/d | W2 | ✅ |
| η_path / η_inv | 0.782 / 0.93 | W3/W6 | ✅ |
| E_bat,min / 配置 | 19.34 kWh / 4×BNP-5120BM | W4 | ✅ |
| I_dis / I_chg | 119.5 / 42.4 A | W4/W5/W6 | ✅ |
| P_PV / 串并联 | 2.40 kWp / 4 串×1 并 | W5 | ✅ |
| I_ac | 22.7 A | W6 | ✅ |
| 回路线缆/保护 | C1–C6d / F-QF-RCD-SPD | W7 | ✅ |
| 支架/布置 | 20°、4 块横排、σ=24.3 MPa | W8 | ✅ |
| 图纸 | T1-01/02/03（SVG+PDF+PNG） | W9 | ✅ |
| 成本 | ≈¥26,945 | W11 | ✅ |

## 四、红线自查（任务书 §九 / 考核标准 §五）

- [x] 报告、图纸、设备清单中光伏组件/蓄电池/逆变器/线缆/保护器件**型号、数量、参数一致**（本表逐项核对）；
- [x] 未出现"多套型号并存、关键数据相互矛盾"（一致性红线）；
- [x] 图纸非纯方框（含保护器件、线缆规格、串并联数量）；
- [x] 计算、选型、校核过程在报告与各章文档完整可查。

## 五、结论与遗留

- **复核结论：报告 ↔ 图纸 ↔ 设备清单 14 项关键参数全部一致 ✅**，仅 2 处表述粒度（可推导、不构成矛盾）；
- 遗留：① 图纸索引可选补"20.48 kWh"总能量表述；② 实验原始数据待 W10 补录后同步至报告 §11；③ 答辩 12 问已按个人数据可解释口径备好（见报告各章）。

*复核脚本：verify_consistency_w12.py（程序化 14 项核对）。*
