sunny1043/offgrid-pv-course-design/差异化城市设计/系统组成与能量损失-兰州.md

# 系统组成与能量损失口径 — 兰州（W3）

> 依据：指导书 §1/§4、任务书 §4.2。状态：本地草稿。系统框图沿用 diagram/ 通用图。

## 1. 系统组成与三个电气位置

同其他城市：光伏方阵 -> 直流保护 -> MPPT 控制器 -> 蓄电池及 BMS -> 离网逆变器 -> 交流配电 -> 负荷。三个电气位置必须分清。

## 2. 能量与功率的口径区分

| 量 | 本方案取值 | 决定的设计环节 |
|----|---|---|
| 日用电量 E_AC | 7.82 kWh/d（冬季采暖季） | 蓄电池（W4）、光伏（W5） |
| 最大同时功率 P_max | 4.6 kW（冬季） | 逆变器额定（W6） |
| 短时冲击功率 P_short | 5.2 kW | 逆变器短时校核（W6） |

## 3. 能量流向与各环节效率（指导书 §4.2）

| 环节 | 符号 | 取值 |
|---|---|---|
| 光伏直流线缆 | eta_cable_dc | 0.98 |
| MPPT 控制器 | eta_ctrl | 0.96 |
| 蓄电池充电 | eta_batt_ch | 0.95 |
| 蓄电池放电 | eta_batt_dis | 0.95 |
| 离网逆变器 | eta_inv | 0.93（SPF 5000 ES 官方峰值） |
| 交流线缆 | eta_cable_ac | 0.99 |
| 综合路径效率 | eta_path | 约 0.782 |

## 4. 24 h 能量平衡（冬季）

- 白天：光伏发电供负荷 + 充电池（兰州冬季辐照中等，充电可满足）；
- 傍晚/夜间：电暖器 + 电热毯 + 炊事高峰，光伏 + 电池共同放电；
- 深夜：电池放电供负荷。

> 兰州特点：冬季辐照高于哈尔滨、低于拉萨；12 月阵列供能比 1.17（W5），处于「能自给但余量不大」的中间态。

## 5. 计算口径声明（与 W4/W5 一致）

1. E_AC = 7.82 为交流侧日用电量，蓄电池公式直接使用，不重复除以 eta_inv；
2. 蓄电池容量公式内部已含 eta_inv；
3. 光伏阵列容量公式使用 eta_path；
4. 全文统一本节参数。

## 6. 差异化约束落实状态

1. [x] 8 度抗震设防对支架/屋面/设备固定的要求：已由 W8（支架设备间布置-兰州.md）落实，并在 W9 T1-02/T1-03 图纸中表达；
2. [x] 设备间保温（≥10 ℃，蓄电池低温）：已由 W8 纳入设备间设计前提（保温/加热成本待 W11 计入）。
