sunny1043/offgrid-pv-course-design/差异化城市设计/太阳能资源-兰州.md

# 太阳能资源与环境参数 — 兰州（W2）

> 依据：设计指导书 §3（太阳能资源和环境参数）、§3.1（单一数据源原则）。
> 状态：已完成（2026-09-03 完善至与深圳/拉萨同级详细度，覆盖 D3 检查点②交付要求）。
> 数据源：NASA POWER（MERRA2/SYN1DEG，API v2.9.8，LST），坐标 36.05°N、103.83°E（兰州市区），2019–2023 共 5 年平均——与深圳/拉萨示例同一数据源、同一口径。查询日期 2026-09-01。

## 1. 数据来源声明（单一数据源原则，指导书 §3.1）

| 数据项 | 来源 | 说明 |
|---|---|---|
| 逐月水平面辐照量、月均温 | NASA POWER（5 年平均） | 36.05°N、103.83°E，2019–2023 |
| 极端气温 | 兰州市气象台公开资料 | 历史极端最高约 39.1 ℃、极端最低约 -23.1 ℃ |
| 年水平面总辐射 | NASA POWER 5 年平均 | 本方案约 1659 kWh/m2·yr（属资源较丰富区，见 §6） |

> 兰州特点：海拔约 1520 m、干燥少云，年水平面辐照约 1659 kWh/m2·yr（高于哈尔滨 1400、低于拉萨 1988）；冬季辐照明显好于哈尔滨——12 月（最差月）2.82 kWh/m2·d，约为哈尔滨（1.68）的 1.7 倍，最不利月资源不至于塌陷。

## 2. 逐月水平面辐照量与月均温（NASA POWER，5 年平均）

| 月份 | 1 | 2 | 3 | 4 | 5 | 6 | 7 | 8 | 9 | 10 | 11 | 12 |
|---|---|---|---|---|---|---|---|---|---|----|----|----|
| H（kWh/m2·d） | 2.99 | 3.74 | 4.83 | 5.51 | 6.00 | 5.90 | 6.20 | 5.19 | 4.61 | 3.51 | 3.22 | **2.82** |
| T（℃） | -5.8 | -2.1 | 3.7 | 8.5 | 13.4 | 18.1 | 20.7 | 19.4 | 15.1 | 7.7 | 1.2 | -4.8 |

- 水平面辐照最低月：12 月（2.82）≈1 月（2.99）；辐照最高的 7 月（6.20）为 12 月的约 2.2 倍——冬夏落差介于深圳（1.7 倍）与哈尔滨（3.4 倍）之间；
- 月均温最低 1 月（-5.8 ℃）、最高 7 月（20.7 ℃）——大陆性气候，年较差约 26 ℃；
- 年水平面总辐射约 1659 kWh/m2·yr（均值约 4.54 kWh/m2·d）。

## 3. 最不利设计月（负荷随季节变化，指导书 §3.2 按月比较法）

兰州与拉萨/哈尔滨同属「冬季电采暖」设计线：最不利月由**冬季采暖负荷（7.82 kWh/d）+ 冬季相对低辐照**共同驱动。与深圳（夏季空调驱动 10 月）形成对照；与哈尔滨相比，兰州 12 月资源（2.82）远好于哈尔滨（1.68），冬季压力中等。

逐月负荷口径：采暖月（11–3 月）E_AC=7.82；过渡月（4、10 月）4.82；夏季月（6–8 月，含轻空调）4.97；温和月（5、9 月）3.62。

| 月份 | 1 | 2 | 3 | 4 | 5 | 6 | 7 | 8 | 9 | 10 | 11 | 12 |
|---|---|---|---|---|---|---|---|---|---|---|----|----|
| E_AC | 7.82 | 7.82 | 7.82 | 4.82 | 3.62 | 4.97 | 4.97 | 4.97 | 3.62 | 4.82 | 7.82 | 7.82 |
| H | 2.99 | 3.74 | 4.83 | 5.51 | 6.00 | 5.90 | 6.20 | 5.19 | 4.61 | 3.51 | 3.22 | 2.82 |
| R | 2.62 | 2.09 | 1.62 | 0.87 | 0.60 | 0.84 | 0.80 | 0.96 | 0.79 | 1.37 | 2.43 | **2.77** |

> 结论：最不利设计月 = 12 月（水平面 R = 2.77 最大）——采暖负荷最高（7.82 kWh/d）且辐照为全年最低（2.82）。若忽略采暖季节变化只看辐照，会误选 5~6 月（辐照最高但负荷最低）——正是指导书 §3.2 强调的「按月比较」的价值。
> 夏季（5–9 月）R 仅 0.60~0.96：辐照远大于负荷，夏季大量富余充入蓄电池/弃光。
> 与哈尔滨对比：兰州最不利月 R=2.77 < 哈尔滨 4.65——兰州冬季资源压力明显更小，阵列规模（3.60 kWp）约为哈尔滨（6.00 kWp）的六成。

## 4. 峰值日照时数（指导书 §3.1）

- 水平面：数值上 H（kWh/m2·d）= 峰值日照时数（h/d）→ 12 月 = 2.82 h/d；
- 倾斜面（倾角 30°、正南，Liu-Jordan 换算，详见 倾角核算-兰州.md）：12 月 = **3.24 h/d**（较水平面 +15%——冬季辐照改善幅度大于拉萨 +12%，因兰州散射占比更低、直射更强）。

## 5. 温度参数（用于校核）

| 参数 | 取值 | 用途 | 来源 |
|---|---|---|---|
| 最低环境温度 | -23.1 ℃（历史极端最低） | 光伏组串低温开路电压校核（W5） | 兰州市气象台公开资料 |
| 最高环境温度 | 39.1 ℃（历史极端最高） | 组件最高温度估算 | 兰州市气象台公开资料 |
| 组件估算最高温度 | NOCT 公式：T_cell = T_amb + (NOCT−20)/800 × G | 高温 MPPT 电压校核（W5） | 指导书 §3.3 |

- NOCT 取 45 ℃（典型单晶组件），G = 1000 W/m2：
  - 按极端高温 39.1 ℃ → T_cell ≈ 39.1 + 31.3 = **70.4 ℃**（极端工况，与深圳 70 ℃ 相当）；
  - 按最热月 7 月月均温 20.7 ℃ → T_cell ≈ 20.7 + 31.3 = **52.0 ℃**（常态最热月）；
  - 对比拉萨（极端 60.7 ℃）：兰州夏季辐照强（7 月 6.20）+ 气温较高，组件高温工况与深圳同级——高温 MPPT 下限校核不可忽略（区别于拉萨的高原凉爽优势）。

## 6. 数据一致性说明

- NASA POWER 5 年平均水平面总辐射约 4.54 kWh/m2·d → 年约 1659 kWh/m2·yr，属国家太阳能资源**较丰富区**（高于哈尔滨 1400、低于拉萨 1988，与深圳 1585 相当）；
- 处理：逐月相对变化以 NASA POWER 为准（单一来源、口径一致）；气象局年总量作参考，报告中如实说明即可，不需要混用；
- 备选复核：PVGIS（https://re.jrc.ec.europa.eu/pvg_tools/en/）可选 30° 倾角直接给出倾斜面逐月数据，W5 前可用其复核最不利月与倾斜面辐照。

## 7. 输出汇总（供 W4/W5 使用）

| 结果 | 数值 | 用途 |
|---|---|---|
| 最不利设计月 | 12 月（采暖负荷驱动） | 光伏阵列容量计算基准（W5） |
| 设计面峰值日照时数 | 水平 2.82 h/d；倾斜 30° = **3.24 h/d**（倾角核算已确认） | 阵列容量（W5） |
| 最低环境温度 | -23.1 ℃ | 低温开路电压校核（W5） |
| 最高环境温度 | 39.1 ℃（组件最高约 70.4 ℃） | 组件温度估算（W5） |
| 设计倾角 | 30°、朝向正南（核算确认，见 倾角核算-兰州.md） | 阵列布置（W5/W8） |
| 年水平面总辐射 | 约 1659 kWh/m2·yr | 资源报告（较丰富区） |

## 8. 参考资料

1. NASA POWER 月度 API（36.05°N, 103.83°E, 2019–2023）：https://power.larc.nasa.gov/api/temporal/monthly/point?parameters=ALLSKY_SFC_SW_DWN,T2M&community=RE&longitude=103.83&latitude=36.05&start=2019&end=2023&format=JSON
2. 兰州市气象台气候资料（极端温度）。
3. PVGIS 复核工具：https://re.jrc.ec.europa.eu/pvg_tools/en/
