sunny1043/offgrid-pv-course-design/差异化城市设计/负荷调查-兰州.md

# 负荷调查 — 兰州（差异化设计 · 冬季采暖版）

> 依据：课程设计任务书 §3.1「标准化家庭负载估算与日均能耗计算工作表」；设计指导书 §2（计算口径、表1 建议范围）。每台设备落实到具体品牌型号与官方/可检索参数（来源见 §7）。
> 状态：已完成（2026-09-03 完善至与深圳/拉萨同级详细度，覆盖 D3 检查点②交付要求）。
> 设计点：**冬季采暖季 E_AC = 7.82 kWh/d**（对应任务书负荷区间 **7.5~8.0 kWh/d，学号末位 4/5**；如你的分配区间不同，可按 §8 微调设备运行时间）。

## 0. 基本条件与假设（兰州差异化核心）

| 项目 | 取值 | 说明 |
|---|---|---|
| 设计城市 | 兰州（36.05°N、103.83°E，海拔约 1520 m） | 温带大陆性气候，干燥少雨、昼夜温差大；**8 度抗震设防区** |
| 家庭结构 | 3 口之家（假定） | 同深圳示例口径 |
| 住宅 | 普通住宅 90~110 m²（假定） | 冬季需采暖、夏季轻度制冷 |
| 电压等级 | 交流 220 V / 50 Hz；直流 48 V 级 | 任务书统一条件 |
| 能量口径 | 交流侧日用电量 E_AC | 蓄电池公式直接使用 E_AC，不重复除以逆变器效率（指导书 §2.2） |
| **季节性负荷结构** | 深圳靠**夏季空调**撑高负荷；兰州高负荷由**冬季电采暖**承担（同拉萨/哈尔滨），夏季为轻度空调 | 这是本设计的差异化主线（答辩重点） |
| 采暖期 | 11–3 月（5 个月，月均温 -4.8~1.2 ℃） | 与拉萨同假设（兰州冬季不如哈尔滨严寒，采暖需求温和些） |
| 过渡月 | 4 月、10 月（月均温 7.7~8.5 ℃，夜间偏冷） | 仅用电热毯 |
| 夏季空调 | 6–8 月午后短时使用（变频 1.5P），4 h/d × 运行系数 0.4 | 兰州 7 月均温约 20.7 ℃，**确有轻度空调需求**（与拉萨"几乎无空调"不同，与哈尔滨类似但系数较低） |
| 冬季电采暖 | 电热毯（150 W × 8 h）+ 对流式电暖器（1.2 kW × 5 h × 系数 0.5） | 见 §1，冬季必需，总量仍控制在任务书区间内 |
| **抗震（兰州差异化）** | **8 度抗震设防**：蓄电池柜、支架、设备固定须按抗震要求校核（W8 落实） | 四城中兰州抗震设防要求最明确，是差异化答辩点之一 |

## 1. 家庭关键负荷清单（具体产品型号，冬季口径）

| 类别 | 设备（具体型号） | 数量 | 关键参数 | 日运行(h) | 运行系数 | 日耗电(kWh/d) | 计算口径 |
|---|---|---|---|---|---|---|---|
| 制冷空调 | 海尔 BCD-235WFCI 三门风冷变频冰箱 | 1 | 0.54 kWh/24h（能效标识） | — | — | **0.54** | 能效标识日耗电量 |
| 制冷空调 | 美的 KFR-35GW/N8KS1-1 变频 1.5P（仅 6–8 月午后） | 1 | 额定制冷输入 845 W | 4.0 | 0.4 | **1.35**（6–8 月） | 0.845×4×0.4（夏季月才计入） |
| **采暖（新增，兰州冬季）** | 双人电热毯（标称 150 W） | 1 | 150 W | 8 | 1.0 | **1.20** | 0.15×8（采暖季每晚） |
| **采暖（新增，兰州冬季）** | 对流式电暖器（标称 1200 W，房间保温一般） | 1 | 1200 W | 5 | 0.5（间歇运行） | **3.00** | 1.2×5×0.5（采暖季傍晚/夜间） |
| 照明 | 飞利浦 LED 球泡 12 W × 8 | 8 | 12 W | 4 | 1.0 | **0.38** | 0.012×8×4 |
| 通信信息 | 小米路由器 AX3000 | 1 | 约 6 W | 24 | 1.0 | **0.14** | 0.006×24 |
| 通信信息 | Redmi 智能电视 A55 节能版 | 1 | 约 110 W | 4 | 1.0 | **0.44** | 0.11×4 |
| 通信信息 | 笔记本电脑（联想小新 Pro 14，假定） | 1 | 65 W PD 适配器 | 5 | 1.0 | **0.33** | 0.065×5 |
| 通信信息 | 手机快充充电器（小米 67 W ×2，假定） | 2 | 平均约 10 W | 3 | 1.0 | **0.06** | 0.01×2×3 |
| 基本炊事 | 美的 FB40Simple111 电饭煲（4 L） | 1 | 约 860 W | 0.6 | 1.0 | **0.52** | 0.86×0.6 |
| 基本炊事 | 美的 WHJ1705b 电热水壶（1.7 L） | 1 | 1800 W | 0.15 | 1.0 | **0.27** | 1.8×0.15 |
| 基本炊事 | 方太 CXW-258-JCD7 油烟机 | 1 | 258 W | 0.5 | 1.0 | **0.13** | 0.258×0.5 |
| 基本炊事 | 格兰仕 P70D20TL-D4 微波炉 | 1 | 输入约 1150 W | 0.1 | 1.0 | **0.12** | 1.15×0.1 |
| 基本炊事 | 美的 C21-RT2170 电磁炉（周末午餐） | 1 | 2100 W | 0.06（日均） | 1.0 | **0.12** | 2.1×(0.4/7) |
| 生活辅助 | 海尔 EG100MATE2S 滚筒洗衣机 | 1 | 整程序平均约 500 W | 0.75 | 1.0 | **0.38** | 0.5×0.75 |
| 生活辅助 | 待机负荷（电视/微波炉/电磁炉/洗衣机/电暖器待机） | — | 约 8 W | 24 | 1.0 | **0.19** | 0.008×24 |

> 冬季口径（11–3 月）：基础负荷（不含空调与采暖）= 3.62 kWh/d；采暖 = 1.20 + 3.00 = 4.20 kWh/d。
> **冬季 E_AC = 3.62 + 4.20 = 7.82 kWh/d**（任务书 7.5~8.0 区间内 ✅，亦在总区间 6.5~8.5 内）。
> 夏季（6–8 月，含空调）= 3.62 + 1.35 = 4.97 kWh/d；过渡月（4、10 月）= 3.62 + 1.20 = 4.82 kWh/d；温和月（5、9 月）= 3.62 kWh/d。

## 2. 分类小计与建议范围对照（指导书 §2.1 表 1）— 冬季口径

| 类别 | 本方案(kWh/d) | 建议范围(kWh/d) | 结论 |
|---|---|---|---|
| 制冷和空调 | 0.54（冬季无空调，仅冰箱） | 3.3 ~ 5.0 | 偏离（见说明） |
| **采暖（兰州冬季替代空调的位置）** | **4.20** | — | 新增季节性大项（冬冷城市） |
| 照明 | 0.38 | 0.3 ~ 0.6 | ✅ |
| 通信和信息设备 | 0.97 | 0.8 ~ 1.4 | ✅ |
| 基本炊事 | 1.15 | 0.7 ~ 1.2 | ✅ |
| 生活辅助 | 0.57 | 0.5 ~ 1.0 | ✅ |
| **合计（冬季设计点）** | **7.82** | 6.5 ~ 8.5 | ✅ |

> **关于「制冷和空调」偏离说明（答辩重点）**：表1 的建议范围基于**含空调的普通家庭**。兰州冬季（设计点口径）无空调运行，制冷类别仅冰箱 0.54；与拉萨"夏季几乎无空调"不同，兰州 **6–8 月确有轻度空调需求**（7 月均温约 20.7 ℃，按 845 W×4 h×0.4 = 1.35 kWh/d 计入夏季月）。本方案设计点取**冬季采暖月**（负荷最高 + 辐照最低叠加月），故制冷类别按冬季口径显示偏低——其夏季位置由空调承担、冬季位置由采暖 4.20 kWh/d 承接。指导书 §2.1 明确"各项范围用于帮助检查总量是否合理，不要求机械取中值"，且冬季合计 7.82 在分配区间内，符合任务书要求。

## 3. 24 h 负荷运行表（冬季工作日，1 h 时段）

| 时段 | 运行设备 | 同时功率(kW) |
|---|---|---|
| 00:00–06:00 | 电热毯 + 冰箱 + 路由 + 待机 + 手机充电 | 0.32 |
| 06:00–07:00 | 电热毯 + 冰箱 + 路由 + 待机 + 电饭煲（早餐） | 1.16 |
| 07:00–12:00 | 冰箱 + 路由 + 待机（电热毯关） | 0.15 |
| 12:00–13:00 | 基础 + 微波炉（短时） | 1.30 |
| 13:00–15:00 | 基础 | 0.15 |
| 15:00–16:00 | 基础 + 洗衣机（洗涤/甩干） | 0.56 |
| 16:00–18:00 | 基础 | 0.15 |
| 18:00–19:00 | **电暖器** + 电热毯 + 电饭煲 + 油烟机 + 照明 + 电视 + 冰箱 + 路由 | 2.81 |
| **19:00–19:15** | 上时段 + **电热水壶**（烧水） | **4.61** ← 冬季峰值 |
| 19:15–20:00 | 电暖器 + 电热毯 + 照明 + 电视 + 冰箱 + 路由 | 1.69 |
| 20:00–22:30 | 电暖器 + 电热毯 + 照明 + 电视 + 笔记本 + 冰箱 + 路由 | 2.02 |
| 22:30–24:00 | 电热毯 + 照明 + 路由 + 冰箱 | 0.38 |

> 电暖器按运行平均功率 1.2 kW 计（运行系数 0.5，出现在 18:00–23:00 时段内）；电热毯 0.15 kW 全夜运行。
> 电热水壶（19:00–19:15）与电饭煲、电暖器叠加形成冬季峰值——已在表中体现（指导书 §2.3 要求，不能只在文字中说明）。

## 4. 最大同时功率（含周末校核，指导书 §2.3）

- **冬季工作日**峰值：19:00–19:15 烧水时段 = 电暖器 1.2 + 电热毯 0.15 + 水壶 1.8 + 电饭煲 0.86 + 油烟机 0.26 + 照明 0.10 + 电视 0.11 + 冰箱 0.12 + 路由 0.01 ≈ **4.6 kW**；
- **周末校核**：电磁炉安排周末**午餐**（12:00–13:00，电暖器未开）：2.1 + 0.86（电饭煲）+ 0.26（油烟机）+ 0.10 + 0.11 + 0.12 + 0.01 ≈ **3.6 kW**，低于冬季工作日峰值；
- **结论：P_max ≈ 4.6 kW**（冬季电采暖 + 炊事峰值，明显高于深圳的 3.0 kW——差异化点之一，与拉萨/哈尔滨同值）。

## 5. 短时冲击功率

| 启动设备 | 启动倍数 | 短时功率(kW) | 说明 |
|---|---|---|---|
| 冰箱压缩机 | 约 5 倍（~120 W 额定） | 0.60 | 间歇启动 |
| 空调（变频，仅夏季） | 低倍数 | — | 变频软启动，不套定频 5~7 倍（指导书 §2.4） |
| 洗衣机甩干 | 短时峰值 | 1.00 | 15:00 时段，不与炊事高峰重叠 |
| 电暖器/电热毯/水壶/电磁炉 | 阻性无冲击 | — | 电阻负载无启动冲击 |

- 最不利组合：冬季烧水高峰 + 冰箱压缩机启动：P_short ≈ 4.6 + 0.6 ≈ **5.2 kW**；
- **结论：系统短时冲击功率 ≈ 5.2 kW**（用于逆变器短时功率校核，指导书 §7.2）。

## 6. 输出汇总（供后续章节使用）

| 结果 | 数值 | 用途（指导书 §2 末） |
|---|---|---|
| 交流侧日用电量 E_AC（冬季设计点） | **7.82 kWh/d** | 蓄电池容量、光伏阵列容量（W4/W5） |
| E_AC（过渡月 4、10 月） | 4.82 kWh/d | 逐月供能复核 |
| E_AC（夏季 6–8 月，含轻空调） | 4.97 kWh/d | 逐月供能复核 |
| E_AC（温和月 5、9 月） | 3.62 kWh/d | 逐月供能复核 |
| 最大同时功率 P_max | **4.6 kW**（冬季） | 逆变器额定功率（W6） |
| 短时冲击功率 P_short | **5.2 kW** | 逆变器短时功率校核（W6） |
| 24 h 运行表 | 见 §3 | 峰值时段、错峰安排 |

## 7. 产品规格来源（查询日期 2026-09-01）

| # | 设备 | 来源 |
|---|---|---|
| 1 | 海尔 BCD-235WFCI 冰箱（0.54 kWh/24h、一级能效） | [海尔官网产品页](https://www.haier.com/cooling/20201112_150262.shtml) |
| 2 | 美的 KFR-35GW/N8KS1-1 变频空调（845 W 输入，70~1900 W） | [中关村在线参数页](https://detail.zol.com.cn/1632/1631464/param.shtml)；APF 5.30（能效标识） |
| 3 | 双人电热毯 150 W（典型值） | 电商在售主流型号标称功率（型号可替换，功率口径不变） |
| 4 | 对流式电暖器 1.2 kW（典型值） | 电商在售主流型号标称功率（型号可替换，功率口径不变） |
| 5 | 飞利浦 LED 球泡 12 W | [飞利浦照明官网](https://www.lighting.philips.com.cn/consumer/p/led-bulb-90w-a60m-e27/6922341928758) |
| 6 | 小米路由器 AX3000（5~6 W） | [小米官网](https://www.mi.com/tw/product/xiaomi-router-ax3000t/) / 实测 |
| 7 | Redmi 智能电视 A55 节能版 | [小米官网](https://www.mi.com/redmi-tvs/a-55-es) |
| 8 | 笔记本（联想小新 Pro 14）/ 手机充电器（小米 67 W） | 假定型号，可按实际替换 |
| 9 | 电饭煲/水壶/油烟机/微波炉/电磁炉 | 同深圳示例清单（美的/方太/格兰仕，来源见 docs/负荷调查-深圳.md §7） |
| 10 | 海尔 EG100MATE2S 洗衣机（10 kg 变频） | [海尔官网产品页](https://www.haier.com/laundry/20210623_162186.shtml) |

> 说明：电热毯、电暖器为兰州冬季采暖新增设备，型号可按实际替换，但功率与运行时间口径（150 W×8 h；1.2 kW×5 h×0.5）保持不变以保证总负荷在区间内。

## 8. 待确认事项

1. **学号末位对应的负荷区间**：本方案按 7.5~8.0 kWh/d（学号末位 4/5）设计；如你的区间不同（如 6.5~7.0），可把电暖器日耗电从 3.00 调至 2.20（1.2 kW×3.7 h×0.5）→ 冬季 E_AC≈7.0，各章同步微调；
2. 家庭结构（3 口之家）与住宅面积、屋面形式（影响 W8 阵列布置与**8 度抗震**固定校核）；
3. 电热毯/电暖器具体型号替换（功率口径不变）；
4. 夏季空调（6–8 月午后 4 h×0.4）是否符合本人生活习惯，可调（兰州 7 月均温 20.7 ℃，若实际不用空调可降至 0.4→0，则夏季 E_AC=3.62）；
5. 兰州冬季采暖时长（11–3 月假设）可按家庭实际微调；**是否考虑太阳能热水器/壁挂炉**替代部分电热可作答辩讨论（不计入本设计）。
