sunny1043/offgrid-pv-course-design/差异化城市设计/多城市对比总览.md

# 多城市差异化设计总览（深圳 / 拉萨 / 兰州 / 哈尔滨）

> 本仓库现包含**四个城市**的完整设计链：深圳（团队基线）+ 拉萨、兰州、哈尔滨（差异化城市，W1–W6 由 sunny1043 提交 3e002c4 入库，W7–W9 由本机补齐）。
> 全部数据同一口径：NASA POWER 2019–2023 五年平均 + Liu-Jordan 倾角模型 + 指导书/任务书公式。负荷设计点统一按冬季采暖 E_AC = 7.82 kWh/d（区间 7.5~8.0，学号末位 4/5，可按区间微调）。

## 一、四个城市关键指标对比

| 设计环节 | 深圳（基线） | 拉萨 | 兰州 | 哈尔滨 |
|---|---|---|---|---|
| 纬度 | 22.54°N | 29.66°N | 36.05°N | 45.80°N |
| 气候 | 亚热带海洋性 | 高原温带（海拔 3650 m） | 温带大陆性（8 度抗震） | 严寒大陆性 |
| E_AC 设计点 | 6.99（空调月） | 7.82（采暖季） | 7.82（采暖季） | 7.82（采暖季） |
| 最不利设计月 | 10 月 | 12 月 | 12 月 | 12 月 |
| 最不利月水平 H | 4.29 | 4.23 | 2.82 | 1.68 |
| 年水平面辐照 kWh/m2 | 约 1585 | 约 1988（全国顶级） | 约 1659 | 约 1400 |
| 极端最低/最高温 ℃ | 0.2 / 38.7 | -16.5 / 29.4 | -23.1 / 39.1 | -38.1 / 39.2 |
| 设计倾角 | 20° | 30° | 30° | 40° |
| 排间节距 ×L | 1.62 | 2.13 | 2.51 | 4.57 |
| 蓄电池 | 19.34 kWh / 4 台 | 21.64 / 5 台 | 21.64 / 5 台 | 21.64 / 5 台 |
| 蓄电池低温 | 无需处理 | 保温必须 | 保温必须 | 保温+加热必须 |
| P_PV,min kWp | 2.20 | 2.32 | 3.40 | 5.37 |
| 阵列 kWp / 串并 | 2.40 / 4×1 | 3.00 / 5×1 | 3.60 / 6×1 | 6.00 / 5×2 |
| 组串低温 Voc V | 220.8 | 286.1 | 348.0 | 299.0（每台一串） |
| 串联可行域 | [4, 8] | [4, 7] | [4, 7] | [4, 7] |
| 最不利月供能比 | 1.20 | 1.42 | 1.17 | 1.23 |
| 逆变器 | SPF 5000 ES | SPF 5000 ES | SPF 5000 ES | **2× SPF 5000 ES 并联** |
| 最大充电电流 A | 42.4 | 52.9 | 63.5 | 105.9（合计） |
| 新增校核点 | — | 高海拔降额、低温充电 | 8 度抗震、低温充电 | 双机并联、严寒低温、雪荷载 |

## 二、W7–W9 完成情况（以深圳为模板补齐三城）

### W7 线缆/保护/防雷接地

| 项目 | 深圳 | 拉萨 | 兰州 | 哈尔滨 |
|---|---|---|---|---|
| 组串熔断器 | F1 25A gPV | F1 25A gPV | F1 25A gPV | F1a/F1b 2×25A gPV |
| 直流 SPD 要求 | U_cpv≥265V | U_cpv≥345V | U_cpv≥420V | U_cpv≥360V（×2 成对） |
| 电池→逆变器 | RV 70mm² + QF1 160A | RV 70mm² + QF1 160A | RV 70mm² + QF1 160A | RV 70mm² + QF1a/QF1b 2×160A |
| 电池支路熔断器 | 4×100A gPV | 5×100A gPV | 5×100A gPV | 5×100A gPV |
| 逆变器→配电箱 | RVV 6mm² + 32A | RVV 6mm² + 32A | RVV 6mm² + 32A | RVV 6mm² + 32A（×2） |
| 采暖/空调回路 | 空调 20A BV4mm² | 采暖插座 10A BV2.5mm² | 采暖插座 10A BV2.5mm² | 采暖插座 10A BV2.5mm² |
| 防雷等级 | 多雷区两级 SPD | 少雷区 | 中等雷区 | 中等雷区 |
| 基本风压 w0 | 0.75 kN/m² | 0.15 kN/m² | 0.30 kN/m² | 0.55 kN/m²（+雪压 0.45） |
| 计算文件 | 计算-线缆保护-深圳.xlsx | 计算-线缆保护-拉萨.xlsx | 计算-线缆保护-兰州.xlsx | 计算-线缆保护-哈尔滨.xlsx |

### W8 支架/屋面/设备间布置

| 项目 | 深圳 | 拉萨 | 兰州 | 哈尔滨 |
|---|---|---|---|---|
| 组件布置 | 4 块横排 | 5 块竖排（5 串×1 并） | 6 块竖排（6 串×1 并） | 10 块竖排（5 串×2 并） |
| 屋面假设 | 12×5 m | 6×5 m | 7×6 m | 12×6 m |
| 排间节距 D | 1.84 m | 5.09 m | 5.98 m | 10.88 m（东西向单排规避） |
| 支架校核 σ / f | 24.3 MPa / 0.88 mm | 5.6 MPa / 0.21 mm | 9.9 MPa / 0.36 mm | 19.2 MPa / 0.61 mm |
| 设备间 | 3.0×2.5 m | 3.0×2.5 m（保温≥10℃） | 3.0×2.5 m（8 度抗震） | 3.5×2.5 m（保温+加热） |
| 计算文件 | 计算-支架-深圳.xlsx | 计算-支架-拉萨.xlsx | 计算-支架-兰州.xlsx | 计算-支架-哈尔滨.xlsx |

### W9 三张 A3 图纸（SVG+PDF+PNG，docs/drawings/）

| 图号 | 深圳 | 拉萨 | 兰州 | 哈尔滨 |
|---|---|---|---|---|
| T1-01 系统电气主接线图 | ✅ | ✅ | ✅ | ✅（双机成对回路） |
| T1-02 光伏阵列及支架布置图 | ✅ | ✅ | ✅ | ✅（东西向单排） |
| T1-03 设备间平面及安装接线图 | ✅ | ✅ | ✅ | ✅（双逆变器） |

> 图纸源文件为可编辑 SVG，另附 A3 PDF（直接打印/提交）与 PNG 预览；**姓名/学号栏留空待填**。详见 [docs/drawings/README.md](../docs/drawings/README.md)。

## 三、各城市差异化主线（答辩可讲）

1. **深圳（基线）**：夏季空调驱动最不利月（10 月），资源温和、低温可忽略，单台 5 kW 一体机，2.40 kWp 最小可行阵列。
2. **拉萨（资源型差异化）**：年辐照全国顶级且全年平坦，最不利月（12 月）仍 4.23（比深圳年均高）；最不利月是「采暖负荷」驱动而非「辐照塌陷」；夏季供能比 2.8~4.4 大富余；新增**高海拔 3650 m 降额**校核。
3. **兰州（中间态 + 抗震）**：冬季辐照中等（12 月 3.24），阵列 3.60 kWp；新增 **8 度抗震设防**校核（支架/设备固定），是四城里唯一明确抗震要求最严的城市；低温 -23.1 ℃ 需设备间保温。
4. **哈尔滨（最严苛）**：冬季辐照塌陷（12 月水平 1.68），阵列需 6.00 kWp（其他城市 2 倍以上）；两串并联超过单台 MPPT 电流限值，**双机（2× SPF 5000 ES）并联、每台一串**；-38.1 ℃ 极端低温使蓄电池保温+加热为硬性前提；倾角 40°、排距 4.57×L（深圳的 2.8 倍）；新增雪荷载（约 0.45 kN/m2）与严寒低温充电校核。

## 四、文件清单

| 城市 | W1–W6 文档（各 7 份 + Excel 2 份） | W7–W9 补充 |
|---|---|---|
| 深圳（基线） | 负荷调查/太阳能资源/倾角核算/系统组成/蓄电池/光伏阵列/控制器逆变器-深圳.md + 2 Excel | 线缆保护防雷接地/支架设备间布置-深圳.md + 计算-线缆保护/支架-深圳.xlsx + docs/drawings/ T1-01/02/03 |
| 拉萨 | 负荷调查/太阳能资源/倾角核算/系统组成/蓄电池/光伏阵列/控制器逆变器-拉萨.md + 2 Excel | 线缆保护防雷接地/支架设备间布置-拉萨.md + 计算-线缆保护/支架-拉萨.xlsx + docs/drawings/ T1-01/02/03-拉萨 |
| 兰州 | 负荷调查/太阳能资源/倾角核算/系统组成/蓄电池/光伏阵列/控制器逆变器-兰州.md + 2 Excel | 线缆保护防雷接地/支架设备间布置-兰州.md + 计算-线缆保护/支架-兰州.xlsx + docs/drawings/ T1-01/02/03-兰州 |
| 哈尔滨 | 负荷调查/太阳能资源/倾角核算/系统组成/蓄电池/光伏阵列/控制器逆变器-哈尔滨.md + 2 Excel | 线缆保护防雷接地/支架设备间布置-哈尔滨.md + 计算-线缆保护/支架-哈尔滨.xlsx + docs/drawings/ T1-01/02/03-哈尔滨 |

## 五、待确认（后续工作）

1. 学号末位对应的负荷区间（当前按 7.5~8.0，其余区间可微调电暖器运行时间，四城同步微调）；
2. SPF 5000 ES 高原额定（拉萨 3650 m）与双机并联套件（哈尔滨）厂家资料；
3. **三城基本风压/雪压**（拉萨 0.15 / 兰州 0.30 / 哈尔滨 0.55 + 雪 0.45 kN/m²）按 GB 50009 常识值采用，如教师要求严格核验需再查当地标准值；
4. 兰州 8 度抗震与哈尔滨雪荷载的具体规范参数（GB 50011 / GB 50009 当地值）可进一步注明条款号；
5. 遗留：差异化城市 6 个 W4/W5 Excel 说明列 `#NAME?`、拉萨蓄电池 Excel 空单元格引用、W9 图纸姓名/学号栏留空；
6. 下一步：W10 实验与数据处理、W11 设备清单与成本分析、W12 报告汇总。
