sunny1043/offgrid-pv-course-design/差异化城市设计/倾角核算-兰州.md

# 倾角核算 — 兰州（W2/W5 共用）

> 依据：指导书 §3.1/§3.2/§9.1。方法：Liu-Jordan 各向同性模型（同一实现，已校验）。数据：NASA POWER 2019–2023 五年平均。

## 1. 候选倾角逐月核算结果（kWh/m2·d，摘要）

| 倾角 | 1月 | 2月 | 11月 | **12月** | 全年(kWh/m2) |
|---|-----|-----|---|---|---|
| 0°（水平） | 2.99 | 3.74 | 3.22 | 2.82 | 1659 |
| 20° | 3.33 | 4.15 | 3.61 | 3.17 | 1841 |
| 25° | 3.37 | 4.20 | 3.66 | 3.21 | 1860 |
| **30°** | **3.39** | **4.22** | **3.68** | **3.24** | **1869** |
| 35° | 3.39 | 4.22 | 3.69 | 3.24 | 1866 |
| 40° | 3.37 | 4.20 | 3.67 | 3.23 | 1853 |

## 2. 最优倾角判定

| 判据 | 最优倾角 | 取值 |
|---|---|---|
| 最不利月（12 月）供能最大 | 30°~35°（并列） | 3.24 kWh/m2·d（较水平面 +15%） |
| 全年总量最大 | 30° | 1869 kWh/m2·yr |

> **结论：设计倾角 = 30°、正南**。兰州纬度 36.05°N，30° 接近「纬度 - 5°~纬度」区间，兼顾冬季（12 月最优）与全年总量。与拉萨同为 30°，但兰州冬季辐照改善幅度（+15%）大于拉萨（+12%），因为兰州散射占比更低、直射更强。

## 3. 最不利月复核（倾斜面口径）

| 月份 | 11 | 12 | 1 | 2 |
|---|----|----|----|----|
| H_tilt(30°) | 3.68 | 3.24 | 3.39 | 4.22 |
| R | 2.13 | **2.41** | 2.31 | 1.85 |

> 12 月仍为最不利月（R=2.41），结论稳健。

## 4. 排间节距校核（指导书 §9.1）

冬至 9:00 太阳高度角（兰州）：sin h ≈ 0.290 -> h ≈ **16.9°**

| 倾角 | 30° | 35° | 40° |
|---|-----|-----|-----|
| D（×斜面长 L） | **2.51** | 2.62 | 2.78 |

- 倾角 30° 时 D ≈ **2.51 × L**（深圳 1.62、拉萨 2.13；小于哈尔滨 4.57）——纬度越高、冬季太阳越低，排间节距越大。

## 5. 输出汇总

| 结果 | 数值 |
|---|---|
| 设计倾角 | 30°（正南） |
| 最不利月（12 月）倾斜面日辐照 | 3.24 kWh/m2·d |
| 全年倾斜面总量 | 1869 kWh/m2·yr |
| 排间节距 | 2.51 × L |

## 6. 数据来源

1. NASA POWER（总辐射+散射）：https://power.larc.nasa.gov/api/temporal/monthly/point?parameters=ALLSKY_SFC_SW_DWN,ALLSKY_SFC_SW_DIFF&community=RE&longitude=103.83&latitude=36.05&start=2019&end=2023&format=JSON
2. 换算模型：Liu-Jordan 各向同性（正南，rho=0.2）。
3. PVGIS 复核：https://re.jrc.ec.europa.eu/pvg_tools/en/
