sunny1043/offgrid-pv-course-design/差异化城市设计/倾角核算-拉萨.md

# 倾角核算 — 拉萨（W2/W5 共用）

> 依据：设计指导书 §3.1（倾斜面换算方法须说明）、§3.2（按月比较负荷与资源）、§9.1（排间节距）。
> 方法：Liu-Jordan 各向同性模型；数据：NASA POWER 2019–2023 五年平均（水平面总辐射 G 与散射辐射 D，29.66°N、91.14°E）。
> 状态：本地草稿（拉萨差异化新建）。
> 模型校验：同一实现代入深圳数据，20° 时 10 月=4.46、12 月=3.44、全年=1642 kWh/m2·yr，与倾角核算-深圳.md 完全一致，说明模型可靠。

## 1. 换算方法（指导书 §3.1 要求说明）

水平面数据换算到倾斜面，采用 Liu-Jordan 各向同性模型：

    G_tilt(beta) = B*Rb + D*(1+cos beta)/2 + G*rho*(1-cos beta)/2

- B = G - D：水平面直射分量；D：水平面散射分量；rho = 0.2：地面反射率；
- Rb：正南朝向倾斜面/水平面逐日直射比（月中代表日赤纬，太阳时角积分）；
- 每月用该月平均日辐照量代入，得该月倾斜面日辐照量。

## 2. 候选倾角逐月核算结果（kWh/m2·d）

| 倾角 | 1月 | 2月 | 3月 | 4月 | 5月 | 6月 | 7月 | 8月 | 9月 | 10月 | 11月 | 12月 | 全年(kWh/m2) |
|---|-----|-----|-----|-----|-----|-----|-----|-----|-----|---|---|---|---|
| 0°（水平） | 4.42 | 4.87 | 5.74 | 6.04 | 6.44 | 6.74 | 5.64 | 5.64 | 5.50 | 5.31 | 4.78 | 4.23 | 1988 |
| 15° | 4.79 | 5.22 | 6.12 | 6.36 | 6.81 | 7.17 | 5.93 | 5.92 | 5.79 | 5.70 | 5.20 | 4.61 | 2118 |
| 20° | 4.86 | 5.28 | 6.18 | 6.40 | 6.86 | 7.23 | 5.97 | 5.95 | 5.82 | 5.77 | 5.28 | 4.68 | 2138 |
| 25° | 4.90 | 5.31 | 6.21 | 6.41 | 6.87 | 7.24 | 5.97 | 5.95 | 5.83 | 5.80 | 5.33 | 4.72 | 2145 |
| 30° | 4.90 | 5.31 | 6.20 | 6.39 | 6.84 | 7.21 | 5.93 | 5.92 | 5.81 | 5.80 | 5.34 | 4.74 | 2141 |
| 35° | 4.88 | 5.28 | 6.16 | 6.33 | 6.77 | 7.14 | 5.87 | 5.86 | 5.76 | 5.77 | 5.32 | 4.72 | 2125 |
| 40° | 4.83 | 5.22 | 6.08 | 6.23 | 6.67 | 7.03 | 5.77 | 5.76 | 5.67 | 5.71 | 5.27 | 4.68 | 2097 |
| 45° | 4.76 | 5.13 | 5.97 | 6.11 | 6.53 | 6.87 | 5.65 | 5.65 | 5.56 | 5.61 | 5.18 | 4.60 | 2057 |

## 3. 最优倾角判定

| 判据 | 最优倾角 | 取值 |
|---|---|---|
| 最不利月（12 月）供能最大 | 30° | 4.74 kWh/m2·d（较水平面 +12.1%） |
| 全年总量最大 | 25° | 2145 kWh/m2·yr（30° 为 2141，仅低 0.2%） |

> 结论：设计倾角 = 30°、朝向正南。拉萨纬度 29.66°N，30° 约等于纬度——高原晴空下冬季直射占比高，30° 使 12 月（最不利月）倾斜面辐照最大化，同时全年总量几乎不损失。
> 说明：拉萨资源极平坦，倾角 15°~45° 之间 12 月辐照仅差 0.14 kWh/m2·d（4.60~4.74），不像高纬度城市对倾角那么敏感；取 30° 主要照顾冬季直射利用与排间布置的平衡。

## 4. 最不利月复核（倾斜面口径，指导书 §3.2）

按 R = E_AC / H_tilt(30°) 复核，R 最大月仍为 12 月（1.65），结论稳健：

| 月份 | 1 | 2 | 3 | 4 | 5 | 6 | 7 | 8 | 9 | 10 | 11 | 12 |
|---|---|---|---|---|---|---|---|---|---|---|----|----|
| R | 1.60 | 1.47 | 1.26 | 0.75 | 0.53 | 0.69 | 0.84 | 0.84 | 0.62 | 0.83 | 1.47 | 1.65 |

## 5. 排间节距校核（指导书 §9.1）

校核时刻取冬至日 9:00（太阳时），拉萨冬至赤纬 -23.45°，正午 12:00 时角 0°、9:00 时角 45°：

    sin h = sin(phi)*sin(delta) + cos(phi)*cos(delta)*cos(omega)   ->  h = 21.5°
    排间节距  D = L*(cos(beta) + sin(beta)/tan h)

| 倾角 | 20° | 25° | 30° | 35° |
|---|-----|-----|-----|-----|
| D（×斜面长 L） | 1.95 | 2.04 | 2.13 | 2.27 |

- 倾角 30° 时：D = 2.13 × L（L 为组件斜面长，按实际组件尺寸代入，W8 屋面布置用）；
- 对比深圳（20° 时 1.62 × L）：拉萨 30° 时 2.13 × L，排间节距大 31%——因为倾角更大、且拉萨纬度（29.66°N）高于深圳（22.54°N），冬至太阳高度角更低（21.5° vs 26.5°）；
- 说明：该式用于初估，屋面障碍物/复杂阴影另做阴影分析（指导书 §9.1 原文）。

## 6. 输出汇总（供 W5 使用）

| 结果 | 数值 |
|---|---|
| 设计倾角 | 30°（正南） |
| 最不利月倾斜面日辐照 | 4.74 kWh/m2·d（12 月） |
| 倾斜面峰值日照时数 | 4.74 h/d（12 月） |
| 全年倾斜面总量 | 2141 kWh/m2·yr |
| 排间节距 | 2.13 × L（冬至 9:00 校核） |

## 7. 数据来源

1. NASA POWER 月度 API（总辐射 + 散射，2019–2023）：https://power.larc.nasa.gov/api/temporal/monthly/point?parameters=ALLSKY_SFC_SW_DWN,ALLSKY_SFC_SW_DIFF&community=RE&longitude=91.14&latitude=29.66&start=2019&end=2023&format=JSON
2. 换算模型：Liu-Jordan 各向同性模型（正南朝向，rho=0.2），月代表日月中赤纬。
3. 复核工具（可选）：PVGIS https://re.jrc.ec.europa.eu/pvg_tools/en/（选 30° 倾角直接复核逐月倾斜面辐照）。
