sunny1043/offgrid-pv-course-design/差异化城市设计/太阳能资源-拉萨.md

# 太阳能资源与环境参数 — 拉萨（W2）

> 依据：设计指导书 §3（太阳能资源和环境参数）、§3.1（单一数据源原则）。
> 状态：本地草稿（拉萨差异化新建）。
> 数据源：NASA POWER（MERRA2/SYN1DEG，API v2.9.8，LST），坐标 29.66°N、91.14°E（拉萨市区），2019–2023 共 5 年平均——与深圳示例同一数据源、同一口径。查询日期 2026-09-01。

## 1. 数据来源声明（单一数据源原则，指导书 §3.1）

| 数据项 | 来源 | 说明 |
|---|---|---|
| 逐月水平面辐照量、月均温 | NASA POWER（5 年平均） | 29.66°N、91.14°E，2019–2023 |
| 极端气温 | 拉萨市气象台公开资料 | 历史极端最高约 29.4 ℃、极端最低约 -16.5 ℃ |
| 年水平面总辐射 | NASA POWER 5 年平均 | 本方案约 1988 kWh/m2·yr（全国最高级别，见 §6） |

> 拉萨特点：海拔约 3650 m、空气稀薄、云量少，年水平面辐照为全国/全球顶级（约 1988 kWh/m2·yr），且逐月辐照非常平坦——12 月（最差月）仍有 4.23 kWh/m2·d，比深圳年均还高。

## 2. 逐月水平面辐照量与月均温（NASA POWER，5 年平均）

| 月份 | 1 | 2 | 3 | 4 | 5 | 6 | 7 | 8 | 9 | 10 | 11 | 12 |
|---|---|---|---|---|---|---|---|---|---|----|----|----|
| H（kWh/m2·d） | 4.42 | 4.87 | 5.74 | 6.04 | 6.44 | 6.74 | 5.64 | 5.64 | 5.50 | 5.31 | 4.78 | 4.23 |
| T（℃） | -5.2 | -3.0 | 1.2 | 4.6 | 8.4 | 12.9 | 12.4 | 11.8 | 9.7 | 5.8 | 0.9 | -3.1 |

- 水平面辐照最低月：12 月（4.23）约等于 1 月（4.42）——比深圳常年均值（约 4.34）还高；
- 月均温最低 1 月（-5.2 ℃），最高 6 月（12.9 ℃）——年较差小（约 18 ℃）、日较差大（常达 12~15 ℃），这是高原气候特征；
- 年水平面总辐射约 1988 kWh/m2·yr（均值约 5.45 kWh/m2·d）。

## 3. 最不利设计月（负荷随季节变化，指导书 §3.2 按月比较法）

拉萨的差异化主线：深圳的最不利月由「夏季空调负荷 + 辐照回落」驱动（10 月）；拉萨的最不利月由冬季电采暖负荷 + 冬季（相对）低辐照驱动，但 12 月辐照仍有 4.23——是「负荷最高月」而非「辐照最低月」。

| 月份 | 1 | 2 | 3 | 4 | 5 | 6 | 7 | 8 | 9 | 10 | 11 | 12 |
|---|---|---|---|---|---|---|---|---|---|---|----|----|
| E_AC | 7.82 | 7.82 | 7.82 | 4.82 | 3.62 | 4.97 | 4.97 | 4.97 | 3.62 | 4.82 | 7.82 | 7.82 |
| H | 4.42 | 4.87 | 5.74 | 6.04 | 6.44 | 6.74 | 5.64 | 5.64 | 5.50 | 5.31 | 4.78 | 4.23 |
| R | 1.77 | 1.61 | 1.36 | 0.80 | 0.56 | 0.74 | 0.88 | 0.88 | 0.66 | 0.91 | 1.64 | 1.85 |

> 结论：最不利设计月 = 12 月（水平面 R = 1.85 最大）——12 月采暖负荷最高（7.82 kWh/d）且辐照为全年最低（4.23）。若忽略采暖季节变化只看辐照，会误选 5~6 月（辐照最高但负荷最低）——恰与深圳示例的误区相反，正是指导书 §3.2 强调的「按月比较」的价值。
> 夏季（5–9 月）R 仅 0.56~0.88：全年辐照远大于负荷，夏季大量富余充入蓄电池/弃光，能量平衡逻辑与深圳（夏季供能比 1.3~1.6）完全不同。

## 4. 峰值日照时数（指导书 §3.1）

- 水平面：数值上 H（kWh/m2·d）= 峰值日照时数（h/d）→ 12 月 = 4.23 h/d；
- 倾斜面（倾角 30°、正南，Liu-Jordan 换算，详见 倾角核算-拉萨.md）：12 月 = 4.74 h/d（较水平面 +12.1%）。

## 5. 温度参数（用于校核）

| 参数 | 取值 | 用途 | 来源 |
|---|---|---|---|
| 最低环境温度 | -16.5 ℃（历史极端最低） | 光伏组串低温开路电压校核（W5） | 拉萨市气象台公开资料 |
| 最高环境温度 | 29.4 ℃（历史极端最高） | 组件最高温度估算 | 拉萨市气象台公开资料 |
| 组件估算最高温度 | NOCT 公式：T_cell = T_amb + (NOCT-20)/800 × G | 高温 MPPT 电压校核（W5） | 指导书 §3.3 |

- NOCT 取 45 ℃（典型单晶组件），G = 1000 W/m2：
  - 按极端高温 29.4 ℃ → T_cell 约 29.4 + 31.3 = 60.7 ℃（极端工况）；
  - 按最热月 6 月月均温 12.9 ℃ → T_cell 约 12.9 + 31.3 = 44.2 ℃（常态最热月）；
  - 对比深圳（极端 70 ℃ / 常态 61 ℃）：拉萨组件高温远低于深圳——夏季凉爽是高原优势，对 MPPT 高温下限校核更宽裕（差异化点）。

## 6. 数据一致性说明

- NASA POWER 5 年平均水平面总辐射约 5.45 kWh/m2·d → 年约 1988 kWh/m2·yr，为全国最高级别之一（拉萨「日光城」），高于深圳的约 1585 kWh/m2·yr；
- 处理：逐月相对变化以 NASA POWER 为准（单一来源、口径一致）；气象局年总量作参考，报告中如实说明即可，不需要混用；
- 备选复核：PVGIS（https://re.jrc.ec.europa.eu/pvg_tools/en/）可选 30° 倾角直接给出倾斜面逐月数据，W5 前可用其复核最不利月与倾斜面辐照。

## 7. 输出汇总（供 W4/W5 使用）

| 结果 | 数值 | 用途 |
|---|---|---|
| 最不利设计月 | 12 月（采暖负荷驱动） | 光伏阵列容量计算基准（W5） |
| 设计面峰值日照时数 | 水平 4.23 h/d；倾斜 30° = 4.74 h/d（倾角核算已确认） | 阵列容量（W5） |
| 最低环境温度 | -16.5 ℃ | 低温开路电压校核（W5） |
| 最高环境温度 | 29.4 ℃（组件最高约 60.7 ℃） | 组件温度估算（W5） |
| 设计倾角 | 30°、朝向正南（核算确认，见 倾角核算-拉萨.md） | 阵列布置（W5/W8） |
| 年水平面总辐射 | 约 1988 kWh/m2·yr | 资源报告（全国顶级） |

## 8. 参考资料

1. NASA POWER 月度 API（29.66°N, 91.14°E, 2019–2023）：https://power.larc.nasa.gov/api/temporal/monthly/point?parameters=ALLSKY_SFC_SW_DWN,T2M&community=RE&longitude=91.14&latitude=29.66&start=2019&end=2023&format=JSON
2. 拉萨市气象台《拉萨市气候概况》：https://weather.tibet.cn.cn/
3. PVGIS 复核工具：https://re.jrc.ec.europa.eu/pvg_tools/en/
