sunny1043/offgrid-pv-course-design/docs/倾角核算-深圳.md

# 倾角核算 — 深圳（W2/W5 共用）

> 依据：设计指导书 §3.1（倾斜面换算方法须说明）、§3.2（按月比较负荷与资源）、§9.1（排间节距）。
> 方法：Liu-Jordan 各向同性模型；数据：NASA POWER 2019–2023 五年平均（水平面总辐射 G 与散射辐射 D，22.54°N、114.06°E）。
> 状态：本地草稿，未上传。

## 1. 换算方法（指导书 §3.1 要求说明）

水平面数据换算到倾斜面，采用 **Liu-Jordan 各向同性模型**：

```
G_tilt(β) = B·R_b + D·(1+cosβ)/2 + G·ρ·(1−cosβ)/2
```

- B = G − D：水平面直射分量；D：水平面散射分量；ρ = 0.2：地面反射率；
- R_b：正南朝向倾斜面/水平面逐日直射比（太阳时角积分，月代表日取月中，赤纬取月中值）；
- 每月用该月平均日辐照量代入，得该月倾斜面日辐照量。

## 2. 候选倾角逐月核算结果（kWh/m²·d）

| 倾角 | 1月 | 2月 | 3月 | 4月 | 5月 | 6月 | 7月 | 8月 | 9月 | **10月** | 11月 | 12月 | 全年(kWh/m²) |
|---|-----|-----|-----|-----|-----|-----|-----|-----|-----|---|---|---|---|
| 0°（水平） | 3.33 | 3.62 | 3.84 | 4.41 | 4.62 | 4.97 | 5.64 | 5.02 | 5.09 | 4.29 | 3.94 | 3.32 | 1583 |
| 10° | 3.42 | 3.72 | 3.94 | 4.53 | 4.75 | 5.12 | 5.83 | 5.16 | 5.25 | 4.42 | 4.07 | 3.42 | 1630 |
| 15° | 3.44 | 3.74 | 3.96 | 4.55 | 4.78 | 5.15 | 5.87 | 5.19 | 5.28 | 4.45 | 4.11 | 3.44 | 1640 |
| **20°** | **3.44** | **3.74** | **3.96** | **4.55** | **4.78** | **5.15** | **5.88** | **5.19** | **5.29** | **4.46** | **4.12** | **3.44** | **1642** |
| 25° | 3.43 | 3.72 | 3.94 | 4.53 | 4.76 | 5.12 | 5.85 | 5.16 | 5.27 | 4.44 | 4.11 | 3.43 | 1634 |
| 30° | 3.39 | 3.69 | 3.90 | 4.48 | 4.71 | 5.06 | 5.79 | 5.11 | 5.22 | 4.40 | 4.08 | 3.40 | 1618 |
| 35° | 3.35 | 3.63 | 3.84 | 4.41 | 4.63 | 4.97 | 5.70 | 5.03 | 5.14 | 4.34 | 4.02 | 3.35 | 1594 |

## 3. 最优倾角判定

| 判据 | 最优倾角 | 取值 |
|---|---|---|
| 最不利月（10 月）供能最大 | **20°** | 4.46 kWh/m²·d（较水平面 +4.0%） |
| 全年总量最大 | **20°** | 1642 kWh/m²·yr（较水平面 +3.7%） |

> **结论：设计倾角 = 20°、朝向正南**。10 月（最不利设计月）倾斜面日辐照 4.46 kWh/m²·d。
> 说明：深圳纬度 22.54°N，20° ≈ 0.9φ（常规经验值 φ−5°~φ−10° 附近）；离网系统优先保证秋冬/空调末期供能，20° 同时满足 10 月最优，无需为冬季加大倾角（30°+ 时 12 月虽略增，但 10 月与全年均下降）。

## 4. 最不利月复核（倾斜面口径，指导书 §3.2）

按 R = E_AC / H_tilt(20°) 复核，R 最大月仍为 **10 月（1.57）**，结论稳健：

| 月份 | 5 | 6 | 7 | 8 | 9 | **10** | 11 | 12 | 1 | 2 | 3 | 4 |
|---|---|---|---|---|---|---|----|----|---|---|---|---|
| R | 1.46 | 1.36 | 1.19 | 1.35 | 1.32 | **1.57** | 0.88 | 1.05 | 1.05 | 0.97 | 0.91 | 0.79 |

## 5. 排间节距校核（指导书 §9.1）

校核时刻取**冬至日 9:00（太阳时）**，深圳冬至赤纬 −23.45°，正午 12:00 时角 0°、9:00 时角 45°：

```
sin h = sinφ·sinδ + cosφ·cosδ·cosω  →  h = 26.5°
排间节距  D = L·(cosβ + sinβ/tan h)
```

| 倾角 | 15° | **20°** | 25° | 30° |
|---|-----|---|-----|-----|
| D（×斜面长 L） | 1.48 | **1.62** | 1.75 | 1.87 |

- 倾角 20° 时：**D = 1.62 × L**（L 为组件斜面长，按实际组件尺寸代入，W8 屋面布置用）；
- 说明：该式用于初估，屋面障碍物/复杂阴影需另做阴影分析（指导书 §9.1 原文）。

## 6. 输出汇总（供 W5 使用）

| 结果 | 数值 |
|---|---|
| 设计倾角 | **20°（正南）** |
| 最不利月倾斜面日辐照 | **4.46 kWh/m²·d（10 月）** |
| 倾斜面峰值日照时数 | **4.46 h/d（10 月）** |
| 排间节距 | **1.62 × L**（冬至 9:00 校核） |

## 7. 数据来源

1. NASA POWER 月度 API（总辐射 + 散射，2019–2023）：https://power.larc.nasa.gov/api/temporal/monthly/point?parameters=ALLSKY_SFC_SW_DWN,ALLSKY_SFC_SW_DIFF&community=RE&longitude=114.06&latitude=22.54&start=2019&end=2023&format=JSON
2. 换算模型：Liu-Jordan 各向同性模型（正南朝向，ρ=0.2），月代表日月中赤纬。
3. 复核工具（可选）：PVGIS https://re.jrc.ec.europa.eu/pvg_tools/en/（选 20° 倾角直接复核逐月倾斜面辐照）。
