sunny1043/offgrid-pv-course-design/docs/太阳能资源-深圳.md

# 太阳能资源与环境参数 — 深圳（W2）

> 依据：设计指导书 §3（太阳能资源和环境参数）。
> 状态：全队共享示例；本地草稿，未上传。

## 1. 数据来源声明（单一数据源原则，指导书 §3.1）

| 数据项 | 来源 | 说明 |
|---|---|---|
| 逐月水平面辐照量、月均温 | **NASA POWER**（MERRA2/SYN1DEG，API v2.9.8，LST） | 坐标 22.54°N、114.06°E（深圳），2019–2023 共 5 年平均 |
| 极端气温 | 深圳市气象局《深圳市气候概况》 | 历史极端最高 38.7 ℃、极端最低 0.2 ℃ |
| 年水平面总辐射参考 | 深圳市气象局太阳能资源评估 | 1245~1452 kWh/m²（本方案 NASA 均值约 1585，差异见 §6） |

> 查询日期：2026-09-01。按指导书 §3.1，不同来源数据不得在没有说明的情况下混合使用——本方案逐月计算统一用 NASA POWER，仅极端温度采用气象局公开资料（已声明）。

## 2. 逐月水平面辐照量与月均温（NASA POWER，5 年平均）

| 月份 | 1 | 2 | 3 | 4 | 5 | 6 | 7 | 8 | 9 | 10 | 11 | 12 |
|---|---|---|---|---|---|---|---|---|---|----|----|----|
| H（kWh/m²·d） | 3.33 | 3.62 | 3.84 | 4.41 | 4.62 | 4.98 | 5.64 | 5.02 | 5.09 | **4.29** | 3.94 | 3.32 |
| T（℃） | 17.0 | 18.4 | 21.5 | 23.6 | 26.7 | 28.6 | 29.5 | 29.2 | 28.7 | 25.7 | 22.6 | 17.3 |

- 水平面辐照最低月：12 月（3.32）≈ 1 月（3.33）；
- 月均温最低 1 月（17.0 ℃），最高 7 月（29.5 ℃）——与气象局"1 月最低 15.7 ℃、7 月最高 29.0 ℃"一致。

## 3. 最不利设计月（负荷随季节变化，指导书 §3.2 按月比较法）

深圳夏季长（5 月底~10 月开空调），**空调负荷随季节变化**，不能只看辐照最低月：

- 空调月（5–10 月）：E_AC = **6.99** kWh/d（含空调 3.38）
- 非空调月（11–4 月）：E_AC = 6.99 − 3.38 = **3.61** kWh/d

按 R = E_AC / H 逐月比较（R 最大月为容量设计重点月）：

| 月份 | 5 | 6 | 7 | 8 | 9 | **10** | 11 | 12 | 1 | 2 | 3 | 4 |
|---|---|---|---|---|---|---|----|----|---|---|---|---|
| E_AC | 6.99 | 6.99 | 6.99 | 6.99 | 6.99 | **6.99** | 3.61 | 3.61 | 3.61 | 3.61 | 3.61 | 3.61 |
| H | 4.62 | 4.98 | 5.64 | 5.02 | 5.09 | **4.29** | 3.94 | 3.32 | 3.33 | 3.62 | 3.84 | 4.41 |
| **R** | 1.51 | 1.40 | 1.24 | 1.39 | 1.37 | **1.63** | 0.92 | 1.09 | 1.08 | 1.00 | 0.94 | 0.82 |

> **结论：最不利设计月 = 10 月（R = 1.63 最大）**——10 月空调负荷仍在（6.99 kWh/d），而辐照已从夏季 5.0+ 降至 4.29 kWh/m²·d。
> 若忽略空调季节变化只看辐照，会误选 12 月——这正是指导书 §3.2 强调"避免只看年平均/最低辐照月"的情形。

## 4. 峰值日照时数（指导书 §3.1）

- 水平面：数值上 H（kWh/m²·d）= 峰值日照时数（h/d）→ **10 月 = 4.29 h/d**；
- 倾斜面（倾角 20°、正南，Liu-Jordan 换算，详见 `倾角核算-深圳.md`）：**10 月 = 4.46 h/d**（较水平面增益 4.0%；倾角 20° 经核算为最不利月与全年双最优）。

## 5. 温度参数（用于校核）

| 参数 | 取值 | 用途 | 来源 |
|---|---|---|---|
| 最低环境温度 | **0.2 ℃**（历史极端最低） | 光伏组串低温开路电压校核（W5） | 深圳气象局 |
| 最高环境温度 | **38.7 ℃**（历史极端最高） | 组件最高温度估算 | 深圳气象局 |
| 组件估算最高温度 | NOCT 公式：T_cell = T_amb + (NOCT−20)/800 × G | 高温 MPPT 电压校核（W5） | 指导书 §3.3 |

- NOCT 取 45 ℃（典型单晶组件），G = 1000 W/m²：
  - 按极端高温 38.7 ℃ → T_cell ≈ 38.7 + 31.3 ≈ **70 ℃**（极端工况）；
  - 按 7 月月均温 29.5 ℃ → T_cell ≈ 29.5 + 31.3 ≈ **61 ℃**（常态最热月）；
  - W5 校核时说明采用哪一档（建议用 61 ℃ 常规 + 70 ℃ 极端复核）。

## 6. 数据一致性说明

- NASA POWER 5 年平均水平面总辐射 ≈ 4.34 kWh/m²·d → 年 ≈ 1585 kWh/m²，高于深圳气象局评估的 1245~1452 kWh/m²（MERRA2 再分析对华南沿海偏高约 10~15%）。
- 处理：**逐月相对变化以 NASA POWER 为准（单一来源、口径一致）**；气象局年总量仅作参考，在报告中如实说明差异即可，不需要混用。
- 备选复核：PVGIS（https://re.jrc.ec.europa.eu/pvg_tools/en/）可选 20° 倾角直接给出倾斜面逐月数据，W5 前建议用其复核最不利月与倾斜面辐照。

## 7. 输出汇总（供 W4/W5 使用）

| 结果 | 数值 | 用途 |
|---|---|---|
| 最不利设计月 | **10 月** | 光伏阵列容量计算基准（W5） |
| 设计面峰值日照时数 | 水平 4.29 h/d；倾斜 20° = **4.46 h/d**（倾角核算已确认） | 阵列容量（W5） |
| 最低环境温度 | 0.2 ℃ | 低温开路电压校核（W5） |
| 最高环境温度 | 38.7 ℃ | 组件温度估算（W5） |
| 设计倾角 | **20°、朝向正南**（核算确认，见 `倾角核算-深圳.md`） | 阵列布置（W5/W8） |

## 8. 参考资料

1. NASA POWER 月度 API（22.54°N, 114.06°E, 2019–2023）：https://power.larc.nasa.gov/api/temporal/monthly/point?parameters=ALLSKY_SFC_SW_DWN,T2M&community=RE&longitude=114.06&latitude=22.54&start=2019&end=2023&format=JSON
2. 深圳市气象局《深圳市气候概况及四季特征》：https://weather.sz.gov.cn/qixiangfuwu/qihoufuwu/qihouguanceyupinggu/qihougaikuang/
3. 深圳市气象局太阳能资源评估（年总量 1245~1452 kWh/m²）：https://www.sz.gov.cn/cn/xxgk/zfxxgj/bmdt/content/post_11380634.html
4. PVGIS 复核工具：https://re.jrc.ec.europa.eu/pvg_tools/en/
