sunny1043/offgrid-pv-course-design/docs/负荷调查-深圳.md

# 负荷调查 — 深圳（全队共享示例 · 具体产品型号版）

> 依据：课程设计任务书 §3.1「标准化家庭负载估算与日均能耗计算工作表」确定设备清单；设计指导书 §2 确定计算口径；**每台设备落实到具体品牌型号与官方/可检索参数**（来源见 §7）。
> 空调日耗电采用**额定功率 × 日运行时间 × 运行系数**（指导书 §2.2 标准方法：E = P × t × k）。
> 状态：全队共用一份示例方案，不按学号分档；**所有类别均在指导书表 1 建议范围内**；本地草稿，未上传。

## 0. 基本条件与假设（待确认）

| 项目 | 取值 | 说明 |
|---|---|---|
| 设计城市 | 深圳 | 亚热带海洋性气候，夏季长（空调期约 5 月底~10 月） |
| 家庭结构 | 3 口之家（假定） | 待确认 |
| 住宅 | 普通住宅 90~110 m²（假定） | 屋面条件后续章节确认 |
| 电压等级 | 交流 220 V / 50 Hz；直流 48 V 级 | 任务书统一条件 |
| 能量口径 | 交流侧日用电量 E_AC | 蓄电池公式直接使用 E_AC，不重复除以逆变器效率（指导书 §2.2） |
| 空调运行 | 夏季 8 h/d（12:00–14:00 午间 + 18:00–24:00 晚间） | 深圳 5–10 月空调期 |

## 1. 家庭关键负荷清单（具体产品型号）

| 类别 | 设备（具体型号） | 数量 | 关键参数 | 日运行(h) | 运行系数 | 日耗电(kWh/d) | 计算口径 |
|---|---|---|---|---|---|---|---|
| 制冷空调 | 海尔 BCD-235WFCI 三门风冷变频冰箱（235 L，一级能效） | 1 | 综合耗电量 **0.54 kWh/24h**（官方） | — | — | **0.54** | 能效标识日耗电量（官方） |
| 制冷空调 | 美的 KFR-35GW/N8KS1-1 酷省电二代（1.5 P 新一级能效，APF 5.30） | 1 | 额定制冷输入功率 **845 W**（70~1900 W，ZOL） | 8.0 | 0.5（变频运行均值） | **3.38** | 0.845 × 8 × 0.5 |
| 照明 | 飞利浦 LED 球泡 12 W（E27，~1300 lm） | 8 | 12 W | 4 | 1.0 | **0.38** | 0.012×8×4 |
| 通信信息 | 小米路由器 AX3000 | 1 | 待机约 5 W、满速约 6 W（实测） | 24 | 1.0 | **0.14** | 0.006×24 |
| 通信信息 | Redmi 智能电视 A55 节能版（55 英寸 LED） | 1 | 整机功耗约 **110 W** | 4 | 1.0 | **0.44** | 0.11×4 |
| 通信信息 | 笔记本电脑（联想小新 Pro 14，假定，可替换） | 1 | 65 W PD 适配器 | 5 | 1.0 | **0.33** | 0.065×5 |
| 通信信息 | 手机快充充电器（小米 67 W，假定，可替换） | 2 | 平均充电功率约 10 W | 3 | 1.0 | **0.06** | 0.01×2×3 |
| 基本炊事 | 美的 FB40Simple111 电饭煲（4 L） | 1 | 额定约 **860 W** | 0.6 | 1.0 | **0.52** | 0.86×0.6 |
| 基本炊事 | 美的 WHJ1705b 电热水壶（1.7 L） | 1 | 额定 **1800 W** | 0.15 | 1.0 | **0.27** | 1.8×0.15 |
| 基本炊事 | 方太 CXW-258-JCD7 侧吸式油烟机 | 1 | 额定输入功率 **258 W**（官方） | 0.5 | 1.0 | **0.13** | 0.258×0.5 |
| 基本炊事 | 格兰仕 P70D20TL-D4 微波炉（20 L） | 1 | 输出 700 W，输入约 **1150 W** | 0.1 | 1.0 | **0.12** | 1.15×0.1 |
| 基本炊事 | 美的 C21-RT2170 电磁炉（周末使用） | 1 | 额定功率 **2100 W**（官方） | 0.06（日均） | 1.0 | **0.12** | 2.1×(0.4/7) |
| 生活辅助 | 海尔 EG100MATE2S 滚筒洗衣机（10 kg 变频，一级能效） | 1 | 整程序平均约 500 W | 0.75 | 1.0 | **0.38** | 0.5×0.75 |
| 生活辅助 | 待机负荷（空调/电视/微波炉/电磁炉/洗衣机合计） | — | 约 8 W | 24 | 1.0 | **0.19** | 0.008×24 |

> 电磁炉说明：周末使用（每周约 2 次、每次 0.2 h），按日均 0.4/7 ≈ 0.06 h 计入日耗电；工作日 24 h 表不含电磁炉，**周末炊事高峰用于最大同时功率校核**（§4）。
> 空调说明：日耗电 = 额定制冷输入功率 845 W × 8 h × 运行系数 0.5 = 3.38 kWh/d。变频空调实际功率在 70~1900 W 间动态变化，运行系数 0.5 表示运行期间平均功率约为额定的 50%（指导书 §2.2 标准算法）；深圳夏季 8 h/d（12:00–14:00 午间 + 18:00–24:00 晚间）。

**交流侧日用电量合计：E_AC = 6.99 ≈ 7.0 kWh/d**（处于任务书 6.5~8.5 kWh/d 设计范围内 ✅）

## 2. 分类小计与建议范围对照（指导书 §2.1 表 1）— 全部达标

| 类别 | 本方案(kWh/d) | 建议范围(kWh/d) | 结论 |
|---|---|---|---|
| 制冷和空调 | 3.92 | 3.3 ~ 5.0 | ✅ |
| 照明 | 0.38 | 0.3 ~ 0.6 | ✅ |
| 通信和信息设备 | 0.97 | 0.8 ~ 1.4 | ✅ |
| 基本炊事 | 1.15 | 0.7 ~ 1.2 | ✅ |
| 生活辅助 | 0.57 | 0.5 ~ 1.0 | ✅ |
| **合计** | **6.99** | 6.5 ~ 8.5 | ✅ |

## 3. 24 h 负荷运行表（工作日，1 h 时段）

| 时段 | 运行设备 | 同时功率(kW) |
|---|---|---|
| 00:00–06:00 | 基础（冰箱+路由+待机+手机充电） | 0.06 |
| 06:00–07:00 | 基础 | 0.04 |
| 07:00–08:00 | 基础 + 电饭煲(早餐) + 水壶(短时) | 0.92 |
| 08:00–12:00 | 基础 | 0.04 |
| 12:00–13:00 | 基础 + 空调 + 微波炉(短时) | 0.58 |
| 13:00–14:00 | 基础 + 空调 | 0.46 |
| 14:00–15:00 | 基础 | 0.04 |
| 15:00–16:00 | 基础 + 洗衣机（洗涤/甩干） | 0.41 |
| 16:00–18:00 | 基础 | 0.04 |
| 18:00–19:00 | 基础 + 空调 + 照明 + 电饭煲 + 油烟机 + 电视 | 1.78 |
| 19:00–19:15 | 基础 + 空调 + 照明 + **电热水壶** + 电视（与晚餐错峰） | **2.47** |
| 19:15–20:00 | 空调 + 照明 + 电视 | 0.67 |
| 20:00–22:30 | 空调 + 照明 + 电视 + 笔记本 | 0.73 |
| 22:30–24:00 | 空调 + 照明 + 路由 | 0.56 |

> 表中空调按运行平均功率 0.42 kW（845 W × 0.5）计入。

## 4. 最大同时功率（含周末校核，指导书 §2.3）

- **工作日**峰值：19:00–19:15 烧水时段 ≈ **2.5 kW**；
- **周末校核**（电磁炉 2.1 kW + 油烟机 + 空调 + 照明 + 电视）：2.1+0.26+0.42+0.10+0.11 ≈ **3.0 kW**；
- 结论：**P_max ≈ 3.0 kW**（用于逆变器额定功率选型，指导书 §7.2 另加裕量）。

## 5. 短时冲击功率

| 启动设备 | 启动倍数 | 短时功率(kW) | 说明 |
|---|---|---|---|
| 冰箱压缩机 | 约 5 倍（~120 W 额定） | 0.60 | 间歇启动 |
| 空调（变频） | 低倍数 | — | 变频软启动，不套定频 5~7 倍（指导书 §2.4） |
| 洗衣机甩干 | 短时峰值 | 1.00 | 15:00 时段，不与炊事高峰重叠 |
| 电磁炉/水壶 | 阻性无冲击 | — | 电阻负载无启动冲击 |

- 最不利组合：周末炊事高峰 + 冰箱压缩机启动：P_short ≈ 3.0 + 0.6 ≈ **3.6 kW**
- 结论：**系统短时冲击功率 ≈ 3.6 kW**（用于逆变器短时功率校核，指导书 §7.2）

## 6. 输出汇总（供后续章节使用）

| 结果 | 数值 | 用途（指导书 §2 末） |
|---|---|---|
| 交流侧日用电量 E_AC | **6.99 ≈ 7.0 kWh/d** | 蓄电池容量、光伏阵列容量 |
| 最大同时功率 P_max | **3.0 kW** | 逆变器额定功率 |
| 短时冲击功率 P_short | **3.6 kW** | 逆变器短时功率校核 |
| 24 h 运行表 | 见 §3 | 峰值时段、错峰安排 |

## 7. 产品规格来源（查询日期 2026-09-01）

| # | 设备 | 来源 |
|---|---|---|
| 1 | 海尔 BCD-235WFCI 冰箱（0.54 kWh/24h、一级能效） | [海尔官网产品页](https://www.haier.com/cooling/20201112_150262.shtml) |
| 2 | 美的 KFR-35GW/N8KS1-1 酷省电二代空调 | 额定制冷输入功率 845W（70-1900W）见 [ZOL 中关村在线参数页](https://detail.zol.com.cn/1632/1631464/param.shtml)；APF 5.30（能效标识） |
| 3 | 飞利浦 LED 球泡 12 W | [飞利浦照明官网](https://www.lighting.philips.com.cn/consumer/p/led-bulb-90w-a60m-e27/6922341928758) |
| 4 | 小米路由器 AX3000（5~6 W） | [知乎实测](https://www.zhihu.com/question/478767269/answer/3294890012)；[小米官网型号页](https://www.mi.com/tw/product/xiaomi-router-ax3000t/) |
| 5 | Redmi 智能电视 A55 节能版 | [小米官网型号页](https://www.mi.com/redmi-tvs/a-55-es)；功耗典型值见[淘江湖](https://jianghu.taobao.com/detail/47750_61032514) |
| 6 | 美的 FB40Simple111 电饭煲（4 L） | [苏宁商品页](https://rec.suning.com/show/find/0071556597/000000010581298069.html)；3 L 额定 860 W 见[知乎](https://zhuanlan.zhihu.com/p/275689563) |
| 7 | 美的 WHJ1705b 电热水壶（1.7 L，1800 W） | [淘宝商品信息](https://guangtao.taobao.com/product-f53c9d670389ae34c85fd7bda45921e2.html) |
| 8 | 方太 CXW-258-JCD7 油烟机（258 W） | [新浪参数拆解](https://cj.sina.cn/articles/view/7879996010/1d5af326a06801vcn2) |
| 9 | 格兰仕 P70D20TL-D4 微波炉（输出 700 W） | [百度百科](https://baike.baidu.com/item/%E6%A0%BC%E5%85%B0%E4%BB%95P70D20TL-D4/10901709) |
| 10 | 美的 C21-RT2170 电磁炉（2100 W） | [苏宁商品页](https://product.suning.com/0070154004/000000000621149798.html) |
| 11 | 海尔 EG100MATE2S 滚筒洗衣机（10 kg 变频） | [海尔官网产品页](https://www.haier.com/laundry/20210623_162186.shtml)；洗涤/甩干功率见[知乎](https://www.zhihu.com/question/533787808) |

## 8. 待确认事项

1. 家庭结构（3 口之家假设是否成立）；
2. 住宅面积与屋面形式（影响后续阵列布置）；
3. 笔记本/充电器型号为假定，可按实际替换；
4. 空调 8 h/d 为深圳夏季空调期设定（12:00–14:00 + 18:00–24:00），非空调期负荷按 §0 口径下降（太阳能资源章节最不利月分析已考虑）；
5. 空调运行系数 0.5 为变频运行均值假设（实际功率 70~1900 W 动态变化），答辩时可说明该假设依据。
