sunny1043/offgrid-pv-course-design/docs/updates/2026-09-10/兰州光伏图纸-R0/图纸说明.txt

兰州户用离网光伏图纸 R0

E-01：系统电气原理与接线图，示意。
M-01：屋顶方阵及支架布置图，A3按1:50。
M-02：设备间平面及安装接线图，A3按1:20。

PDF可直接查看。DXF为R2013格式，单位mm，含可编辑线条、图层与文字。
M-01屋顶边长在模型中为9000 mm；M-02房间边长为3000 mm。
整张图框置于模型空间；打印到A3时分别用1:50和1:20。
尺寸标注由可编辑线条及文字组成，尚未建立关联尺寸；修改几何后同步改标注。
中文文字使用Arial Unicode.ttf；在其他CAD若缺字，请将CN样式替换为当地可用中文字体。
PDF与DXF共用同一几何源；PDF有浅色区域填充，DXF以分层线框表达。

关键限制：屋顶、设备间及女儿墙均为教学假设。五串标准工作电压约210 V，
所选手册满载MPPT电压300—425 V，功率能力与恢复计算需再核验，配置可能调整。
保护额定值为初选，未完成电缆载流量、短路分断、RCD及N—PE控制联调。
M-01不包含经审查的锚栓/配重/防水施工节点；M-02温控和风机尚待落实。
本次是方案讨论初稿，不能作为施工定稿。
