sunny1043/offgrid-pv-course-design/docs/diagram/系统组成图@2x.png

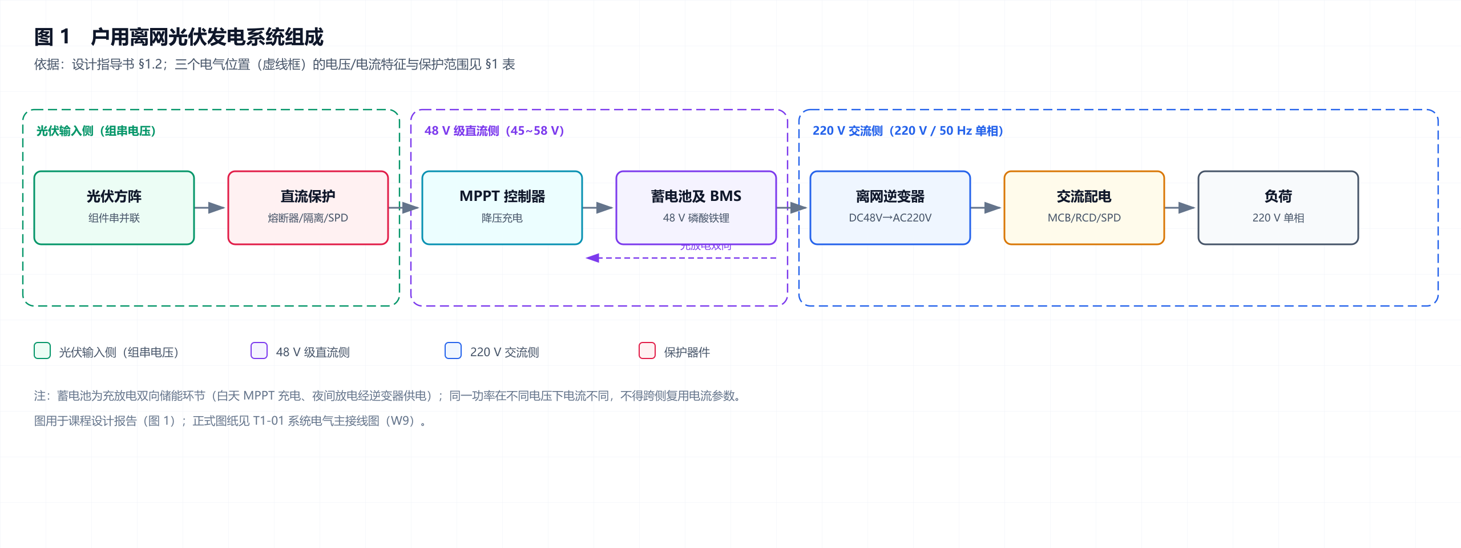
docs/diagram/系统组成图@2x.png
