sunny1043/offgrid-pv-course-design/docs/diagram/能量流向图@2x.png

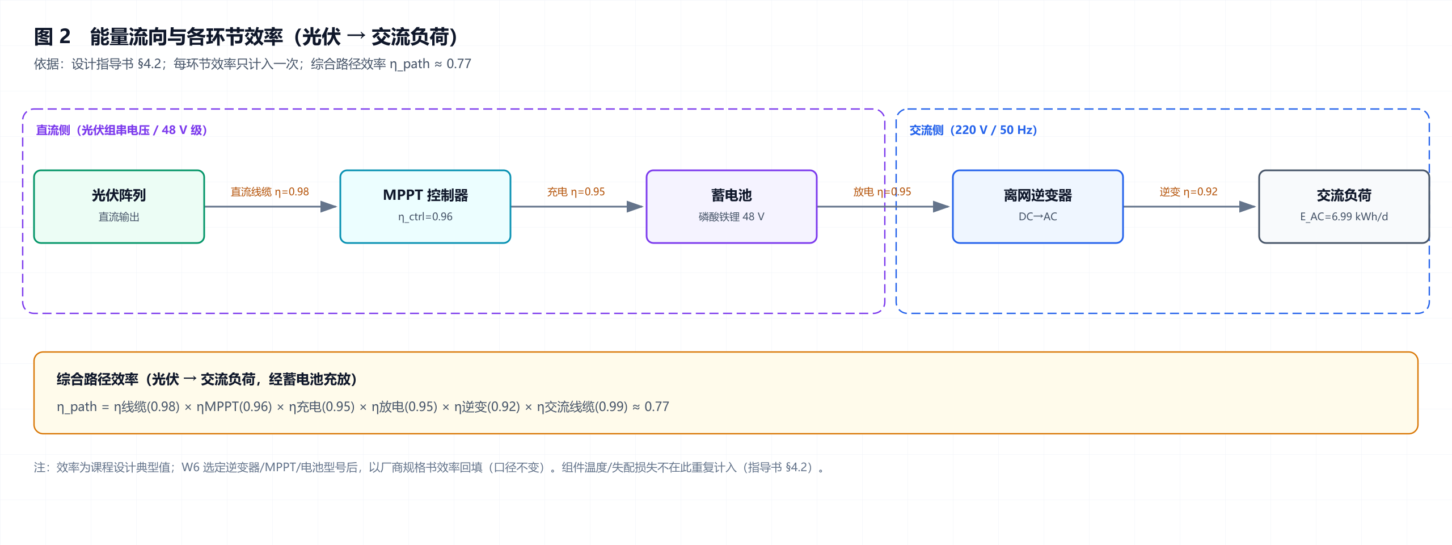
docs/diagram/能量流向图@2x.png
