sunny1043/offgrid-pv-course-design/docs/drawings/T1-01-系统电气主接线图-兰州.png

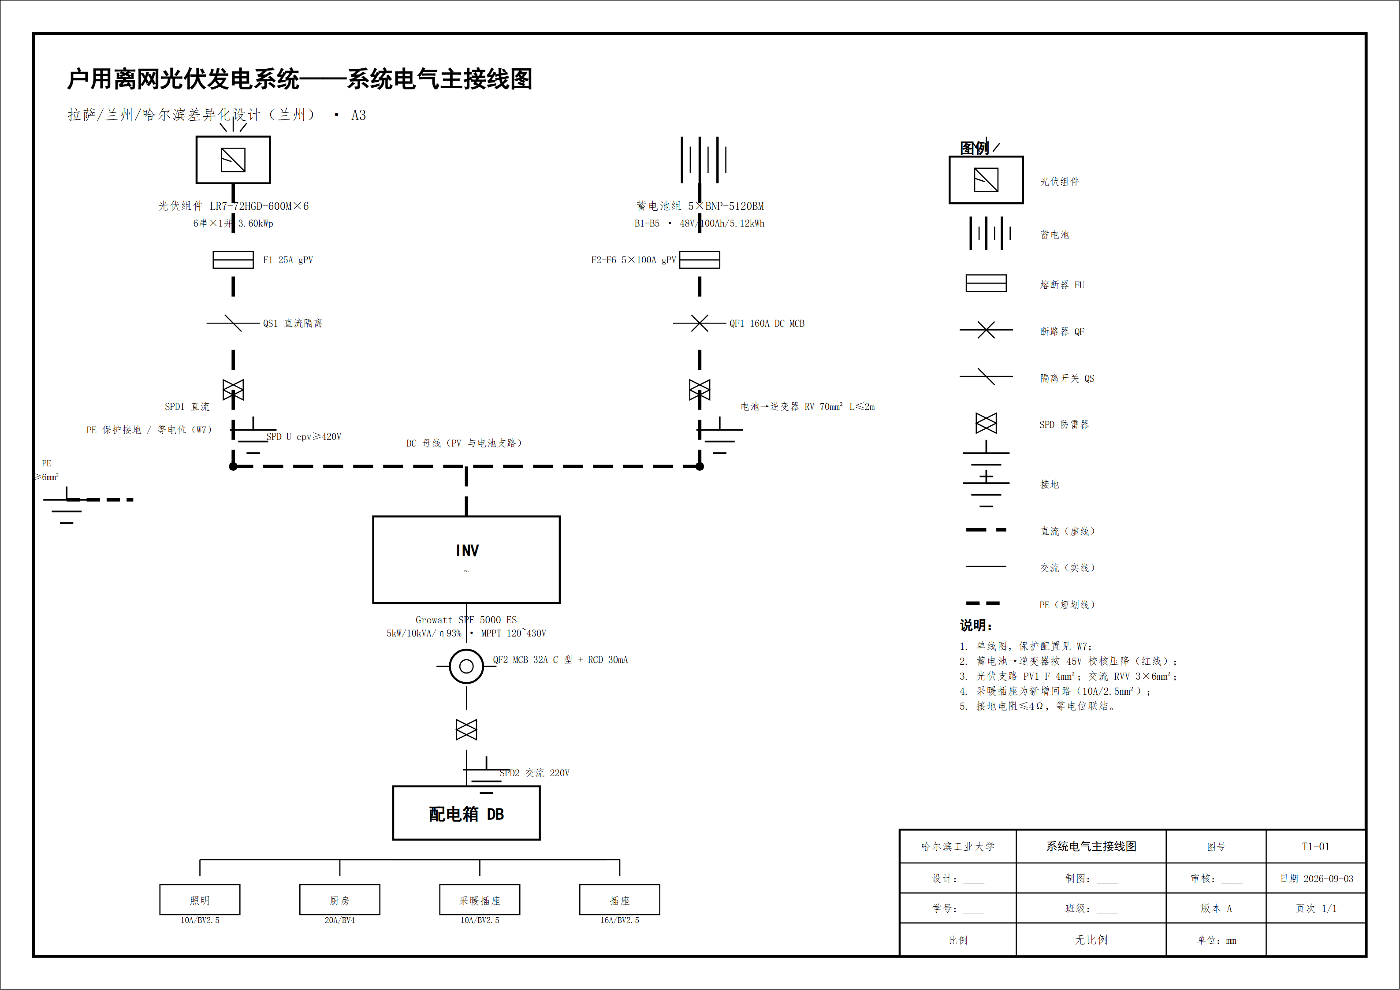
docs/drawings/T1-01-系统电气主接线图-兰州.png
