sunny1043/offgrid-pv-course-design/docs/drawings/T1-02-光伏阵列及支架布置图-哈尔滨.png

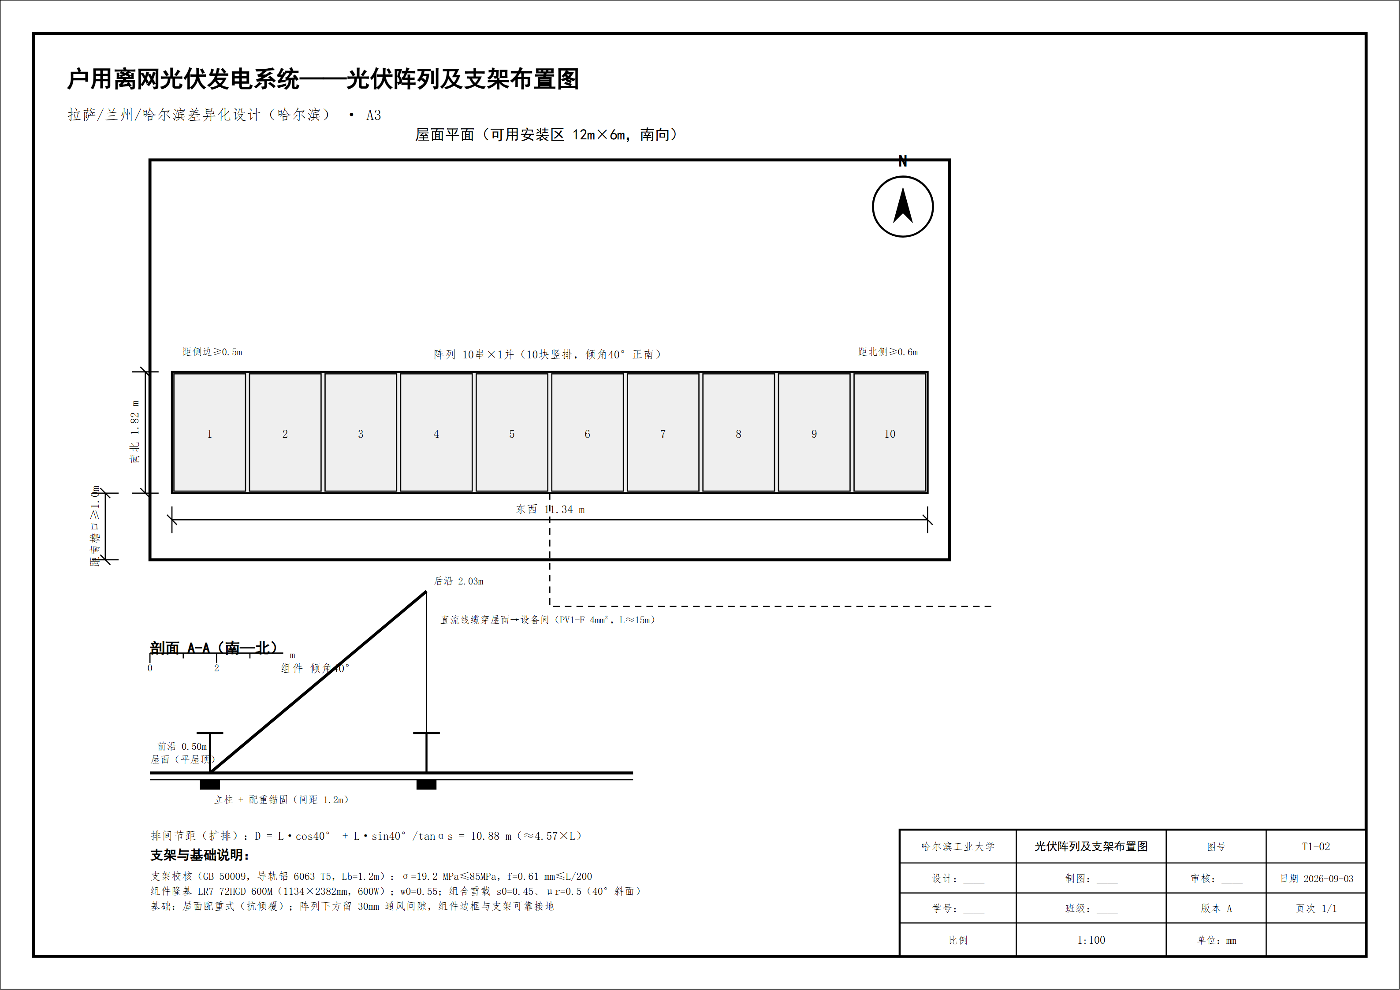
docs/drawings/T1-02-光伏阵列及支架布置图-哈尔滨.png
