sunny1043/offgrid-pv-course-design/docs/drawings/T1-03-设备间平面及安装接线图.png

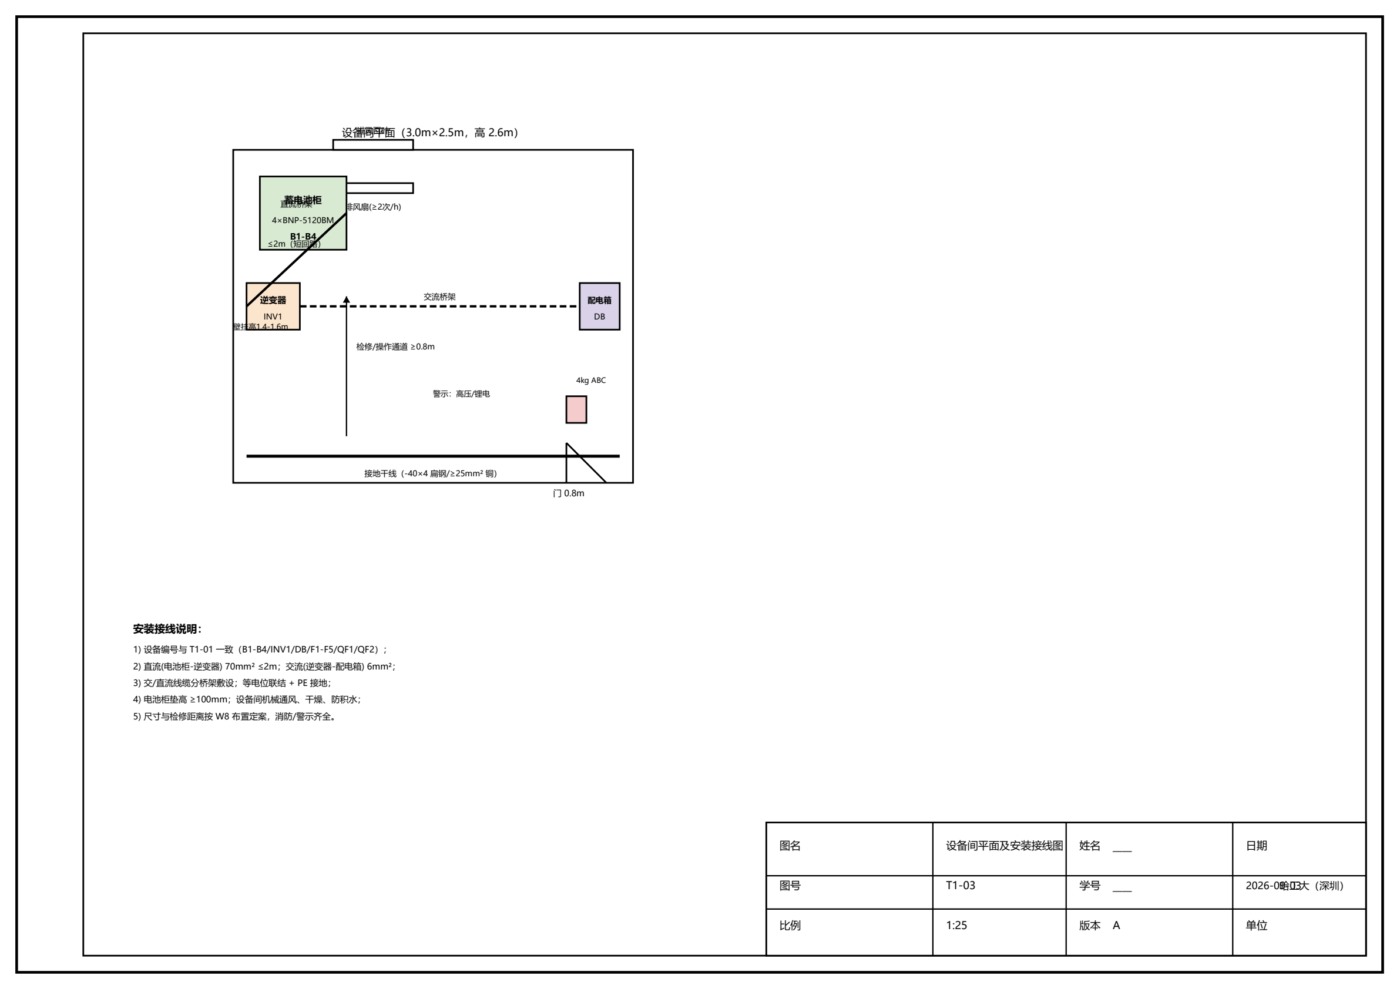
docs/drawings/T1-03-设备间平面及安装接线图.png
