sunny1043/offgrid-pv-course-design/docs/设备清单与成本分析-深圳.md

# 设备清单与成本分析 — 深圳（W11）

> 依据：设计指导书 §12（设备清单、成本和方案调整）、课程设计任务书 §4.8（总成本、至少两种蓄电池配置比较）。
> 状态：本地草稿；价格为**市场参考价**（电商/B2B，查询日期 2026-09-03，单一时间基准），最终以实际采购价为准。
> 配套 Excel：`docs/计算-设备清单-深圳.xlsx`（公式可检查）。

## 1. 设备清单（指导书 §12.1 表 9 分类）

| 类别 | 设备/材料 | 规格型号 | 数量 | 单价(¥) | 小计(¥) | 价格参考 |
|---|---|---|---|---|---|---|
| **光伏阵列** | 光伏组件 | 隆基 Hi-MO 7 LR7-72HGD-600M（600 W N 型） | 4 | 650 | 2,600 | 2026 组件低价期零售参考（隆基官网型号） |
| | MC4 连接器 | 光伏专用（含防护） | 8 对 | 16 | 128 | 电商 |
| **支架** | 屋面铝合金支架系统 | **APAS P8-2080 6063-T5 导轨 ×8（20×80 mm，约 10 m，1.91 kg/m ≈19 kg）** + 压块/立柱/锚固/防水垫（2.40 kWp） | 1 套 | 1,300 | 1,300 | 导轨按铝价≈¥23,780/t（2026-06 长江现货）≈¥450 + 辅件/加工/安装估 ¥850 |
| **控制和变换** | 离网逆变器（含 MPPT） | Growatt SPF 5000 ES | 1 | 2,200 | 2,200 | 淘宝实价约 ¥2,150 |
| **蓄电池** | 磷酸铁锂模块 | Benhoo BNP-5120BM（51.2 V/100 Ah/5.12 kWh，内置 BMS） | 4 | 4,000 | 16,000 | B2B 同类报价 ¥3,500~5,000/台 |
| | 电池柜 | 19" 机柜 600×600×1200 mm | 1 | 1,000 | 1,000 | 电商 |
| | 母排/连接件 | 等长等截面铜排+线缆 | 1 套 | 300 | 300 | 估 |
| **直流保护** | 组串熔断器 | 25 A gPV | 1 | 40 | 40 | 电商 |
| | 直流隔离开关 | 2P 600 Vdc | 1 | 180 | 180 | 电商 |
| | 直流 SPD | Type II 1000 Vdc（U_cpv≥265 V） | 1 | 220 | 220 | 电商 |
| | 电池支路熔断器 | 100 A gPV | 4 | 35 | 140 | 电商 |
| | 电池总保护 | 160 A DC MCB（2P） | 1 | 450 | 450 | 电商 |
| | MPPT→电池保护 | 50 A MCB | 1 | 150 | 150 | 电商 |
| **交流配电** | 交流配电箱 DB | 含汇排/端子 | 1 | 320 | 320 | 电商 |
| | 输出 MCB | 32 A C 曲线 | 1 | 60 | 60 | 电商 |
| | 剩余电流保护 | RCD 30 mA | 1 | 120 | 120 | 电商 |
| | 交流 SPD | Type II 220 V（Imax 40 kA） | 1 | 200 | 200 | 电商 |
| | 末端 MCB | 10/20/20/16 A | 4 | 25 | 100 | 电商 |
| **线缆和接地** | PV1-F 光伏线 | 4 mm²（组串+阵列至 MPPT ~20 m） | 20 m | 5 | 100 | 电商（¥4~6/m） |
| | RV 软线 | 10 mm²（MPPT→电池 3 m） | 3 m | 14 | 42 | 电商 |
| | RV 软线 | **70 mm²**（电池→逆变器 2 m） | 2 m | 65 | 130 | 电商 |
| | RVV 软线 | 6 mm²（逆变→配电箱 5 m） | 5 m | 10 | 50 | 电商 |
| | BV 线 | 2.5 mm²（照明/插座 ~40 m） | 40 m | 3.5 | 140 | 电商 |
| | BV 线 | 4 mm²（厨房/空调 ~30 m） | 30 m | 5.5 | 165 | 电商 |
| | 接地线 | ≥6 mm²（PE/等电位 ~10 m） | 10 m | 6 | 60 | 电商 |
| | 桥架/穿线管 | 屋面→设备间 + 室内 | 1 套 | 350 | 350 | 电商 |
| **安装辅材** | 端子/标识/防水防火 | 汇总 | 1 套 | 400 | 400 | 估 |
| | **合计** | | | | **26,945** | |

> 价格基准：均为 2026-09-03 查询的市场参考价（人民币）；组件价处于 2026 低价期（N 型 TOPCon 0.5~1.0 元/W），逆变器为淘宝实价锚点，电池取 B2B 报价区间中值，支架按铝价估算——**报告须注明查询日期与"实际以采购价为准"**（任务书：价格有来源即可，不要求精确成交价）。

## 2. 蓄电池两种配置比较（任务书 §4.8 要求）

| 配置 | 模块 | 能量 | 电池成本 | 支路保护 | 说明 |
|---|---|---|---|---|---|
| **方案 A（采用）** | 4×BNP-5120BM（100 Ah） | 20.48 kWh | **¥16,000** | 4 支路 | 官方渠道/质保好；W5~W9 全部校核与图纸均按此配置 |
| 方案 B（备选） | 2×51.2 V/200 Ah | 20.48 kWh | ≈¥13,000 | 2 支路 | madeinchina 报价 $900/台≈¥6,500，电池省 ≈¥3,000，支路保护/母排更少 |

> **结论**：方案 B 初始成本低约 ¥3,000~4,000，但方案 A 为官方渠道产品、参数齐备且**已用于 W4~W9 全部校核与图纸（数据一致性红线）**，本设计维持方案 A；报告中说明 B 为降本备选，若改选 B 需同步更新电流校核与图纸。

## 3. 成本分析（指导书 §12.1）

| 指标 | 数值 |
|---|---|
| 系统初始总投资 | **≈ ¥26,945** |
| 单位装机成本 | ≈ ¥26,945 / 2.40 kWp = **¥11.2/Wp** |
| 单位储能成本 | ¥16,000 / 20.48 kWh ≈ **¥781/kWh**（仅电池） |
| 成本结构 | 蓄电池 64%（含柜体）＞ 光伏阵列 10% ＞ 控制变换 8% ＞ 其余 18% |

> 电池占系统成本约 2/3 是离网系统的典型特征（能量密度与寿命决定），也解释了为何 3 d 敏感性方案成本显著上升。

## 4. 成本过高检查（指导书 §12.2 顺序）

1. 负荷在 6.5~8.5 范围内且空调时长合理 ✅（E_AC=6.99，空调 8 h/d）；
2. 未把 3 d 作为基准容量 ✅（3 d 仅敏感性）；未重复计算损失 ✅；
3. 电池模块粒度与支路数已比较（A/B 方案）✅；
4. 未以取消保护/扩大 DOD/超电流限值降本 ✅；
5. 如需进一步降本优先级：电池 B 方案（-¥3,000~4,000）→ 组件等低价期采购 → 支架自装。

## 5. 与验收要求的对应

- 三文件一致性（报告/图纸/BOM）：本清单型号与 W4（BNP-5120BM×4）、W5（LR7-72HGD-600M×4）、W6（SPF 5000 ES）、W7（保护器件规格）、W8（支架）一致 ✅；
- 价格基准一致 + 记录查询日期 ✅（2026-09-03）。

## 6. 待确认

1. 各项单价为市场参考价，W12 报告终稿前可更新为实际询价（保持同一天查询）；
2. 支架/电池柜/辅材为估算，若询得实价直接替换；
3. 方案 B 的 $900/台为 madeinchina 报价（W4 已注），汇率按 ≈7.2 计。
