sunny1043/offgrid-pv-course-design/docs/任务内容与认领清单.md

# 课程设计任务内容与认领清单

> 户用离网光伏发电系统 · 2026 专业课程创新研修课程设计（多人协作）
> 本文档依据四份原始资料整理：任务书 / 设计指导书 / 进度检查与考核标准 / 实验测试。
> 状态：本地草稿，未上传仓库。

---

## 一、总体任务

为一个中国城市普通住宅设计**完全离网**的户用光伏发电系统（单相 220V/50Hz、48V 级磷酸铁锂蓄电池、2 d 自主供电、3 d 敏感性分析、按最不利设计月定光伏容量），交付 7 项成果：

1. 课程设计报告（Word + PDF）
2. 工程图纸 3 张 A3（T1-01 主接线图 / T1-02 阵列及支架布置图 / T1-03 设备间平面及安装接线图，源文件 + PDF）
3. 计算文件（Excel，公式可检查）
4. 实验资料（原始记录、照片、数据文件）
5. 产品与价格资料（规格书/网页/报价日期）
6. 最终提交文件夹（按学号、姓名、任务、城市命名）

## 二、工作分解 WBS（设计主线 12 个工作包）

| # | 工作包 | 指导书章节 | 输出 | 检查点 | 考核分值 |
|---|---|---|---|---|---|
| W1 | 负荷调查 + 24h 运行表 | §2 | 负荷清单、日用电量、最大同时功率、短时冲击功率 | ② | 5 |
| W2 | 太阳能资源 + 温度数据 | §3 | 逐月辐照、最不利设计月、峰值日照时数、高低温 | ② | (并入 W1) |
| W3 | 系统组成与能量损失 | §1、§4 | 系统框图、能量流向、综合效率口径 | ③ | — |
| W4 | 蓄电池设计 | §5 | 标称能量、模块选型、串并联、充放电电流、BMS 校核、2d/3d 对比 | ③④ | 8 |
| W5 | 光伏阵列设计 | §6 | 阵列容量、组件选型、高低温电压校核、串并联、装机容量 | ⑤ | 8 |
| W6 | MPPT 控制器 + 离网逆变器 | §7 | 两侧电压电流校核、连续/短时功率、最低电压直流电流 | ⑤⑥ | 7 |
| W7 | 线缆 + 保护 + 防雷接地 | §8 | 6 回路载流量+电压降、保护器件选型 | ⑥ | (并入 W6) |
| W8 | 支架 + 屋面 + 设备间布置 | §9 | 排间节距、支架初核、设备间平面 | ⑦ | 3 |
| W9 | 三张 A3 图纸 | §10 | T1-01/02/03 源文件 + PDF | ⑦⑧⑨ | 25 |
| W10 | 实验 + 数据处理 | §11 + 实验测试 | 原始记录、效率/串并联/倾角分析 | D9 | 15 |
| W11 | 设备清单 + 成本分析 | §12 | BOM、两种电池方案比较、总成本 | ⑧ | 4 |
| W12 | 设计报告 + 数据一致性复核 | §13 | 14 章报告、三文件核对（表10）、答辩 | ⑧⑨ | 15 |

## 三、三周时间线（任务书 §八 + 考核标准 9 检查点）

| 周 | 日 | 工作 | 阶段成果 | 检查点 |
|----|----|---|---|---|
| W1 | D1 | 定城市、负荷区间、资料计划 | 任务理解记录 | ① |
| | D2 | 负荷调查 + 24h 运行表 | 日用电量、最大同时功率 | — |
| | D3 | 太阳能资源 + 温度数据 | 逐月数据、最不利设计月 | ② |
| | D4 | 系统组成、主要参数 | 系统组成说明 | — |
| | D5 | 蓄电池容量初算 | 容量、模块候选、组合方式 | ③ |
| W2 | D6 | 蓄电池电流 + BMS 校核 | 蓄电池最终方案 | ④ |
| | D7 | 光伏容量 + 组件初选 | 阵列容量、组件参数 | — |
| | D8 | 组串 + 控制器校核 | 串并联数量、控制器方案 | ⑤ |
| | D9 | 实验 + 数据处理 | 原始记录、计算结果 | 按分组 |
| | D10 | 逆变器 + 线缆 + 保护 | 设备选型、回路计算 | ⑥ |
| W3 | D11 | T1-02 光伏阵列及支架布置图 | 初稿 | ⑦ |
| | D12 | T1-01 主接线图 + T1-03 设备间图 | 初稿 | — |
| | D13 | 成本分析 + 报告初稿 | 报告、BOM、三图初稿 | ⑧ |
| | D14 | 统一数据、修改问题 | 完整送审稿 | — |
| | D15 | 提交成果 + 答辩 | 最终文件、答辩记录 | ⑨ |

## 四、认领清单

### A. 文档任务（仓库现有，各 1 人负责推进）
| 任务 | 负责人 | 状态 |
|---|---|---|
| 任务1 课程设计任务书 | 待认领 | 🔲 |
| 任务1 设计说明书 | 待认领 | 🔲 |
| 任务1 进度检查与考核标准 | 待认领 | 🔲 |
| 实验测试方案 | 待认领 | 🔲 |

### B. 设计主线（每人独立完成自己的城市，建个人任务行）
`姓名-负荷资源`、`姓名-蓄电池`、`姓名-光伏阵列`、`姓名-设备选型`、`姓名-图纸`、`姓名-实验`、`姓名-成本报告`

### C. 团队共享工作（1 人 1~2 项）
| 共享工作 | 依据 | 产出 |
|---|---|---|
| 负荷计算表模板 | 指导书 §2 + 任务书 §3.1 示例表 | Excel 模板（24h 表 + 公式） |
| 资源数据汇总 | 指导书 §3.1（NASA POWER/PVGIS） | 多城市逐月辐照/温度汇总 |
| 蓄电池/光伏计算模板 | §5、§6 公式 | Excel 校核表 |
| 图纸模板 | §10 通用要求 | 三张图可编辑模板 |
| 报告模板 | §13.1 报告结构 | Word 骨架 |
| 交叉互审 | 考核标准 §八 + §13.2 表10 | 互审记录 |

## 五、验收与质量门禁

- **100 分构成**：过程与出勤 10 / 技术设计 35 / 工程图纸 25 / 实验 15 / 报告与答辩 15；
- **9 项最终自查**（考核标准 §八 表6）：负荷区间、来源、蓄电池复核、高低温电压、MPPT 两侧、设备参数、三图+源文件、三文件一致、实验齐全；
- **8 条严重问题红线**（§五）：缺图缺报告 / 负荷出区间 / 完整 51.2V 模块违规串联 / 光伏电流当充电电流 / 电池电压×光伏电流算功率 / 低温 Voc 超控制器耐压 / 图纸缺保护线缆参数 / 抄袭；
- **答辩 12 问**（§七）：全部能用个人数据解释。

## 六、参考资料

GB 50797-2012、GB 50217-2018、GB 50057-2010、GB/T 32512-2016、GB/T 16895.32-2021、GB/T 36276-2023、GB/T 34131-2023、IEC 62548-1:2023+A1:2025、NASA POWER / PVGIS。
