sunny1043/offgrid-pv-course-design/差异化城市设计/计算-设备清单-哈尔滨.xlsx

Sheet: 设备清单
类别 | 设备/材料 | 规格型号 | 数量 | 单价(¥) | 小计(¥) | 价格参考
光伏阵列 | 光伏组件 | 隆基 Hi-MO 7 LR7-72HGD-600M（600 W） | 10 | 650 |  | 2026 组件低价期零售
光伏阵列 | MC4 连接器 | 光伏专用 | 20 | 16 |  | 电商
支架 | 屋面铝合金支架 | 6063-T5（10 块竖排 40°，含雪荷加强） | 1 | 3000 |  | 按铝价估
控制和变换 | 离网逆变器（含 MPPT） | Growatt SPF 5000 ES | 2 | 2200 |  | 淘宝
控制和变换 | 并联套件 | Growatt 并联通信 | 1 | 200 |  | 电商
蓄电池 | 磷酸铁锂模块 | Benhoo BNP-5120BM（5.12 kWh，内置 BMS） | 5 | 4000 |  | B2B 区间
蓄电池 | 电池柜 | 19" 机柜 600×600×1200 mm | 1 | 1000 |  | 电商
蓄电池 | 母排/连接件 | 等长等截面铜排（低温材料） | 1 | 450 |  | 估
直流保护 | 组串熔断器 | 25 A gPV | 2 | 40 |  | 电商
直流保护 | 直流隔离开关 | 2P 600 Vdc | 2 | 180 |  | 电商
直流保护 | 直流 SPD | Type II 1000 Vdc（U_cpv≥360 V） | 2 | 220 |  | 电商
直流保护 | 电池支路熔断器 | 100 A gPV | 5 | 35 |  | 电商
直流保护 | 电池总保护 | 160 A DC MCB（2P） | 2 | 450 |  | 电商
直流保护 | MPPT→电池保护 | 63 A MCB | 2 | 160 |  | 电商
交流配电 | 交流配电箱 DB | 双机输入 | 1 | 380 |  | 电商
交流配电 | 输出 MCB | 32 A C 曲线 | 2 | 60 |  | 电商
交流配电 | 剩余电流保护 | RCD 30 mA | 1 | 120 |  | 电商
交流配电 | 交流 SPD | Type II 220 V | 1 | 200 |  | 电商
交流配电 | 末端 MCB | 10/20/10/16 A | 4 | 25 |  | 电商
线缆和接地 | PV1-F 光伏线 | 4 mm²（~30 m） | 30 | 5 |  | 电商
线缆和接地 | RV 软线（耐低温） | 16 mm²（3 m×2 路） | 6 | 22 |  | 电商
线缆和接地 | RV 软线（耐低温） | 70 mm²（2 m×2 路） | 4 | 70 |  | 电商
线缆和接地 | RVV 软线 | 6 mm²（5 m×2 路） | 10 | 10 |  | 电商
线缆和接地 | BV 线 | 2.5 mm²（~40 m） | 40 | 3.5 |  | 电商
线缆和接地 | BV 线 | 4 mm²（~30 m） | 30 | 5.5 |  | 电商
线缆和接地 | 接地线 | ≥6 mm²（~10 m） | 10 | 6 |  | 电商
线缆和接地 | 桥架/穿线管 | 耐 UV + 耐低温 | 1 | 500 |  | 电商
设备间保温+加热 | 保温+加热+控温 | 设备间 ≥10 ℃（含加热器） | 1 | 1500 |  | 估（硬性前提）
安装辅材 | 端子/标识/防水防火 | 汇总 | 1 | 500 |  | 估
合计

Sheet: 成本分析
指标 | 数值
系统初始总投资(¥)
装机容量(kWp) | 6
单位装机成本(¥/Wp)
电池成本(¥)
单位储能成本(¥/kWh)
电池占比
