sunny1043/offgrid-pv-course-design/差异化城市设计/计算-设备清单-拉萨.xlsx

类别 | 设备/材料 | 规格型号 | 数量 | 单位 | 单价(¥) | 小计(¥)
光伏阵列 | 光伏组件 | LR7-72HGD-600M 600W | 5 | 块 | 650
光伏阵列 | MC4 连接器 | 光伏专用 | 10 | 对 | 16
支架 | 铝合金支架系统 | APAS P8-2080 6063-T5（5块30°） | 1 | 套 | 1500
控制和变换 | 离网逆变器(含MPPT) | Growatt SPF 5000 ES | 1 | 台 | 2200
蓄电池 | 磷酸铁锂模块 | BNP-5120BM 51.2V/100Ah | 5 | 台 | 4000
蓄电池 | 电池柜 | 19"机柜 | 1 | 个 | 1000
蓄电池 | 母排/连接件 | 等长等截面铜排 | 1 | 套 | 350
直流保护 | 组串熔断器 | 25A gPV | 1 | 个 | 40
直流保护 | 直流隔离开关 | 2P 600Vdc | 1 | 个 | 180
直流保护 | 直流SPD | Type II 1000Vdc | 1 | 个 | 220
直流保护 | 电池支路熔断器 | 100A gPV | 5 | 个 | 35
直流保护 | 电池总保护 | 160A DC MCB | 1 | 个 | 450
直流保护 | MPPT→电池保护 | 63A MCB | 1 | 个 | 160
交流配电 | 配电箱DB | 含汇排/端子 | 1 | 个 | 320
交流配电 | 输出MCB | 32A C曲线 | 1 | 个 | 60
交流配电 | RCD | 30mA | 1 | 个 | 120
交流配电 | 交流SPD | Type II 220V | 1 | 个 | 200
交流配电 | 末端MCB | 10/20/10/16A | 4 | 个 | 25
线缆和接地 | PV1-F 光伏线 | 4mm² | 20 | m | 5
线缆和接地 | RV软线 | 16mm²(MPPT→电池) | 3 | m | 20
线缆和接地 | RV软线 | 70mm²(电池→逆变) | 2 | m | 65
线缆和接地 | RVV软线 | 6mm²(逆变→配电) | 5 | m | 10
线缆和接地 | BV线 | 2.5mm² | 40 | m | 3.5
线缆和接地 | BV线 | 4mm² | 30 | m | 5.5
线缆和接地 | 接地线 | ≥6mm² | 10 | m | 6
线缆和接地 | 桥架/穿线管 | 耐UV | 1 | 套 | 350
设备间保温 | 保温层+电伴热 | 设备间≥10℃ | 1 | 套 | 800
安装辅材 | 端子/标识/防水 | 汇总 | 1 | 套 | 400
合计
