sunny1043/offgrid-pv-course-design/docs/计算-设备清单-深圳.xlsx

Sheet: 设备清单
户用离网光伏发电系统 — 设备清单 BOM（深圳 · W11）
价格为市场参考价（电商/B2B，查询日期 2026-09-03，单一时间基准）；小计 = 数量×单价
类别 | 设备/材料 | 规格型号 | 数量 | 单位 | 单价(¥) | 小计(¥) | 价格参考
光伏阵列 | 光伏组件 | 隆基 Hi-MO 7 LR7-72HGD-600M（600W N型） | 4 | 块 | 650 |  | 2026 低价期零售参考
光伏阵列 | MC4 连接器 | 光伏专用（含防护） | 8 | 对 | 16 |  | 电商
支架 | 屋面铝合金支架系统 | 6063-T5 导轨×8+压块/立柱/锚固（2.40kWp） | 1 | 套 | 1300 |  | 铝价≈23780元/t(2026-06)+加工
控制和变换 | 离网逆变器（含MPPT） | Growatt SPF 5000 ES | 1 | 台 | 2200 |  | 淘宝实价≈¥2150
蓄电池 | 磷酸铁锂模块 | Benhoo BNP-5120BM（51.2V/100Ah/5.12kWh） | 4 | 台 | 4000 |  | B2B ¥3500~5000/台
蓄电池 | 电池柜 | 19" 机柜 600×600×1200 | 1 | 台 | 1000 |  | 电商
蓄电池 | 母排/连接件 | 等长等截面铜排+线缆 | 1 | 套 | 300 |  | 估
直流保护 | 组串熔断器 | 25A gPV | 1 | 个 | 40 |  | 电商
直流保护 | 直流隔离开关 | 2P 600Vdc | 1 | 个 | 180 |  | 电商
直流保护 | 直流 SPD | Type II 1000Vdc（Ucpv≥265V） | 1 | 个 | 220 |  | 电商
直流保护 | 电池支路熔断器 | 100A gPV | 4 | 个 | 35 |  | 电商
直流保护 | 电池总保护 | 160A DC MCB（2P） | 1 | 个 | 450 |  | 电商
直流保护 | MPPT→电池保护 | 50A MCB | 1 | 个 | 150 |  | 电商
交流配电 | 交流配电箱 DB | 含汇排/端子 | 1 | 台 | 320 |  | 电商
交流配电 | 输出 MCB | 32A C 曲线 | 1 | 个 | 60 |  | 电商
交流配电 | 剩余电流保护 RCD | 30mA | 1 | 个 | 120 |  | 电商
交流配电 | 交流 SPD | Type II 220V（Imax 40kA） | 1 | 个 | 200 |  | 电商
交流配电 | 末端 MCB | 10/20/20/16A | 4 | 个 | 25 |  | 电商
线缆和接地 | PV1-F 光伏线 4mm² | 组串+阵列至MPPT | 20 | m | 5 |  | 电商 ¥4~6/m
线缆和接地 | RV 软线 10mm² | MPPT→电池 | 3 | m | 14 |  | 电商
线缆和接地 | RV 软线 70mm² | 电池→逆变器 | 2 | m | 65 |  | 电商
线缆和接地 | RVV 软线 6mm² | 逆变→配电箱 | 5 | m | 10 |  | 电商
线缆和接地 | BV 线 2.5mm² | 照明/插座 | 40 | m | 3.5 |  | 电商
线缆和接地 | BV 线 4mm² | 厨房/空调 | 30 | m | 5.5 |  | 电商
线缆和接地 | 接地线 ≥6mm² | PE/等电位 | 10 | m | 6 |  | 电商
线缆和接地 | 桥架/穿线管 | 屋面→设备间+室内 | 1 | 套 | 350 |  | 电商
安装辅材 | 端子/标识/防水防火 | 汇总 | 1 | 套 | 400 |  | 估
 | 合计（系统初始投资）

Sheet: 成本分析
成本分析（W11）
系统初始投资（¥） |  | 设备清单合计
装机容量（kWp） | 2.40 | W5：4×600W
单位装机成本（¥/Wp） |  | 总投资/装机容量
电池成本（¥） |  | 4×BNP-5120BM+柜+母排
储能容量（kWh） | 20.48 | W4：4×5.12 kWh
单位储能成本（¥/kWh） |  | 电池成本/储能容量
蓄电池配置比较（任务书 §4.8）
方案 | 模块配置 | 能量(kWh) | 电池成本(¥) | 支路 | 备注
方案 A（采用） | 4×BNP-5120BM（100Ah） | 20.48 | 17000 | 4 | 官方渠道；W5~W9 校核图纸均按此
方案 B（备选） | 2×51.2V/200Ah | 20.48 | 13000 | 2 | madeinchina $900/台≈¥6500；可省≈¥3000~4000
