sunny1043/offgrid-pv-course-design/差异化城市设计/计算-蓄电池-拉萨.xlsx

Sheet: 参数
参数 | 值 | 单位 | 含义 | 来源/依据
E_AC | 7.820 | kWh/d | 交流侧日用电量（冬季采暖季设计点） | docs/负荷调查-拉萨.md
N_A | 2.000 | d | 自主供电天数（基准设计） | 任务书 §4.3 / 指导书 §5.2
K_R | 1.100 | - | 容量储备系数 | 指导书 §5.2（1.05~1.10，取 1.10）
DOD | 0.900 | - | 允许放电深度 | 磷酸铁锂+BMS（保守口径 0.80 见敏感性）
eta_dis | 0.950 | - | 蓄电池放电效率 | W3 效率表
eta_inv | 0.930 | - | 逆变器效率 | W3（SPF 5000 ES 官方峰值 93%）
K_T | 1.000 | - | 低温修正系数 | 设备间保温不低于 10 ℃（无保温敏感性 0.70）
V_nom | 51.200 | V | 蓄电池标称电压 | 48 V 级磷酸铁锂 16 串
E_mod | 5.120 | kWh | 单模块标称能量 | BNP-5120BM 51.2V/100Ah
N_P_sel | 5.000 | 台 | 选定并联数量 | 方案 A
P_inv_r | 5000.000 | W | 逆变器额定功率 | Growatt SPF 5000 ES
V_bat_min | 45.000 | V | 电池侧最低工作电压 | 模块放电下限 44.8 V 对应
P_short | 5200.000 | W | 短时冲击功率 | W1（P_max 4.6 kW + 冰箱启动 0.6 kW）
P_PV | 3000.000 | W | 光伏阵列装机容量 | W5（5 串 × 1 并 × 600 W）
V_bat_chg | 54.400 | V | 电池侧充电电压 | 充电上限 57.6 V 内典型值
I_ctrl_out_max | 100.000 | A | MPPT 控制器输出限流 | SPF 5000 ES
eta_MPPT | 0.960 | - | MPPT 控制器效率 | W3

Sheet: 容量计算
项目 | 计算式/说明 | 结果 | 单位
E_bat,min 最低标称能量 | E_AC*N_A*K_R/(DOD*eta_dis*eta_inv*K_T) |  | kWh
C_bat,min 安时 | 1000*E_bat,min/V_nom |  | Ah
N_P,E 并联数量(能量) | CEILING(E_bat,min/E_mod,1) |  | 台
E_actual 实际标称能量 | N_P*E_mod |  | kWh
实际/下限比值 | E_actual/E_bat,min |  | -
敏感性：3 d 自主供电 | E_AC*3*K_R/(DOD*eta_dis*eta_inv*K_T) |  | kWh
N_P(3d) |  |  | 台
E_actual(3d) | N_P3d*E_mod |  | kWh
敏感性：DOD=0.80 保守 | E_AC*N_A*K_R/(0.8*eta_dis*eta_inv*K_T) |  | kWh
N_P(DOD0.80) |  |  | 台
敏感性：设备间不保温 K_T=0.70 | E_AC*N_A*K_R/(DOD*eta_dis*eta_inv*0.7) |  | kWh
N_P(K_T=0.70) | CEILING(Ekt/E_mod,1) |  | 台

Sheet: 校核表
项目 | 计算或选定结果 | 产品允许值 | 结论
最低标称能量 |  | — | —
实际标称能量 |  | ≤1.25×E_bat,min
连续放电电流 I_dis | ROUND(P_inv_r/(V_bat_min*eta_inv),1) | 5*100 A
短时放电电流 I_dis,sur | ROUND(P_short/(V_bat_min*eta_inv),1) | 5×100 A
最大充电电流 I_chg | ROUND(MIN(P_PV*eta_MPPT/V_bat_chg,I_ctrl_out_max),1) | 5×50 A
并联数量 N_P |  | 远低于厂家上限 | OK
N_S 串联 | 1（完整模块不串联） | 不串联 | OK
