sunny1043/offgrid-pv-course-design/docs/计算-线缆保护-深圳.xlsx

Sheet: 参数
参数 | 值 | 单位 | 说明
rho | 0.0175 | Ω·mm²/m | 铜 20℃ 电阻率
derate | 0.87 | - | 40℃ 环境温度修正系数（PVC 绝缘）
C1_Ib | 14.49 | A | C1 组件串线设计电流（Isc 最不利）
C1_L | 1 | m | C1 长度（组件间互联）
C1_S | 4 | mm² | C1 截面（PV1-F）
C1_In | 25 | A | C1 保护器件（组串熔断器）
C1_Un | 154.2 | V | C1 电压降基准（Vmp）
C1_Iz | 55 | A | C1 载流量基准（PV1-F 4mm², 空气中 90℃）
C2_Ib | 13.6 | A | C2 组串→MPPT 运行电流
C2_L | 15 | m | C2 长度
C2_S | 4 | mm² | C2 截面（PV1-F）
C2_In | 25 | A | C2 保护（组串熔断器）
C2_Un | 154.2 | V | C2 基准（Vmp）
C2_Iz | 55 | A | C2 载流量基准
C3_Ib | 42.4 | A | C3 MPPT→电池充电电流
C3_L | 3 | m | C3 长度
C3_S | 10 | mm² | C3 截面（RV）
C3_In | 50 | A | C3 保护（DC MCB）
C3_Un | 48 | V | C3 基准（48V 级）
C3_Iz | 70 | A | C3 载流量基准
C4_Ib | 119.5 | A | C4 电池→逆变器连续放电电流
C4_L | 2 | m | C4 长度
C4_S | 70 | mm² | C4 截面（RV）
C4_In | 160 | A | C4 保护（总保护 DC MCB）
C4_Un | 45 | V | C4 基准（最低电池电压 45V，红线）
C4_Iz | 220 | A | C4 载流量基准
C5_Ib | 22.7 | A | C5 逆变器→配电箱交流电流
C5_L | 5 | m | C5 长度
C5_S | 6 | mm² | C5 截面（RVV）
C5_In | 32 | A | C5 保护（AC MCB）
C5_Un | 220 | V | C5 基准（220V）
C5_Iz | 51 | A | C5 载流量基准
C6a_Ib | 0.5 | A | C6a 照明回路电流
C6a_L | 20 | m | C6a 长度
C6a_S | 2.5 | mm² | C6a 截面（BV）
C6a_In | 10 | A | C6a 保护（MCB）
C6a_Un | 220 | V | C6a 基准
C6a_Iz | 30 | A | C6a 载流量基准
C6b_Ib | 13.6 | A | C6b 厨房插座（炊事高峰 3.0kW）
C6b_L | 15 | m | C6b 长度
C6b_S | 4 | mm² | C6b 截面（BV）
C6b_In | 20 | A | C6b 保护（MCB）
C6b_Un | 220 | V | C6b 基准
C6b_Iz | 40 | A | C6b 载流量基准
C6c_Ib | 8.6 | A | C6c 空调回路电流
C6c_L | 15 | m | C6c 长度
C6c_S | 4 | mm² | C6c 截面（BV）
C6c_In | 20 | A | C6c 保护（MCB，含启动裕量）
C6c_Un | 220 | V | C6c 基准
C6c_Iz | 40 | A | C6c 载流量基准
C6d_Ib | 3.4 | A | C6d 其他插座电流
C6d_L | 20 | m | C6d 长度
C6d_S | 2.5 | mm² | C6d 截面（BV）
C6d_In | 16 | A | C6d 保护（MCB）
C6d_Un | 220 | V | C6d 基准
C6d_Iz | 30 | A | C6d 载流量基准

Sheet: 回路计算
回路 | 线缆 | 截面S | L | Ib | In | Iz(40℃) | ΔU | δU | Un基准 | 载流量 | 压降
C1 光伏组件串线 | PV1-F 1×4mm²
C2 组串→MPPT | PV1-F 1×4mm²
C3 MPPT→蓄电池 | RV 1×10mm²
C4 蓄电池→逆变器 | RV 1×70mm²
C5 逆变器→交流配电箱 | RVV 3×6mm²
C6a 照明回路 | BV 3×2.5mm²
C6b 厨房插座(炊事) | BV 3×4mm²
C6c 空调回路 | BV 3×4mm²
C6d 其他插座 | BV 3×2.5mm²

Sheet: 保护器件
位置 | 保护器件 | 选型 | 依据
光伏输入侧 | 组串熔断器 | 25 A gPV 直流 | ≥1.4×Isc=20.3A，<组件最大串联熔断器 30A（GB 50797）
光伏输入侧 | 直流隔离 | 2P 隔离开关 ≥600Vdc | ≥组串 Voc,cold=220.8V，检修隔离
光伏输入侧 | 直流 SPD | Type II 1000Vdc，Ucpv≥265V | GB/T 32512，1.2×Voc,cold
蓄电池侧 | 支路熔断器 | 4×100A gPV 直流 | 每支路=模块最大放电电流 100A，隔离单支路故障
蓄电池侧 | 总保护 | 160A DC MCB（2P ≥125Vdc） | 119.5A≤160A≤Iz=191A，含检修隔离
MPPT→电池 | 充电回路 MCB | 50A DC MCB | 42.4A≤50A≤60.9A
交流侧 | 逆变器输出 MCB | 32A C曲线 | 22.7A≤32A≤44.4A
交流侧 | 剩余电流保护 | 30mA RCD（插座回路） | 人身触电保护
交流侧 | 交流 SPD | Type II 220V（Uc=275V, Imax 40kA） | GB 50057/GB/T 32512
接地 | PE/等电位 | PE 铜 ≥6mm²，接地电阻≤4Ω | 组件边框/支架/设备外壳接保护接地，等电位联结
