sunny1043/offgrid-pv-course-design/差异化城市设计/计算-蓄电池-兰州.xlsx

Sheet: 参数
参数 | 值 | 单位 | 含义 | 备注
E_AC | 7.82 | kWh/d | 交流侧日用电量（冬季采暖季设计点） | 兰州 W1
N_A | 2 | d | 自主供电天数 | 任务书基准
K_R | 1.1 | - | 容量储备系数 | 指导书 §5.2
DOD | 0.9 | - | 允许放电深度 | 磷酸铁锂+BMS
eta_dis | 0.95 | - | 放电效率 | W3
eta_inv | 0.93 | - | 逆变器效率 | SPF 5000 ES 官方峰值
K_T | 1 | - | 低温修正 | 设备间保温不低于 10 ℃
V_nom | 51.2 | V | 标称电压 | 48 V 级
E_mod | 5.12 | kWh | 单模块能量 | BNP-5120BM 51.2V/100Ah
P_inv_tot | 5000 | W | 逆变器总额定 | SPF 5000 ES x1
V_bat_min | 45 | V | 电池侧最低电压 | 模块放电下限 44.8 V 对应
P_short | 5200 | W | 短时冲击功率 | W1
P_PV_tot | 3600 | W | 阵列总装机 | W5
V_bat_chg | 54.4 | V | 充电电压
I_ctrl_tot | 100 | A | 控制器输出限流合计 | SPF 5000 ES x1
eta_MPPT | 0.96 | - | MPPT 效率 | W3

Sheet: 容量计算
项目 | 计算式/说明 | 结果 | 单位
E_bat,min 最低标称能量 |  |  | kWh
C_bat,min 安时 |  |  | Ah
N_P 并联数量(能量) |  |  | 台
E_actual 实际标称能量 |  |  | kWh
实际/下限比值 |  |  | -
敏感性：3 d |  |  | kWh
N_P(3d) |  |  | 台
敏感性：DOD=0.80 |  |  | kWh
N_P(DOD0.80) |  |  | 台
敏感性：K_T=0.70 |  |  | kWh
N_P(K_T=0.70) |  |  | 台

Sheet: 校核表
项目 | 计算或选定结果 | 产品允许值 | 结论
最低标称能量 |  | — | —
实际标称能量 |  | ≤1.25×E_bat,min
连续放电电流 I_dis
短时放电电流 I_dis,sur |  | 5×100 A
最大充电电流 I_chg |  | 5×50 A
并联数量 N_P |  | 远低于厂家上限 | OK
N_S 串联 | 1（完整模块不串联） | 不串联 | OK
