sunny1043/offgrid-pv-course-design/docs/计算-蓄电池-深圳.xlsx

Sheet: 参数
参数 | 值 | 单位 | 含义 | 来源/依据
E_AC | 6.99 | kWh/d | 交流侧日用电量（W1 负荷调查） | docs/负荷调查-深圳.md
N_A | 2 | d | 自主供电天数（基准设计） | 任务书 §4.3 / 指导书 §5.2
K_R | 1.1 | - | 容量储备系数 | 指导书 §5.2（1.05~1.10，取 1.10）
DOD | 0.9 | - | 允许放电深度（磷酸铁锂+BMS） | W3 效率表：0.80 保守 / 0.90 厂商，取 0.90
eta_dis | 0.95 | - | 蓄电池放电效率 | W3 效率表（典型值，选型后回填）
eta_inv | 0.93 | - | 逆变器效率 | Growatt SPF 5000 ES 官方峰值效率 93%（W6 回填）；原任务书示例 0.92 为保守口径
K_T | 1 | - | 低温/可用容量修正（深圳低温影响小） | W3 效率表
V_nom | 51.2 | V | 蓄电池组标称电压（16S 磷酸铁锂） | 模块规格书
V_bat_min | 45 | V | 逆变器最低允许直流输入电压（校核用） | 逆变器低压切断须设置 >=44.8V（W6 确认）；与模块放电下限 44.8V 一致
V_bat_chg | 54.4 | V | 充电电压（16S×3.4V） | 模块规格书充电上限
P_inv_r | 5 | kW | 逆变器额定功率（SPF 5000 ES） | Growatt SPF 5000 ES 额定 5kW（W6 官方确认）；P_max=3.0kW x 1.67 裕量
P_sur | 3.6 | kW | 系统短时冲击功率（W1） | docs/负荷调查-深圳.md §5
P_PV | 2.4 | kW | 光伏阵列装机容量（W5 定案） | W5 定案 P_PV=2.40 kWp（4串x1并 600W）；I_chg 复核 42.4A
eta_MPPT | 0.96 | - | MPPT 控制器效率 | W3 效率表
I_ctrl_out_max | 100 | A | MPPT 控制器最大输出（充电）电流 | SPF 5000 ES 最大太阳能充电电流 100A（W6 官方确认）
modA_vol | 51.2 | V | 方案A 模块标称电压（Benhoo BNP-5120BM） | benhoobattery.com（查询日期 2026-09-01）
modA_ah | 100 | Ah | 方案A 模块标称容量 | 同上
modA_idis | 100 | A | 方案A 模块最大连续放电电流 | 同上
modA_ichg | 50 | A | 方案A 模块最大充电电流 | 同上
modA_price | 4000 | 元 | 方案A 单模块参考价（区间中值） | Alibaba 同类 51.2V 100Ah 机架式电池 B2B 报价 ¥3,500~5,000
modB_vol | 51.2 | V | 方案B 模块标称电压 | madeinchina.com（查询日期 2026-09-01）
modB_ah | 200 | Ah | 方案B 模块标称容量 | 同上
modB_idis | 100 | A | 方案B 模块最大连续放电电流（0.5C 典型，待规格书确认） | 同上
modB_ichg | 100 | A | 方案B 模块最大充电电流（0.5C 典型，待规格书确认） | 同上
modB_price | 6400 | 元 | 方案B 单模块参考价（$900 出厂价折算） | madeinchina.com 报价 $900 ≈ ¥6,400

Sheet: 容量计算
项目 | 公式（文字说明） | 结果（公式） | 单位 | 说明
最低标称能量 E_bat,min | E_AC*N_A*K_R/(DOD*eta_dis*eta_inv*K_T) |  | kWh | 指导书 §5.2
最低容量 C_bat,min | 1000*E_bat,min/V_nom |  | Ah | 指导书 §5.2
方案A 单模块能量 E_modA | V_modA*Ah_modA/1000 |  | kWh | 指导书 §5.3
方案A 并联数量(能量) NP,E | CEILING(E_bat,min/E_modA,1) |  | 个 | 指导书 §5.3
方案A 实际标称能量 | NP,E*E_modA |  | kWh
方案A 连续放电电流 I_dis | P_inv_r*1000/(V_bat_min*eta_inv) |  | A | 指导书 §5.4
方案A 短时放电电流 | P_sur*1000/(V_bat_min*eta_inv) |  | A | 指导书 §5.4
方案A 最大充电电流 I_chg | MIN(P_PV*1000*eta_MPPT/V_bat_chg, I_ctrl_out_max) |  | A | 指导书 §5.4；第二项=控制器输出限流（W6 回填）
方案A 并联数量(放电) | CEILING(I_dis/modA_idis,1) |  | 个
方案A 并联数量(充电) | CEILING(I_chg/modA_ichg,1) |  | 个
方案A 最终并联数量 NP | MAX(NP,E,NP,dis,NP,chg) |  | 个 | 指导书 §5.4
方案A 配置 | "51.2V 100Ah×"&NP |  | -
方案A 成本(模块) | NP*modA_price |  | 元 | 按模块单价×数量（不含BMS/柜体/安装）
3d 标称能量 | E_AC*3*K_R/(DOD*eta_dis*eta_inv*K_T) |  | kWh | 敏感性分析
3d/2d 比值 | E_3d/E_bat,min |  | - | 理论 = 1.5
方案B 单模块能量 E_modB | V_modB*Ah_modB/1000 |  | kWh
方案B 并联数量(能量) | CEILING(E_bat,min/E_modB,1) |  | 个
方案B 实际标称能量 | NP,E_B*E_modB |  | kWh
方案B 配置 | "51.2V 200Ah×"&NP,E_B |  | -
方案B 成本(模块) | NP,E_B*modB_price |  | 元

Sheet: 校核表
项目 | 计算或选定结果 | 产品允许值 | 结论
最低标称能量 |  | — | —
模块型号及单模块能量 | Benhoo BNP-5120BM（51.2V 100Ah，5.12kWh） | — | —
串联数量 | 1 | 1（完整模块禁止串联） | OK
并联数量 |  | ≤75 台（厂家标注） | OK
实际标称能量
连续放电电流
短时放电电流
最大充电电流
BMS 与并联限制 | 智能BMS（RS485/CAN），并联 4 台 | — | OK
2d/3d 对比 |  | 3d≈1.5×2d
