sunny1043/offgrid-pv-course-design/差异化城市设计/设备清单与成本分析-哈尔滨.md

# 设备清单与成本分析 — 哈尔滨（W11）

> 依据：设计指导书 §12（设备清单、成本和方案调整）、课程设计任务书 §4.8。
> 状态：完成（市场参考价，查询日期 2026-09-06，单一时间基准；最终以采购价为准）。
> 哈尔滨差异化：蓄电池 5 台、阵列 **6.00 kWp（10 块）**（冬季辐照塌陷）、**双逆变器（2×SPF 5000 ES）**、支架 40° 大倾角 + **雪荷载 0.45 kN/m² 组合**、**设备间保温 + 低温加热**（硬性前提）、线缆成对（双机）；**方案 B（200 Ah）失效**（同拉萨/兰州，W4 §4）。

## 1. 设备清单（指导书 §12.1 表 9 分类）

| 类别 | 设备/材料 | 规格型号 | 数量 | 单价(¥) | 小计(¥) | 价格参考 |
|---|---|---|---|---|---|---|
| **光伏阵列** | 光伏组件 | 隆基 Hi-MO 7 LR7-72HGD-600M（600 W N 型） | **10** | 650 | **6,500** | 2026 组件低价期零售参考 |
| | MC4 连接器 | 光伏专用（含防护） | 20 对 | 16 | 320 | 电商 |
| **支架** | 屋面铝合金支架系统 | 6063-T5 导轨 + 压块/立柱/锚固/防水垫（10 块竖排 40°，含雪荷载加强） | 1 套 | **3,000** | **3,000** | 按铝价 + 辅件/加工/安装（10 块 + 40° 大倾角较贵） |
| **控制和变换** | 离网逆变器（含 MPPT） | Growatt SPF 5000 ES | **2** | 2,200 | **4,400** | 淘宝实价约 ¥2,150/台 |
| | 并联套件 | Growatt 并联通信线/模块 | 1 套 | 200 | 200 | 电商 |
| **蓄电池** | 磷酸铁锂模块 | Benhoo BNP-5120BM（51.2 V/100 Ah/5.12 kWh，内置 BMS） | 5 | 4,000 | **20,000** | B2B 同类 ¥3,500~5,000/台 |
| | 电池柜 | 19" 机柜 600×600×1200 mm | 1 | 1,000 | 1,000 | 电商 |
| | 母排/连接件 | 等长等截面铜排+线缆（5 路，低温冲击材料） | 1 套 | **450** | 450 | 估（哈尔滨低温材料） |
| **直流保护** | 组串熔断器 | 25 A gPV | **2** | 40 | 80 | 电商 |
| | 直流隔离开关 | 2P 600 Vdc | **2** | 180 | 360 | 电商 |
| | 直流 SPD | Type II 1000 Vdc（U_cpv≥360 V） | **2** | 220 | 440 | 电商 |
| | 电池支路熔断器 | 100 A gPV | 5 | 35 | 175 | 电商 |
| | 电池总保护 | 160 A DC MCB（2P） | **2** | 450 | 900 | 电商 |
| | MPPT→电池保护 | 63 A MCB | **2** | 160 | 320 | 电商 |
| **交流配电** | 交流配电箱 DB | 含汇排/端子（双机输入） | 1 | **380** | 380 | 电商 |
| | 输出 MCB | 32 A C 曲线 | **2** | 60 | 120 | 电商 |
| | 剩余电流保护 | RCD 30 mA | 1 | 120 | 120 | 电商 |
| | 交流 SPD | Type II 220 V（Imax 40 kA） | 1 | 200 | 200 | 电商 |
| | 末端 MCB | 10/20/10/16 A | 4 | 25 | 100 | 电商 |
| **线缆和接地** | PV1-F 光伏线 | 4 mm²（组串+阵列至 MPPT ~30 m，两路） | 30 m | 5 | 150 | 电商 |
| | RV 软线（耐低温） | **16 mm²**（MPPT→电池 3 m ×2 路） | 6 m | 22 | 132 | 电商（低温护套） |
| | RV 软线（耐低温） | **70 mm²**（电池→逆变器 2 m ×2 路） | 4 m | **70** | 280 | 电商（低温护套） |
| | RVV 软线 | 6 mm²（逆变→配电箱 5 m ×2 路） | 10 m | 10 | 100 | 电商 |
| | BV 线 | 2.5 mm²（照明/采暖/插座 ~40 m） | 40 m | 3.5 | 140 | 电商 |
| | BV 线 | 4 mm²（厨房 ~30 m） | 30 m | 5.5 | 165 | 电商 |
| | 接地线 | ≥6 mm²（PE/等电位 ~10 m） | 10 m | 6 | 60 | 电商 |
| | 桥架/穿线管 | 屋面→设备间 + 室内（耐 UV + 耐低温） | 1 套 | **500** | 500 | 电商 |
| **设备间保温+加热（哈尔滨必须）** | 保温层 + 低温加热 + 温度控制 | 设备间 ≥10 ℃（3.5×2.5 m，**含加热器**） | 1 套 | **1,500** | **1,500** | 估（保温层 + 加热带/加热器 + 控温） |
| **安装辅材** | 端子/标识/防水防火 | 汇总 | 1 套 | **500** | 500 | 估 |
| | | | | **合计** | **≈¥42,592** | |

> 取整报 **≈¥42,600**（零头并入辅材不可预见费）。

## 2. 蓄电池配置说明（任务书 §4.8）

- **方案 A（采用）**：5×BNP-5120BM（100 Ah）= 25.60 kWh，电池成本 **¥20,000**，支路保护 5 路；W5~W9 校核与图纸均按此配置；
- **方案 B（200 Ah）在本方案不可行**（W4 §4，同拉萨/兰州）：2 台 20.48 kWh < 下限 21.64 kWh 不足；3 台 30.72 kWh 超 1.25 倍上限（1.42 倍）——"夹逼困境"。

## 3. 成本分析（指导书 §12.1）

| 指标 | 数值 |
|---|---|
| 系统初始总投资 | **≈ ¥42,592** |
| 单位装机成本 | ≈ ¥42,592 / 6.00 kWp = **¥7.10/Wp** |
| 单位储能成本 | ¥20,000 / 25.60 kWh ≈ **¥781/kWh**（仅电池） |
| 成本结构 | 蓄电池 47%（含柜体/保温/母排）＞ 光伏阵列 15%（10 块）＞ 控制变换 11%（双机）＞ 支架 7% ＞ 其余 20% |

> 哈尔滨为四城最高（深圳 ¥26,945、拉萨 ¥32,740）：多 5 块组件（+¥3,250）、多 1 台逆变器（+¥2,400）、双机保护器件加倍（+~¥700）、大倾角支架（+¥1,500）、保温+加热设备间（+¥1,500）；但单位装机 ¥7.10/Wp 为四城**最低**（规模效应），电池占比 47% 较其他城市低（光伏/双机拉高了总盘子）。

## 4. 成本过高检查（指导书 §12.2 顺序）

1. 负荷在分配区间且采暖时长合理 ✅（E_AC=7.82∈[7.5,8.0]，电暖器 5 h×0.5）；
2. 未把 3 d 作为基准容量 ✅；未重复计算损失 ✅；
3. 电池粒度已论证（方案 B 失效，见 §2）；未以取消保护/扩大 DOD/超电流限值降本 ✅；
4. 哈尔滨特有降本点：**设备间保温 + 低温加热（¥1,500）绝对必要**——不保温 K_T=0.70 → 需 7 台电池，多 ¥8,000，得不偿失；若可省，优先：组件低价期采购 → 保温自装/加热器选小功率 → 支架自装 → **不省双机**（输入侧电流约束，不可省）；
5. 双机成本说明：2 台 SPF 5000 ES 并联非负荷所需（单台 5 kW＞P_max=4.6 kW），但 6.00 kWp 两串并联输入电流 28.98 A＞单台 MPPT 22 A 限值，**双机是光伏输入侧的硬约束**，不可降为单机。

## 5. 与验收要求的对应

- 三文件一致性（报告/图纸/BOM）：型号与 W4（BNP-5120BM×5）、W5（LR7-72HGD-600M×10、5 串×2 并=6.00 kWp）、W6（**2×** SPF 5000 ES 并联）、W7（保护器件规格×2 套）、W8（支架 40°/设备间 3.5×2.5 m）一致 ✅；
- 价格基准一致 + 记录查询日期 ✅（2026-09-06）。

## 6. 待确认

1. 双机并联套件与 BMS 通信协议厂家确认（Growatt 并联方案 + Benhoo CAN/RS485）；
2. 设备间保温具体做法（保温层厚度/加热器功率/控温方案）与报价核实；
3. 耐低温桥架/线缆护套价格核实（哈尔滨 -38.1 ℃ 要求低温冲击性能好的材料）。
