sunny1043/offgrid-pv-course-design/差异化城市设计/设备清单与成本分析-拉萨.md

# 设备清单与成本分析 — 拉萨（W11）

> 依据：设计指导书 §12（设备清单、成本和方案调整）、课程设计任务书 §4.8。
> 状态：完成（市场参考价，查询日期 2026-09-03，单一时间基准；最终以采购价为准）。
> 拉萨差异化：蓄电池 5 台（多 1 台于深圳）、阵列 3.00 kWp（5 串）、**新增设备间保温**成本、SPF 5000 ES 高原额定待确认；**方案 B（200 Ah）在拉萨失效**（W4 §4：2 台不足、3 台超 1.25 倍上限），故无 B 备选——降本空间来自保温与采购策略。

## 1. 设备清单（指导书 §12.1 表 9 分类）

| 类别 | 设备/材料 | 规格型号 | 数量 | 单价(¥) | 小计(¥) | 价格参考 |
|---|---|---|---|---|---|---|
| **光伏阵列** | 光伏组件 | 隆基 Hi-MO 7 LR7-72HGD-600M（600 W N 型） | 5 | 650 | 3,250 | 2026 组件低价期零售参考 |
| | MC4 连接器 | 光伏专用（含防护） | 10 对 | 16 | 160 | 电商 |
| **支架** | 屋面铝合金支架系统 | APAS P8-2080 6063-T5 导轨 + 压块/立柱/锚固/防水垫（5 块竖排 30°） | 1 套 | 1,500 | 1,500 | 按铝价≈¥23,780/t 估算 + 辅件/加工/安装 |
| **控制和变换** | 离网逆变器（含 MPPT） | Growatt SPF 5000 ES | 1 | 2,200 | 2,200 | 淘宝实价约 ¥2,150 |
| **蓄电池** | 磷酸铁锂模块 | Benhoo BNP-5120BM（51.2 V/100 Ah/5.12 kWh，内置 BMS） | 5 | 4,000 | 20,000 | B2B 同类 ¥3,500~5,000/台 |
| | 电池柜 | 19" 机柜 600×600×1200 mm | 1 | 1,000 | 1,000 | 电商 |
| | 母排/连接件 | 等长等截面铜排+线缆（5 路） | 1 套 | 350 | 350 | 估 |
| **直流保护** | 组串熔断器 | 25 A gPV | 1 | 40 | 40 | 电商 |
| | 直流隔离开关 | 2P 600 Vdc | 1 | 180 | 180 | 电商 |
| | 直流 SPD | Type II 1000 Vdc（U_cpv≥345 V） | 1 | 220 | 220 | 电商 |
| | 电池支路熔断器 | 100 A gPV | 5 | 35 | 175 | 电商 |
| | 电池总保护 | 160 A DC MCB（2P） | 1 | 450 | 450 | 电商 |
| | MPPT→电池保护 | 63 A MCB | 1 | 160 | 160 | 电商 |
| **交流配电** | 交流配电箱 DB | 含汇排/端子 | 1 | 320 | 320 | 电商 |
| | 输出 MCB | 32 A C 曲线 | 1 | 60 | 60 | 电商 |
| | 剩余电流保护 | RCD 30 mA | 1 | 120 | 120 | 电商 |
| | 交流 SPD | Type II 220 V（Imax 40 kA） | 1 | 200 | 200 | 电商 |
| | 末端 MCB | 10/20/10/16 A | 4 | 25 | 100 | 电商 |
| **线缆和接地** | PV1-F 光伏线 | 4 mm²（组串+阵列至 MPPT ~20 m） | 20 m | 5 | 100 | 电商 |
| | RV 软线 | **16 mm²**（MPPT→电池 3 m，I_chg=52.9 A） | 3 m | 20 | 60 | 电商 |
| | RV 软线 | **70 mm²**（电池→逆变器 2 m） | 2 m | 65 | 130 | 电商 |
| | RVV 软线 | 6 mm²（逆变→配电箱 5 m） | 5 m | 10 | 50 | 电商 |
| | BV 线 | 2.5 mm²（照明/采暖/插座 ~40 m） | 40 m | 3.5 | 140 | 电商 |
| | BV 线 | 4 mm²（厨房 ~30 m） | 30 m | 5.5 | 165 | 电商 |
| | 接地线 | ≥6 mm²（PE/等电位 ~10 m） | 10 m | 6 | 60 | 电商 |
| | 桥架/穿线管 | 屋面→设备间 + 室内（耐 UV） | 1 套 | 350 | 350 | 电商 |
| **设备间保温（拉萨新增）** | 保温层 + 电伴热/低温加热 + 温度控制 | 设备间 ≥10 ℃（W4 §8 经济性关键） | 1 套 | 800 | 800 | 估 |
| **安装辅材** | 端子/标识/防水防火 | 汇总 | 1 套 | 400 | 400 | 估 |
| | **合计** | | | | **32,740** | |

## 2. 蓄电池配置说明（任务书 §4.8）

- **方案 A（采用）**：5×BNP-5120BM（100 Ah）= 25.60 kWh，电池成本 **¥20,000**，支路保护 5 路；W5~W9 校核与图纸均按此配置；
- **方案 B（200 Ah）在本方案不可行**（W4 §4）：2 台 20.48 kWh < 下限 21.64 kWh 不足；3 台 30.72 kWh 超 1.25 倍上限（1.42 倍）——拉萨冬季电采暖抬高容量下限后出现"夹逼困境"，故无 B 备选可比（与深圳不同）。

## 3. 成本分析（指导书 §12.1）

| 指标 | 数值 |
|---|---|
| 系统初始总投资 | **≈ ¥32,740** |
| 单位装机成本 | ≈ ¥32,740 / 3.00 kWp = **¥10.9/Wp** |
| 单位储能成本 | ¥20,000 / 25.60 kWh ≈ **¥781/kWh**（仅电池） |
| 成本结构 | 蓄电池 64%（含柜体/保温）＞ 光伏阵列 12% ＞ 控制变换 7% ＞ 其余 17% |

> 拉萨因多 1 台电池 + 保温，总投资高于深圳（¥26,945）约 ¥5,800；电池占比仍约 2/3（离网典型特征）。

## 4. 成本过高检查（指导书 §12.2 顺序）

1. 负荷在分配区间且采暖时长合理 ✅（E_AC=7.82∈[7.5,8.0]，电暖器 5 h×0.5）；
2. 未把 3 d 作为基准容量 ✅；未重复计算损失 ✅；
3. 电池粒度已论证（方案 B 失效，见 §2）；未以取消保护/扩大 DOD/超电流限值降本 ✅；
4. 拉萨特有降本点：**设备间保温（¥800）是必要的**（不保温 K_T=0.70 → 需 7 台电池，多 ¥8,000，得不偿失）；若可省，优先：组件低价期采购 → 保温自装/简化电伴热 → 支架自装；
5. SPF 5000 ES 高原额定若不足 4.6 kW 需上调机型（成本 +¥500~1,000），W12 前向厂家确认。

## 5. 与验收要求的对应

- 三文件一致性（报告/图纸/BOM）：型号与 W4（BNP-5120BM×5）、W5（LR7-72HGD-600M×5）、W6（SPF 5000 ES）、W7（保护器件规格）、W8（支架）一致 ✅；
- 价格基准一致 + 记录查询日期 ✅（2026-09-03）。

## 6. 待确认

1. SPF 5000 ES 3000 m+ 海拔额定功率（决定是否上调机型）；
2. 保温设备间具体做法（电伴热功率/保温层厚度）与报价核实；
3. 高原耐 UV 桥架/支架涂装价格核实。
