sunny1043/offgrid-pv-course-design/docs/负荷调查-深圳.xlsx

Sheet: 负荷清单
户用离网光伏发电系统 — 负荷调查（深圳 · 全队共享示例）
设备清单按课程设计任务书 §3.1 工作表；日耗电 = 数量×额定功率×日运行时间×运行系数（冰箱按能效标识值）；参数来源见备注列；查询日期 2026-09-01
类别 | 设备（具体型号） | 数量 | 额定功率(kW) | 日运行(h/d) | 运行系数 | 日耗电(kWh/d) | 备注/来源
制冷空调 | 海尔 BCD-235WFCI 冰箱（235L 三门风冷变频，一级能效） | 1 |  |  |  | 0.54 | 综合耗电量 0.54 kWh/24h（海尔官网）
制冷空调 | 美的 KFR-35GW/N8KS1-1 酷省电二代空调（1.5P 新一级能效） | 1 | 0.845 | 8 | 0.5 |  | 额定制冷输入功率 845W（70-1900W，ZOL）；运行系数0.5（变频运行均值）；深圳夏季 8h/d
照明 | 飞利浦 LED 球泡 12W（E27） | 8 | 0.012 | 4 | 1 |  | 12W / ~1300lm（飞利浦官网）
通信信息 | 小米路由器 AX3000 | 1 | 0.006 | 24 | 1 |  | 待机约5W、满速约6W（实测）
通信信息 | Redmi 智能电视 A55 节能版 | 1 | 0.11 | 4 | 1 |  | 55寸 LED 整机功耗约110W（典型80~150W）
通信信息 | 笔记本（联想小新 Pro 14，假定可替换） | 1 | 0.065 | 5 | 1 |  | 65W PD 适配器
通信信息 | 手机快充充电器 ×2（小米67W，假定可替换） | 2 | 0.01 | 3 | 1 |  | 平均充电功率约10W
基本炊事 | 美的 FB40Simple111 电饭煲（4L） | 1 | 0.86 | 0.6 | 1 |  | 4L 额定约860W
基本炊事 | 美的 WHJ1705b 电热水壶（1.7L） | 1 | 1.8 | 0.15 | 1 |  | 额定1800W
基本炊事 | 方太 CXW-258-JCD7 侧吸油烟机 | 1 | 0.258 | 0.5 | 1 |  | 额定输入功率258W（官方）
基本炊事 | 格兰仕 P70D20TL-D4 微波炉（20L） | 1 | 1.15 | 0.1 | 1 |  | 输出700W、输入约1150W
基本炊事 | 美的 C21-RT2170 电磁炉（周末使用） | 1 | 2.1 | 0.057 | 1 |  | 额定功率2100W（官方）；每周2次×0.2h，日均0.4/7h
生活辅助 | 海尔 EG100MATE2S 滚筒洗衣机（10kg 变频） | 1 | 0.5 | 0.75 | 1 |  | 整程序平均约0.5kW；隔天使用，日均0.75h
生活辅助 | 待机负荷（空调/电视/微波炉/电磁炉/洗衣机合计） | 1 | 0.008 | 24 | 1 |  | 约8W
 | 合计（交流侧日用电量 E_AC） |  |  |  |  |  | 6.5~8.5 kWh/d 范围内
分类小计（对照指导书 §2.1 表1 建议范围）
制冷空调 |  | 建议 3.3~5.0
照明 |  | 建议 0.3~0.6
通信信息 |  | 建议 0.8~1.4
基本炊事 |  | 建议 0.7~1.2
生活辅助 |  | 建议 0.5~1.0

Sheet: 24h运行表
24 h 负荷运行表（1h 时段，代表日）
工作日代表日；空调 12:00–14:00、18:00–24:00（8h/d，按运行均值 0.42kW 计入）；末行为周末炊事高峰校核
时段 | 运行设备 | 同时功率(kW)
00:00–06:00 | 基础（冰箱+路由+待机+手机充电） | 0.06
06:00–07:00 | 基础 | 0.04
07:00–08:00 | 基础 + 电饭煲(早餐) + 水壶(短时) | 0.92
08:00–12:00 | 基础 | 0.04
12:00–13:00 | 基础 + 空调 + 微波炉(短时) | 0.58
13:00–14:00 | 基础 + 空调 | 0.46
14:00–15:00 | 基础 | 0.04
15:00–16:00 | 基础 + 洗衣机（洗涤/甩干） | 0.41
16:00–18:00 | 基础 | 0.04
18:00–19:00 | 基础 + 空调 + 照明 + 电饭煲 + 油烟机 + 电视 | 1.78
19:00–19:15 | 基础 + 空调 + 照明 + 电热水壶 + 电视（错峰）★工作日峰值 | 2.47
19:15–20:00 | 空调 + 照明 + 电视 | 0.67
20:00–22:30 | 空调 + 照明 + 电视 + 笔记本 | 0.73
22:30–24:00 | 空调 + 照明 + 路由 | 0.56
周末炊事高峰 | 电磁炉 2.1kW + 油烟机 + 空调 + 照明 + 电视 ★设计校核 | 3.02
最大同时功率 P_max | ★19:15–20:00 电磁炉时段

Sheet: 结果汇总
负荷调查结果汇总（供后续章节使用）
交流侧日用电量 E_AC (kWh/d) | 蓄电池容量、光伏阵列容量
最大同时功率 P_max (kW) | 逆变器额定功率选型（周末炊事高峰校核）
短时冲击功率 P_short (kW) | 逆变器短时功率校核（P_max+冰箱压缩机启动0.6kW）
逆变器连续额定建议 ≥1.2×P_max (kW) | 指导书 §7.2 裕量，最终选型在 W6
逆变器短时额定建议 ≥P_short (kW) | 指导书 §7.2
