sunny1043/offgrid-pv-course-design/docs/updates/2026-09-10/兰州光伏图纸-R0/M-01-屋顶方阵及支架布置图-R0.dxf

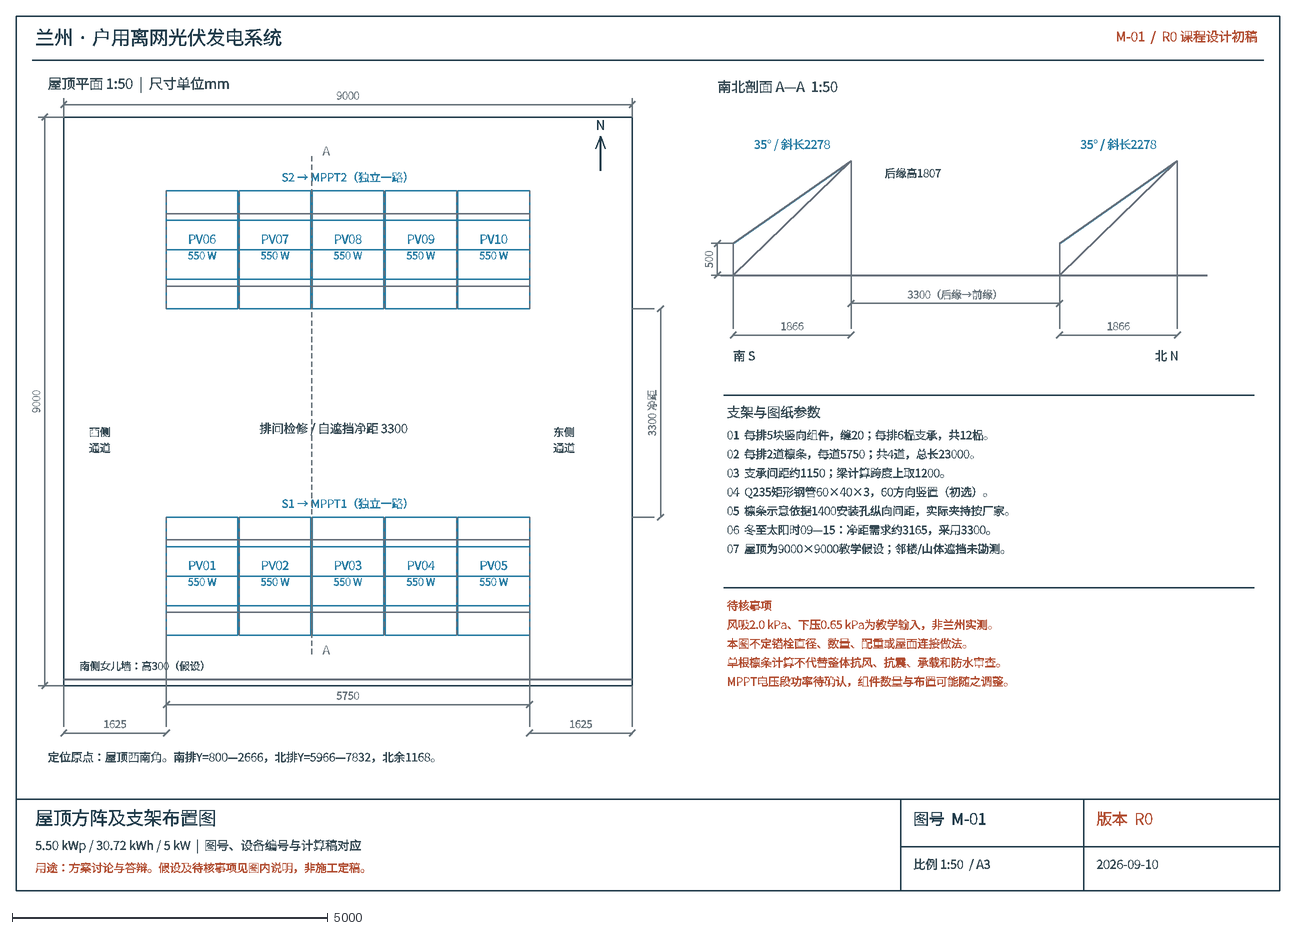
[picture p33: CAD file, 2026-09-10]
docs/updates/2026-09-10/兰州光伏图纸-R0/M-01-屋顶方阵及支架布置图-R0.dxf
兰州 · 户用离网光伏发电系统
M-01 / R0 课程设计初稿
屋顶方阵及支架布置图
5.50 kWp / 30.72 kWh / 5 kW | 图号、设备编号与计算稿对应
用途：方案讨论与答辩。假设及待核事项见图内说明，非施工定稿。
图号 M-01
版本 R0
比例 1:50 / A3
2026-09-10
屋顶平面 1:50 | 尺寸单位mm
PV01
550 W
PV02
PV03
PV04
PV05
S1 → MPPT1（独立一路）
PV06
PV07
PV08
PV09
PV10
S2 → MPPT2（独立一路）
西侧
通道
东侧
排间检修 / 自遮挡净距 3300
南侧女儿墙：高300（假设）
A
9000
5750
1625
3300 净距
N
南北剖面 A—A 1:50
35° / 斜长2278
3300（后缘→前缘）
1866
南 S
北 N
500
后缘高1807
支架与图纸参数
01 每排5块竖向组件，缝20；每排6榀支承，共12榀。
02 每排2道檩条，每道5750；共4道，总长23000。
03 支承间距约1150；梁计算跨度上取1200。
04 Q235矩形钢管60×40×3，60方向竖置（初选）。
05 檩条示意依据1400安装孔纵向间距，实际夹持按厂家。
06 冬至太阳时09—15：净距需求约3165，采用3300。
07 屋顶为9000×9000教学假设；邻楼/山体遮挡未勘测。
待核事项
风吸2.0 kPa、下压0.65 kPa为教学输入，非兰州实测。
本图不定锚栓直径、数量、配重或屋面连接做法。
单根檩条计算不代替整体抗风、抗震、承载和防水审查。
MPPT电压段功率待确认，组件数量与布置可能随之调整。
定位原点：屋顶西南角。南排Y=800—2666，北排Y=5966—7832，北余1168。
