sunny1043/offgrid-pv-course-design/docs/updates/2026-09-10/兰州光伏图纸-R0/E-01-系统电气原理与接线图-R0.dxf

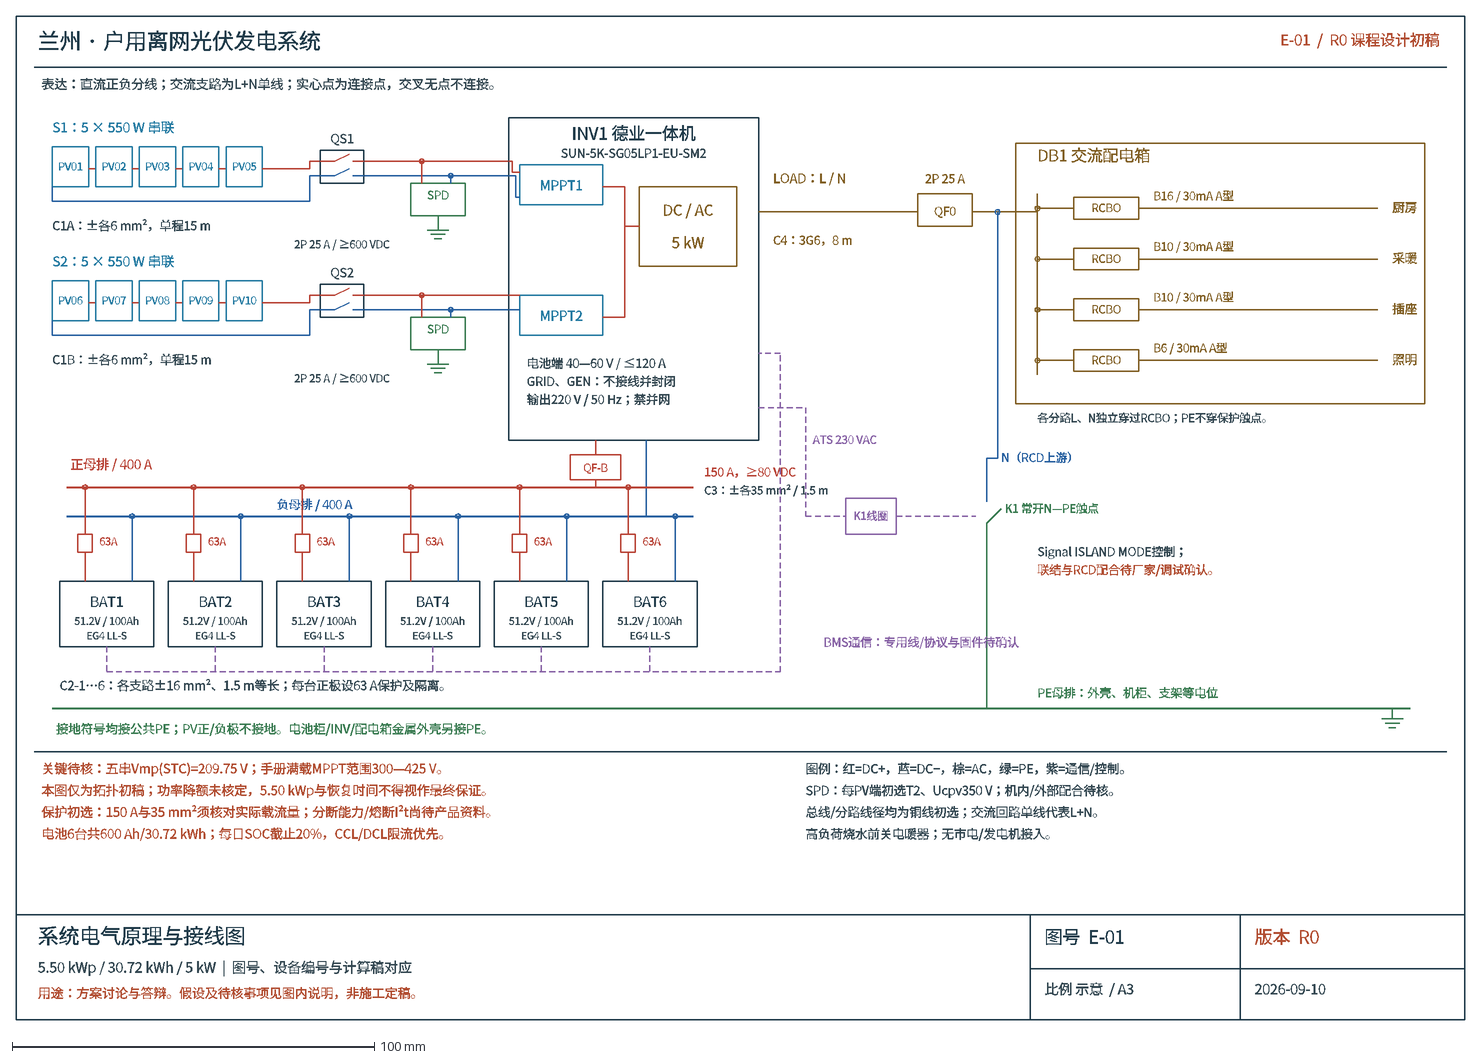
[picture p35: CAD file, 2026-09-10]
docs/updates/2026-09-10/兰州光伏图纸-R0/E-01-系统电气原理与接线图-R0.dxf
兰州 · 户用离网光伏发电系统
E-01 / R0 课程设计初稿
系统电气原理与接线图
5.50 kWp / 30.72 kWh / 5 kW | 图号、设备编号与计算稿对应
用途：方案讨论与答辩。假设及待核事项见图内说明，非施工定稿。
图号 E-01
版本 R0
比例 示意 / A3
2026-09-10
表达：直流正负分线；交流支路为L+N单线；实心点为连接点，交叉无点不连接。
PV01
PV02
PV03
PV04
PV05
S1：5 × 550 W 串联
QS1
2P 25 A / ≥600 VDC
SPD
C1A：±各6 mm²，单程15 m
PV06
PV07
PV08
PV09
PV10
S2：5 × 550 W 串联
QS2
C1B：±各6 mm²，单程15 m
INV1 德业一体机
SUN-5K-SG05LP1-EU-SM2
MPPT1
MPPT2
DC / AC
5 kW
电池端 40—60 V / ≤120 A
GRID、GEN：不接线并封闭
输出220 V / 50 Hz；禁并网
LOAD：L / N
QF0
2P 25 A
C4：3G6，8 m
DB1 交流配电箱
RCBO
B16 / 30mA A型
厨房
B10 / 30mA A型
采暖
插座
B6 / 30mA A型
照明
各分路L、N独立穿过RCBO；PE不穿保护触点。
N（RCD上游）
K1 常开N—PE触点
K1线圈
ATS 230 VAC
Signal ISLAND MODE控制；
联结与RCD配合待厂家/调试确认。
正母排 / 400 A
负母排 / 400 A
QF-B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
