sunny1043/offgrid-pv-course-design/docs/updates/2026-09-10/三城光伏图纸-DXF-R1/拉萨-T1-01-系统电气主接线图-R1.dxf

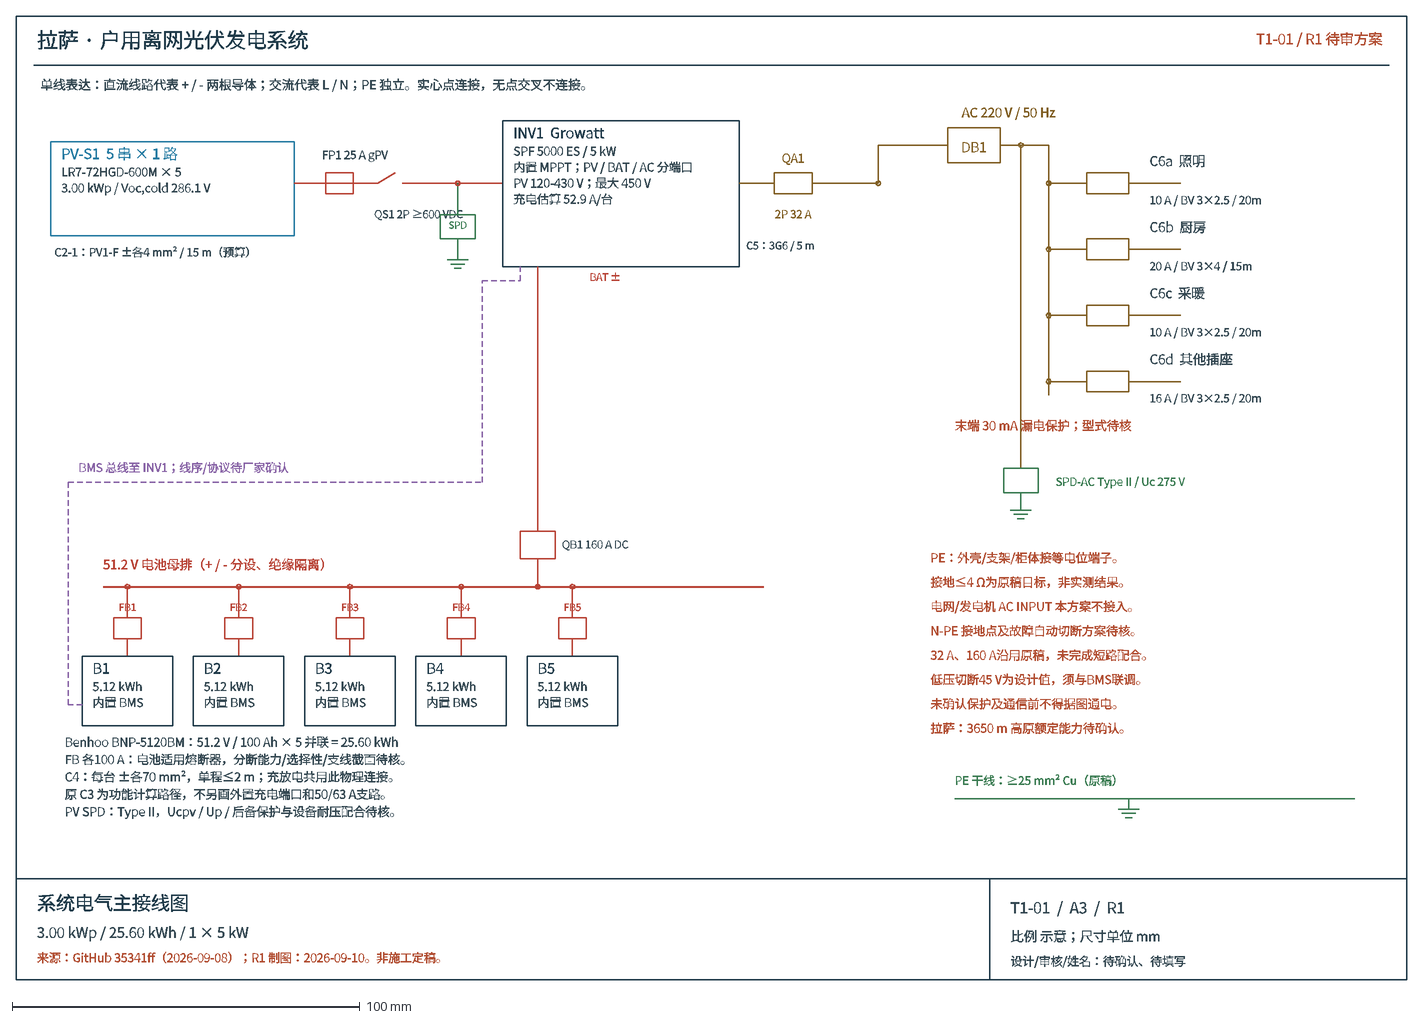
[picture p37: CAD file, 2026-09-10]
docs/updates/2026-09-10/三城光伏图纸-DXF-R1/拉萨-T1-01-系统电气主接线图-R1.dxf
拉萨 · 户用离网光伏发电系统
T1-01 / R1 待审方案
系统电气主接线图
3.00 kWp / 25.60 kWh / 1 × 5 kW
来源：GitHub 35341ff（2026-09-08）；R1 制图：2026-09-10。非施工定稿。
T1-01 / A3 / R1
比例 示意；尺寸单位 mm
设计/审核/姓名：待确认、待填写
单线表达：直流线路代表 + / - 两根导体；交流代表 L / N；PE 独立。实心点连接，无点交叉不连接。
PV-S1 5 串 × 1 路
LR7-72HGD-600M × 5
3.00 kWp / Voc,cold 286.1 V
FP1 25 A gPV
QS1 2P ≥600 VDC
C2-1：PV1-F ±各4 mm² / 15 m（预算）
SPD
INV1 Growatt
SPF 5000 ES / 5 kW
内置 MPPT；PV / BAT / AC 分端口
PV 120-430 V；最大 450 V
充电估算 52.9 A/台
QA1
2P 32 A
C5：3G6 / 5 m
QB1 160 A DC
BAT ±
DB1
AC 220 V / 50 Hz
C6a 照明
10 A / BV 3×2.5 / 20m
C6b 厨房
20 A / BV 3×4 / 15m
C6c 采暖
C6d 其他插座
16 A / BV 3×2.5 / 20m
末端 30 mA 漏电保护；型式待核
SPD-AC Type II / Uc 275 V
51.2 V 电池母排（+ / - 分设、绝缘隔离）
B1
5.12 kWh
内置 BMS
FB1
B2
FB2
B3
FB3
B4
FB4
B5
FB5
Benhoo BNP-5120BM：51.2 V / 100 Ah × 5 并联 = 25.60 kWh
FB 各100 A：电池适用熔断器，分断能力/选择性/支线截面待核。
C4：每台 ±各70 mm²，单程≤2 m；充放电共用此物理连接。
原 C3 为功能计算路径，不另画外置充电端口和50/63 A支路。
PV SPD：Type II，Ucpv / Up / 后备保护与设备耐压配合待核。
BMS 总线至 INV1；线序/协议待厂家确认
PE：外壳/支架/柜体接等电位端子。
接地≤4 Ω为原稿目标，非实测结果。
电网/发电机 AC INPUT 本方案不接入。
N-PE 接地点及故障自动切断方案待核。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
