sunny1043/offgrid-pv-course-design/docs/updates/2026-09-10/三城光伏图纸-DXF-R1/深圳-T1-03-设备间平面及安装接线图-R1.dxf

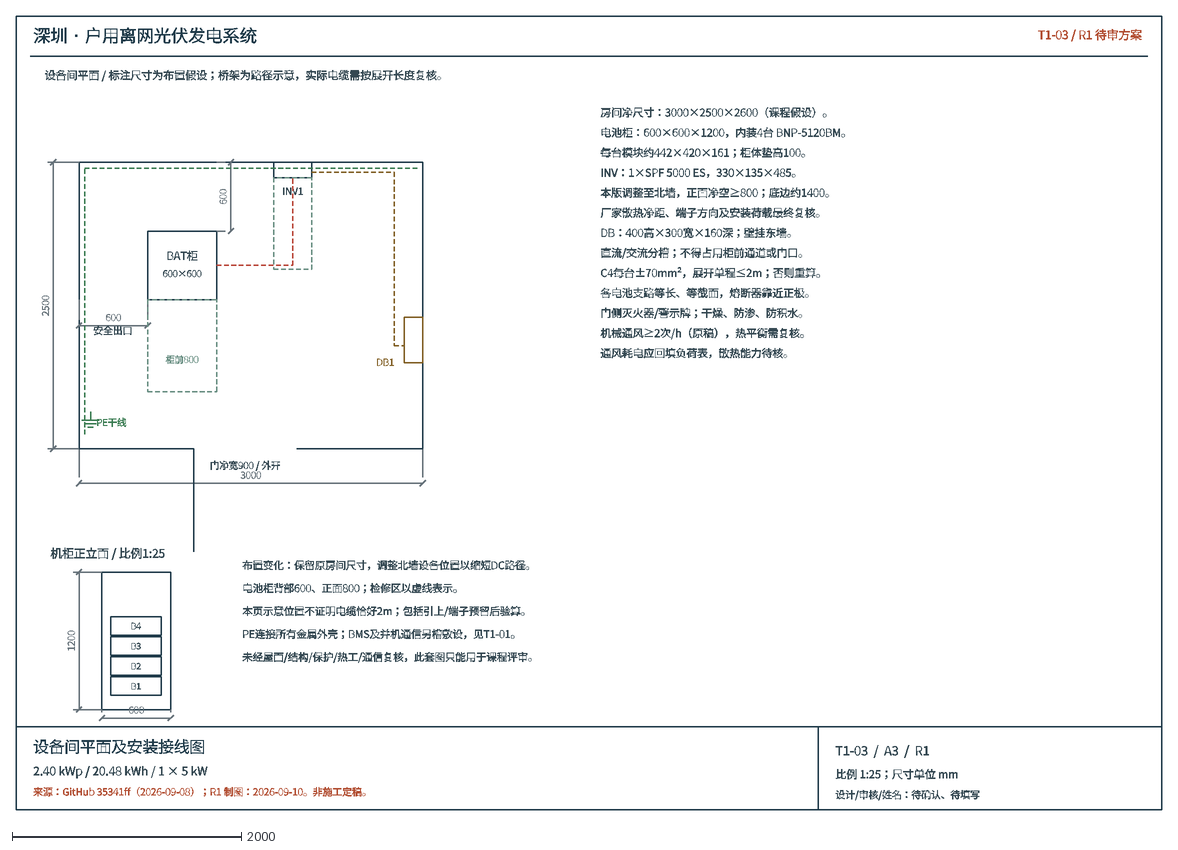
[picture p39: CAD file, 2026-09-10]
docs/updates/2026-09-10/三城光伏图纸-DXF-R1/深圳-T1-03-设备间平面及安装接线图-R1.dxf
深圳 · 户用离网光伏发电系统
T1-03 / R1 待审方案
设备间平面及安装接线图
2.40 kWp / 20.48 kWh / 1 × 5 kW
来源：GitHub 35341ff（2026-09-08）；R1 制图：2026-09-10。非施工定稿。
T1-03 / A3 / R1
比例 1:25；尺寸单位 mm
设计/审核/姓名：待确认、待填写
设备间平面 / 标注尺寸为布置假设；桥架为路径示意，实际电缆需按展开长度复核。
3000
2500
BAT柜
600×600
600
柜前800
INV1
DB1
PE干线
安全出口
门净宽900 / 外开
房间净尺寸：3000×2500×2600（课程假设）。
电池柜：600×600×1200，内装4台 BNP-5120BM。
每台模块约442×420×161；柜体垫高100。
INV：1×SPF 5000 ES，330×135×485。
本版调整至北墙，正面净空≥800；底边约1400。
厂家散热净距、端子方向及安装荷载最终复核。
DB：400高×300宽×160深；壁挂东墙。
直流/交流分槽；不得占用柜前通道或门口。
C4每台±70mm²，展开单程≤2m；否则重算。
各电池支路等长、等截面，熔断器靠近正极。
门侧灭火器/警示牌；干燥、防渗、防积水。
机械通风≥2次/h（原稿），热平衡需复核。
通风耗电应回填负荷表，散热能力待核。
机柜正立面 / 比例1:25
B1
B2
B3
B4
1200
布置变化：保留原房间尺寸，调整北墙设备位置以缩短DC路径。
电池柜背部600、正面800；检修区以虚线表示。
本页示意位置不证明电缆恰好2m；包括引上/端子预留后验算。
PE连接所有金属外壳；BMS及并机通信另槽敷设，见T1-01。
未经屋面/结构/保护/热工/通信复核，此套图只能用于课程评审。
