sunny1043/offgrid-pv-course-design/docs/updates/2026-09-10/三城光伏图纸-DXF-R1/拉萨-T1-02-光伏阵列及支架布置图-R1.dxf

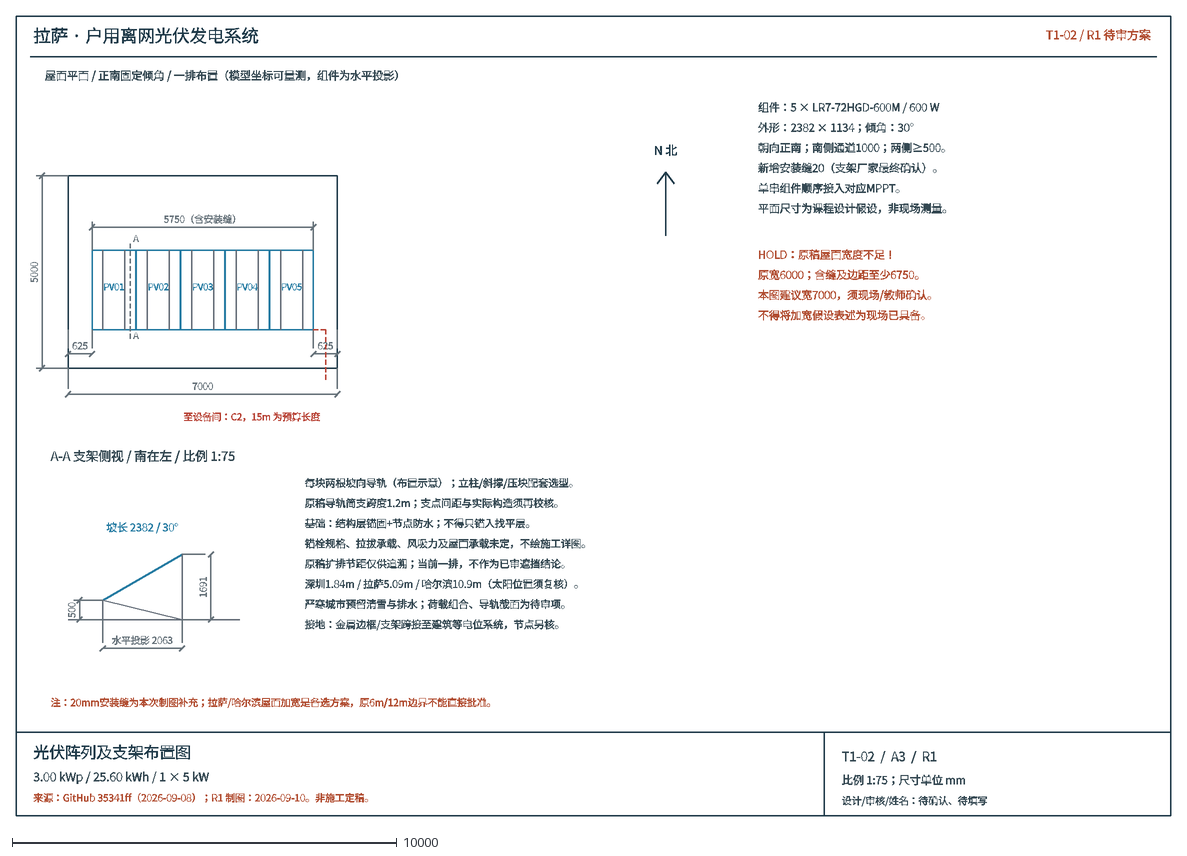
[picture p40: CAD file, 2026-09-10]
docs/updates/2026-09-10/三城光伏图纸-DXF-R1/拉萨-T1-02-光伏阵列及支架布置图-R1.dxf
拉萨 · 户用离网光伏发电系统
T1-02 / R1 待审方案
光伏阵列及支架布置图
3.00 kWp / 25.60 kWh / 1 × 5 kW
来源：GitHub 35341ff（2026-09-08）；R1 制图：2026-09-10。非施工定稿。
T1-02 / A3 / R1
比例 1:75；尺寸单位 mm
设计/审核/姓名：待确认、待填写
屋面平面 / 正南固定倾角 / 一排布置（模型坐标可量测，组件为水平投影）
PV01
PV02
PV03
PV04
PV05
A
7000
5000
5750（含安装缝）
625
至设备间：C2，15m 为预算长度
N 北
组件：5 × LR7-72HGD-600M / 600 W
外形：2382 × 1134；倾角：30°
朝向正南；南侧通道1000；两侧≥500。
新增安装缝20（支架厂家最终确认）。
单串组件顺序接入对应MPPT。
平面尺寸为课程设计假设，非现场测量。
HOLD：原稿屋面宽度不足！
原宽6000；含缝及边距至少6750。
本图建议宽7000，须现场/教师确认。
不得将加宽假设表述为现场已具备。
A-A 支架侧视 / 南在左 / 比例 1:75
500
1691
水平投影 2063
坡长 2382 / 30°
每块两根坡向导轨（布置示意）；立柱/斜撑/压块配套选型。
原稿导轨简支跨度1.2m；支点间距与实际构造须再校核。
基础：结构层锚固+节点防水；不得只锚入找平层。
锚栓规格、拉拔承载、风吸力及屋面承载未定，不绘施工详图。
原稿扩排节距仅供追溯；当前一排，不作为已审遮挡结论。
深圳1.84m / 拉萨5.09m / 哈尔滨10.9m（太阳位置须复核）。
严寒城市预留清雪与排水；荷载组合、导轨截面为待审项。
接地：金属边框/支架跨接至建筑等电位系统，节点另核。
注：20mm安装缝为本次制图补充；拉萨/哈尔滨屋面加宽是备选方案，原6m/12m边界不能直接批准。
