sunny1043/offgrid-pv-course-design/docs/drawings/T1-01-系统电气主接线图-拉萨.pdf

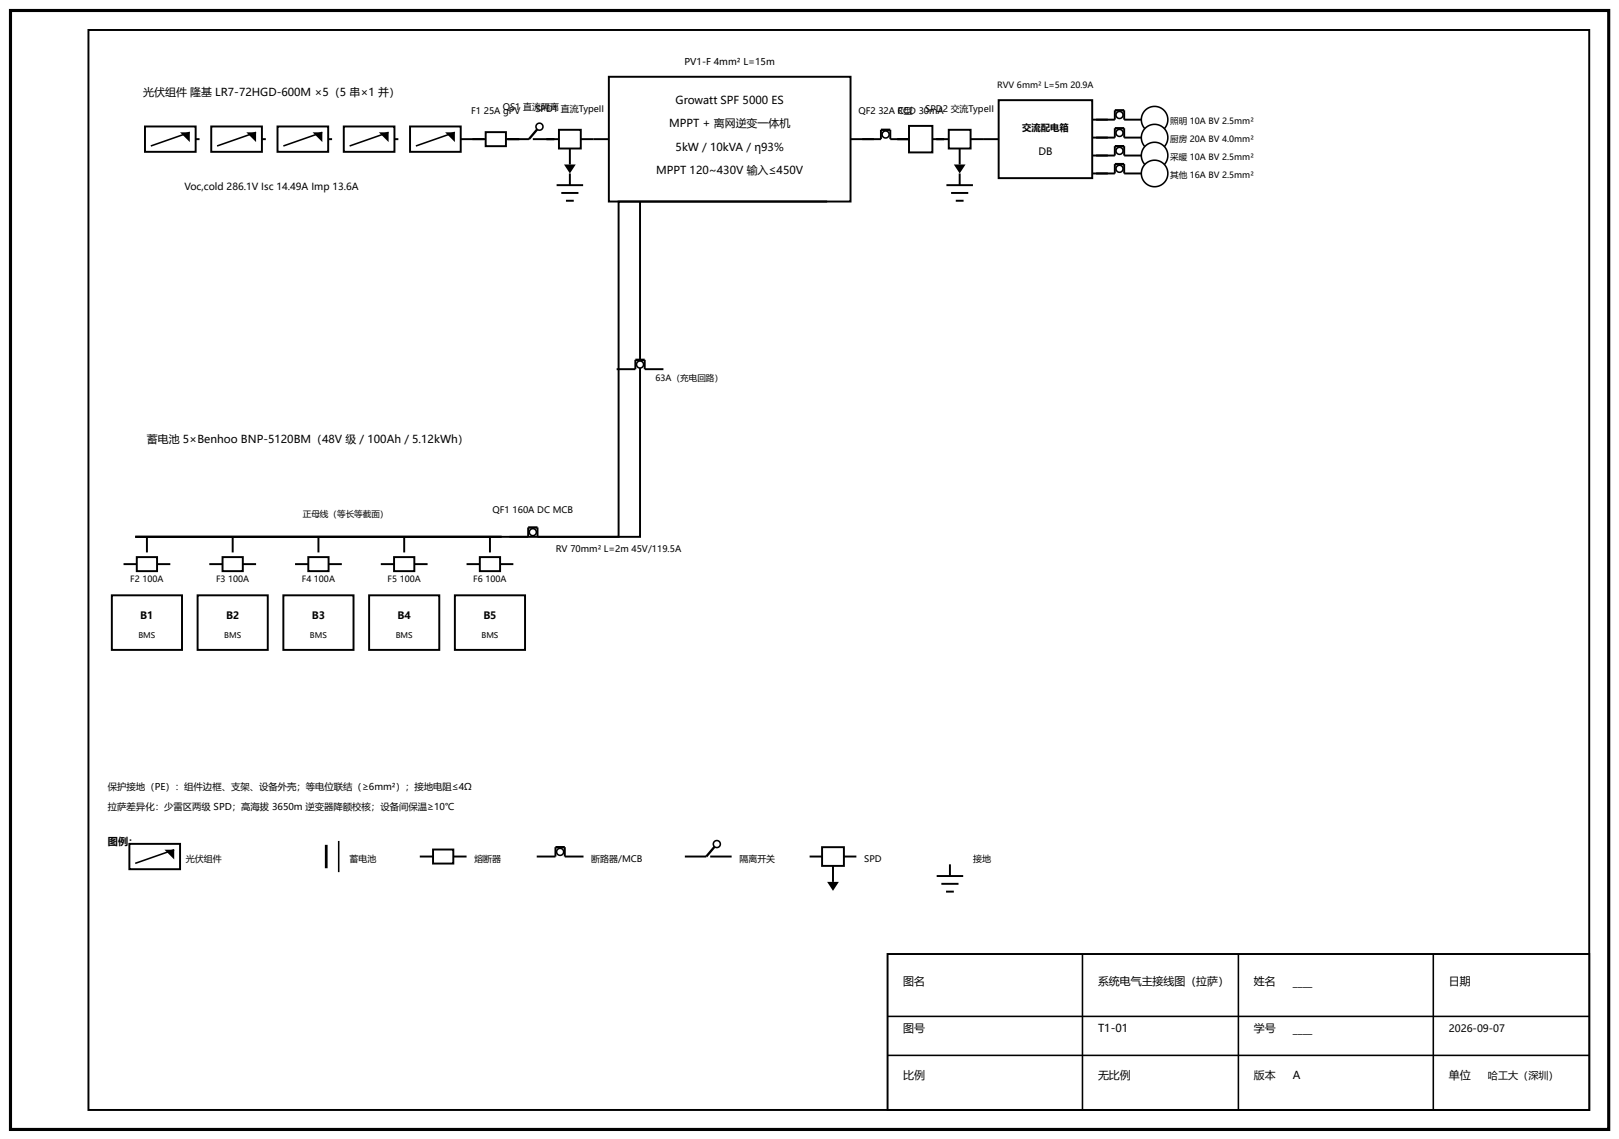
[picture p42: page 1]
系统电气主接线图（拉萨）; 无比例; 哈工大（深圳）; 光伏组件 隆基 LR7-72HGD-600M ×5（5 串×1 并）; F1 25A gPV QS1 直流SP隔D离1 直流TypeII; PV1-F 4mm² L=15m; BMS; 正母线（等长等截面）; QF1 160A DC MCB; RV 70mm² L=2m 45V/119.5A; 63A（充电回路）; QF2 32A RCC型D 30SmPDA2 交流TypeII; 交流配电箱; RVV 6mm² L=5m 20.9A; 照明 10A BV 2.5mm²; 厨房 20A BV 4.0mm²; 采暖 10A BV 2.5mm²; 其他 16A BV 2.5mm²; 光伏组件; 蓄电池; 熔断器; 断路器/MCB; 隔离开关; SPD

Growatt SPF 5000 ES
MPPT + 离网逆变一体机
5kW / 10kVA / η93%
MPPT 120~430V 输入≤450V

Voc,cold 286.1V Isc 14.49A Imp 13.6A

蓄电池 5×Benhoo BNP-5120BM（48V 级 / 100Ah / 5.12kWh）

保护接地（PE）：组件边框、支架、设备外壳；等电位联结（≥6mm²）；接地电阻≤4Ω
拉萨差异化：少雷区两级 SPD；高海拔 3650m 逆变器降额校核；设备间保温≥10℃
