sunny1043/offgrid-pv-course-design/docs/drawings/T1-02-光伏阵列及支架布置图-拉萨.pdf

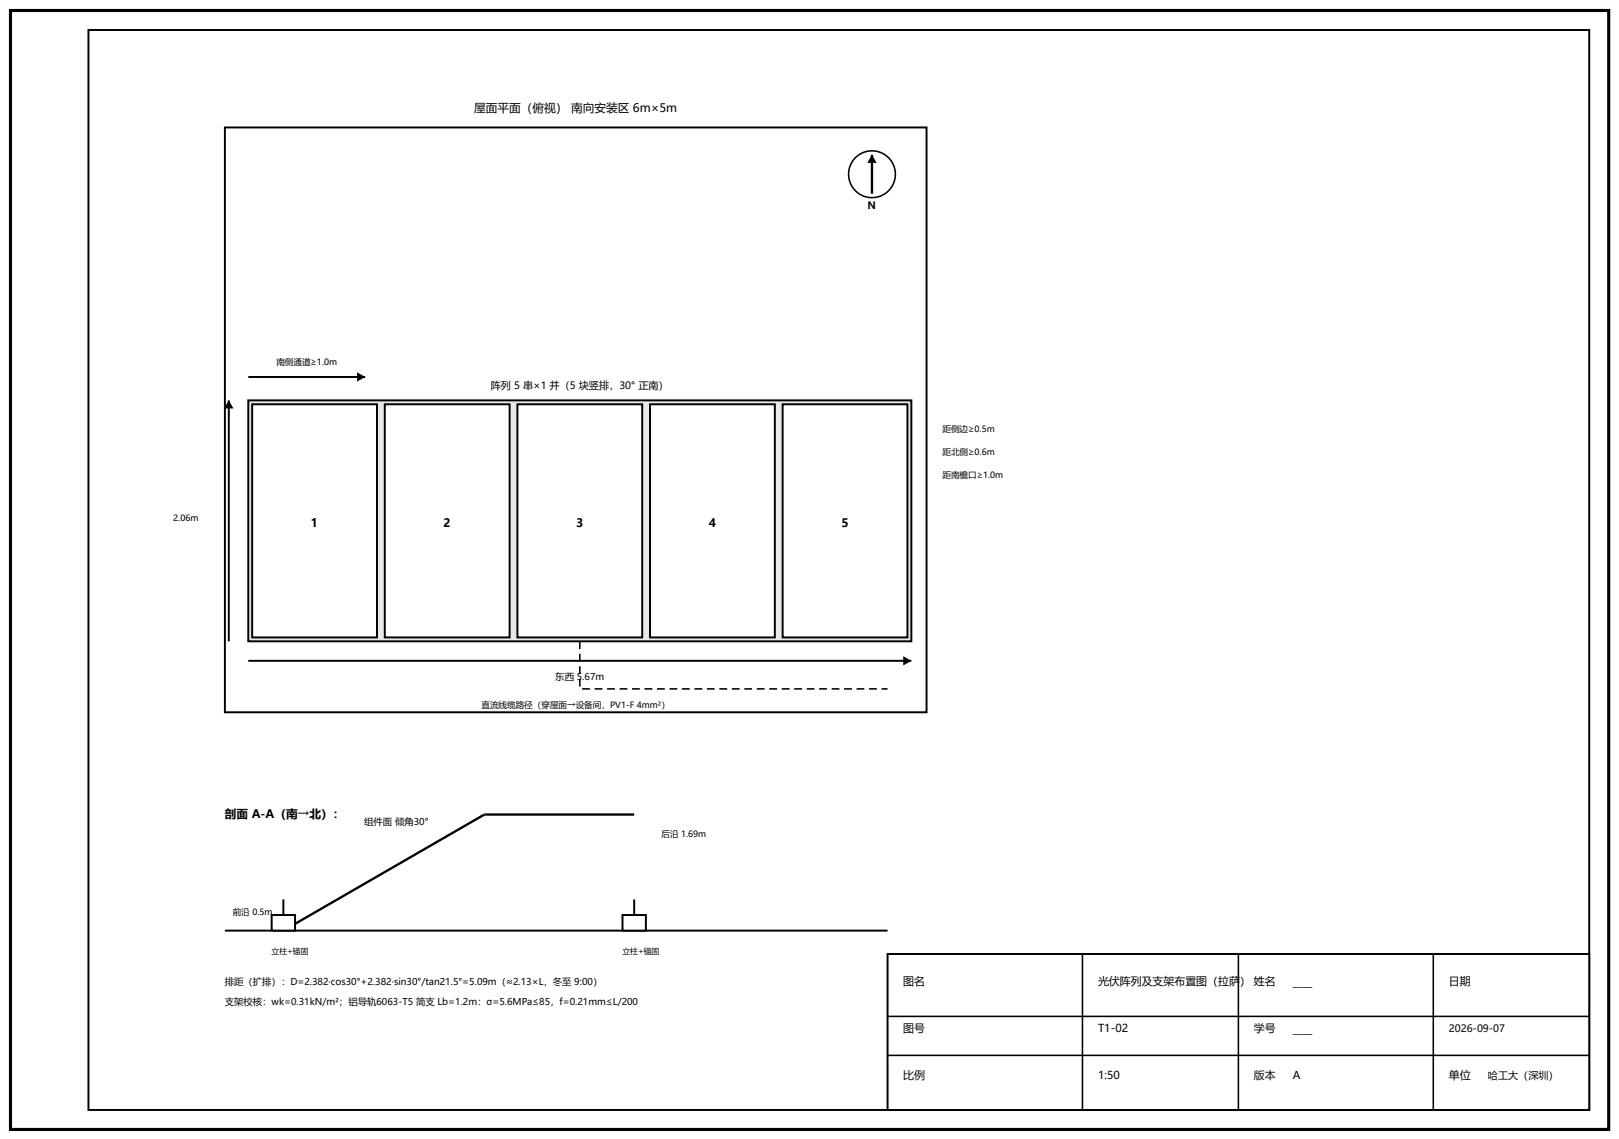
[picture p43: page 1]
光伏阵列及支架布置图（拉萨）; 哈工大（深圳）; 南侧通道≥1.0m; 距侧边≥0.5m; 距北侧≥0.6m; 距南檐口≥1.0m; 组件面 倾角30°

屋面平面（俯视） 南向安装区 6m×5m

阵列 5 串×1 并（5 块竖排，30° 正南）

直流线缆路径（穿屋面→设备间，PV1-F 4mm²）

排距（扩排）：D=2.382·cos30°+2.382·sin30°/tan21.5°=5.09m（≈2.13×L，冬至 9:00）
支架校核：wk=0.31kN/m²；铝导轨6063-T5 简支 Lb=1.2m：σ=5.6MPa≤85，f=0.21mm≤L/200
