sunny1043/offgrid-pv-course-design/docs/drawings/T1-01-系统电气主接线图-哈尔滨.pdf

# 户用离网光伏发电系统——系统电气主接线图

## 拉萨/兰州/哈尔滨差异化设计（哈尔滨） · A3

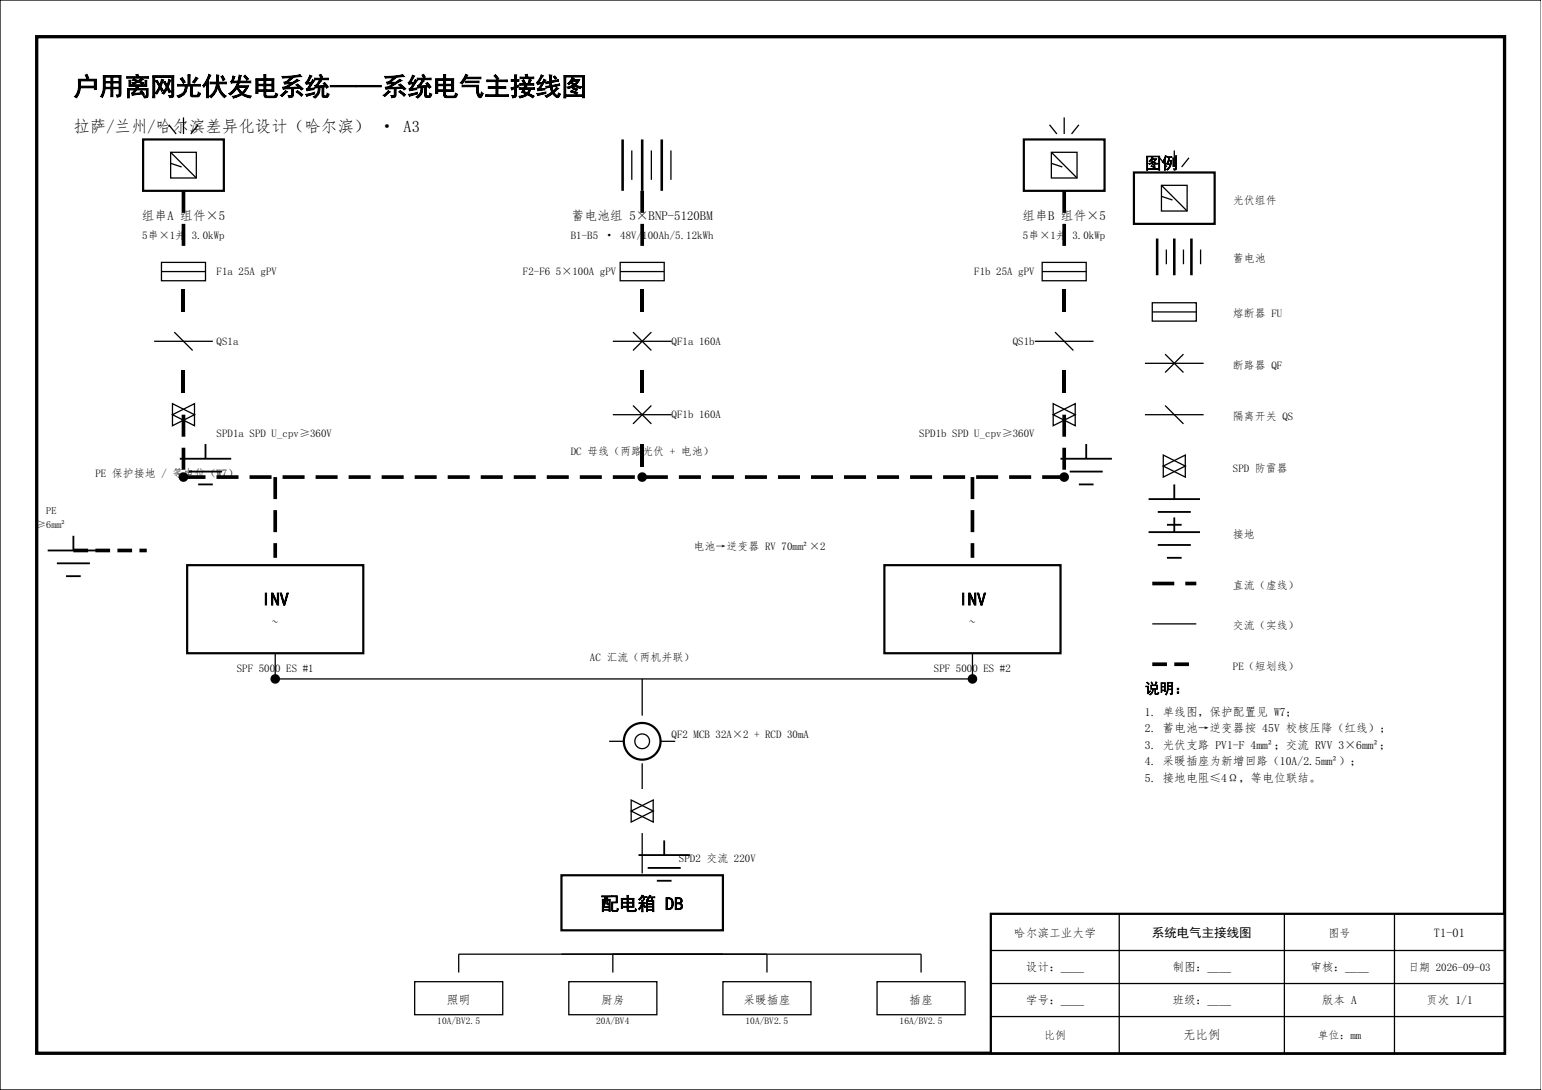
[picture p45: page 1]
哈尔滨工业大学; 系统电气主接线图; 无比例; 组串A 组件×5; 3.0kWp; F1a 25A gPV; SPD1a SPD U_cpv≥360V; 组串B 组件×5; 5串×1并 3.0kWp; F1b 25A gPV; SPD1b SPD U_cpv≥360V; 蓄电池组 5×BNP-5120BM; B1-B5 · 48V/100Ah/5.12kWh; F2-F6 5×100A gPV; INV; SPF 5000 ES #1; SPF 5000 ES #2; QF2 MCB 32A×2 + RCD 30mA; SPD2 交流 220V; 配电箱 DB; 采暖插座; PE ≥6mm²; 光伏组件; 蓄电池; 熔断器 FU; 断路器 QF; 隔离开关 QS; SPD 防雷器; PE（短划线）

DC 母线（两路光伏 + 电池）

PE 保护接地 / 等电位（W7）

电池→逆变器 RV 70mm²×2

AC 汇流（两机并联）

1. 单线图，保护配置见 W7；
2. 蓄电池→逆变器按 45V 校核压降（红线）；
3. 光伏支路 PV1-F 4mm²；交流 RVV 3×6mm²；
4. 采暖插座为新增回路（10A/2.5mm²）；
5. 接地电阻≤4Ω，等电位联结。
