sunny1043/offgrid-pv-course-design/docs/drawings/T1-02-光伏阵列及支架布置图-兰州.pdf

# 户用离网光伏发电系统——光伏阵列及支架布置图

## 拉萨/兰州/哈尔滨差异化设计（兰州） · A3

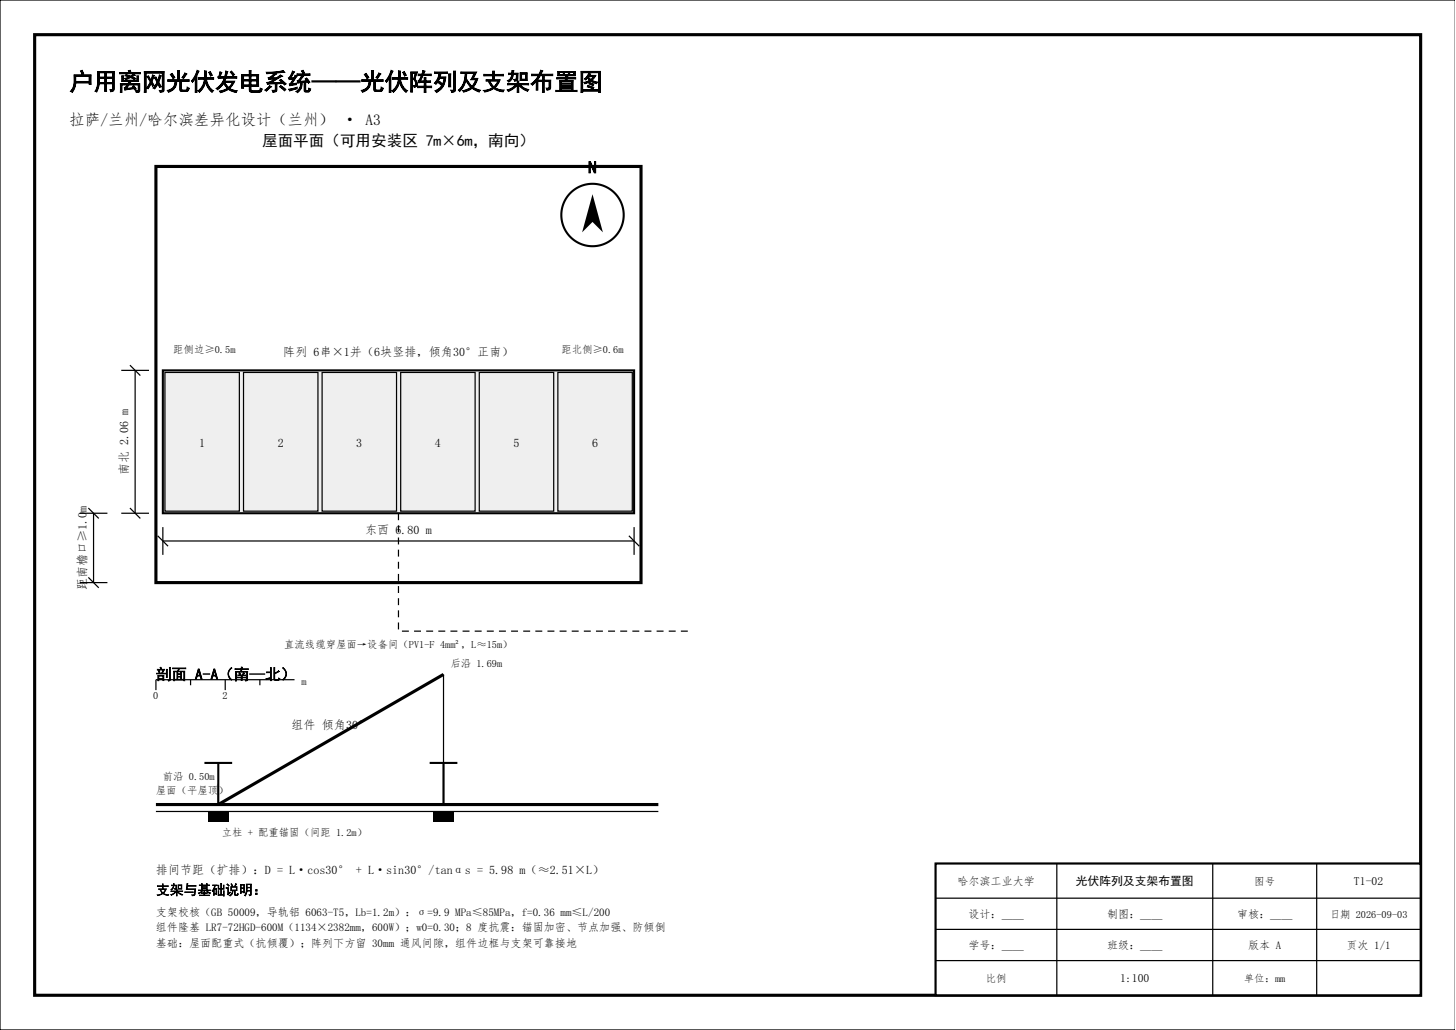
[picture p46: page 1]
哈尔滨工业大学; 光伏阵列及支架布置图; 阵列 6串×1并（6块竖排，倾角30°正南）; 距侧边≥0.5m; 距北侧≥0.6m; 直流线缆穿屋面→设备间（PV1-F 4mm²，L≈15m）; 屋面（平屋顶）

屋面平面（可用安装区 7m×6m，南向）

立柱 + 配重锚固（间距 1.2m）

排间节距（扩排）：D = L·cos30° + L·sin30°/tanαs = 5.98 m（≈2.51×L）
支架与基础说明：

支架校核（GB 50009，导轨铝 6063-T5，Lb=1.2m）：σ=9.9 MPa≤85MPa，f=0.36 mm≤L/200
组件隆基 LR7-72HGD-600M（1134×2382mm，600W）；w0=0.30；8 度抗震：锚固加密、节点加强、防倾倒
基础：屋面配重式（抗倾覆）；阵列下方留 30mm 通风间隙，组件边框与支架可靠接地
