sunny1043/offgrid-pv-course-design/docs/drawings/T1-02-光伏阵列及支架布置图-哈尔滨.pdf

# 户用离网光伏发电系统——光伏阵列及支架布置图

## 拉萨/兰州/哈尔滨差异化设计（哈尔滨） · A3

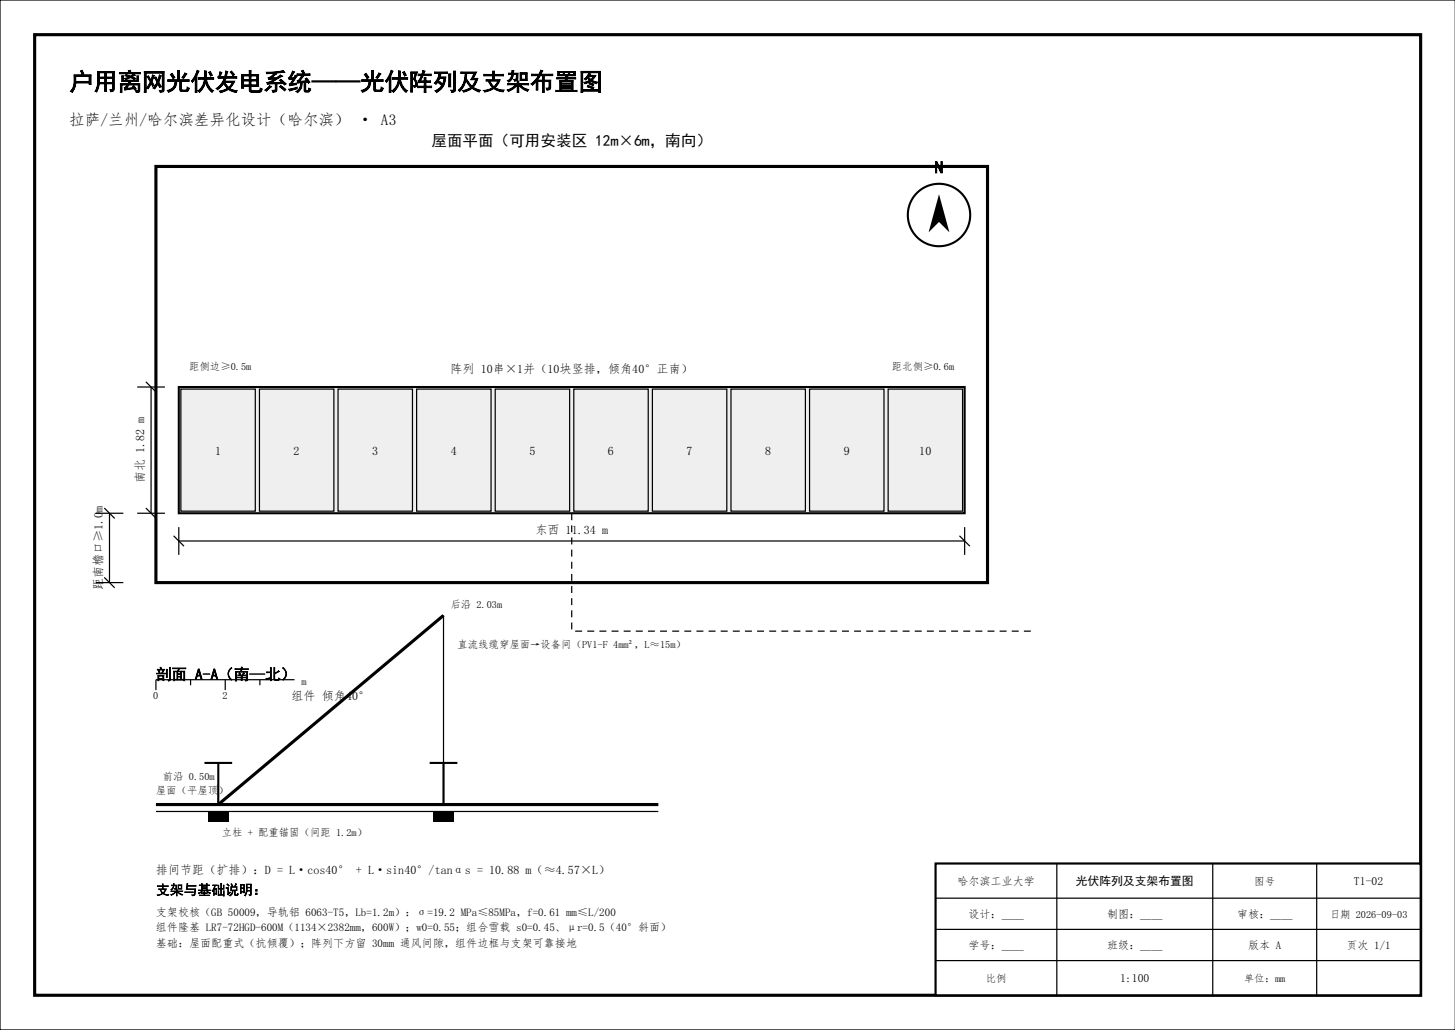
[picture p47: page 1]
哈尔滨工业大学; 光伏阵列及支架布置图; 阵列 10串×1并（10块竖排，倾角40°正南）; 距侧边≥0.5m; 距北侧≥0.6m; 直流线缆穿屋面→设备间（PV1-F 4mm²，L≈15m）; 屋面（平屋顶）

屋面平面（可用安装区 12m×6m，南向）

立柱 + 配重锚固（间距 1.2m）

排间节距（扩排）：D = L·cos40° + L·sin40°/tanαs = 10.88 m（≈4.57×L）
支架与基础说明：

支架校核（GB 50009，导轨铝 6063-T5，Lb=1.2m）：σ=19.2 MPa≤85MPa，f=0.61 mm≤L/200
组件隆基 LR7-72HGD-600M（1134×2382mm，600W）；w0=0.55；组合雪载 s0=0.45、μr=0.5（40°斜面）
基础：屋面配重式（抗倾覆）；阵列下方留 30mm 通风间隙，组件边框与支架可靠接地
