sunny1043/offgrid-pv-course-design/docs/drawings/T1-01-系统电气主接线图.pdf

## PV1-F 4mm² L=15m Growatt SPF 5000 ES

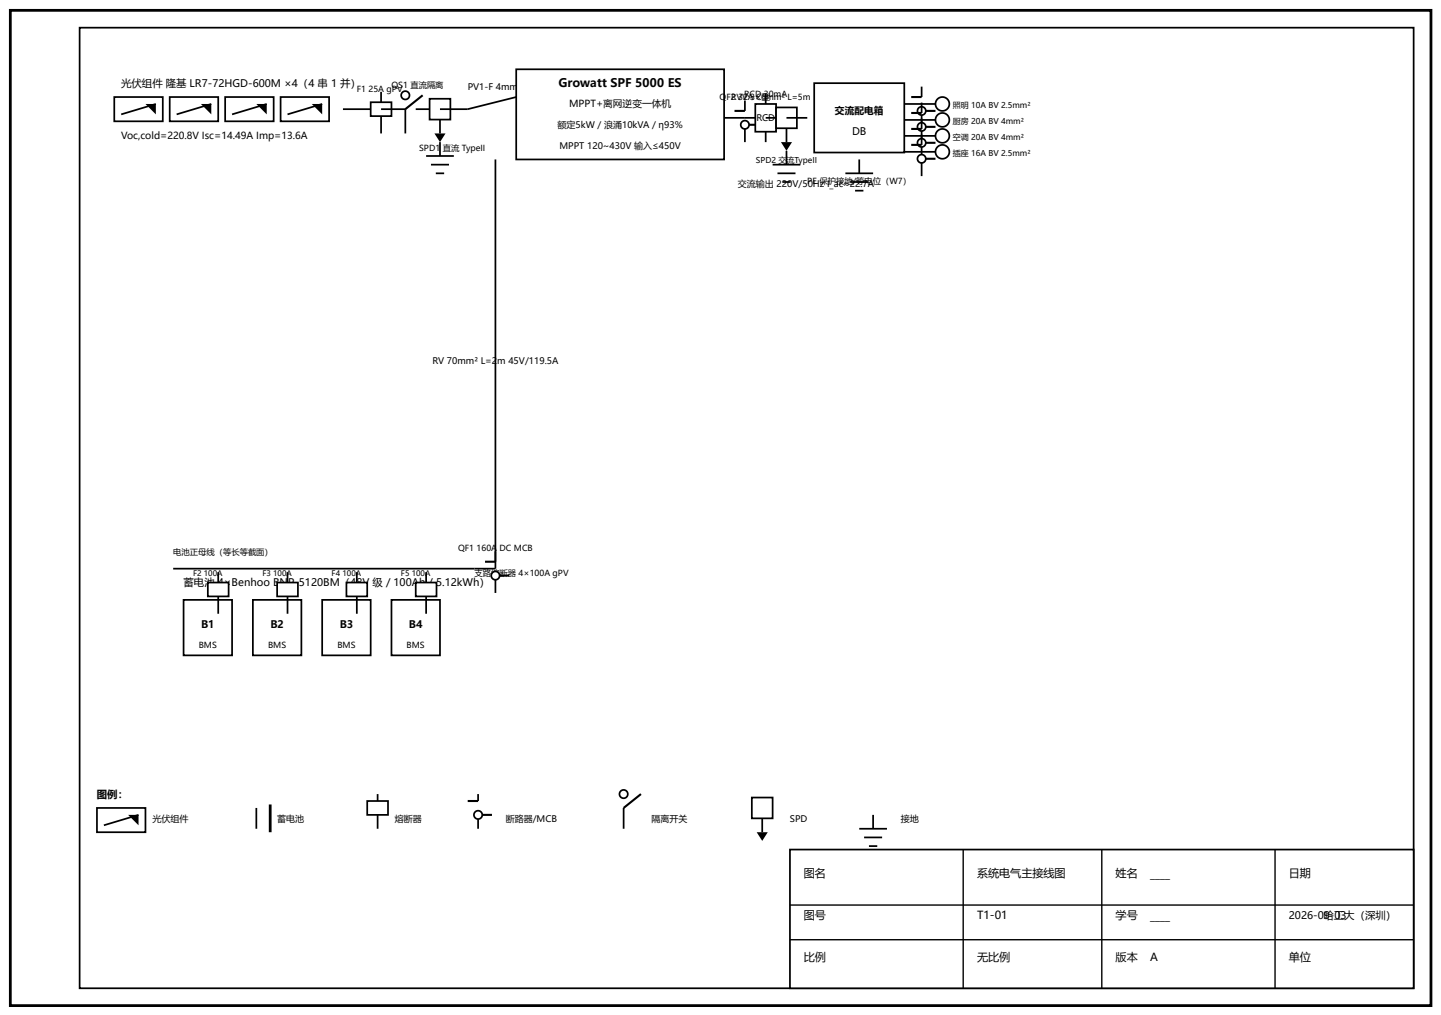
[picture p48: page 1]
系统电气主接线图; 无比例; 哈工大（深圳）; 光伏组件 隆基 LR7-72HGD-600M ×4（4 串 1 并） F1 25A gPVQS1 直流隔离; SPD1 直流 TypeII; MPPT+离网逆变一体机; 额定5kW / 浪涌10kVA / η93%; MPPT 120~430V 输入≤450V; 交流输出 220V/50Hz I_ac≈22.7A; BMS; 支路熔断器 4×100A gPV; 电池正母线（等长等截面）; QF1 160A DC MCB; RV 70mm² L=2m 45V/119.5A; RCD; RCD 30mA; SPD2 交流TypeII; RVV 3×6mm² L=5m; 交流配电箱; 照明 10A BV 2.5mm²; 厨房 20A BV 4mm²; 空调 20A BV 4mm²; 插座 16A BV 2.5mm²; 光伏组件; 蓄电池; 熔断器; 断路器/MCB; 隔离开关; SPD

Voc,cold=220.8V Isc=14.49A Imp=13.6A

PE 保护接地/等电位（W7）

蓄电池 4×Benhoo BNP-5120BM（48V 级 / 100Ah / 5.12kWh）
