sunny1043/offgrid-pv-course-design/docs/drawings/T1-02-光伏阵列及支架布置图.pdf

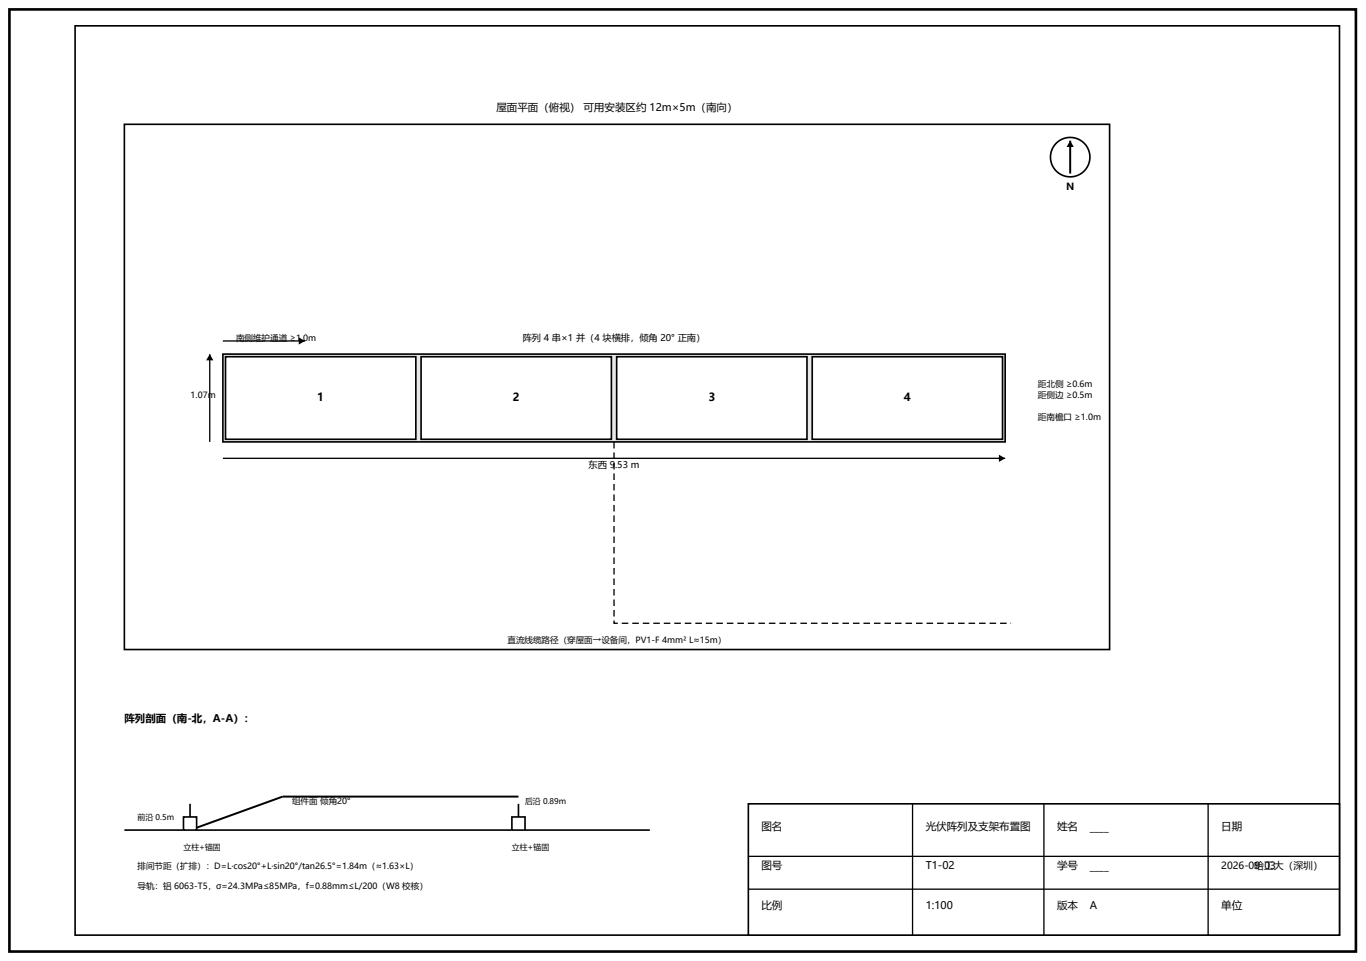
[picture p49: page 1]
光伏阵列及支架布置图; 哈工大（深圳）; 南侧维护通道 ≥1.0m; 距侧边 ≥0.5m; 距北侧 ≥0.6m; 距南檐口 ≥1.0m; 阵列剖面（南-北，A-A）：; 组件面 倾角20°; 排间节距（扩排）：D=L·cos20°+L·sin20°/tan26.5°=1.84m（≈1.63×L）; 导轨：铝 6063-T5，σ=24.3MPa≤85MPa，f=0.88mm≤L/200（W8 校核）

屋面平面（俯视） 可用安装区约 12m×5m（南向）

阵列 4 串×1 并（4 块横排，倾角 20° 正南）

直流线缆路径（穿屋面→设备间，PV1-F 4mm² L≈15m）
