sunny1043/offgrid-pv-course-design/docs/updates/2026-09-10/兰州光伏图纸-R0/E-01-系统电气原理与接线图-R0.pdf

兰州 · 户用离网光伏发电系统 | E-01 / R0 课程设计初稿

## INV1 德业一体机

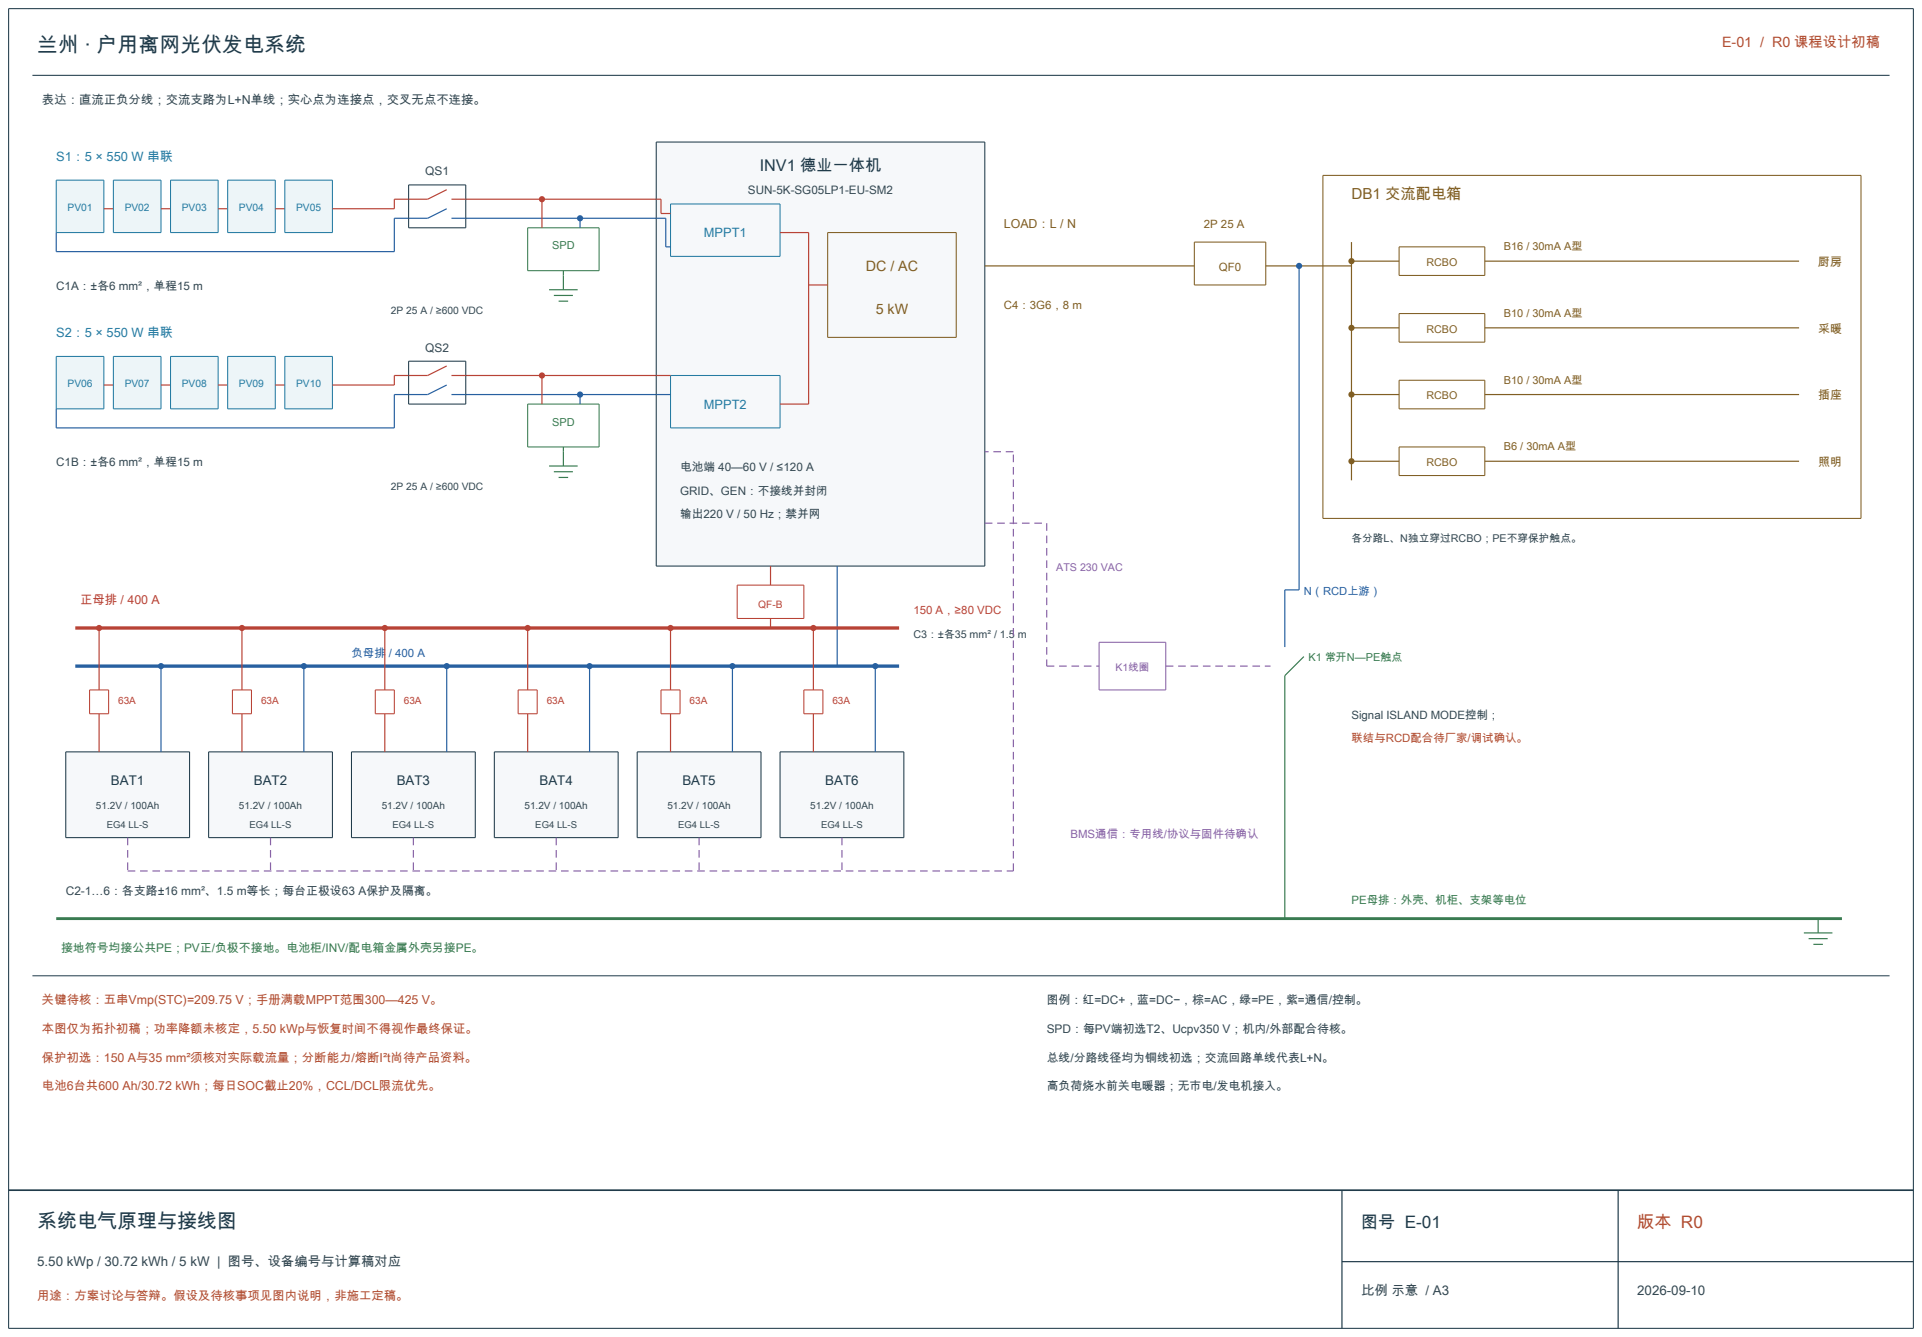
[picture p50: page 1]
2P 25 A / ≥600 VDC; SPD; C1A：±各6 mm²，单程15 m; C1B：±各6 mm²，单程15 m; SUN-5K-SG05LP1-EU-SM2; MPPT1; MPPT2; 电池端 40—60 V / ≤120 A; 输出220 V / 50 Hz；禁并网; LOAD：L / N; DB1 交流配电箱; RCBO; N（RCD上游）; K1 常开N—PE触点; ATS 230 VAC; 联结与RCD配合待厂家/调试确认。; 正母排 / 400 A; 负母排 / 400 A; 150 A，≥80 VDC; C3：±各35 mm² / 1.5 m; BAT1; BAT2; BAT3; BAT4; BAT5; BAT6; C2-1…6：各支路±16 mm²、1.5 m等长；每台正极设63 A保护及隔离。; PE母排：外壳、机柜、支架等电位

表达：直流正负分线；交流支路为L+N单线；实心点为连接点，交叉无点不连接。

GRID、GEN：不接线并封闭

各分路L、N独立穿过RCBO；PE不穿保护触点。

Signal ISLAND MODE控制；

BMS通信：专用线/协议与固件待确认

接地符号均接公共PE；PV正/负极不接地。电池柜/INV/配电箱金属外壳另接PE。

关键待核：五串Vmp(STC)=209.75 V；手册满载MPPT范围300—425 V。

本图仅为拓扑初稿；功率降额未核定，5.50 kWp与恢复时间不得视作最终保证。

SPD：每PV端初选T2、Ucpv350 V；机内/外部配合待核。

保护初选：150 A与35 mm²须核对实际载流量；分断能力/熔断I²t尚待产品资料。

总线/分路线径均为铜线初选；交流回路单线代表L+N。

电池6台共600 Ah/30.72 kWh；每日SOC截止20%，CCL/DCL限流优先。

高负荷烧水前关电暖器；无市电/发电机接入。

系统电气原理与接线图 5.50 kWp / 30.72 kWh / 5 kW | 图号、设备编号与计算稿对应 用途：方案讨论与答辩。假设及待核事项见图内说明，非施工定稿。 | 图号 E-01 | 版本 R0
