sunny1043/offgrid-pv-course-design/docs/updates/2026-09-10/兰州光伏图纸-R0/M-02-设备间平面及安装接线图-R0.pdf

兰州 · 户用离网光伏发电系统 | M-02 / R0 课程设计初稿

### 设备间平面 1:20 | 西南角为坐标原点

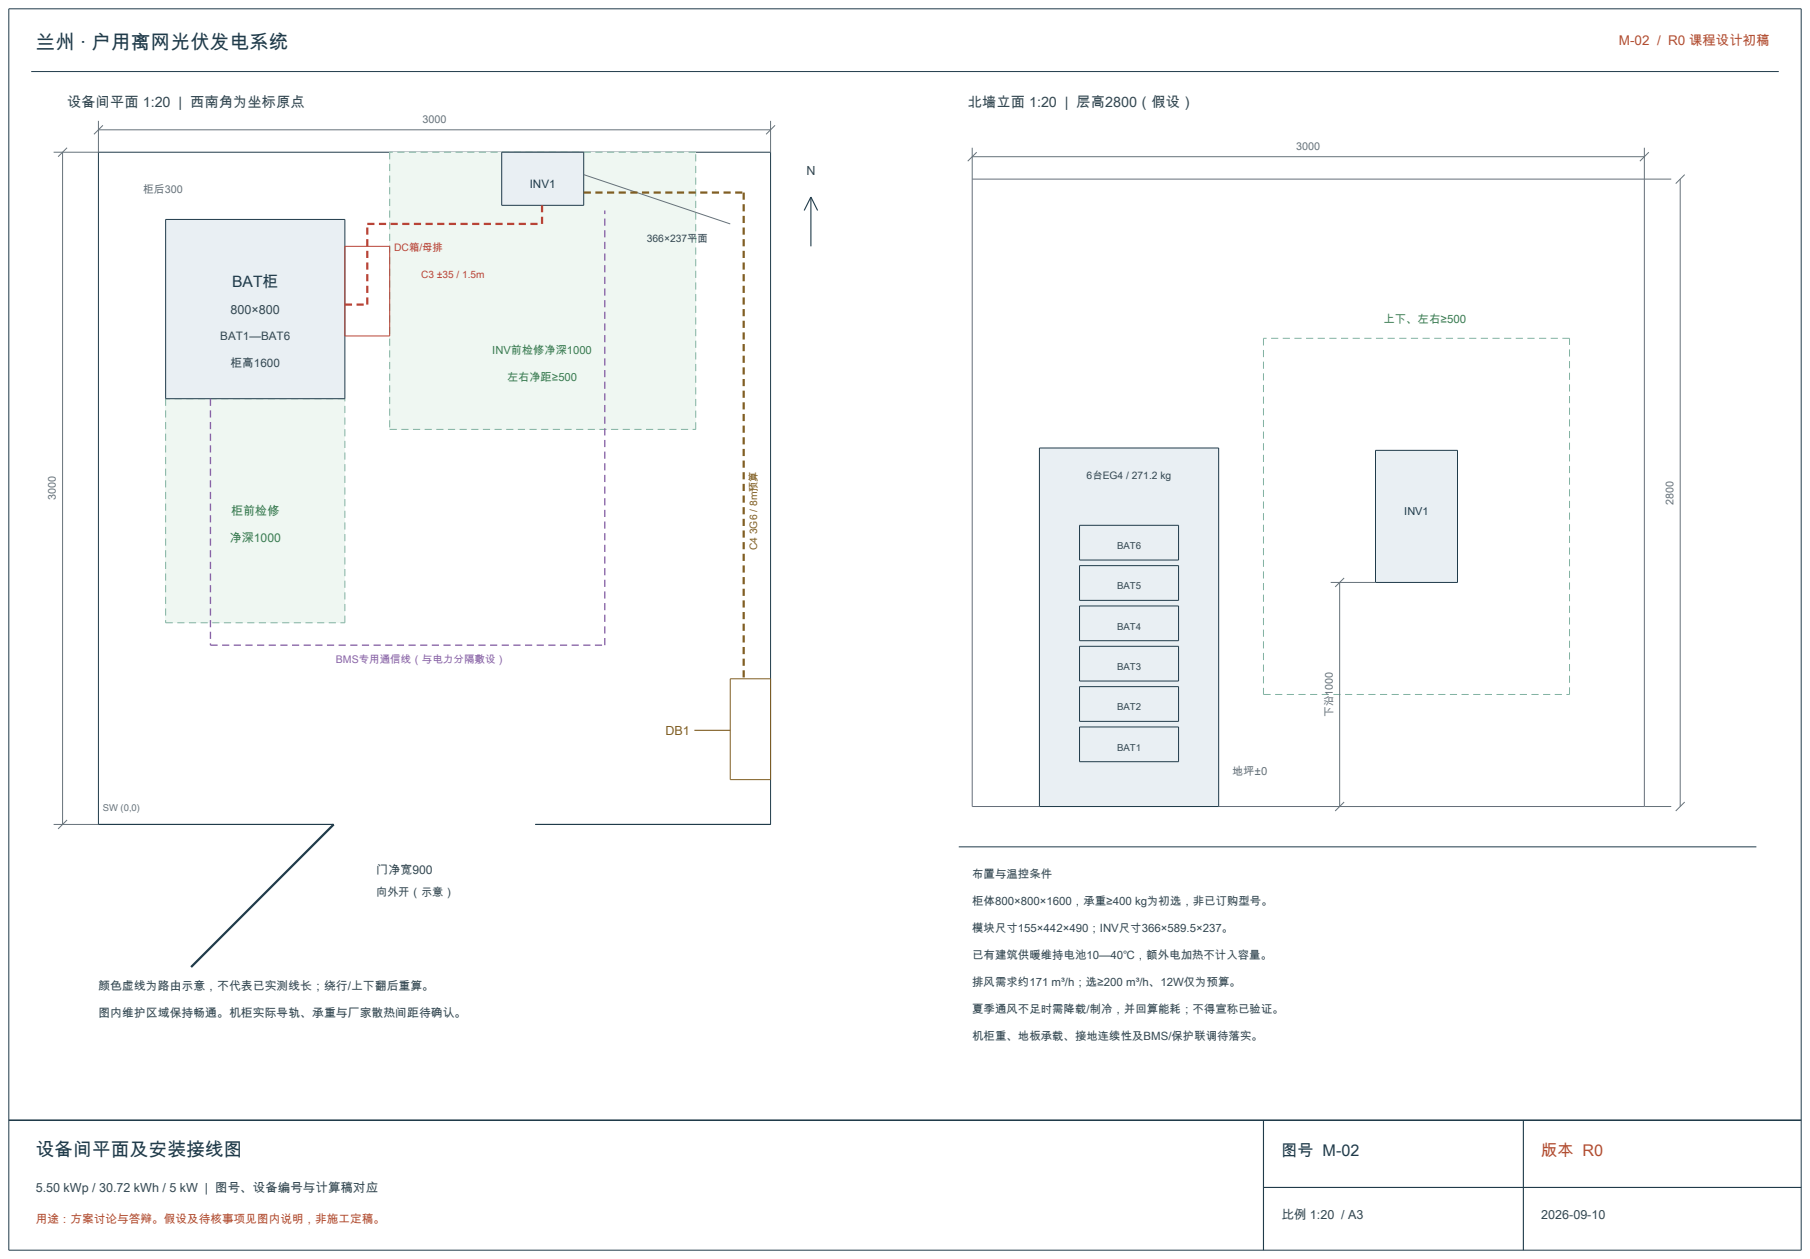
[picture p51: page 1]
门净宽900; 向外开（示意）; 柜前检修; INV前检修净深1000; 左右净距≥500; BAT柜; BAT1—BAT6; INV1; DC箱/母排; C4 3G6 / 8m预算; BMS专用通信线（与电力分隔敷设）; 北墙立面 1:20 | 层高2800（假设）; BAT1; BAT2; BAT3; BAT4; BAT5; BAT6; 6台EG4 / 271.2 kg; 布置与温控条件; 模块尺寸155×442×490；INV尺寸366×589.5×237。; 已有建筑供暖维持电池10—40℃，额外电加热不计入容量。; 排风需求约171 m³/h；选≥200 m³/h、12W仅为预算。

柜体800×800×1600，承重≥400 kg为初选，非已订购型号。

颜色虚线为路由示意，不代表已实测线长；绕行/上下翻后重算。

图内维护区域保持畅通。机柜实际导轨、承重与厂家散热间距待确认。

夏季通风不足时需降载/制冷，并回算能耗；不得宣称已验证。

机柜重、地板承载、接地连续性及BMS/保护联调待落实。

设备间平面及安装接线图 5.50 kWp / 30.72 kWh / 5 kW | 图号、设备编号与计算稿对应 用途：方案讨论与答辩。假设及待核事项见图内说明，非施工定稿。 | 图号 M-02 | 版本 R0
