sunny1043/offgrid-pv-course-design/docs/updates/2026-09-10/兰州光伏图纸-R0/兰州光伏-三张图纸-R0.pdf

兰州 · 户用离网光伏发电系统 | E-01 / R0 课程设计初稿

### DB1 交流配电箱

2P 25 A / ≥600 VDC; SPD; C1A：±各6 mm²，单程15 m; C1B：±各6 mm²，单程15 m; INV1 德业一体机; SUN-5K-SG05LP1-EU-SM2; MPPT1; MPPT2; 电池端 40—60 V / ≤120 A; 输出220 V / 50 Hz；禁并网; LOAD：L / N; RCBO; N（RCD上游）; K1 常开N—PE触点; ATS 230 VAC; 联结与RCD配合待厂家/调试确认。; 正母排 / 400 A; 负母排 / 400 A; 150 A，≥80 VDC; C3：±各35 mm² / 1.5 m; BAT1; BAT2; BAT3; BAT4; BAT5; BAT6; C2-1…6：各支路±16 mm²、1.5 m等长；每台正极设63 A保护及隔离。; PE母排：外壳、机柜、支架等电位

表达：直流正负分线；交流支路为L+N单线；实心点为连接点，交叉无点不连接。

GRID、GEN：不接线并封闭

各分路L、N独立穿过RCBO；PE不穿保护触点。

Signal ISLAND MODE控制；

BMS通信：专用线/协议与固件待确认

接地符号均接公共PE；PV正/负极不接地。电池柜/INV/配电箱金属外壳另接PE。

关键待核：五串Vmp(STC)=209.75 V；手册满载MPPT范围300—425 V。

本图仅为拓扑初稿；功率降额未核定，5.50 kWp与恢复时间不得视作最终保证。

SPD：每PV端初选T2、Ucpv350 V；机内/外部配合待核。

保护初选：150 A与35 mm²须核对实际载流量；分断能力/熔断I²t尚待产品资料。

总线/分路线径均为铜线初选；交流回路单线代表L+N。

电池6台共600 Ah/30.72 kWh；每日SOC截止20%，CCL/DCL限流优先。

高负荷烧水前关电暖器；无市电/发电机接入。

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

兰州 · 户用离网光伏发电系统 | M-01 / R0 课程设计初稿

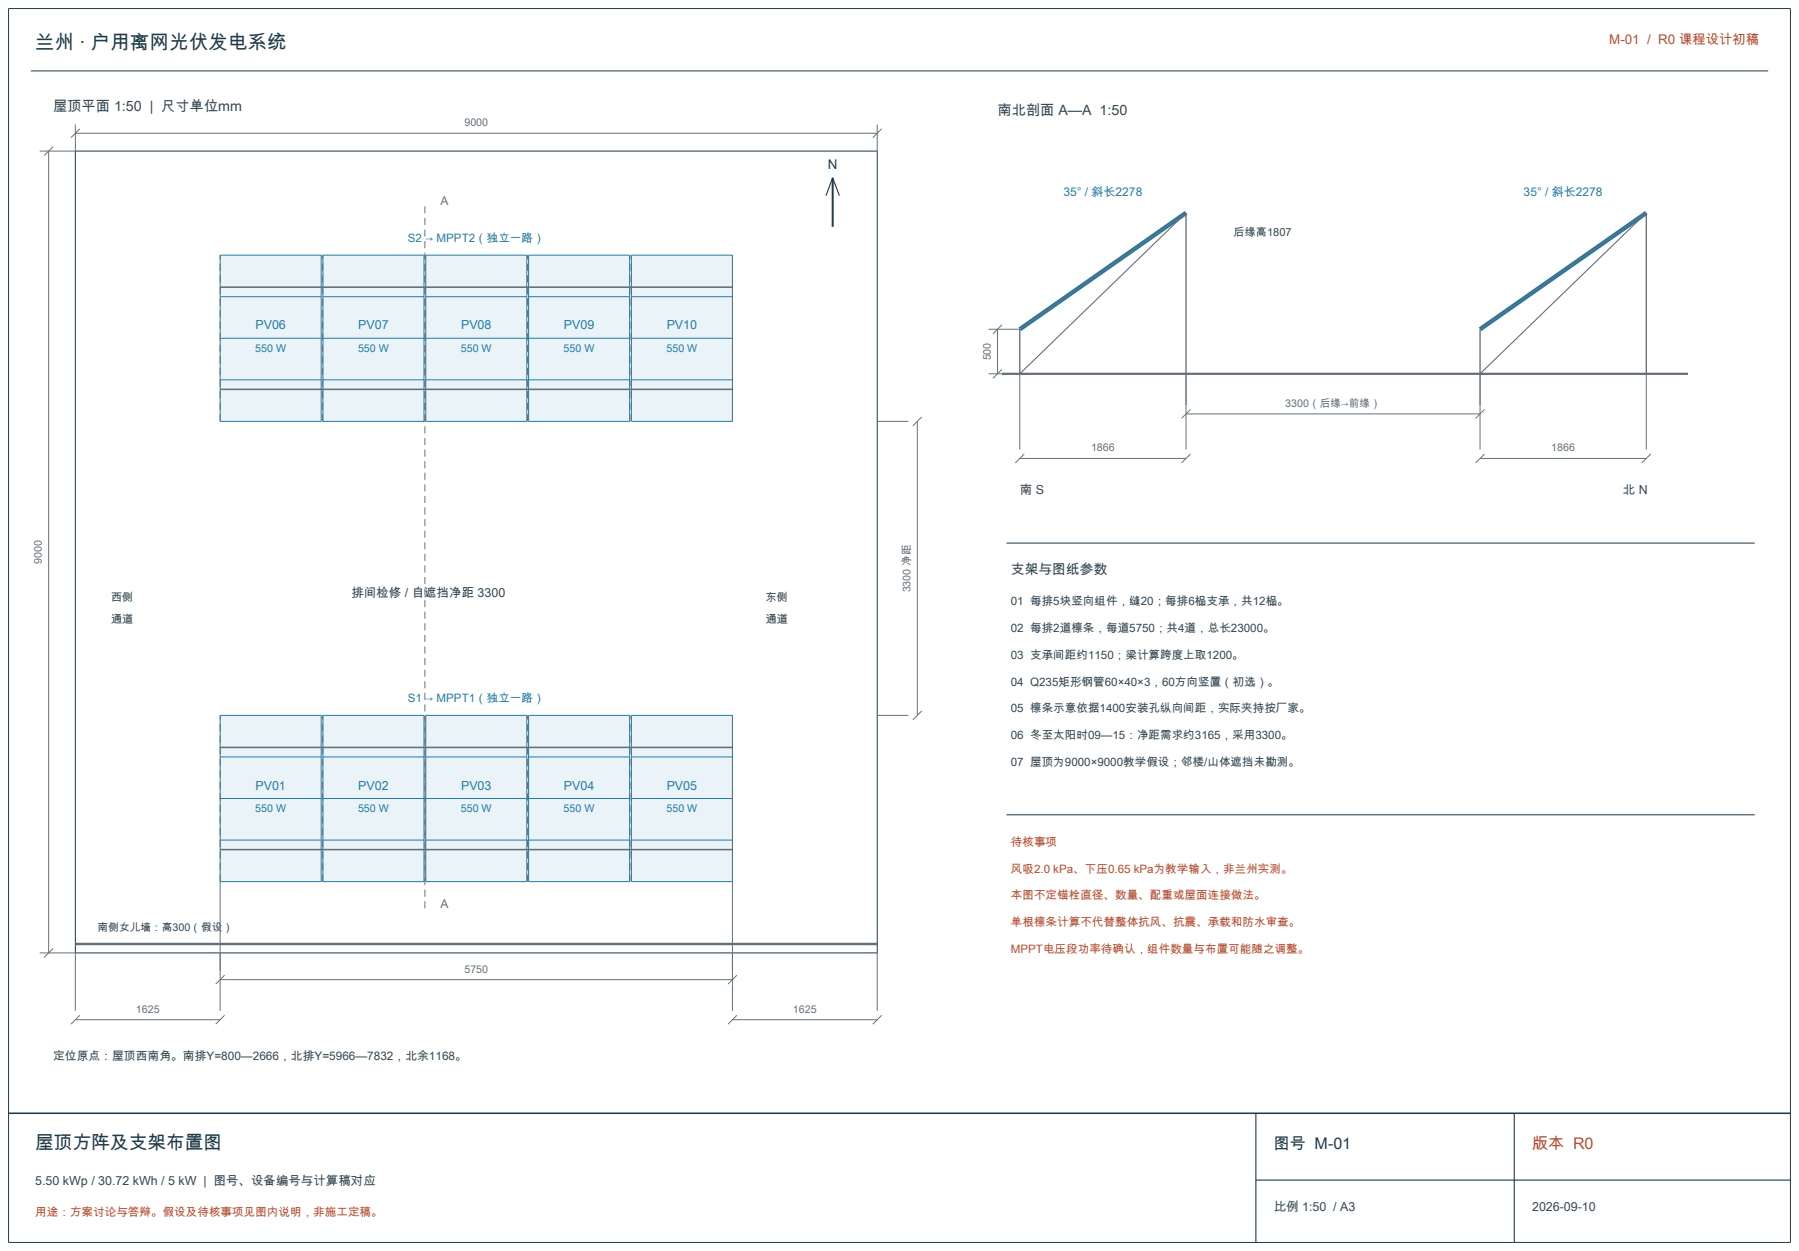
[picture p52: page 2]
屋顶平面 1:50 | 尺寸单位mm; S1 → MPPT1（独立一路）; S2 → MPPT2（独立一路）; 排间检修 / 自遮挡净距 3300; 南侧女儿墙：高300（假设）; 南北剖面 A—A 1:50; 后缘高1807; 支架与图纸参数; 01 每排5块竖向组件，缝20；每排6榀支承，共12榀。; 02 每排2道檩条，每道5750；共4道，总长23000。; 03 支承间距约1150；梁计算跨度上取1200。; 04 Q235矩形钢管60×40×3，60方向竖置（初选）。; 05 檩条示意依据1400安装孔纵向间距，实际夹持按厂家。; 06 冬至太阳时09—15：净距需求约3165，采用3300。; 07 屋顶为9000×9000教学假设；邻楼/山体遮挡未勘测。; 待核事项; MPPT电压段功率待确认，组件数量与布置可能随之调整。

风吸2.0 kPa、下压0.65 kPa为教学输入，非兰州实测。

本图不定锚栓直径、数量、配重或屋面连接做法。

单根檩条计算不代替整体抗风、抗震、承载和防水审查。

定位原点：屋顶西南角。南排Y=800—2666，北排Y=5966—7832，北余1168。

屋顶方阵及支架布置图 | 图号 M-01 | 版本 R0

兰州 · 户用离网光伏发电系统 | M-02 / R0 课程设计初稿

### 设备间平面 1:20 | 西南角为坐标原点

门净宽900; 向外开（示意）; 柜前检修; INV前检修净深1000; 左右净距≥500; BAT柜; BAT1—BAT6; INV1; DC箱/母排; BMS专用通信线（与电力分隔敷设）; 北墙立面 1:20 | 层高2800（假设）; BAT1; BAT2; BAT3; BAT4; BAT5; BAT6; 6台EG4 / 271.2 kg; 布置与温控条件; 模块尺寸155×442×490；INV尺寸366×589.5×237。; 已有建筑供暖维持电池10—40℃，额外电加热不计入容量。; 排风需求约171 m³/h；选≥200 m³/h、12W仅为预算。

柜体800×800×1600，承重≥400 kg为初选，非已订购型号。

颜色虚线为路由示意，不代表已实测线长；绕行/上下翻后重算。

图内维护区域保持畅通。机柜实际导轨、承重与厂家散热间距待确认。

夏季通风不足时需降载/制冷，并回算能耗；不得宣称已验证。

机柜重、地板承载、接地连续性及BMS/保护联调待落实。

设备间平面及安装接线图 | 图号 M-02 | 版本 R0
