sunny1043/offgrid-pv-course-design/(commit log)

2026-09-01 feat(docs): 完成 W4 蓄电池设计（深圳）及 Excel 计算文件
    [计算-蓄电池-深圳.xlsx]
2026-09-01 log: 记录 W4 蓄电池设计进度
2026-09-01 fix(docs): 按独立评审修正 W4 校核表公式与 3d 敏感性算术
    [计算-蓄电池-深圳.xlsx]
2026-09-01 log: 记录 W4 评审修正
2026-09-01 fix(docs): 补充 W4 计算文件缓存值说明与控制器限流回填项
2026-09-01 log: 记录 W4 评审复检 Ready 与缓存值说明
2026-09-01 feat(docs): 完成W5光伏阵列设计(2.40kWp 4串1并)并回填W4充电电流42.4A
    [计算-光伏阵列-深圳.xlsx]
2026-09-01 log: 记录W5光伏阵列设计进度与提交hash
2026-09-01 fix(xlsx): 修复W5光伏阵列计算文件XML转义错误与乱码标签
    [计算-光伏阵列-深圳.xlsx]
2026-09-01 log: 回填W5计算文件修复提交hash
2026-09-01 feat(docs): 完成W6控制器与逆变器选型(Growatt SPF 5000 ES)并回填W3-W5、修复蓄电池计算文件公式引用
    [计算-光伏阵列-深圳.xlsx, 计算-蓄电池-深圳.xlsx]
2026-09-01 log: 回填W6提交hash
2026-09-02 新增差异化城市设计：拉萨 / 兰州 / 哈尔滨（独立文件夹，NASA POWER 5 年数据 + Liu-Jordan）
    [计算-光伏阵列-兰州.xlsx, 计算-光伏阵列-哈尔滨.xlsx, 计算-光伏阵列-拉萨.xlsx, 计算-蓄电池-兰州.xlsx, 计算-蓄电池-哈尔滨.xlsx, 计算-蓄电池-拉萨.xlsx]
2026-09-02 log: 补记差异化城市设计提交进度与质量校验结果
2026-09-03 feat(docs): 完成 W7 线缆、保护、防雷与接地设计（深圳）及计算文件
    [计算-线缆保护-深圳.xlsx]
2026-09-03 log: 记录 W7 线缆保护进度（2026-09-03）
2026-09-03 feat(docs): 完成 W8 光伏支架、屋面与设备间布置（深圳）及计算文件
    [计算-支架-深圳.xlsx]
2026-09-03 log: 记录 W8 支架布置进度
2026-09-03 feat(drawings): 完成 W9 三张 A3 图纸（深圳，SVG+PDF+PNG）
2026-09-03 log: 记录 W9 图纸进度
2026-09-03 chore(drawings): 统一文本换行符为 LF（与本地 git blob 对齐）
2026-09-03 log: 回填W7-W9实际提交hash并核对数据一致性
2026-09-03 log: 记录 W11 完成
2026-09-03 log: 进度更新（W11 完成，全材料审查进行中）
2026-09-03 feat(docs): 上传 W11 设备清单与成本分析
2026-09-03 feat(docs): 上传 W11 Excel 计算文件
    [计算-设备清单-深圳.xlsx]
2026-09-03 feat(drawings): 完成差异化三城 W7/W8/W9（拉萨/兰州/哈尔滨）
    - W7 线缆保护防雷接地：3 城 md + 3 Excel（拉萨 16mm²+63A/SPD≥345V、兰州 16mm²+80A/8度抗震/SPD≥420V、哈尔滨双机成对/2×160A/SPD≥360V；三城新增采暖插座回路 C6c 10A/2.5mm²）
    - W8 支架设备间布置：3 城 md + 3 Excel（竖排校核修正 g=0.066kN/m；拉萨 σ=5.6/f=0.21/D=5.09m、兰州 9.9/0.36/5.98、哈尔滨 19.2/0.61/10.88 东西向单排；哈尔滨含雪载组合）
    - W9 三张 A3 图纸：9 张 SVG（参数化生成器）+ PDF + PNG（Chrome headless 渲染）；T1-01 主接线差异化（5/6/5×2 串并、Voc 低温校核、双机成对回路）、T1-02 阵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
    [计算-支架-兰州.xlsx, 计算-支架-哈尔滨.xlsx, 计算-支架-拉萨.xlsx, 计算-线缆保护-兰州.xlsx, 计算-线缆保护-哈尔滨.xlsx, 计算-线缆保护-拉萨.xlsx]
2026-09-03 fix(docs): 统一拉萨 W8 排间节距 D=5.09m（与 Excel/图纸一致，5.07 为中间取整误差）
2026-09-03 feat(docs): 深圳主线回填收尾（回路长度/低压切断/BMS/方案B规格/支架型号）
2026-09-03 log: 记录深圳回填收尾并修复 PROGRESS 冲突标记
2026-09-03 fix(docs): 清理 PROJECT_LOG 残留合并冲突标记
2026-09-03 feat(docs): 完善三城蓄电池设计文档至D5交付标准(兰州/哈尔滨扩容至深圳同级、拉萨微调)
2026-09-03 log: 回填三城蓄电池文档完善提交hash
2026-09-03 feat(docs): 完善兰州/哈尔滨D3材料(负荷调查+太阳能资源)至深圳/拉萨同级详细度
2026-09-03 log: 回填兰州哈尔滨D3材料完善提交hash
2026-09-03 fix(drawings): 三城 W9 图纸按 IEC 60617/GB 规范重画并修复 A3/全幅渲染
    - 参考 GitHub powston/electrical-symbols（IEC 60617/AS 60617）符号与线型规范，重写 gen_drawings_v2.py 重画拉萨/兰州/哈尔滨 T1-01/02/03 共 9 张
    - 修复渲染管线根因：SVG 由 wrapper HTML 转 A3 横版 PDF（1191x842）+ 全幅 PNG（3176x2246），消除旧版画面仅占左上角/大量空白问题
    - 修复页眉城市未切换 bug（哈尔滨图误标拉萨）；T1-02 支架说明按城市差异化（风/雪/抗震）
    - 验证：pymupdf 9 张全部 0 文字重叠/0 越界；PNG 全幅；A3 横版 9/9
2026-09-04 feat(docs): 汇总拉萨 D1-D5 课程设计成果
2026-09-04 log: 记录拉萨 D1-D5 汇总进度
2026-09-04 feat(lanzhou): 同步兰州 D1-D5 正式成果并回填 W7-W9 状态
    [兰州-24h运行表.xlsx, 兰州-负荷表.xlsx, 兰州-资源数据.xlsx]
2026-09-04 log: 记录兰州 D1-D5 同步提交并回填进度 hash
2026-09-06 fix(docs): 修正哈尔滨电池侧放电电流口径(238.9A->119.5A按系统负荷,母线160A级)
2026-09-06 log: 回填哈尔滨放电电流口径修正提交hash
2026-09-06 feat(docs): 完成 W12 深圳设计报告(14章 Word+PDF)与数据一致性复核
2026-09-06 log: 记录 W12 深圳报告与一致性复核进度
2026-09-06 feat(docs): 完成深圳 W13 答辩准备与最终提交自查
2026-09-06 log: 记录深圳 W13 答辩自查进度
2026-09-06 feat(docs): 完成拉萨 W11 成本/W12 报告(14章 Word+PDF)/W13 答辩自查
    [计算-设备清单-拉萨.xlsx]
2026-09-06 log: 记录拉萨 W11-W13 进度
2026-09-06 log: 补记被合并覆盖的D-coccus记录(哈尔滨放电电流口径修正/三城蓄电池D5/兰州哈尔滨D3材料)
2026-09-06 feat(docs): 兰州 D1-D5 计算书/按指导书执行版/公式汇总（EG4+Deye 新选型）
2026-09-07 feat(docs): 完成哈尔滨W11-W13(设备清单成本/14章报告+Word+PDF/一致性复核/答辩自查)
    [计算-设备清单-哈尔滨.xlsx]
2026-09-07 log: 回填哈尔滨W11-W13提交hash
2026-09-07 fix(docs): 修复拉萨计算文件#NAME?与报告支架σ/f，新增指导书表格式填写
    [计算-光伏阵列-拉萨.xlsx, 计算-蓄电池-拉萨.xlsx]
2026-09-07 log: 记录拉萨提交包修复与指导书填写
2026-09-07 fix(docs): 对照深圳复核哈尔滨数据,统一Vmp 51.92/Voc 59.80/R 3.81精度
2026-09-07 log: 回填哈尔滨数据复核修正提交hash
2026-09-08 fix(drawings): 重绘拉萨三张 A3 图纸（修复接线与文字压线）
2026-09-08 log: 记录拉萨图纸重绘进度
2026-09-08 feat(docs): 生成拉萨完整设计案例（参考案例结构+拉萨数据填充）
2026-09-08 log: 记录拉萨完整设计案例进度
2026-09-10 docs: 归档9月10日四城图纸及兰州设计讲解并记录待审问题
    [E-01-系统电气原理与接线图-R0.dxf, M-01-屋顶方阵及支架布置图-R0.dxf, M-02-设备间平面及安装接线图-R0.dxf, 哈尔滨-T1-01-系统电气主接线图-R1.dxf, 哈尔滨-T1-02-光伏阵列及支架布置图-R1.dxf, 哈尔滨-T1-03-设备间平面及安装接线图-R1.dxf, 拉萨-T1-01-系统电气主接线图-R1.dxf, 拉萨-T1-02-光伏阵列及支架布置图-R1.dxf]
